ndhuy1127/ppg-ecg-blood-pressure/data/README.md

# Dữ liệu

Repository không lưu dữ liệu ECG/PPG thật. Dữ liệu raw, interim và processed
phải nằm ngoài Git, trong vùng lưu trữ đã được nhóm phê duyệt.

Tên bản ghi nghiên cứu phải liên kết qua **subject_id**, **session_id** và
**event_id**, không chứa thông tin định danh. Chỉ mẫu nhỏ đã ẩn danh được phép
đặt trong **sample/**. Xem [chính sách dữ liệu](../docs/DATA_POLICY.md).
