ndhuy1127/ppg-ecg-blood-pressure/reports/weekly/week_05/README.md

# Báo cáo tiến độ Tuần 5

> **Giai đoạn:** Tuần 5 / 28 tuần (2026-10-20 → 2026-10-24; các cập nhật tới
> 2026-10-28 ở cuối mục 3)
>
> **Thành viên:** Linh, Trương Đức Anh, Nguyễn Đức Huy

## 1. Tóm tắt công việc của tuần (mục tiêu)

Theo [kế hoạch Tuần 5](../../../docs/plans/WEEK_05.md), tuần này khắc phục G1 và
kéo các việc nằm trên đường găng của giai đoạn thu dữ liệu lên trước:

1. Đóng phần mềm G1: chạy B0/B3 trên raw PulseDB, đánh giá bằng bootstrap theo người.
2. Gỡ nút thắt phần cứng: danh sách mua module V1-module, pin map chuẩn, ERC/DRC,
   firmware khung.
3. Logger phía máy tính và mô phỏng packet đủ trường (kéo từ Tuần 8).
4. Hồ sơ đạo đức (kéo từ Tuần 6); phân bổ tay/điện cực và nghiệm pháp tạo ΔBP
   (kéo từ Tuần 10).
5. Phương pháp mốc R/foot thứ hai, định nghĩa PAT hợp lệ, so với đánh dấu tay.
6. Phác thảo ba kịch bản bài báo P A/P B/P C.

Không đo trên người trong tuần này.

## 2. Thành viên phụ trách và phân công công việc

| Thành viên | Công việc Tuần 5 |
| --- | --- |
| Linh | Logger packet V0.1 phía máy tính (decoder, kiểm tra, ghi raw, replay); mô phỏng `synthetic-packet-v3`; chuẩn bị chạy B0/B3 trên raw và phương án chọn pool PulseDB |
| Đức Anh | Danh sách mua module V1-module |
| Phần cứng và firmware | Firmware khung; pin map chuẩn theo KiCad; phân bổ điện cực; chốt các điểm mở của packet schema và review logger theo spec; trình tự bring-up; sơ đồ khối V1 |
| Huy | Trạng thái G1; hồ sơ đạo đức; protocol v0.2 (phân bổ tay, nghiệm pháp, tiêu chí pilot); mốc R/foot thứ hai, PAT hợp lệ, công cụ so với đánh dấu tay; kịch bản bài báo |

## 3. Tóm tắt công việc đã hoàn thành của từng người

### Linh

- **Codec packet V0.1** (`packet_wire.py`): CRC-16/CCITT-FALSE, đóng gói,
  `StreamDecoder` dò `SYNC` theo luồng; CRC sai hoặc header vô lý thì bỏ 1 byte và
  dò tiếp, không nhảy theo độ dài khai báo.
- **Kiểm tra packet** (`packet_receiver.py`) theo từng phiên/kênh: mất, trùng, xung
  đột, đảo thứ tự; mở rộng `SEQ`/`FIRST_SAMPLE_INDEX` qua 2³²; index liên tục đối
  chiếu `STATUS`; `T_ANCHOR_US` kiểm hai chiều với dung sai tốc độ ±3%; đổi
  `SESSION_ID` là phiên mới; `chain_id` tăng khi neo lại hoặc đổi Fs.
- **Logger** (`packet_logger.py`): `record` ghi raw bằng exclusive-create, ghi `t_rx`
  ra file riêng, decode trực tiếp rồi decode lại từ raw trên đĩa; ghi
  `session_manifest.json` sau cùng kèm hash; `replay --expect` so hash với manifest.
- **Mô phỏng `synthetic-packet-v3`**: luồng byte đúng schema (SYNC, VERSION,
  CHANNEL_ID, SESSION_ID, SEQ, FIRST_SAMPLE_INDEX, T_ANCHOR_US, FS_NOMINAL_MHZ,
  SAMPLE_COUNT ≤ 32, STATUS, DATA int32, CRC16), 13 case lỗi, packet sự kiện `0xC1`;
  v2 giữ nguyên.
- Bảng đối chiếu schema (mục 14.1) trong Packet Schema V0.1.
- Soạn hai phương án chọn pool PulseDB và các bước chạy B0/B3 khi có file raw.

### Đức Anh

- Lập danh sách mua V1-module: ESP32-S3-DevKitC-1 N16R8, MAX30001, BMI270, điện cực
  3M Red Dot 2228, điện cực khô BIOPAC, FSR 402, kèm phương án thay thế và link.

### Huy

- **Trạng thái G1** có ngày và bằng chứng (mục 5.1).
- **Hồ sơ đạo đức v0.1** (5 file): phiếu thông tin, phiếu đồng thuận, tiêu chuẩn
  chọn/loại L1–L10 và phiếu sàng lọc, an toàn buổi đo và quy tắc dừng, kế hoạch
  quản lý và giả danh hóa dữ liệu. Sửa mâu thuẫn trong khung v0.1 (nối USB với
  laptop chạy pin, không có đường nối người tham gia với điện lưới).
- **Protocol v0.2:** phân bổ tay phương án A; kiểm tra xung đột K1–K6;
  nghiệm pháp M0–M4 kèm nguồn; tiêu chí biên độ ΔBP pilot P1–P4; xác nhận module PPG
  MAX30101 (SparkFun SEN-16474).
- **Mốc thứ hai:** R bằng `derivative_energy`; foot bằng `d2_max` và `valley_min`,
  nội suy parabol dưới một mẫu có kiểm chiều cong; chọn qua `SignalConfig`, output
  mặc định `features-sqi-v1` không đổi.
- **PAT hợp lệ** (`pat_validity.py`): ghép R–foot trong khoảng R–R rồi gắn nhãn;
  giới hạn 80–400 ms, outlier MAD k = 3, sàn 10 ms, tối thiểu 3 cặp; không dùng BP;
  nhịp không hợp lệ được gắn nhãn, không xóa.
- **So với đánh dấu tay** (`fiducial_agreement.py`, `week05_fiducials.py`): các lệnh
  synth/export/plot/annotate/detect/compare, ghép một–một tối ưu, mọi lệnh ghi
  provenance, `compare` chỉ chạy với đúng config của `detect`, chặn split test, không
  tự sinh nhãn tay; mẫu CSV đánh dấu tay.
- **Kịch bản bài báo P A/P B/P C**: điều kiện kích hoạt, thông điệp chính, RQ trả lời
  được, bảng/hình chính.

### Phần cứng và firmware

- **Danh sách mua dạng Markdown** thay file Excel: đợt 1 gồm MAX30001 (breakout
  ProtoCentral), MAX30101 (SparkFun SEN-16474), BMI270 (SparkFun SEN-22397),
  ESP32-S3 DevKitC, điện cực 3M 2228; đợt 2 là linh kiện hàn cùng PCB V1; mục kiểm
  tra khi nhận hàng. Bỏ FSR 402 (V1 không dùng FSR), điện cực khô BIOPAC để đợt sau.
- **KiCad V1-module:** bỏ FSR, dùng box header có khóa ở bo cổ tay, thêm R9–R11 và C9.
- **Pin map chuẩn:** bảng A.7 trong `custom_board_proposal.md` lấy từ KiCad V1-module
  và thay các bảng chân cũ; A.6 ghi trạng thái từng mục.
- **Phân bổ điện cực:** 3 điện cực, LA cổ tay trái và RA cổ tay phải (mặt lòng), RL
  cẳng tay trái; LA → ECGP, RA → ECGN, RL → VCM qua R3; tắt lead bias nội. Cập nhật
  protocol v0.2 mục 5.2 và hồ sơ đạo đức theo cách đặt này.
- **Firmware khung** (ESP32-S3, PlatformIO + ESP-IDF 5.5.3): gửi packet V0.1 qua USB
  Serial/JTAG từ nguồn AFE giả; `SEQ` gán lúc gửi; hàng đợi MCU đầy thì packet bị bỏ
  trước khi có `SEQ` và packet kế của kênh bật bit 1 của `STATUS` (bit 1 chuyển tiếp
  nếu firmware gửi chính packet đó thất bại; từ 2026-10-23 chuyển cả bit 0); packet sự kiện `0xC1` từ nút t0; tự kiểm
  known-answer khi khởi động. Chưa có driver AFE thật, chưa chạy trên bo.
- **Test tương thích firmware–logger:** known-answer 50 byte trong header C khớp
  codec Python; encoder C biên dịch trên máy tính cho cùng byte với codec Python
  trên packet ngẫu nhiên (`test_firmware_c_encoder.py`, cần trình biên dịch C);
  luồng dựng theo quy ước firmware trong 10 phút đi qua `analyze_stream` của logger
  với đúng số lỗi chờ đợi. Các test này không chạy code ISR/task của firmware.
- **Chốt packet schema V0.1** (2026-10-23): giữ `VERSION = 0x01` và tên
  `FS_NOMINAL_MHZ`; định nghĩa lại mốc SAMP/INT2B của MAX30001 (cạnh xung đánh dấu
  lúc mẫu vào FIFO, không phải lúc lấy mẫu analog; ghi chú ADI cho MAX30003 đo trễ
  20,839 ms khi bỏ DLPF hoặc 32,558 ms khi DLPF 40 Hz ở 512 sps, chưa kiểm trên
  MAX30001); trả lời D1–D10 và xác nhận R1–R6 trong review logger.
- **Trình tự bring-up V1-module** thay file Word: kiểm khi nhận hàng, DevKitC đứng
  riêng, PCB trần, sửa module, hàn lắp, MAX30001, bo cổ tay, đo 10 phút.
- **Sơ đồ khối V1** (SVG) thay `Hardware_Diagram.png`.

### Cập nhật ngày 2026-10-24

**Dữ liệu và phần mềm**

- **Chốt pool PulseDB:** `VitalDB_Train_Subset.mat`, lấy mẫu con 400 người chỉ theo
  trường `Subject` (seed 20261024), để chia train/val/test;
  `VitalDB_CalFree_Test_Subset.mat` làm tập kiểm tra ngoài; không dùng CalBased Test
  (cùng người với Train) và hai subset AAMI (test của AAMI Cal đã bị chấm trong
  notebook Tuần 3–4). Pin `h5py==3.16.0` để đọc từng phần file `.mat` v7.3; reader
  đọc từng phần chưa viết, B0/B3 chưa chạy trên raw.
- **Quy tắc QC nhãn**, khóa trước khi đọc nhãn: chỉ loại dòng DBP ≥ SBP, ở mọi split,
  tại bước mô hình (config mới `b3-pipeline-v1`, mới có kế hoạch; `b3-pipeline-v0`
  giữ hành vi cũ).
- `features-sqi-v2` ghi `None` kèm lý do khi chưa ghép được PAT; split v2 từ chối khi
  ECG/PPG trùng giữa các split hoặc sai thứ tự kênh; bootstrap theo người gắn
  `few_subjects` khi dưới 10 người (vẫn tính CI) và API mặc định chỉ chấm val; CI cho
  hiệu ghép cặp và cho B3 − B0 trong runner.
- `motion-sqi-v0`: cờ cử động mạnh từ IMU ở cổ tay đeo PPG (định nghĩa chốt, ngưỡng
  0,15 g / 20 °/s chưa khóa; protocol v0.2).
- Gỡ hai CSV nhãn/MAE test của pool AAMI Cal khỏi Git (lấy lại được từ lịch sử Git).

**Phần cứng**

- Bỏ bản V0 nối dây, đi thẳng PCB V1-module; MCU chốt ESP32-S3-DevKitC-1-N8R8 chính
  hãng; bỏ các dòng mua chỉ dùng cho bản nối dây.
- Lấy mẫu chốt: ECG 512 sps (`EFIT = 15`, đọc FIFO tới EOF); PPG MAX30101 ba khe
  (xanh, đỏ, IR) 200 sps mỗi khe, `SMP_AVE = 1`, đọc khi FIFO có 8 mẫu và đọc hết;
  giữ VLED 5,1 V (đo ở bring-up). Độ rộng xung LED (411 hay 215 µs) còn mở.
- KiCad V1-draft4: thứ tự chân cáp mới có GND xen giữa các đường tín hiệu, header J3
  cho xung kích thích (GPIO6), bỏ TP7–TP10, không thêm điện trở kéo I²C, giữ C2/C3 ở
  bo cổ tay. ERC/DRC chỉ còn cảnh báo thư viện như trước khi sửa. Đặt gia công PCB
  ngay sau ERC/DRC.
- Bật xung `SAMP` của MAX30001 luôn và dùng làm mốc thời gian ECG (mục 5.8).

**Packet, logger và firmware**

- **Packet Schema V0.2** (`VERSION = 0x02`): IMU BMI270 sáu trục `0xA1`–`0xA6` ở
  100 Hz, phần tồn đọng (bit 7), FIFO đầy rồi neo lại (bit 5), packet thông tin thiết
  bị `0xD1`, mốc `SAMP` cho ECG (bit 8).
- **Logger** đọc V0.1 và V0.2, ghi được thẳng từ cổng serial (`--port`, pyserial 3.5),
  kiểm mốc ECG theo nguồn mốc (mục 5.8), ghi manifest theo từng phiên khi một raw có
  nhiều lần khởi động lại.
- **Firmware khung gửi V0.2:** packet `0xD1` mỗi 10 s; IMU giả có chia phần tồn đọng
  và neo lại sau FIFO đầy; mốc `SAMP` với xung giả; PPG đọc khi FIFO có 8 mẫu. MCPWM
  capture thật đã viết nhưng tắt và chưa chạy trên chip. Ngoài bản thường có ba bản
  build cố ý tạo lỗi để kiểm khi có bo: dừng đọc IMU, lỗi xung `SAMP`, đọc PPG trễ.
  Vẫn chưa có driver AFE thật và chưa chạy trên bo. (Cập nhật 2026-10-25: driver
  MAX30001, MAX30101, BMI270 và kênh nhiệt độ `0xB1` đã viết, test trên máy tính,
  chưa chạy trên chip; xem mục 7.)

### Cập nhật ngày 2026-10-25

**PulseDB và baseline G1**

- **Tải PulseDB** (Kaggle version 4, cập nhật 2022-12-08) bằng Kaggle API: Train,
  CalFree Test, AAMI Test, `LICENSE.txt`, lưu ngoài Git. Kích thước và SHA-256 ở
  [provenance](../../../docs/pulsedb_provenance.md) mục 4. CalFree chưa được dùng.
- **Reader `h5py` đọc từng phần** (`software/pulsedb/h5_reader.py`): đọc ô `Subject`
  riêng, rồi chỉ các dòng cần, từng khối tối đa 4.096 dòng, nên pool 14 GB không
  phải nằm trọn trong RAM. Máy làm việc chỉ còn khoảng 2,5 GB RAM trống. So với
  reader `mat73` trên AAMI Test (666 dòng): 0 sai khác ở cả 11 trường.
- **Split Train 400 người** (`subject_subsample` của builder): pool 465.480 dòng,
  1.293 người, mọi ID đúng dạng `p######_1`; 400 người × 360 đoạn; 320/40/40 người.
  Chạy hai lần cho cùng hash inventory/manifest; thứ tự kênh đạt; không có ECG/PPG
  trùng giữa các split.
- **`b3-pipeline-v1`**: loại dòng DBP ≥ SBP ở train/val (thực tế 0 dòng); trọng số
  train 1/n_s theo người, chuẩn về trung bình 1; v0 giữ nguyên và từ chối split có
  lấy mẫu con. Kết quả trên val ở mục 6.4: **B3 chưa tốt hơn B0**.
- **Phát hiện:** ECG/PPG của PulseDB Subset đã được chuẩn hóa min-max về [0, 1] theo
  từng đoạn, nên mất biên độ. Đặc trưng thống kê đơn giản của B3 vì thế gần như
  không mang thông tin.
- Review hai vòng; các điểm đã sửa: đọc nhãn chỉ của dòng được chọn, lời văn
  về nhãn test, script xuất Tuần 5 dùng reader mới, test bắt được lỗi trọng số và
  lỗi đọc sai dòng, file luôn được đóng.

**Chuẩn bị B4: đánh dấu tay mốc R/foot trên PulseDB**

- **Kế hoạch và ngưỡng chấp nhận chốt trước khi đánh dấu** (Huy;
  [tài liệu mốc](../../../docs/protocol/week05_fiducials_pat_validity.md)
  mục 9; config `fiducials-week05-v2`):
  - chỉ train: 40 người × 2 đoạn, chia sẵn 20 người để chọn phương pháp và 20 người
    để xác nhận một lần; người val không dùng để chọn mốc;
  - foot là điểm cực tiểu ngay trước sườn lên;
  - dung sai R ±24 ms, foot ±48 ms;
  - R: độ nhạy/PPV ≥ 99%, |bias| ≤ 4, MAE ≤ 8, SD ≤ 8 ms; foot: ≥ 98%, |bias| ≤ 8,
    MAE ≤ 16, SD ≤ 16 ms;
  - đánh dấu lặp lại 16 đoạn sau ít nhất 2 ngày.

  Lệnh `gate` mới chỉ kết luận `B4_ALLOWED` khi đạt cả ba điều kiện: chọn được
  phương pháp, xác nhận được phương pháp đó, và độ lặp lại đạt.
- **Đã xuất 80 đoạn** (`main/`) và 16 đoạn lặp lại (`repeat/`), chạy sẵn cả năm
  detector và in hình mù (mục 6.5). Bước đánh dấu tay chưa làm.
- **Cấu hình bộ lọc của PulseDB** (Supplementary Material): ECG Butterworth
  [0,5; 40] Hz, PPG Chebyshev-II [0,5; 8] Hz, chuẩn hóa [0, 1] theo từng đoạn. Vẫn
  chưa biết lọc zero-phase hay causal.
- **Phát hiện: PPG trễ so với ECG.** Khoảng R → foot kế tiếp có trung vị 572 ms,
  trong khi PAT ngón tay lúc nghỉ chỉ khoảng 180–260 ms. Một preprint dẫn lại rằng
  ECG–PPG trong VitalDB lệch khoảng 350 ms (nguồn thứ cấp). Vì vậy PAT PulseDB chỉ
  dùng được như đặc trưng tương đối, và giới hạn 80–400 ms phải xem lại trước khi
  làm B4 ([provenance](../../../docs/pulsedb_provenance.md) mục 6).

### Cập nhật ngày 2026-10-26 → 2026-10-28

**Phần mềm (commit `3111a9e`, 2026-10-26)**

- **B2** (nhân khẩu học cộng HR từ đỉnh R của ECG): định nghĩa, code và test
  SYNTHETIC; chạy theo hai bảng định trước `full` và `hr_available`
  ([định nghĩa B2](../../../docs/protocol/b2_pulsedb_definition.md)). **Chưa chạy trên
  PulseDB:** định nghĩa chưa duyệt, runner từ chối khi config còn ở trạng thái
  `PENDING_APPROVAL_NOT_RUN`.

**Firmware và logger (2026-10-25 → 2026-10-26)**

- **Lệnh PC → thiết bị** (`ping`, `set-ppg-led`) qua `device_command.py` trong lúc
  `record --commands`; packet cấu hình AFE `0xD2` và xác nhận lệnh `0xD3` (Packet
  Schema V0.2 mục 12–13); logger nâng lên `packet-logger-v2`.
- **Sự kiện mã 3:** xung kích thích ở GPIO6 (header J3) cho phép đo đồng bộ 10 phút
  ([kế hoạch đo](../../../hardware/test_reports/sync_10min_test_plan.md)).
- Các phần trên test trên máy tính, chưa chạy trên chip.
- **Ước lượng dòng** có nguồn datasheet
  ([power_budget_v1.md](../../../configs/hardware/power_budget_v1.md)): khoảng 61 mA điển
  hình, kịch bản xấu khoảng 112 mA trung bình và 206 mA trong xung LED; chưa đo.

**Phần cứng (2026-10-27 → 2026-10-28)**

- **MCU đổi sang bo Waveshare ESP32-S3-DEV-KIT-N8R8-M** (module ESP32-S3-WROOM-1-N8R8,
  một cổng USB-C qua hub CH334 và CH343, chân giống DevKitC-1); **đã đặt 2026-10-27**.
- **KiCad V1-draft5:**
  - viền U1 theo bo Waveshare (63,30 × 25,40 mm);
  - breakout MAX30001 dời 0,5 mm sang trái;
  - 3V3 hình sao, nhánh ECG từ U1.1 và nhánh cáp từ U1.2;
  - silkscreen `CHIP SIDE OUT` cho BMI270 ở mặt dưới bo cổ tay.

  ERC 0 lỗi. DRC 0 lỗi, 0 chỗ chưa nối, khớp schematic.
- **Đối chiếu toàn bộ 30 footprint** (2026-10-27):
  - 26 footprint chuẩn giống thư viện KiCad 10;
  - 4 footprint module khớp file Eagle của ProtoCentral và SparkFun và bản vẽ Waveshare, sai số 0 mm;
  - BMI270 ở mặt dưới đúng cho cách lắp mặt chip quay ra ngoài.

  Rà soát độc lập: không có lỗi phải sửa PCB.
- **Gerber và file khoan V1-draft5** xuất ngày 2026-10-27, không lưu trong repo.
  - Đã kiểm: mọi lỗ khoan khớp pad/via; lỗ mạ có đồng hai lớp; pad có lỗ mở mask.
  - Đặt ở CXT thành hai thiết kế riêng, 5 tấm mỗi mạch.
- **Lưu ý lắp ráp** ghi vào [bring-up](../../../hardware/test_reports/v1_bringup_procedure.md)
  và [danh sách mua](../../../hardware/bom/purchase_list_v1_module.md):
  - box header 90° của bo cổ tay phải có khe khóa ở vách xa mặt PCB;
  - hàn header breakout ECG từ mặt dưới;
  - cực LED D1;
  - vít, đai ốc và spacer nylon M2;
  - đo thông mạch xuyên cả hệ trước khi cấp nguồn (bring-up mục 8.1).
- So sánh hai phương án điện cực ECG chuyển từ PDF sang Markdown.

## 4. Danh mục sản phẩm đầu ra và đường dẫn

| STT | Sản phẩm | Người làm | Đường dẫn |
| --- | --- | --- | --- |
| 1 | Codec packet V0.1 | Linh | [packet_wire.py](../../../software/data_io/packet_wire.py) |
| 2 | Kiểm tra packet, metadata phiên | Linh | [packet_receiver.py](../../../software/data_io/packet_receiver.py) |
| 3 | Logger | Linh | [packet_logger.py](../../../scripts/packet_logger.py), [packet_logger.json](../../../configs/hardware/packet_logger.json) |
| 4 | Mô phỏng v3 | Linh | [packet_simulation_v3.py](../../../software/data_io/packet_simulation_v3.py), [packet_simulation_v3.json](../../../configs/hardware/packet_simulation_v3.json), [simulate_packets.py](../../../scripts/simulate_packets.py) |
| 5 | Test logger và đáp án | Linh | [test_packet_logger.py](../../../tests/test_packet_logger.py), [packet_v3_expected.json](../../../tests/fixtures/packet_v3_expected.json) |
| 6 | Hướng dẫn logger và mô phỏng | Linh | [packet_logger.md](../../../docs/protocol/packet_logger.md), [packet_simulation.md](../../../docs/protocol/packet_simulation.md) |
| 7 | Bảng đối chiếu schema (mục 14.1) | Linh | [Packet_Schema_V0.1.md](../../../configs/hardware/Packet_Schema_V0.1.md) |
| 8 | Danh sách mua (Excel) | Đức Anh | [Danh sách mua.xlsx](https://github.com/ndhuy1127/ppg-ecg-blood-pressure/blob/225832dce33c08f1d6c2468dc3b2bf1ac0afe6e1/hardware/bom/Danh%20s%C3%A1ch%20mua.xlsx) (nhánh `dev/ducanh`, commit `225832d`); bản hiện hành ở dòng 19 |
| 9 | Hồ sơ đạo đức v0.1 | Huy | [docs/ethics/](../../../docs/ethics/README.md) |
| 10 | Protocol v0.2 | Huy | [protocol_outline_v0.2.md](../../../docs/protocol/protocol_outline_v0.2.md) |
| 11 | Mốc ứng viên, `detect` | Huy | [fiducials.py](../../../software/signal_processing/fiducials.py) |
| 12 | PAT hợp lệ | Huy | [pat_validity.py](../../../software/signal_processing/pat_validity.py) |
| 13 | So với đánh dấu tay | Huy | [fiducial_agreement.py](../../../software/evaluation/fiducial_agreement.py), [week05_fiducials.py](../../../scripts/week05_fiducials.py), [mẫu CSV](../../../docs/protocol/templates/manual_fiducials_template.csv) |
| 14 | Config Tuần 5 | Huy | [week05_huy.json](../../../configs/data/week05_huy.json) |
| 15 | Tài liệu phương pháp | Huy | [week05_fiducials_pat_validity.md](../../../docs/protocol/week05_fiducials_pat_validity.md) |
| 16 | Test mốc Tuần 5 | Huy | [test_week05_fiducials.py](../../../tests/test_week05_fiducials.py) |
| 17 | Kết quả SYNTHETIC | Huy | [synthetic_fiducials/](synthetic_fiducials/agreement_synthetic.json) (thêm biến thể [refractory_040/](synthetic_fiducials/refractory_040/agreement_synthetic.json)) |
| 18 | Kịch bản bài báo | Huy | [paper_scenarios_v0.1.md](../../../docs/paper_scenarios_v0.1.md) |
| 19 | Danh sách mua V1-module | Phần cứng | [purchase_list_v1_module.md](../../../hardware/bom/purchase_list_v1_module.md) |
| 20 | KiCad V1-module (bo đế, bo cổ tay) | Phần cứng | [hardware/kicad/v1_module/](../../../hardware/kicad/v1_module/) |
| 21 | Pin map chuẩn A.7, trạng thái A.6 | Phần cứng | [custom_board_proposal.md](../../../configs/hardware/custom_board_proposal.md) |
| 22 | Phân bổ điện cực | Phần cứng | [protocol_outline_v0.2.md](../../../docs/protocol/protocol_outline_v0.2.md) mục 5.2 |
| 23 | Firmware khung V1-module | Firmware | [firmware/](../../../firmware/README.md) |
| 24 | Test firmware–logger | Firmware | [test_firmware_packet_kat.py](../../../tests/test_firmware_packet_kat.py), [test_firmware_c_encoder.py](../../../tests/test_firmware_c_encoder.py), [test_firmware_stream_compat.py](../../../tests/test_firmware_stream_compat.py) |
| 25 | Chốt packet schema V0.1, review logger | Firmware | [Packet_Schema_V0.1.md](../../../configs/hardware/Packet_Schema_V0.1.md) mục 2, 5, 6, 9, [packet_logger.md](../../../docs/protocol/packet_logger.md) |
| 26 | Trình tự bring-up V1-module | Phần cứng | [v1_bringup_procedure.md](../../../hardware/test_reports/v1_bringup_procedure.md) |
| 27 | Sơ đồ khối V1 | Phần cứng | [hardware_diagram_v1.svg](../../../configs/hardware/hardware_diagram_v1.svg) |
| 28 | Quyết định pool PulseDB, quy tắc QC nhãn (2026-10-24) | Huy | [pulsedb_provenance.md](../../../docs/pulsedb_provenance.md), [run_b3_pulsedb.md](../../../docs/protocol/run_b3_pulsedb.md) |
| 29 | `motion-sqi-v0` | Huy | [motion_sqi.py](../../../software/feature_extraction/motion_sqi.py), [protocol v0.2](../../../docs/protocol/protocol_outline_v0.2.md) mục 7.3 |
| 30 | Packet Schema V0.2 | Phần cứng và firmware | [Packet_Schema_V0.2.md](../../../configs/hardware/Packet_Schema_V0.2.md) |
| 31 | Logger và mô phỏng V0.2 | Huy | [packet_receiver.py](../../../software/data_io/packet_receiver.py), [packet_simulation_v3_v02.json](../../../configs/hardware/packet_simulation_v3_v02.json), [test_packet_v02.py](../../../tests/test_packet_v02.py) |
| 32 | Firmware V0.2 (encoder, `0xD1`, IMU giả, `SAMP`, PPG) | Firmware | [firmware/](../../../firmware/README.md) |
| 33 | Test firmware V0.2 | Firmware | [test_firmware_imu_plan.py](../../../tests/test_firmware_imu_plan.py), [test_firmware_samp_map.py](../../../tests/test_firmware_samp_map.py), [test_firmware_c_encoder.py](../../../tests/test_firmware_c_encoder.py) |
| 34 | KiCad V1-draft4 | Phần cứng | [hardware/kicad/v1_module/](../../../hardware/kicad/v1_module/), [custom_board_proposal.md](../../../configs/hardware/custom_board_proposal.md) A.2, A.3, A.7 |
| 35 | Reader `h5py` và split Train 400 người (2026-10-25) | Huy | [h5_reader.py](../../../software/pulsedb/h5_reader.py), [run_pulsedb_split.md](../../../docs/protocol/run_pulsedb_split.md), [pulsedb_train400_split.json](../../../configs/data/pulsedb_train400_split.json) |
| 36 | `b3-pipeline-v1` và kết quả B0/B3 trên val (2026-10-25) | Huy | [run_b3_pulsedb.md](../../../docs/protocol/run_b3_pulsedb.md), [b3_pulsedb_v1.json](../../../configs/models/b3_pulsedb_v1.json), [pulsedb_b3_v1/](pulsedb_b3_v1/README.md) |
| 37 | Kế hoạch đánh dấu tay, ngưỡng chấp nhận, lệnh `repeat`/`gate`, `annotate --resume` (2026-10-25) | Huy | [week05_fiducials_pat_validity.md](../../../docs/protocol/week05_fiducials_pat_validity.md) mục 9, [fiducial_gate.py](../../../software/evaluation/fiducial_gate.py), [week05_huy.json](../../../configs/data/week05_huy.json) |
| 38 | B2: định nghĩa, code, test SYNTHETIC; chưa chạy (2026-10-26) | Huy | [b2_pulsedb_definition.md](../../../docs/protocol/b2_pulsedb_definition.md), [b2_pulsedb_v0.json](../../../configs/models/b2_pulsedb_v0.json), [features_b2.py](../../../software/pulsedb/features_b2.py), [pipeline_b2.py](../../../software/pulsedb/pipeline_b2.py), [run_b2_pulsedb.py](../../../scripts/run_b2_pulsedb.py), [test_b2_pipeline.py](../../../tests/test_b2_pipeline.py) |
| 39 | Lệnh PC → thiết bị, packet `0xD2`/`0xD3`, `packet-logger-v2` | Phần cứng và firmware | [device_command.py](../../../scripts/device_command.py), [command_desk.py](../../../software/data_io/command_desk.py), [command_wire.py](../../../software/data_io/command_wire.py), [Packet_Schema_V0.2.md](../../../configs/hardware/Packet_Schema_V0.2.md) mục 12–13 |
| 40 | Sự kiện mã 3 và kế hoạch đo đồng bộ 10 phút | Firmware | [stim_plan.c](../../../firmware/app/stim_plan.c), [sync_10min_test_plan.md](../../../hardware/test_reports/sync_10min_test_plan.md) |
| 41 | Ước lượng dòng V1-module | Phần cứng | [power_budget_v1.md](../../../configs/hardware/power_budget_v1.md) |
| 42 | KiCad V1-draft5 và đối chiếu footprint với file CAD và bản vẽ của nhà sản xuất (2026-10-27) | Phần cứng | [hardware/kicad/v1_module/](../../../hardware/kicad/v1_module/), [custom_board_proposal.md](../../../configs/hardware/custom_board_proposal.md) A.2, A.3 |
| 43 | Danh sách mua và bring-up cập nhật theo bo Waveshare và lưu ý lắp ráp (2026-10-27) | Phần cứng | [purchase_list_v1_module.md](../../../hardware/bom/purchase_list_v1_module.md), [v1_bringup_procedure.md](../../../hardware/test_reports/v1_bringup_procedure.md) |
| 44 | So sánh hai phương án điện cực ECG (Markdown) | Phần cứng | [Hai_phuong_an_dien_cuc_ECG.md](../../../hardware/Hai_phuong_an_dien_cuc_ECG.md) |

## 5. Tóm tắt các nội dung chuyên môn chính

### 5.1. Trạng thái G1 (đánh giá ngày 2026-10-21, cập nhật 2026-10-28)

| Hạng mục | Trạng thái | Bằng chứng |
| --- | --- | --- |
| Pipeline tái lập (reader, inventory, provenance) | Có | `reader.py`, `split_manifest.py` (split v2), hash không phụ thuộc CRLF |
| Split theo người có test rò rỉ | Có | `pulsedb-split-v2`, `tests/test_split_manifest.py` |
| Baseline đầu tiên | Có (val) | B0/B3 `b3-pipeline-v1` trên PulseDB Train 400 người, val 40 người, CI bootstrap theo người (mục 6.4); B1 chưa chạy (không có chronology); test và CalFree chưa chấm |
| Đặc trưng/SQI/bootstrap | Có (SYNTHETIC) | `features-sqi-v1`, `subject_bootstrap.py`, mốc thứ hai Tuần 5 |
| PPG–ECG đồng bộ, báo cáo phần cứng v0 | Chưa đạt | Có KiCad V1-draft5 qua ERC/DRC, footprint đã đối chiếu với file CAD và bản vẽ của nhà sản xuất, pin map A.7, trình tự bring-up, kế hoạch đo 10 phút, firmware khung gửi Packet Schema V0.2 build được và logger đọc được. Bo Waveshare đã đặt, PCB đang đặt (2026-10-28); chưa có module trong tay, chưa chạy firmware trên bo, chưa có bản ghi trên phần cứng |
| Hồ sơ đạo đức | Bản nháp v0.1 | `docs/ethics/` |

G1 phần mềm đạt phần baseline trên val (2026-10-25); G1 phần cứng chưa đạt.

### 5.2. Logger và packet V0.1 (Linh)

- Packet little-endian dài 42 + 4N byte; CRC-16/CCITT-FALSE (known-answer
  `"123456789"` → `0x29B1`).
- Quy tắc logger R1–R5: `0xC1` bỏ kiểm index/timestamp nhưng vẫn kiểm `SEQ`/CRC; bit
  0/1/5 của `STATUS` giải thích nhảy index; kiểm `VERSION` trước CRC; `SAMPLE_COUNT = 0`
  là vô lý; dung sai timestamp 1 chu kỳ + 500 µs cộng dung sai tốc độ ±3%.
- Không nội suy, không ghép ECG–PPG theo index, không dịch kênh; offset giữa kênh
  không phải PAT.
- 13 case mô phỏng: `valid`, `missing`, `duplicate`, `reordered`, `timestamp`,
  `timestamp_first`, `offset`, `crc`, `byte_loss`, `index_jump`, `reanchor`,
  `version`, `session_restart`.

### 5.3. Phương án chọn pool PulseDB (Linh)

| | A (nối tiếp lịch sử) | B (pool lớn) |
| --- | --- | --- |
| Pool chia train/val/test | `VitalDB_AAMI_Cal_Subset.mat` (116 người) | `VitalDB_Train_Subset.mat` (1 293 người) |
| Không dùng vì trùng người | `VitalDB_AAMI_Test_Subset.mat` | `VitalDB_CalBased_Test_Subset.mat` |
| Held-out ngoài | `VitalDB_CalFree_Test_Subset.mat` (144 người) | `VitalDB_CalFree_Test_Subset.mat` |
| Số người theo split (seed 72) | 92/11/13 | — |

**Chốt 2026-10-24 (Huy): phương án B**, lấy mẫu con 400 người của Train (khoảng
320/40/40 người theo 0,8/0,1/0,1), CalFree Test làm tập kiểm tra ngoài. Lý do: test
của AAMI Cal đã bị chấm trong notebook Tuần 3–4, Train chưa bị chạm; 400 người vừa
RAM máy làm việc khi đọc từng phần ([pulsedb_provenance.md](../../../docs/pulsedb_provenance.md)).

### 5.4. Phân bổ tay và nghiệm pháp (Huy)

- **Phương án A:** PPG cổ tay trái, cuff bắp tay phải, ECG đạo trình I với điện cực
  dán Ag/AgCl ở mặt lòng hai cổ tay (LA trái, RA phải) và RL ở cẳng tay trái (cập
  nhật 2026-10-23, protocol v0.2 mục 5.2).
- Kiểm tra xung đột: K1 (cuff khác tay PPG) đạt; K2 (không làm chuyển động tay PPG)
  đạt trên giấy cho M0–M2; K3 loại nghiệm pháp bóp tay tĩnh vì đạo trình I có điện
  cực ở cả hai tay.
- **Nghiệm pháp:** M0 nghỉ; M1 thở chậm (giảm BP, Adler 2019); M2 tính nhẩm (tăng,
  Carroll 2012, Jern 1991); M3 ngâm chân nước lạnh (tăng SBP/DBP, Korhonen 2006,
  Velasco 1997); M4 đạp xe ngồi (tăng khi gắng sức, Stergiou 2023). 9/9 DOI đã đối
  chiếu metadata qua OpenAlex/Europe PMC.
- Tiêu chí biên độ ΔBP pilot P1–P4, ngưỡng 15 mmHg lấy từ kế hoạch 28 tuần.

### 5.5. Mốc thứ hai và PAT hợp lệ (Huy)

- `derivative_energy`: đạo hàm bình phương, trung bình trượt, dời về cực đại tín
  hiệu (không phải Pan–Tompkins).
- `d2_max`: cực đại đạo hàm bậc hai trước sườn lên; `valley_min`: cực tiểu trước
  peak. Nội suy parabol dưới một mẫu là tùy chọn, mặc định tắt từ 2026-10-25.
- PAT ngoài 80–400 ms vẫn được ghép rồi gắn nhãn `out_of_range`; `r_status` là
  `paired`/`no_foot`/`ambiguous`/`edge` (từ `pat-validity-v1`, 2026-10-23: R sát
  biên cửa sổ mà foot nằm ngoài khoảng PPG phát hiện được là `edge`, không tính là
  R không ghép, như `features-sqi-v1`).
- Dung sai so khớp với đánh dấu tay chốt trước khi đánh dấu: R 24 ms, foot 48 ms
  (2026-10-25; trước đó 50/100 ms), cùng các ngưỡng chấp nhận ở tài liệu mốc mục 9.

### 5.6. Kịch bản bài báo (Huy)

Ba kịch bản P A/P B/P C kích hoạt theo G4/R2/R3/R5 của kế hoạch 28 tuần; mỗi kịch
bản có thông điệp chính, RQ trả lời được, bảng/hình chính và phần bỏ.

### 5.7. Phần cứng và firmware

- Pin map A.7: ECG SPI GPIO7/15/16/17, INTB GPIO21, INT2B GPIO47; PPG I²C GPIO8/9,
  INT GPIO18; BMI270 SPI GPIO10–13, INT1 GPIO14; nút t0 GPIO4; LED GPIO5. GPIO47 chạy
  3,3 V trên module WROOM-1 N8R8/N16R8 (chip R16V chạy 1,8 V); kiểm ký hiệu module
  và eFuse VDD_SPI trước khi dùng (bring-up mục 1, 2).
- Packet đi qua cổng USB Serial/JTAG gốc của ESP32-S3; log chữ đi riêng qua UART0
  để không lẫn vào luồng byte của logger.
- Mốc SAMP/INT2B của MAX30001 là lúc mẫu vào FIFO, không phải lúc lấy mẫu analog;
  phân tích offline trừ độ trễ hiệu dụng `L_us` đo ở phép đo đồng bộ 10 phút trên PCB V1, không dùng thẳng bảng
  datasheet (Packet Schema mục 5.2, 5.3). Từ 2026-10-24 `SAMP` bật luôn và làm mốc
  ECG (mục 5.8).
- Firmware chỉ phát dữ liệu giả, nên mọi kết quả hiện có chỉ kiểm đường packet
  MCU → USB → logger, không nói gì về chất lượng tín hiệu ECG/PPG.

### 5.8. Packet Schema V0.2 và mốc `SAMP` (2026-10-24)

- **Bit 8 (chỉ ECG):** `T_ANCHOR_US` là thời điểm cạnh `SAMP` của mẫu cuối packet,
  chốt bằng MCPWM capture; bit 8 = 0 là mốc đọc FIFO như V0.1. Firmware chỉ bật bit 8
  khi mọi cạnh từ mẫu cuối packet trước tới mẫu cuối packet này đều có, cách nhau
  1 953,125 µs ± 22 µs (tạm), và cạnh cuối tới trong hai chu kỳ sau lúc đọc FIFO. Lỗi
  thì dùng mốc đọc FIFO, sau 1 s khởi động lại ánh xạ (tối đa 1 lần mỗi 10 s; chỉ số
  mẫu về 0, bit 5).
- **Logger** kiểm hai nguồn mốc riêng, không bao giờ so chéo (chúng lệch nhau một
  khoảng chưa biết): mốc `SAMP` dung sai 200 µs, tốc độ ECG ±1 000 ppm (giá trị tạm,
  chỉnh sau bring-up), để lệch một mẫu (1,953 ms) bị bắt. Phép kiểm qua từ 398 mẫu
  (khoảng 0,78 s) không còn phân biệt được lệch một mẫu nên được báo
  `anchor_check_weak`. Lệch cố định một mẫu ngay từ đầu phiên logger không bắt được;
  chỉ phép đo kích thích 10 phút bắt được.
- **Độ trễ:** `L_ECG,SAMP` (từ lúc lấy mẫu analog tới cạnh `SAMP`) khác `L_ECG` của
  mốc đọc FIFO; metadata ghi riêng, PAT trừ đúng độ trễ của nguồn mốc.
- **PPG** vẫn dùng mốc đọc FIFO ở 200 sps, nên sai số thời gian phía PPG vẫn là phần
  đóng góp chính vào sai số PAT.

## 6. Kết quả kiểm tra kỹ thuật

### 6.1. Kiểm tra toàn repo

Chạy từ Git root bằng `.venv` (Python 3.13.12):

| Lệnh | Kết quả |
| --- | --- |
| `python -m pytest -q -p no:cacheprovider` (phần Huy, 2026-10-22) | **379 passed** (gồm 50 test Tuần 5 của Huy) |
| `python -B -m pytest -q -p no:cacheprovider` (phần Linh, 2026-10-22) | **416 passed** (gồm test `test_packet_logger.py`; test v2 không đổi) |
| `python -m pytest -q -p no:cacheprovider` (toàn repo, 2026-10-23) | **471 passed** (gồm test known-answer và tương thích firmware–logger) |
| `pio run -d firmware` (2026-10-23) | Build đạt, RAM 4,5 %, flash 19,8 % của phân vùng 1 MB; chưa nạp lên bo |
| `python -m pytest -q -p no:cacheprovider` (toàn repo, Python 3.11 có trình biên dịch C, 2026-10-25) | **666 passed** (gồm test C của encoder, `imu_plan`, `samp_map`); `.venv` Python 3.13 không có trình biên dịch C: 622 passed, 44 skipped |
| `python -m pytest -q -p no:cacheprovider` (toàn repo, môi trường pin Python 3.11.7 không có trình biên dịch C, 2026-10-25 sau PulseDB v1) | **680 passed, 44 skipped** (44 test C cần trình biên dịch) |
| `pio run -d firmware -j 1`, bốn env (2026-10-24) | Build đạt, không cảnh báo; RAM 4,9 %, flash 20,4–20,5 %; build song song có lúc GCC lỗi nội bộ do thiếu RAM trống, build tuần tự thì qua |
| CI trên PR #25 (2026-10-24, commit `ede2629`) | Đạt (ruff và pytest, Python 3.11) |
| `python -m ruff check .` | Đạt |
| `python -m ruff check --select E501` trên file `.py` mới | Đạt (≤ 88 ký tự) |
| `python -m pip check` | Đạt |
| `git diff --check` | Đạt |
| `python scripts/check_environment.py` | Exit 1 do lệch pin đã biết (Python 3.13.12 so với `<3.12`, numpy/pandas/scipy khác pin) |

Mutation test: logger của Linh bắt 33/33 mutant; test mốc Tuần 5 của Huy bắt 33/33
mutant nhắm vào các phần đã sửa.

### 6.2. Logger trên 13 case SYNTHETIC (Linh)

Mỗi case: `simulate_packets.py` chạy hai lần cho cùng SHA-256 `stream.bin`;
`packet_logger.py record` cho `raw.bin` trùng hash; `replay --expect` exit 0.

| Tiêu chí | Kết quả |
| --- | --- |
| Gói hợp lệ | `valid`: 26/26 packet, 0 lỗi |
| Mất / trùng / đảo thứ tự | `missing_packets` 1 / `duplicate` 1 / `out_of_order` 1 |
| Timestamp bất thường | `timestamp_anomaly` 1, chỉ packet sai bị cách ly (kể cả anchor sai ở packet đầu) |
| Lệch kênh | `channel_offset` 1: +19 862,875 µs so với 20 000 µs chèn vào, trong giới hạn jitter |
| CRC sai, mất byte | `crc_mismatch` 1 + `skipped_bytes` 1 + `missing_packets` 1; bắt lại `SYNC` ở packet kế |
| Index nhảy, version lạ, đổi phiên | `sample_gap_status` 1, `sample_index_reanchored` 1, `unsupported_version` 1, `session_change` 1 |
| Không ghi đè raw | Test `FileExistsError`; manifest có SHA-256 raw và mọi output |
| Replay offline | 13/13 case khớp hash |

### 6.3. Mốc R/foot trên SYNTHETIC (Huy)

**Bản v1 (2026-10-25)**, sau bốn quyết định về mốc (tách refractory PPG 0,35 s, ngưỡng
năng lượng theo phân vị, không nội suy foot, đỉnh T giả lập theo nhịp tim; tài liệu
phương pháp mục 8): 6 bản ghi `SYN_*` (thêm bản ghi biên T ở R + 0,25 s),
[agreement_synthetic.json](synthetic_fiducials_v1/agreement_synthetic.json).

| Phương pháp | Kết quả v1 |
| --- | --- |
| R `derivative_energy` | 64/64 TP, 7 FP (đều ở bản ghi nhiễu) |
| R `prominence` (refractory 0,25 s) | 64/64 TP, 44 FP (bắt đỉnh T ở mọi bản ghi HR 60) |
| Foot `tangent` | 63/63; lệch +27,4 ms (do hình dạng xung) |
| Foot `d2_max` | 59/63, MAE 13,0 ms |
| Foot `valley_min` | 57/63, MAE 2,7 ms (bản ghi sạch lệch 0 chỉ vì onset rơi đúng lưới mẫu) |

**Bản v0 (2026-10-21/22, lịch sử)**, 5 bản ghi `SYN_*`, đáp án do mã sinh
([agreement_synthetic.json](synthetic_fiducials/agreement_synthetic.json)):

| Phương pháp | Kết quả |
| --- | --- |
| R `derivative_energy` (refractory 0,25 s) | 55/55 TP, 2 FP |
| R `prominence` (refractory 0,25 s) | 55/55 TP, 29 FP (bắt sóng T) |
| R ở refractory 0,4 s | `prominence` 0 FP, `derivative_energy` 1 FP |
| Foot `tangent` | 54/54; lệch +27,2 ms ở bản ghi sạch (giải tích 27,25 ms), +18,8 ms ở HR 143, +47,4 ms ở bản ghi nhiễu |
| Foot `d2_max` | 50/54 |
| Foot `valley_min` | 48/54, hỏng chủ yếu ở bản ghi nhiễu |

Sóng T SYNTHETIC đặt đúng R + 0,25 s, trùng biên refractory, nên bảng này chỉ kiểm
chứng code, không xếp hạng phương pháp. Output mặc định `features-sqi-v1` giống
từng byte với bảng fixture Tuần 4 và giống HEAD trên 240 cửa sổ × 2 config.

### 6.4. B0/B3 trên PulseDB Train 400 người, val (2026-10-25)

`b3-pipeline-v1`, đặc trưng `pulsedb-simple-stats-v0`, siêu tham số chưa tuning; val
40 người, 14.400 đoạn; MAE/bias trung bình đều theo người, CI 95% bootstrap theo
người (2.000 lượt, seed 20261013). Chi tiết và hash:
[pulsedb_b3_v1/](pulsedb_b3_v1/README.md).

| Model | Target | MAE [CI 95%] (mmHg) | Bias [CI 95%] (mmHg) |
| --- | --- | --- | --- |
| B0 | SBP | 15,11 [13,47; 16,88] | 4,30 [0,79; 7,67] |
| B0 | DBP | 10,40 [9,12; 11,80] | 2,12 [−0,92; 5,14] |
| B3 | SBP | 14,58 [12,89; 16,49] | 3,96 [0,33; 7,52] |
| B3 | DBP | 10,12 [8,94; 11,44] | 1,44 [−1,56; 4,33] |

B3 − B0 (ghép cặp): SBP −0,52 [−1,35; 0,58], DBP −0,28 [−0,86; 0,36] mmHg; cả hai
khoảng chứa 0. ECG/PPG đã chuẩn hóa [0, 1] theo đoạn, nên B3 chỉ còn `mean`, `std`,
`rms` để dùng. Đây là nhãn ABP công khai, không phải cuff hay thiết bị; test của
split và CalFree chưa chấm.

### 6.5. Bộ đoạn PulseDB để đánh dấu tay (2026-10-25)

Xuất bằng `week05_fiducials.py export` với config `fiducials-week05-v2` từ split
Train 400 người (raw SHA-256 `20f19685…d002`), môi trường pin Python 3.11.7. Thư mục
`data/processed/pulsedb_w5_review_v1/` nằm ngoài Git.

| Mục | Kết quả |
| --- | --- |
| `main/` | 80 đoạn, 40 người, mỗi người 2 đoạn, chỉ train; 20 + 20 người |
| `repeat/` | 16 đoạn, 8 mỗi nhóm, mỗi người 1 đoạn, đều có trong `main/` |
| Detector trên `main/` | Không kênh nào bị loại. Số mốc: R `prominence` 1.572, `derivative_energy` 1.005; foot `valley_min` 955, `tangent` 966, `d2_max` 968 |
| R → foot kế tiếp (`derivative_energy`, `valley_min`, chưa thẩm định) | Trung vị theo đoạn 572 ms (p10 374, p90 632); 86% số đoạn trên 400 ms |

Số R của `prominence` nhiều hơn khoảng 56% so với `derivative_energy`. Điều này hợp
với việc nó bắt cả sóng T ở refractory 0,25 s, nhưng chỉ đánh dấu tay mới cho biết
bên nào đúng. Chưa có kết quả chấm ngưỡng nào: bảng sẽ có sau khi Huy đánh dấu.

## 7. Mốc đóng Tuần 5 và việc chuyển sang Tuần 6

Đánh giá ngày 2026-10-25 theo mục "Mốc đóng tuần" của
[kế hoạch Tuần 5](../../../docs/plans/WEEK_05.md), cập nhật trạng thái ngày 2026-10-28.

| Mốc đóng tuần | Trạng thái | Người xử lý | Chuyển sang |
| --- | --- | --- | --- |
| Bảng B0/B3 trên raw có CI | Đạt trên val (mục 6.4). Test của split và CalFree chưa chấm; chỉ chấm khi model đã khóa | Huy | — |
| Module đã đặt mua | **Đạt một phần** (2026-10-28): bo Waveshare ESP32-S3-DEV-KIT-N8R8-M đã đặt 2026-10-27; MAX30001, MAX30101, BMI270 và điện cực chưa đặt ([danh sách mua](../../../hardware/bom/purchase_list_v1_module.md)) | Huy | Tuần 6 |
| A.6 đóng, một pin map chuẩn | Đạt: pin map A.7, KiCad V1-draft5 qua ERC/DRC, footprint đối chiếu với file CAD và bản vẽ của nhà sản xuất (2026-10-27). Độ rộng xung LED (411 hay 215 µs) chờ số đo bring-up | Phần cứng và firmware | Độ rộng xung: khi bring-up |
| Đặt gia công PCB V1 | **Đang đặt** (2026-10-28): Gerber V1-draft5 đã xuất và kiểm; đặt ở CXT thành hai thiết kế riêng, 5 tấm mỗi mạch; chưa có ngày giao | Huy | Tuần 6 |
| Firmware khung gửi packet tới logger | Đạt một phần: firmware V0.2 build được, logger đọc đúng luồng dựng theo quy ước firmware (mục 6.1, 6.2); thêm lệnh PC → thiết bị và sự kiện mã 3 (2026-10-26). Chưa chạy trên bo thật | Phần cứng và firmware, Linh | Khi nhận bo Waveshare |
| Hồ sơ đạo đức sẵn sàng nộp | Chưa: bản nháp v0.1 đủ năm file, còn các ô `[...]` chưa điền | Huy | Tuần 6 |
| Sơ đồ phân bổ tay được xác nhận | Đạt (2026-10-23, protocol v0.2 mục 5.2) | — | — |
| Bảng sai số mốc so với đánh dấu tay | Chưa: kế hoạch, ngưỡng và bộ 80 đoạn đã sẵn (mục 6.5); chưa đánh dấu tay | Huy | Tuần 6 (lần 1); lần 2 sau ít nhất 2 ngày |

**G1:** phần mềm đạt (baseline trên val, pipeline và split có kiểm rò rỉ); phần cứng
chưa đạt (mới đặt bo Waveshare và đang đặt PCB, chưa có bản ghi ECG–PPG đồng bộ). Đường
găng vẫn là phần cứng, nên Tuần 6 ưu tiên đặt nốt module và nhận PCB, trước mọi việc
phần mềm.

**Câu hỏi cho thầy (mang theo đầu Tuần 6):**

1. Hội đồng đạo đức nào xét, mất bao lâu; đo thử trên thành viên nhóm (G2) có cần
   phê duyệt không.
2. Có mượn được máy cuff đã kiểm định hoặc thiết bị đo huyết áp liên tục không;
   loại cuff dùng làm tham chiếu.
3. Nghiệm pháp M0–M4 có được chấp nhận không; chân ngâm nước lạnh ở M3.
4. Các ô `[...]` trong hồ sơ đạo đức (dùng lại dữ liệu cho nghiên cứu sau, chia sẻ
   dữ liệu).

**Việc phải chờ phần cứng:** chạy driver MAX30001, MAX30101 và BMI270 trên chip (đã
viết 2026-10-25 trước khi có chip, mỗi chip có bản build riêng `ecg_real`, `ppg_real`,
`imu_real`; [firmware/README.md](../../../firmware/README.md)); bring-up
theo [trình tự V1-module](../../../hardware/test_reports/v1_bringup_procedure.md); đo
đồng bộ 10 phút; chốt độ rộng xung LED; chọn cách đo dòng rò. Bo Waveshare đã đặt,
PCB đang đặt, các module còn lại chưa đặt; chưa có ngày giao nên chưa xếp được tuần cho
các việc này.

**B4 (PAT trên PulseDB):** chỉ làm khi lệnh `gate` cho `B4_ALLOWED`. Trước khi làm
còn phải quyết cách ghép R–foot và giới hạn PAT cho PulseDB, vì PPG có vẻ trễ
khoảng 300 ms so với ECG (mục "Cập nhật ngày 2026-10-25").
