ndhuy1127/ppg-ecg-blood-pressure/configs/hardware/Packet_Schema_V0.2.md

# Packet Schema V0.2 – thêm IMU và packet thông tin thiết bị

> **Duyệt 2026-10-24. Đã triển khai bước 1 (codec, receiver, logger, simulator; mục 9),
> kể cả sửa đổi cùng ngày về mốc `SAMP` cho ECG và bit 8 (mục 7). Firmware: xong bước
> 2a (encoder V0.2, `0xD1`, chuyển bit 5), 2b (IMU giả, chia phần, neo lại), 2c
> (ánh xạ `SAMP`, bit 8, với xung từ nguồn ECG giả; MCPWM capture thật chỉ mới build)
> và 2d (PPG đọc theo `PPG_RDY` và con trỏ FIFO, đọc hết FIFO); bước 3 (record/replay
> nhiều lần khởi động) có test. Còn bước 4, cần bo. Chưa kiểm chứng trên thiết bị.
> Sửa đổi 2026-10-25: kênh nhiệt độ `0xB1` (mục 11), đã triển khai ở codec,
> receiver, simulator và firmware (nguồn giả và driver MAX30101 chưa chạy trên chip).
> Sửa đổi 2026-10-25: packet cấu hình AFE `0xD2` (mục 12), lệnh từ PC và xác nhận
> `0xD3` (mục 13), đã triển khai ở codec, receiver, logger và firmware (chưa chạy trên
> chip).
> Sửa đổi 2026-10-29 (mục 13): lệnh `MARK_EVENT` cho sự kiện mã 2 và 4; trần mã LED
> `0x7F` cho cả nghiên cứu, PC cũng chặn; PC chờ `SET_PPG_LED` 2,5 s và ghi `late_ack`.
> Đã triển khai ở codec, receiver, logger, `device_command.py` và firmware (chưa chạy
> trên chip). Mục 10: quy ước offset giữa các khe PPG.**
> V0.2 là bản sửa đổi của [V0.1](Packet_Schema_V0.1.md): mọi mục của V0.1 giữ
> nguyên, trừ các thay đổi dưới đây. V0.1 vẫn là bản khóa cho dữ liệu đã ghi và
> cho firmware chưa nâng cấp.
>
> Quyết định của Huy ngày 2026-10-24: `VERSION = 0x02` cho phiên mới; thêm gia tốc
> **và** con quay của BMI270; gửi hết phần FIFO tồn đọng (bit 7); thêm packet thông
> tin thiết bị để buổi đo trên người chỉ cần một cáp USB. Thiết kế chi tiết đã qua
> hai vòng phản biện (thiết kế IMU, rồi spec đầy đủ).
>
> Datasheet BMI270: BST-BMI270-DS000 (Bosch Sensortec). Các chi tiết thanh ghi và
> thứ tự frame FIFO ghi "theo datasheet §…" phải được đối chiếu lại khi viết
> driver thật; chưa kiểm trên chip.

## 1. Version và tương thích

- Layout byte (V0.1 mục 6) **không đổi**: header 40 byte, `DATA` int32[N],
  CRC-16/CCITT-FALSE, N = 1…32.
- Firmware theo V0.2 gửi `VERSION = 0x02` trên **mọi** packet, kể cả ECG/PPG/sự
  kiện. Firmware V0.1 tiếp tục gửi `0x01`.
- Logger hỗ trợ cả hai (`wire_versions` = `[1, 2]`). Bảng mã kênh và bit `STATUS`
  hợp lệ **theo version của từng packet**:

  | VERSION | Mã kênh hợp lệ | Bit `STATUS` dự trữ (phải là 0) |
  | --- | --- | --- |
  | `0x01` | `0xE1`, `0xF1`–`0xF4`, `0xC1` | 7–15 |
  | `0x02` | như V0.1, thêm `0xA1`–`0xA6` (IMU), `0xD1` (thông tin thiết bị), `0xB1` (nhiệt độ, mục 11), `0xD2` (cấu hình AFE, mục 12), `0xD3` (xác nhận lệnh, mục 13) | 9–15 (bit 8: mốc `SAMP` của ECG, mục 7) |

- Bảng mã kênh được kiểm ở **decoder, sau CRC**: mã không có trong bảng của
  version đó thì bỏ cả packet và báo `unknown_channel` (như V0.1).
- Packet V0.1 có bit 7 bật: báo `status_reserved_bits`, giữ packet, **vẫn kiểm
  anchor**; không hiểu là phần tồn đọng.
- Một `SESSION_ID` không được trộn hai version. Nếu có: báo
  `version_mixed_in_session`, giữ mọi packet, và kiểm riêng theo
  (phiên, version, kênh), để cùng `SEQ` ở hai version không bị coi là bản trùng
  xung đột và không nối timing qua hai quy ước.

## 2. Mã kênh IMU

| `CHANNEL_ID` | Kênh | Đơn vị `DATA` |
| --- | --- | --- |
| `0xA1` / `0xA2` / `0xA3` | Gia tốc X / Y / Z | LSB có dấu, ±4 g |
| `0xA4` / `0xA5` / `0xA6` | Con quay X / Y / Z | LSB có dấu, ±500 °/s |

- Trục là **trục cảm biến** BMI270. Raw giữ nguyên trục cảm biến; phân tích dùng
  khung cổ tay qua ma trận cảm biến → cổ tay ghi trong metadata (mục 8), xác nhận
  dấu và trục bằng trọng lực khi thử trên bàn với PCB V1, không người
  (`hardware/test_reports/v1_bringup_procedure.md` mục 8 bước 5). Không tự suy dấu
  từ việc module gắn ở mặt dưới bo.
- `DATA[i]` = giá trị int16 của thanh ghi FIFO, mở rộng dấu thành int32. Receiver
  kiểm −32 768 ≤ `DATA[i]` ≤ 32 767 cho `0xA1`–`0xA6` (ECG/PPG giữ dải không dấu
  của V0.1). Không dùng −32 768 làm giá trị đánh dấu thiếu mẫu: đó là mẫu hợp lệ.
- Đổi đơn vị (danh định): gia tốc g = raw × 4 / 32 768; con quay °/s = raw × 500 /
  32 768.

## 3. Cấu hình và cách đọc BMI270

**Cấu hình V1 (chốt 2026-10-24):** gia tốc và con quay cùng ODR **100 Hz**, gia tốc
±4 g, con quay ±500 °/s, lọc chế độ thường (`acc_bwp`/`gyr_bwp` normal, chế độ hiệu
năng), FIFO lấy dữ liệu **đã lọc**, không giảm mẫu, FIFO không header, bật gia
tốc và con quay, `fifo_stop_on_full = 1`, ngưỡng watermark 10 frame. Một frame có
12 byte (con quay rồi gia tốc, theo datasheet §4.7), nên watermark = 120 byte.
Driver phải ánh xạ đúng thứ tự frame sang `0xA1`–`0xA6`. File cấu hình microcode
nạp lúc khởi động và giá trị từng thanh ghi ghi vào metadata (mục 8).

**Giá trị thanh ghi (chốt 2026-10-25, driver `firmware/drivers/bmi270.c`, datasheet
rev 1.6):** `ACC_CONF` 0xA8, `ACC_RANGE` 0x01, `GYR_CONF` 0xE8 (`gyr_filter_perf` và
`gyr_noise_perf` đều ở chế độ hiệu năng), `GYR_RANGE` 0x02, `FIFO_DOWNS` 0x88,
`FIFO_WTM` 0x0078, `FIFO_CONFIG_0` 0x01 (`fifo_time_en` = 0: không frame sensortime),
`FIFO_CONFIG_1` 0xC0, `INT1_IO_CTRL` 0x0A (push-pull, mức cao), `INT_LATCH` 0x00 (INT1
theo điều kiện watermark), `INT_MAP_DATA` 0x02, `PWR_CONF` 0x02 (advanced power save
tắt), `PWR_CTRL` 0x06 (không bật cảm biến nhiệt của BMI270). Microcode: mảng
`bmi270_config_file` của Bosch BMI270_SensorAPI v2.86.1 (commit `41129fc`, BSD-3-Clause,
SHA-256 `2d75e68e…78db`), chép nguyên vào repo. Driver kiểm sức khỏe chip mỗi 1 s
(`EVENT.por_detected`, `ERR_REG.fatal_err`, `INTERNAL_STATUS`, đọc lại cấu hình); sai
thì khởi động lại và lần đọc sau neo lại với bit 3 và 5 (bước 3). Sau một lượt đọc
frame lỗi, driver xóa FIFO (`CMD` 0xB0) trước khi đọc tiếp, giữ bit 0 nếu FIFO đầy:
frame còn lại từ trước khoảng mất không được nằm chung lượt với frame sau nó, vì
neo lại theo thời gian chỉ sửa được khoảng trống giữa hai lượt.

**Mỗi lần đọc** (sau ngắt watermark trên INT1):

1. Đọc `FIFO_LENGTH`, ghi `esp_timer` ngay lúc đó: đây là `T_ANCHOR_US` = A.
2. Tính M = số frame trọn vẹn trong độ dài đã chốt; đọc **đúng 12·M byte**. Frame đến
   sau lúc chốt nằm lại cho lần đọc sau; không đọc tới khi FIFO rỗng.
3. Đọc lỗi hoặc thiếu byte: bỏ lần đọc này, bật bit 3 trên packet kế của mỗi kênh IMU
   và neo lại chỉ số như mục 5.
4. Anchor A chỉ đại diện cho **frame mới nhất** của lần đọc, và chỉ khi FIFO chưa đầy
   (mục 5). Bit 4 bật cho tới khi đo được độ trễ hiệu dụng `L` (riêng gia tốc và con
   quay).

## 4. Phần tồn đọng (M > 32) và bit 7

Một packet chứa tối đa 32 mẫu, còn FIFO BMI270 (2 KB) chứa được khoảng 170 frame.
Khi M > 32, chia lần đọc thành các phần liên tiếp, mỗi phần tối đa 32 frame:

- Mỗi phần cho 6 packet (một packet mỗi trục), tổng 6 × ⌈M/32⌉ packet. Sáu trục dùng
  chung chỉ số mẫu; `SEQ` và bit chuyển tiếp vẫn riêng từng kênh.
- Phần bắt đầu tại frame s (s = 0, 32, 64, …): `FIRST_SAMPLE_INDEX` = chỉ số của frame
  đầu lần đọc + s, nên chỉ số liên tục giữa các phần.
- `T_ANCHOR_US` = A trên **mọi** phần.
- `T_FIRST_US` của phần bắt đầu tại s = A − round_half_up((M − 1 − s) · T), với T =
  10⁹ / `FS_NOMINAL_MHZ` µs.
- **Bit 7 (mới ở V0.2): "phần tồn đọng, anchor thuộc phần mới nhất của cùng lần
  đọc".** Mọi phần trừ phần chứa frame mới nhất bật bit 7. Bit 7 không bao giờ được
  chuyển sang packet khác.

Logger xử lý packet bit 7 như packet bit 0 của V0.1: **giữ mẫu**, kiểm chỉ số như
thường, nhưng anchor không được kiểm và không bao giờ làm mốc. Quy tắc này áp cho
**cả hai chiều** kiểm anchor, cho việc chọn mốc và cho mốc tính offset kênh (chỉ
SYNTHETIC). Bit 7 không tạo khoảng mất và không cắt chuỗi. Nếu phần mới nhất bị
mất, các phần trước **không** được thay nó làm mốc. Chuỗi không còn anchor tin cậy
nào thì ghi timing là chưa xác định.

## 5. FIFO đầy, mất mẫu không biết số lượng, bit 5

**Phát hiện đầy:** FIFO được coi là đầy khi độ dài đã chốt không còn chỗ cho thêm
một frame (độ dài + 12 byte > dung lượng hữu dụng của cấu hình). Driver BMI270
(2026-10-25) dùng ngưỡng bảo thủ hơn: còn dưới 21 byte trống (độ dài + 21 > 2 048),
vì khi dừng lúc đầy chip có thể bỏ frame mới nhất khi chỗ trống nhỏ hơn frame lớn
nhất (datasheet mục 4.7.2), mà frame lớn nhất mọi chế độ là 21 byte. Không dùng riêng
`FIFO_LENGTH == dung lượng` (chip có thể bỏ frame khi chỗ trống nhỏ hơn một frame),
và không dùng ngắt FIFO-full làm bằng chứng mất mẫu (ngắt này báo sớm).

**Khi đầy:**

- Dữ liệu còn trong FIFO vẫn hợp lệ (`stop_on_full`), khoảng mất nằm **sau** frame
  mới nhất, số mẫu mất không biết. Bật **bit 0** trên mọi packet của lần đọc này
  (cờ bảo thủ: đầy chưa chứng minh chắc chắn đã mất). Anchor của chúng không được
  kiểm (quy tắc bit 0 của V0.1).
- Lần đọc kế tiếp **neo lại chỉ số** và bật **bit 5** trên phần đầu tiên của
  **mỗi** trục:

  ```text
  q          = round_half_up((A_next − A_ref) / T)
  FIRST_next = max(last_prev + 1, I_ref + q − (M_next − 1))
  ```

  (I_ref, A_ref) là chỉ số mẫu cuối và anchor của lần đọc **tin cậy** gần nhất
  (không đầy, không lỗi), **không** phải lần đọc vừa đầy; `last_prev` là chỉ số mẫu
  cuối đã gửi; T là chu kỳ danh định. Tính bằng số nguyên có dấu 64 bit rồi mới lấy
  modulo 2³². Không có mốc tin cậy, A_next − A_ref ≤ 0, hoặc đầy liên tiếp: dùng
  `FIRST_next = last_prev + 1` và vẫn bật bit 5; số mẫu mất là không biết.

**Bit 5 ở V0.2:** chỉ nằm ở packet **đầu tiên sau** khoảng mất (packet đã neo lại),
không bao giờ ở packet trước. Firmware chuyển bit 0, 1 và 5 của packet bị bỏ ở hàng
đợi hoặc gửi thất bại (driver USB không nhận) sang packet gửi được kế tiếp của kênh.
Packet đã vào bộ đệm driver rồi mới mất thì firmware không biết, nên không chuyển.

Receiver với packet V0.2:

- Xử lý bit 5 của **chính packet đó** trước mọi kiểm chồng lấn hay liên tục: packet
  bit 5 luôn bắt đầu chuỗi mới, **kể cả khi chỉ số tình cờ liên tục**; khoảng trống
  ghi `lost_samples = null`.
- Bit 5 của packet trước không giải thích bước nhảy ở packet sau.
- Nhiều lần neo lại bị gộp do mất packet thì chỉ thấy một ranh giới; số lần neo lại
  không đếm được.

Packet V0.1 giữ nguyên quy tắc R2/R6 (bit ở trước hoặc sau chỗ nhảy; chỉ cắt chuỗi
khi chỉ số nhảy).

## 6. Packet thông tin thiết bị `0xD1`

Mục đích: định danh firmware (ELF SHA-256, phiên bản) nằm **trong** luồng raw, nên
khi đo trên người chỉ nối cổng USB native.

| Trường | Giá trị |
| --- | --- |
| `CHANNEL_ID` | `0xD1` |
| `SEQ` | Đếm riêng cho `0xD1`, từ 0 mỗi phiên |
| `FIRST_SAMPLE_INDEX` | Số thứ tự packet thông tin trong phiên (0, 1, …) |
| `T_ANCHOR_US` = `T_FIRST_US` | `esp_timer` lúc task tạo packet (chỉ tham khảo) |
| `FS_NOMINAL_MHZ` | 0 |
| `SAMPLE_COUNT` | 25 (packet 142 byte) |
| `STATUS` | 0; cho phép bit 1 (hàng đợi MCU bỏ một packet thông tin) |

| `DATA` | Nội dung |
| --- | --- |
| `[0]` | Phiên bản layout của payload = 1 |
| `[1]` … `[8]` | ELF SHA-256 (32 byte). Word k = byte 4k … 4k+3 của hash ghép theo thứ tự big-endian, lưu đúng mẫu bit trong int32 (word ≥ 2³¹ thành số âm); receiver lấy `word & 0xFFFFFFFF` |
| `[9]` … `[16]` | Chuỗi phiên bản ứng dụng (`esp_app_desc_t.version`), 32 byte ASCII, kết thúc và đệm bằng NUL, 4 byte mỗi word ghép big-endian |
| `[17]` … `[24]` | Chuỗi phiên bản ESP-IDF (`esp_app_desc_t.idf_ver`), cùng cách đóng gói |

"Big-endian" ở đây chỉ là cách ghép 4 byte thành một word; byte trên dây vẫn
little-endian như V0.1 mục 6. `SESSION_ID` đã có trong header, không lặp trong
payload.

**Nhịp gửi:** một lần ngay sau khi driver USB khởi động, sau đó mỗi 10 s, nên logger
bắt đầu giữa phiên vẫn nhận được trong vòng 10 s.

**Logger:**

- Kiểm `SAMPLE_COUNT = 25`, `DATA[0] = 1`, `FS_NOMINAL_MHZ = 0`,
  `T_FIRST_US = T_ANCHOR_US`, chuỗi đúng ASCII và đúng quy tắc NUL. Sai thì báo
  `device_info_invalid`; packet sai không được tính là "đã có thông tin thiết bị".
- Ghi vào phiên: `device_info` (ELF SHA-256 dạng hex, phiên bản ứng dụng, phiên bản
  ESP-IDF, số packet hợp lệ).
- Báo `device_info_changed` khi nội dung định danh (hash và hai chuỗi) khác nhau
  trong cùng phiên; so nội dung, không so `SEQ`, số thứ tự hay timestamp.
- Báo `device_info_missing` khi một phiên V0.2 có `source_type = DEVICE` mà không
  có packet `0xD1` hợp lệ nào. Kiểm này độc lập với metadata.
- Báo `firmware_metadata_mismatch` khi `firmware_version` trong metadata khác null
  và khác phiên bản ứng dụng. `firmware_version` trong metadata chỉ chứa phiên bản
  ứng dụng, không ghép thêm hash.
- Kiểm số thứ tự so với `SEQ` như packet sự kiện (R1). Không kiểm anchor, không đưa
  vào `samples.csv`, không thuộc kiểm `channel_missing`.

## 7. Mốc xung `SAMP` cho ECG, bit 8 (sửa đổi 2026-10-24)

Quyết định của Huy ngày 2026-10-24: bật xung `SAMP` của MAX30001 **luôn** và dùng làm
mốc thời gian ECG; chốt thời điểm cạnh bằng MCPWM capture của ESP32-S3; sửa V0.2 (chưa
có firmware V0.2 chạy, chưa có dữ liệu V0.2) thay vì nâng version; không thêm kênh
ghi mọi cạnh xung. PPG đọc theo mục 7.6. Thiết kế đã qua một vòng phản biện;
mọi chi tiết thanh ghi phải đối chiếu lại datasheet MAX30001 khi viết driver và kiểm
trên chip thật ở bring-up.

### 7.1. Cấu hình MAX30001 và chốt cạnh

- `EN_INT2` chỉ đưa `SAMP` ra INT2B; `SAMP_IT = 00` (một xung mỗi mẫu, 512 Hz);
  `CLR_SAMP = 1` (xung tự xóa sau khoảng 1/4 chu kỳ mẫu, cỡ 488 µs ở 512 sps).
  INT2B ra CMOS (`INTB_TYPE = 01` ở `EN_INT2`), qua TXB0108 tới GPIO47; tắt điện trở
  kéo của MCU trên GPIO47. Cực tính, độ rộng và rung của xung đo trước và sau
  TXB0108 ở bring-up.
- ESP32-S3 dùng **MCPWM capture**: cạnh của GPIO47 (cực tính theo số đo) chốt giá trị
  bộ đếm capture **riêng** của MCPWM bằng phần cứng (không phải `esp_timer`), không
  phụ thuộc độ trễ ngắt. Bật `CONFIG_MCPWM_ISR_CACHE_SAFE`; hàm callback cùng mọi mã
  và dữ liệu nó dùng nằm ở bộ nhớ trong (IRAM/DRAM), không chỉ riêng hàm callback.
  Callback chỉ đọc giá trị đã chốt, gán số thứ tự xung `e` và ghi vào bộ đệm vòng, mỗi
  mục có đánh dấu thế hệ để đọc nhất quán.
- Quy đổi bộ đếm capture sang `esp_timer` (µs): định kỳ đọc cặp hai đồng hồ theo kiểu
  kẹp (đọc `esp_timer`, chốt bộ đếm capture, đọc lại `esp_timer`; chỉ nhận cặp có hai
  lần đọc `esp_timer` cách nhau dưới 2 µs), xử lý tràn bộ đếm. Sai số quy đổi phải
  nằm trong ngân sách (mục tiêu dưới 5 µs) và ghi vào metadata; không đổi clock (tiết
  kiệm năng lượng) trong phiên.
  **Mô hình quy đổi (sửa 2026-10-24 khi viết `firmware/drivers/samp_capture.c`,
  chưa chạy trên chip; trước đó ghi "nội suy tuyến tính giữa các cặp"):** bộ đếm
  capture (APB 80 MHz) và `esp_timer` cùng lấy từ một thạch anh, nên tỉ lệ giữa hai
  đồng hồ là danh định và cố định. Giá trị capture được quy đổi theo tỉ lệ đó từ cặp
  kẹp gần nhất; cặp chỉ dùng để neo độ lệch. Không ước lượng độ dốc từ hai cặp: mốc
  cần ngay lúc gửi packet nên luôn là ngoại suy, và độ dốc ước lượng từ hai cặp cách
  100 ms với sai số đọc cỡ 1 µs chỉ thêm sai số. Cặp đọc kẹp bằng kênh capture thứ
  hai không nối GPIO, chốt bằng phần mềm, mỗi 100 ms; cặp cũ hơn 1 s thì không quy
  đổi (cạnh coi như thiếu, ánh xạ sang `LỖI`), xa trong giới hạn ±26,8 s của hiệu tick
  có dấu. Độ lệch giữa dự đoán theo cặp cũ và cặp mới được in ra UART0 làm sai số quy
  đổi; nếu ở bring-up sai số này vượt ngân sách (hai đồng hồ không cùng tỉ lệ như giả
  định) thì phải đổi sang mô hình có độ dốc.
- Giá trị chốt vẫn có thể bị ghi đè nếu hàm ngắt trễ hơn một chu kỳ xung (1,953 ms):
  phát hiện qua khoảng cách giữa hai giá trị chốt liên tiếp (gần 1 chu kỳ hay gần
  bội số).
- Bộ đệm vòng 64 mục (125 ms), dài hơn khoảng trống còn lại của FIFO ECG sau ngưỡng
  `EFIT` (16 mẫu, khoảng 31 ms).

### 7.2. Ánh xạ xung ↔ mẫu

- Mẫu ECG có chỉ số `k` (cùng gốc với `FIRST_SAMPLE_INDEX`, tính từ mỗi lần khởi động
  thu); xung có số `e`. Ánh xạ là `e = k + c`, hằng `c` xác định lúc khởi động thu.
- Trạng thái: `CHƯA_KHỚP` → `ĐÃ_KHỚP` → `LỖI` → khởi động lại ánh xạ. Khởi động
  ánh xạ: dừng thu, xóa ngắt đang chờ, bật capture, rồi khởi động chuyển đổi bằng
  lệnh `SYNCH` (`FIFO_RST` không thay được, vì nó không khởi động lại mạch chuyển
  đổi). Xung đầu tiên sau đó ứng với mẫu đầu tiên của FIFO; quan hệ này **phải được
  kiểm trên MAX30001 thật** ở bring-up trước khi tin bit 8: lệch cố định một mẫu
  (1,953 ms) không phép kiểm số lượng nào phát hiện được.
- Đếm mẫu theo word FIFO: ETAG `000` (hợp lệ), `010` (hợp lệ, EOF), `001` và `011`
  (fast recovery; `011` là EOF) đều là một bước thời gian; điện áp của `001`/`011`
  không dùng cho phát hiện mốc. Dừng đọc sau word `010` hoặc `011`. `110` (rỗng) và
  `111` (tràn) không phải mẫu.
- FIFO tràn (`111`), ECG khởi động lại, phát hiện xung mất, thừa hoặc giá trị chốt
  bị ghi đè: chuyển `LỖI`. Từ đó mọi packet dùng mốc đọc FIFO cho tới khi khởi động
  lại ánh xạ; packet sạch đầu tiên sau khi neo lại mang bit 5 như quy tắc hiện hành.
- **Khi nào khởi động lại ánh xạ (chốt 2026-10-24):** sau 1 s ở `LỖI` (khoảng 32
  packet dùng mốc đọc FIFO), và tối đa một lần mỗi 10 s (lần khởi động lúc bật máy
  không tính), để đường xung lỗi liên tục không gây khởi động lại liên tục. Mỗi lần
  khởi động lại mất một đoạn ECG (thời gian dừng, `SYNCH` và độ trễ bộ lọc số của
  MAX30001, đo ở bring-up) và chỉ số mẫu bắt đầu lại từ 0 (bit 5, chuỗi mới).

### 7.3. Gán mốc cho từng packet ECG

1. Khi `EINT` báo, đọc burst tới word EOF và **ghi ngay** thời điểm nhận xong EOF
   (mốc đọc FIFO, V0.1 mục 5.2). Giới hạn sai số của mốc này chỉ đúng khi đọc thật
   tới EOF, không đúng với burst cố định 16 word khi FIFO còn tồn.
2. Ở `ĐÃ_KHỚP`: mẫu cuối của packet là `k_last = FIRST_SAMPLE_INDEX + N − 1`. Chờ có
   giới hạn (tối đa 2 chu kỳ mẫu) đúng xung `e = k_last + c`, vì dữ liệu FIFO có thể
   đọc được trước khi xung của chính mẫu đó tới; **không** thay bằng xung mới nhất.
3. Có đúng xung đó, thế hệ hợp lệ, và kiểm danh tính đạt: `T_ANCHOR_US` = thời điểm
   xung, bật bit 8. Ngược lại: `T_ANCHOR_US` = mốc đọc FIFO, không bật bit 8, chuyển
   `LỖI`.
4. Kiểm danh tính, làm **trước** khi bật bit 8:
   - Khởi động ánh xạ (mỗi lần `SYNCH`): mở một kỷ nguyên ánh xạ mới, xóa bộ đệm vòng,
     đặt `e = 0` cho xung đầu tiên sau `SYNCH` và `c = 0`, tức xung `e` ứng với mẫu
     `k = e` của lần thu này (chỉ số bắt đầu từ 0).
   - Mọi khoảng cách giữa hai cạnh liên tiếp đã chốt, từ xung của mẫu cuối packet
     trước (hoặc từ xung 0 với packet đầu tiên của kỷ nguyên) tới xung `e = k_last`,
     phải nằm trong `1 953,125 µs` cộng trừ dung sai (tạm ±20 µs cộng sai số tốc độ
     ECG). Khoảng quá ngắn (xung giả) hoặc gần bội số (xung mất, giá trị bị ghi đè)
     đều chuyển `LỖI`.
   - Số cạnh trong đoạn đó phải đúng bằng `N`. Một xung mất cộng một xung thừa vẫn giữ
     đúng số lượng nhưng tạo hai khoảng bất thường, nên bị bắt ở bước trên.
   - Packet đầu tiên của kỷ nguyên chỉ được bật bit 8 khi các xung `0 … N − 1` đều có
     và qua kiểm khoảng cách.
5. `T_FIRST_US` giữ định nghĩa V0.1 (`T_ANCHOR_US − (N − 1) · 10⁶ / fs`).

### 7.4. Bit 8 của `STATUS`

- Bit 8 = 1: `T_ANCHOR_US` là thời điểm cạnh `SAMP` của **mẫu cuối của chính packet
  này**, chốt bằng MCPWM capture. Bit 8 = 0: mốc đọc FIFO như V0.1.
- Chỉ dùng cho kênh ECG `0xE1` của `VERSION = 0x02`; bit 8 trên kênh khác báo
  `status_reserved_bits`.
- Không chuyển tiếp bit 8 từ packet bị mất (khác bit 0/1). Đổi nguồn mốc giữa hai
  packet không phải neo lại và **không** bật bit 5.
- Bit dự trữ của `VERSION = 0x02`: 9–15 (mask `0xFE00`).
- Codec, logger, firmware, simulator và fixture V0.2 phải cập nhật cùng một đợt;
  logger cũ chỉ báo `status_reserved_bits` cho bit 8 và vẫn giữ packet, nên sẽ hiểu
  sai mốc nếu dùng với dữ liệu mới.

### 7.5. Logger và phân tích

- Kiểm anchor ECG **theo nguồn mốc**: packet bit 8 dùng dung sai riêng, nhỏ hơn hẳn
  một chu kỳ ECG (tạm 200 µs; chỉnh sau bring-up), để lệch một mẫu (1,953 ms) bị bắt.
  Dung sai tốc độ của ECG đặt riêng (dao động 32,768 kHz; tạm ±1 000 ppm), không dùng
  chung ±3 % tạm của PPG. Hai giá trị tạm ghi `NOT_HARDWARE_VALIDATED` trong config.
- Mọi kiểm tra và hồi quy ECG chia theo phiên, chuỗi liên tục (ranh giới bit 5) **và**
  nguồn mốc; loại anchor của packet bit 0/bit 7 như cũ. Không so trực tiếp mốc
  `SAMP` với mốc đọc FIFO qua chỗ đổi nguồn: hai nguồn lệch nhau một khoảng (thời
  gian mẫu nằm trong FIFO cộng độ trễ đọc) phải ước lượng riêng trước khi so.
- Dung sai tốc độ nhân theo độ dài khoảng trống giữa hai packet: với ±1 000 ppm và
  200 µs, tính cả sai số anchor tới 200 µs, phép kiểm qua từ 398 mẫu trở lên (khoảng
  0,78 s) không còn phân biệt được lệch một mẫu ECG; logger báo riêng các phép kiểm
  như vậy (`anchor_check_weak`) thay vì coi là đã kiểm.
- Báo số packet bit 8, số packet dùng mốc đọc FIFO và vị trí đổi nguồn.
- Quy ước: `t′` là thời điểm mẫu **chưa trừ độ trễ** (V0.1 mục 5.3 với `δ = d_pipe = 0`);
  chỉ trừ độ trễ đúng một lần, theo nguồn mốc của packet chứa mẫu đó. Nếu thời điểm
  đã được trừ độ trễ ở bước trước thì tính PAT trực tiếp, không trừ lần nữa.
- Với packet bit 8: `t_last = T_ANCHOR_US − L_ECG,SAMP`. `L_ECG,SAMP` là độ trễ từ lúc
  lấy mẫu analog tới cạnh đã chốt (bộ lọc số và ADC, TXB0108, độ lệch chốt); **không**
  gồm thời gian mẫu nằm trong FIFO. Không trừ đồng thời `L` của mốc đọc FIFO. Giá trị
  ADI đo trên MAX30003 (512 sps: 20,839 / 32,558 ms) chỉ để đối chiếu.
- Đo `L_ECG,SAMP` bằng kích thích chung trong phép đo đồng bộ 10 phút, quét pha kích
  thích qua một chu kỳ mẫu. Phép đo này cũng là kiểm tra độc lập cho lệch pha cố
  định của ánh xạ (mục 7.2).
- `PAT = (t′_foot − L_PPG) − (t′_R − L_ECG,nguồn)`. PPG vẫn dùng mốc đọc FIFO (mục 7.6)
  và lấy mẫu 200 sps (5 ms), nên sai số phía PPG vẫn là phần đóng góp chính.

### 7.6. Đọc FIFO PPG (sửa cách làm của quyết định 2026-10-24)

- `PPG_RDY` giữ chân INT ở mức thấp tới khi đọc `Interrupt Status 1` (0x00) hoặc
  `FIFO_DATA`; mẫu mới đến khi cờ chưa xóa thì không tạo cạnh mới. Firmware đọc 0x00
  sau **mỗi** ngắt để xóa cờ, rồi đọc con trỏ FIFO để biết số mẫu đang chờ; khi có 8
  mẫu thì chốt con trỏ và đọc **hết** số mẫu có trong FIFO lúc chốt (thường 8; nhiều
  hơn nếu xử lý trễ), không cố định 8: đọc 8 khi FIFO có 9 làm mốc lệch khoảng 5 ms.
  `N` của packet PPG là số mẫu đọc được (tối đa 32). Ngắt chỉ để đánh thức, không
  đếm ngắt để quyết định lúc đọc (sửa 2026-10-24 khi review bước 2d): ngắt bị nuốt,
  hoặc ngắt của mẫu đến trong lúc đọc trễ còn tồn lại, sẽ làm số đếm lệch mãi so với
  FIFO (ví dụ sau một lần trễ 12 ms, mọi packet sau chỉ còn 6 mẫu).
- Datasheet chỉ mô tả `PPG_RDY` cho chế độ SpO2 và HR. Ở chế độ ba khe phải kiểm khi
  bring-up; không chạy thì đọc theo timer định kỳ (ví dụ 40 ms), vẫn đọc hết FIFO, và
  mốc có thể lệch tới một chu kỳ PPG (5 ms), dựa vào hồi quy offline.
- **FIFO MAX30101 đầy (sửa quy tắc V0.1 mục 9, 2026-10-25):** driver thật không dùng
  `OVF_COUNTER` để nhảy chỉ số. Lần đọc đầy bật bit 0; lần đọc kế tiếp neo lại theo
  thời gian và bật bit 5 như IMU (mục 5). Lý do: `OVF_COUNTER` chỉ đếm mẫu mất tới lúc
  chốt con trỏ; mẫu mất giữa lúc chốt và lúc lấy mẫu đầu tiên ra (lúc đó bộ đếm bị
  xóa) không được đếm, nên nhảy "chính xác" có thể lệch một mẫu mà không ai biết.
  Nguồn PPG giả vẫn nhảy chỉ số đúng số mẫu mất với bit 0 (nó biết đáp án); receiver
  chấp nhận cả hai cách.

### 7.7. Theo dõi và thử

- Firmware in ra UART0 (log chữ, không vào packet) các bộ đếm: xung mất, xung thừa,
  giá trị chốt bị ghi đè, số lần chuyển `LỖI`, số packet có và không có bit 8. Không
  thêm kênh ghi mọi cạnh xung (quyết định 2026-10-24); chỉ thêm nếu khi thử PCB các
  bộ đếm hoặc logger báo bất thường.
- Simulator và test: SAMP hợp lệ, mất xung, thừa xung, ghi đè, chuyển về mốc đọc FIFO,
  khởi động lại ánh xạ, và lệch một mẫu phát sinh giữa phiên (logger phải bắt bằng
  dung sai mới). Lệch cố định một mẫu ngay từ đầu phiên thì logger không thể bắt
  (mục 7.2); chỉ phép đo kích thích (mục 7.5) bắt được.

## 8. Metadata phiên và manifest

- Metadata phiên (`packet-session-metadata-v0`) nhận thêm khóa kênh `0xA1`–`0xA6` và
  `0xD1`. Khai báo đủ sáu trục IMU để `channel_missing` có tác dụng.
- Kênh IMU: `sensor` `"BMI270"`, `fs_nominal_mhz` 100 000, `latency_l_us` và
  `latency_source` null kèm lý do, `unit_conversion` theo mục 2. `afe_config` ghi:
  ODR, dải, bộ lọc và chế độ hiệu năng của gia tốc và con quay; nguồn dữ liệu FIFO
  (đã lọc), giảm mẫu, header, `stop_on_full`, watermark; chế độ nguồn; bù offset;
  hash và phiên bản microcode; vị trí lắp và ma trận cảm biến → cổ tay (hoặc null
  kèm lý do).
- Kênh ECG `0xE1` (mục 7): `afe_config` ghi thêm `EN_INT2`, `SAMP_IT`, `CLR_SAMP`,
  cách chốt cạnh (MCPWM capture) và chân; độ trễ hiệu dụng ghi **theo nguồn mốc**:
  `latency_l_us` cho mốc đọc FIFO và một khóa mới cho mốc `SAMP` (ví dụ
  `latency_samp_l_us`, kèm nguồn), nên validator metadata phải cập nhật cùng đợt.
- Manifest và `decode.json` ghi version schema **theo từng phiên** (`packet-v0.1`
  hoặc `packet-v0.2`), không ghi cứng `packet-v0.1`, và chép `device_info` theo từng
  `SESSION_ID` khi một raw có nhiều lần khởi động lại. Bản sao metadata đầu vào giữ
  nguyên, không ghi đè.
- Phần đọc V0.2 được thêm vào `packet-logger-v1` ngày 2026-10-24, không nâng version
  (chưa phát hành bản nào khác); từ 2026-10-25 logger là `packet-logger-v2`, từ
  2026-10-29 là `packet-logger-v3` với metadata phiên `packet-session-metadata-v1`
  (thêm `subject_id`, `session_id`, `ppg_led_lock`, `cuff_log`; các khóa kênh giữ như
  v0) (`docs/protocol/packet_logger.md`).
- Kênh nhiệt độ `0xB1` (mục 11.2): khóa metadata `0xB1`, `latency_l_us` và
  `latency_source` null kèm lý do.

## 9. Kế hoạch triển khai và test

Mỗi bước là một commit riêng, có test, và qua review diff trước khi sang bước
sau.

1. **Codec, receiver, simulator:**
   - bảng mã kênh và bit dự trữ theo version; dữ liệu IMU có dấu;
   - bit 5 và bit 7 của V0.2; thông tin thiết bị; version theo phiên; trộn version.
   - Simulator v3 sinh V0.2 khi config có `wire_version: 2`; config mặc định vẫn là
     V0.1, nên fixture hiện tại không đổi. Trong config V0.1, ca `version` đổi
     `unsupported_version` từ 2 sang 3 (2 giờ hợp lệ).
   - Thêm config và fixture V0.2 với các ca: IMU hợp lệ, tồn đọng 32/33/64/65 frame,
     mất phần cuối, FIFO đầy rồi neo lại, mất packet bit 5, trộn version, thông tin
     thiết bị thiếu, sai hoặc đổi.
   - **Sửa đổi mục 7 (làm 2026-10-24):** mask dự trữ V0.2 `0xFE00` và tên bit 8
     (`anchor_samp`); bit 8 chỉ hợp lệ trên `0xE1`; kiểm anchor ECG riêng theo nguồn
     mốc trong mỗi chuỗi (`samp_anchor_tolerance_us` 200, tốc độ ECG
     `ecg_anchor_rate_tolerance_ppm` 1 000), báo `anchor_check_weak`, đếm packet và
     chỗ đổi nguồn (`anchor_sources`), báo `samp_resumed_without_reanchor` khi mốc
     `SAMP` trở lại mà không neo lại; metadata `latency_samp_l_us` và
     `latency_samp_source` cho `0xE1` (thiếu khi luồng có bit 8:
     `samp_latency_metadata_missing`). Simulator: ECG V0.2 mặc định mang bit 8 (config
     `samp`), ca `samp_remap` (mất ánh xạ rồi khởi động lại) và `samp_shift` (lệch
     một mẫu giữa phiên). Mất xung, thừa xung, ghi đè được firmware phát hiện nên
     với logger giống `samp_remap`; phần phát hiện trong firmware thử ở bước 2.
     Logger không hồi quy tốc độ; hồi quy offline tách theo nguồn theo mục 7.5.
2. **Firmware** (chia thành 2a–2d, mỗi phần một commit):
   - **2a (làm 2026-10-24):** `PKT_VERSION = 0x02` (encoder đổi tên thành
     `packet_wire.c`); known-answer V0.2 mới cho tự kiểm lúc khởi động (packet ECG có
     bit 8 và packet `0xD1`; known-answer V0.1 giữ trong fixture làm bản cũ); task
     thông tin thiết bị; chuyển bit 5; test C trên máy tính cho VERSION 2, cực trị
     IMU và word hash có bit 31.
   - **2b (làm 2026-10-24):** nguồn IMU giả 6 khe có dấu, có chế độ cố ý dừng đọc để
     tạo tồn đọng và FIFO đầy (env `esp32s3_devkitc_imu_stall`; thuật toán mục 5 chạy
     thật trong `imu_plan.c`, số mất thật chỉ in UART0 làm đáp án); chia phần trước
     khi ghi `p.data[]` (không nâng `PKT_MAX_SAMPLES` quá 32).
   - **2c (làm 2026-10-24, mục 7):** trạng thái ánh xạ và kiểm danh tính trong
     `samp_map.c` (C thuần, test trên máy tính), bộ đệm vòng 64 cạnh có đánh dấu số
     cạnh, chờ đúng xung của mẫu cuối, bit 8, khởi động lại theo chính sách mục 7.2,
     bộ đếm in UART0; nguồn ECG giả phát xung (env `esp32s3_devkitc_samp_faults` cố ý
     bỏ và thêm xung). MCPWM capture thật và cặp đọc kẹp viết sẵn trong
     `samp_capture.c` (bật bằng `BOARD_SAMP_CAPTURE=1`), mới build, chưa chạy.
   - **2d (làm 2026-10-24, mục 7.6):** PPG xóa ngắt mỗi mẫu và đọc hết FIFO (nguồn
     giả báo ngắt mỗi mẫu; env `esp32s3_devkitc_ppg_delay` trễ 12 ms mỗi 10 s để `N`
     lớn hơn 8); lúc đọc do số mẫu trong FIFO quyết định, ngắt chỉ để đánh thức; chế
     độ đọc theo timer `BOARD_PPG_READ_PERIOD_MS` dành cho trường hợp `PPG_RDY` không
     chạy. Việc đọc 0x00 để nhả chân INT do driver MAX30101 thật làm
     (`max30101_latch`, 2026-10-25, chưa chạy trên chip).
3. **Tích hợp record/replay (làm 2026-10-24):** manifest theo phiên và `device_info`,
   nhiều lần khởi động lại, hash output xác định. Code đã có từ bước 1; bước này thêm
   test: một raw ba lần khởi động (chữ ROM giữa các phiên, packet cuối bị reset cắt,
   firmware nạp lại ở lần thứ ba) qua record và replay, manifest đúng `device_info`
   từng phiên; và output `decode.json`, `packets.csv`, `samples.csv` giống từng byte
   khi đọc nguồn theo khối 1 byte, khối lẫn lộn hay 4 096 byte.
4. **Sau khi có bo** (driver MAX30001, MAX30101 và BMI270 đã viết 2026-10-25, chưa
   chạy trên chip): chạy driver BMI270 (nạp microcode, cấu hình mục 3), đo `L` (chưa
   có bước đo, mục 10) và kiểm dấu trục (bring-up mục 8 bước 5). Driver
   MAX30001/MAX30101: kiểm xung `SAMP` đầu tiên ứng với mẫu đầu tiên của FIFO, cực
   tính và độ rộng xung, `PPG_RDY` ở chế độ ba khe; đo `L_ECG,SAMP` với kích thích
   quét pha (mục 7.5).

## 10. Việc còn mở

- `L` của gia tốc và con quay (đo khi thử trên bàn với PCB V1, không người; bring-up
  và kế hoạch đo 10 phút chưa có bước đo này); có cần sensortime để ánh xạ clock
  BMI270 hay không (chưa bắt buộc ở V1 nếu đo được ngân sách sai số timing).
- Ma trận cảm biến → cổ tay và quy ước khung cổ tay (đề xuất: +X hướng ngón tay, +Z
  ra mặt lưng bàn tay, +Y theo quy tắc tay phải); dấu trục kiểm bằng trọng lực ở
  `hardware/test_reports/v1_bringup_procedure.md` mục 8 bước 5.
- Mục 7: dung sai anchor `SAMP` (tạm 200 µs) và dung sai tốc độ ECG (tạm ±1 000 ppm)
  chỉnh theo số đo; chi tiết thanh ghi `EN_INT2`/`CLR_SAMP` đối chiếu datasheet
  MAX30001; nếu `PPG_RDY` không chạy ở chế độ ba khe thì chuyển sang đọc theo timer.
  Phía firmware: dung sai một khoảng cạnh tạm 22 µs (20 µs cộng 1 000 ppm của một chu
  kỳ); MCPWM capture thật (`samp_capture.c`) chưa chạy trên chip: kiểm cực tính,
  độ rộng xung (bring-up mục 7 bước 4), thử nối vòng GPIO trên bo Waveshare đứng
  riêng (bring-up mục 2 chưa có bước này), đo sai số quy đổi và tỉ lệ cặp kẹp bị loại
  (đọc `esp_timer` hai lần cách nhau 2 µs trở lên).
- Kiểm tải: PPG đọc khi có 8 mẫu, N = 8 (chốt 2026-10-24, mục 7.6; firmware
  `PPG_BATCH`). Với ECG 512 sps (N = 16), PPG ba khe 200 sps (N = 8) và IMU sáu trục
  100 Hz (N = 10): khoảng 167 packet/s, 13,9 kB/s; hàng đợi MCU 64 packet chịu khoảng
  0,38 s khi USB không nhận. Còn phải thử tải: burst, host ngừng đọc và timeout 20 ms.
- **Offset thời gian giữa ba khe PPG: quy ước đã chốt 2026-10-29**
  ([V0.1](Packet_Schema_V0.1.md) mục 7), không còn mở:
  - raw giữ nguyên, ba khe chung `FIRST_SAMPLE_INDEX` và `T_ANCHOR_US`;
  - phân tích offline cộng (j − 1) · Δ(PW) vào mốc thời gian của khe j, gốc là khe 1;
  - Δ suy từ độ rộng xung trong `SPO2_CONFIG` của packet `0xD2` (MAX30101) của phiên;
  - quy ước gắn với version của feature hay config dùng nó.

  Chỉ còn mở giá trị Δ: nó phụ thuộc độ rộng xung, mà độ rộng xung chờ bring-up mục 8.
  Danh định 1 107 µs (411 µs) và 720 µs (215 µs), theo
  [custom_board_proposal.md](custom_board_proposal.md) A.6 mục 3.

## 11. Kênh nhiệt độ `0xB1` (sửa đổi 2026-10-25)

Quyết định của Huy ngày 2026-10-25: đọc nhiệt độ trong chip MAX30101 mỗi 1 s, gửi qua
một kênh mới của V0.2, **mỗi packet một giá trị**. `VERSION` vẫn là `0x02`; dữ liệu
V0.2 đã ghi không có `0xB1` vẫn hợp lệ. Đây là nhiệt độ của chip, không phải nhiệt độ
da: chỉ dùng làm xu hướng (độ chính xác ±1 °C ở 25 °C, phân giải 0,0625 °C, thời gian
chuyển đổi 29 ms; MAX30101 tr. 4, 23). Chi tiết dưới đây đã qua hai vòng phản biện
cùng ngày (thiết kế, rồi code).

| Trường | Giá trị |
| --- | --- |
| `CHANNEL_ID` | `0xB1`, chỉ hợp lệ khi `VERSION = 0x02` |
| `SEQ` | Đếm riêng cho `0xB1`, từ 0 mỗi phiên |
| `FIRST_SAMPLE_INDEX` | Số thứ tự k của nhịp 1 s mà lần đo thuộc về (mục 11.1) |
| `T_ANCHOR_US` = `T_FIRST_US` | `esp_timer` ngay sau khi đọc xong (mục 11.1): thời điểm đọc ra, trễ hơn nhịp k một khoảng gồm trễ bắt đầu, 29 ms chuyển đổi và trễ hỏi lại, luôn trong [nhịp k, nhịp k + 100 ms] (không phải độ trễ 0) |
| `FS_NOMINAL_MHZ` | 1 000 (1 Hz) |
| `SAMPLE_COUNT` | 1 (packet 46 byte) |
| `STATUS` | Chỉ được dùng bit 1 (như mọi kênh) và bit 3 (mục 11.1); bit 4 **không** bật (độ trễ AFE không áp dụng); các bit khác là dự trữ với `0xB1` |
| `DATA[0]` | `TINT × 16 + TFRAC`, int32 có dấu, đơn vị 1/16 °C. `TINT` bù hai, `TFRAC` 0–15 luôn cộng dương (tr. 23). Receiver nhận −2 048 ≤ `DATA[0]` ≤ 2 047 |

Đổi đơn vị: °C = `DATA[0]` / 16.

### 11.1. Firmware

- Đo trong task đọc PPG (cùng bus I²C, không tranh bus với lần đọc FIFO), bằng một
  máy trạng thái C thuần (`die_temp.c`, test trên máy tính). Nhịp k ở thời điểm
  t₀ + k · 1 s theo `esp_timer` (không cộng dồn trễ); t₀ là lúc chip PPG bắt đầu đo
  lần đầu trong phiên và **giữ nguyên** qua các lần reset chip.
- Vòng lặp đầu tiên tại hay sau nhịp k ghi `TEMP_EN`, nhưng chỉ khi chưa quá
  **50 ms** sau nhịp; muộn hơn thì nhịp đó không có giá trị (không bật bit lỗi) và
  chờ nhịp sau. Các vòng sau đọc `TEMP_CONFIG`; khi `TEMP_EN` tự xóa thì đọc `TINT`
  và `TFRAC` (đọc `TFRAC` xóa `DIE_TEMP_RDY`; ngắt này không bật nên không ảnh hưởng
  chân INT), rồi đọc `MODE_CONFIG`, lấy anchor, gửi packet chỉ số k. Kết quả phải
  **đọc xong** trước nhịp k + **100 ms** (so bằng thời điểm sau lần đọc, không phải
  lúc bắt đầu đọc), nên anchor luôn nằm trong [nhịp k, nhịp k + 100 ms]. Phần nhiệt
  độ chạy ở **mọi** vòng lặp, kể cả vòng không gửi PPG (ít nhất mỗi 10 ms khi dùng
  ngắt; khi đọc theo timer thì mỗi chu kỳ, và firmware từ chối build nếu
  `BOARD_PPG_READ_PERIOD_MS` > 40).
- Không bao giờ có hai lần đo chồng nhau.
- Lần đo bị bỏ (nhịp đó không có giá trị) khi: lỗi I²C; quá hạn 100 ms (kể cả kết
  quả đọc xong sau hạn); chip phải cấu hình lại (sụt nguồn, đọc lỗi). Lần đo đang
  chạy được **hủy trước** mọi lần reset hay cấu hình lại: sau `RESET`, `TEMP_EN = 0`
  và các thanh ghi nhiệt độ về 0, nên đọc tiếp sẽ ra 0 °C trông như thành công. Sụt
  nguồn xảy ra **sau** lần đọc `Status 1` của vòng lặp thì chỉ vòng sau mới thấy
  `PWR_RDY`; vì vậy `MODE_CONFIG` được đọc **sau** `TINT`/`TFRAC`: nếu không còn là
  chế độ multi-LED thì chip đã bị reset và lần đo bị bỏ.
- Chỉ số là số thứ tự nhịp, nên mọi khoảng trống đều **biết chính xác độ dài**:
  không dùng bit 5 (không có lần neo lại nào) và cũng không dùng bit 0. Packet kế
  tiếp sau một lần bỏ vì lỗi AFE hay I²C (kể cả cấu hình lại chip) bật **bit 3** để
  ghi nguyên nhân. Bit 3 chỉ nằm trên packet đưa vào hàng đợi; nếu packet đó bị bỏ ở
  hàng đợi hay mất trên USB thì nguyên nhân mất theo (bit 3 không nằm trong các bit
  được chuyển sang packet sau), nhưng khoảng trống chỉ số vẫn còn và bit 1 vẫn báo
  việc bỏ ở hàng đợi.
- Nguồn gốc dữ liệu: env có chip thật (`BOARD_PPG_REAL=1`) chỉ gửi nhiệt độ đọc từ
  chip, **không bao giờ** thay bằng giá trị giả khi chip lỗi. Env toàn nguồn giả gửi
  `0xB1` với giá trị giả theo công thức trong code, qua cùng máy trạng thái, để
  logger thử đường đi của kênh trước khi có bo; phiên đó có `source_type` là
  `SYNTHETIC`. Env trộn nguồn thật và giả ghi nguồn của từng kênh trong `afe_config`.
- Tải thêm 1 packet/s, 46 B/s (mục 10: 13,9 kB/s với PPG N = 8).

### 11.2. Logger, metadata, simulator

- Codec: `0xB1` tên `DIE_TEMP`, thêm vào bảng mã kênh của `VERSION 0x02`. Logger cũ
  (trước sửa đổi này) bỏ `0xB1` với `unknown_channel`, và metadata có khóa `0xB1`
  không qua được validator cũ: nâng logger và firmware cùng lúc.
- Receiver, trước khi kiểm chỉ số và timing: packet `0xB1` phải có `SAMPLE_COUNT = 1`,
  `FS_NOMINAL_MHZ = 1 000` và `T_FIRST_US = T_ANCHOR_US`; sai thì báo
  `temp_header_invalid` và cách ly. Bit dự trữ (ngoài bit 1 và 3) báo
  `status_reserved_bits` như mọi kênh, và packet cũng bị cách ly (`temp_header_invalid`).
- Chỉ số: bước nhảy tới trước của `0xB1` lớn hơn số packet vắng là **khoảng trống đã
  đếm** (báo `sample_gap_counted` với `lost_samples` = độ nhảy, `absent_packets` =
  số packet vắng), không cắt chuỗi. Nếu độ nhảy đúng bằng số packet vắng (chỉ mất
  trên USB) thì chỉ có `missing_packets`, như các kênh khác. Chỉ số lùi hay nhảy ít
  hơn số packet vắng vẫn báo như các kênh khác.
- Timing: thay cho phép so từng cặp của các kênh khác (ở 1 Hz, dung sai 1 chu kỳ +
  500 µs nhận cả hai anchor cách nhau 1 ms), `0xB1` kiểm **pha** của cả chuỗi:
  `T_ANCHOR_US` − k · 1 s của mọi packet phải nằm trong một cửa sổ rộng
  `temp_anchor_tolerance_us` = 150 000 (150 ms; firmware giữ pha trong 100 ms, cộng
  dư; dưới 1 s). Nhịp và anchor cùng là `esp_timer` nên pha không được trôi; so
  từng cặp thì pha trôi dần 100 ms mỗi packet vẫn lọt. Cửa sổ giữ nhiều packet nhất
  được chọn (sớm nhất nếu bằng nhau); packet ngoài cửa sổ báo `timestamp_anomaly`
  (`kind` = `phase`) và bị cách ly. `0xB1` không tham gia `channel_offset` (anchor
  là thời điểm đọc ra, không phải thời điểm mẫu).
- Dải `DATA` như bảng trên; ngoài dải thì `data_out_of_range`. Không kiểm tính hợp lý
  của nhiệt độ. `channel_missing` chỉ bắt kênh mất hoàn toàn: chỉ khai báo `0xB1`
  trong metadata khi firmware đó có gửi.
- Metadata (`packet-session-metadata-v0`) nhận khóa `0xB1`: `sensor` `"MAX30101"`,
  `fs_nominal_mhz` 1 000, `latency_l_us` và `latency_source` null kèm lý do (không áp
  dụng: anchor là thời điểm đọc ra), `unit_conversion` "°C = DATA / 16", `afe_config`
  ghi chu kỳ 1 s, chuyển đổi 29 ms, hạn 100 ms, cách hỏi lại, ý nghĩa của anchor và
  nguồn (chip hay giả).
- Simulator v3: cho phép `0xB1` khi `wire_version: 2` (bắt buộc 1 000 mHz, N = 1,
  không là `fault_channel`); payload có dấu trong dải trên; bit 4 không bật trên
  `0xB1`. Config V0.2 mặc định **không** đổi (thêm kênh 1 Hz sẽ kéo dài dòng thời
  gian từ khoảng 1,8 s lên 8 s và đổi fixture); có config riêng
  `packet_simulation_v3_v02_temp.json`. Ca lỗi của `0xB1` thử bằng packet dựng tay.
- Không đổi `packet-logger-v1` lúc đó (cùng ngày lên `packet-logger-v2` với mục 12–13
  và `channel_holes`, xem `docs/protocol/packet_logger.md`; thêm khóa bắt buộc
  `temp_anchor_tolerance_us` vào
  config, như `samp_anchor_tolerance_us` ngày 2026-10-24; config cũ thiếu khóa này
  không còn hợp lệ, chấp nhận vì logger v1 chưa phát hành và chưa có bản ghi thiết
  bị) và `synthetic-packet-v3`.

## 12. Packet cấu hình AFE `0xD2` (sửa đổi 2026-10-25)

Quyết định ngày 2026-10-25 (thiết kế đã qua phản biện): cấu
hình thật của từng AFE đi **trong** luồng raw, như thông tin thiết bị `0xD1`, để biết
chip đã chạy với thanh ghi nào và nguồn của từng kênh (chip thật hay nguồn giả) khi một
bản build trộn hai loại. Metadata mục 8 do người vận hành viết vẫn giữ nguyên; logger
báo cấu hình quan sát được riêng, không ghi đè metadata.

| Trường | Giá trị |
| --- | --- |
| `CHANNEL_ID` | `0xD2`, chỉ hợp lệ khi `VERSION = 0x02` |
| `SEQ` | Đếm riêng cho `0xD2`, từ 0 mỗi phiên |
| `FIRST_SAMPLE_INDEX` | Số thứ tự packet `0xD2` firmware đã tạo trong phiên (mọi AFE, kể cả packet bị bỏ) |
| `T_ANCHOR_US` = `T_FIRST_US` | `esp_timer` lúc trạng thái đó bắt đầu có hiệu lực (cấu hình xong, hay chip bị bỏ) |
| `FS_NOMINAL_MHZ` | 0 |
| `SAMPLE_COUNT` | 5 + R |
| `STATUS` | 0; cho phép bit 1: một packet `0xD2` trước đó của **chính AFE này** bị bỏ trước khi có `SEQ` (hàng đợi MCU đầy), hay một bước chuyển của nó không vào được hàng đợi trạng thái, nên có thể đã mất một bước chuyển (sửa 2026-10-25: bit 1 không còn chuyển theo kênh, vì ba AFE dùng chung `0xD2`; packet mất sau khi có `SEQ` thì logger thấy qua khoảng trống `SEQ`) |

| `DATA` | Nội dung |
| --- | --- |
| `[0]` | Phiên bản layout = 1 |
| `[1]` | AFE: 1 = MAX30001 (kênh `0xE1`), 2 = MAX30101 (`0xF1`–`0xF3`, `0xB1`), 3 = BMI270 (`0xA1`–`0xA6`) |
| `[2]` | Nguồn: 0 = nguồn giả của firmware (dữ liệu SYNTHETIC), 1 = chip |
| `[3]` | Trạng thái: 1 = đang chạy với cấu hình dưới đây; 0 = không chạy (chip khởi động lỗi và đã bỏ, hay đang chờ cấu hình lại) |
| `[4]` | Thế hệ: số lần cấu hình thành công của AFE đó từ lúc MCU khởi động, tăng đơn điệu, không đặt lại khi chip lỗi; 0 = chưa lần nào. Nguồn giả luôn 0 |
| `[5]` … | R word thanh ghi, chỉ khi nguồn chip và trạng thái 1 (R = 0 khi khác): uint32 `(địa chỉ << 24) | giá trị`, chở bằng đúng mẫu bit trong int32 |

Layout 1 có **đúng** các thanh ghi sau, theo thứ tự (giá trị 24 bit với MAX30001; 8 bit,
bit 8–23 bằng 0, với MAX30101 và BMI270):

- MAX30001 (R = 8): `CNFG_GEN` 0x10, `CNFG_CAL` 0x12, `CNFG_EMUX` 0x14, `CNFG_ECG` 0x15,
  `MNGR_INT` 0x04, `MNGR_DYN` 0x05, `EN_INT` 0x02, `EN_INT2` 0x03.
- MAX30101 (R = 11): `FIFO_CONFIG` 0x08, `SPO2_CONFIG` 0x0A, `LED1_PA`–`LED4_PA`
  0x0C–0x0F, `MULTI_LED_CTRL1`–`2` 0x11–0x12, `INT_ENABLE1`–`2` 0x02–0x03,
  `MODE_CONFIG` 0x09.
- BMI270 (R = 14): 0x40, 0x41, 0x42, 0x43, 0x45, 0x46, 0x47, 0x48, 0x49, 0x53, 0x55,
  0x58, 0x7C, 0x7D (mục 3).

Giá trị là cấu hình cuối đã ghi **và** đọc lại khớp trên các bit có định nghĩa (mặt nạ
của driver); không gửi giá trị đọc lại thô vì các bit không định nghĩa trong đó không có
nghĩa. Không gồm các lần ghi tạm khi reset hay khi tắt. Microcode BMI270 xác định qua
ELF SHA-256 của `0xD1` cùng mã nguồn ở commit firmware (SHA-256 của mảng có trong
`firmware/drivers/bmi270_config.c`).

**Nhịp gửi:** một packet cho một AFE ngay khi trạng thái của nó đổi (nguồn giả lúc khởi
động; chip: mỗi lần cấu hình xong, lúc bắt đầu chờ cấu hình lại, lúc bị bỏ), và nhắc lại
trạng thái hiện tại của mọi AFE đã biết mỗi 10 s (để logger bắt đầu giữa phiên vẫn nhận
được, không phải bảo đảm tới nơi). Một task điều khiển duy nhất tạo `0xD2` và `0xD3`;
task đọc của từng chip chỉ công bố từng bước chuyển qua một hàng đợi (8 phần tử), nên
hai bước chuyển liền nhau không ghi đè nhau, và luôn ghi trạng thái mới nhất vào một bảng
riêng; hàng đợi đầy thì task điều khiển gửi trạng thái mới nhất của AFE đó kèm bit 1,
và lần nhắc lại 10 s luôn lấy từ bảng trạng thái mới nhất (sửa 2026-10-25: bản trước có
thể nhắc lại trạng thái cũ). Quy tắc theo từng AFE (`firmware/app/afe_order.c`, sửa
2026-10-25 theo review): không bao giờ gửi trạng thái cũ hơn trạng thái mới nhất đã gửi;
gửi lại đúng trạng thái đó chỉ khi nhắc lại 10 s hoặc để mang bit 1; lần nhắc lại chờ
khi trạng thái mới nhất còn trong hàng đợi; một bước chuyển bị mất được giữ lại tới khi
một `0xD2` của AFE đó mang bit 1, kể cả khi trạng thái mới hơn đã đi trước (khi đó trạng
thái ấy được gửi lại kèm bit 1). Số thứ tự trạng thái là 64 bit, không quay vòng.

**Logger:**

- Kiểm `FS_NOMINAL_MHZ = 0`, `T_FIRST_US = T_ANCHOR_US`, bit `STATUS` ngoài bit 1,
  layout 1, AFE 1–3, nguồn 0–1, trạng thái 0–1, nguồn giả thì trạng thái 0 hoặc 1 nhưng
  thế hệ 0 và R = 0, chip trạng thái 1 thì thế hệ ≥ 1 và đúng bộ thanh ghi của AFE (địa
  chỉ, thứ tự, độ rộng giá trị), còn lại R = 0. Sai thì `afe_config_invalid` kèm
  `problem`; packet sai không được tính.
- Số thứ tự so với `SEQ` như `0xD1` (`afe_config_lost_before_send`,
  `afe_config_ordinal_inconsistent`), nhưng chỉ bằng số thứ tự: bit 1 thuộc riêng AFE của
  packet và được báo `afe_config_transition_lost` kèm tên AFE (sửa 2026-10-25). Không
  kiểm anchor, không vào `samples.csv`, không thuộc `channel_missing`, không cần khóa
  metadata.
- Mỗi phiên có `afe_config`: theo từng AFE, các trạng thái khác nhau theo thứ tự `SEQ`
  (`first_seq`, `t_anchor_us`, nguồn, trạng thái, thế hệ, thanh ghi dạng hex, số
  packet). Thế hệ lùi trong một phiên báo `afe_config_generation_backwards`; cùng thế hệ
  mà thanh ghi khác báo `afe_config_changed_in_generation`.
- Theo từng AFE mà metadata có khai báo kênh của nó (phiên V0.2 nguồn `DEVICE`): không
  có packet hợp lệ nào báo `afe_config_missing`; trạng thái 0 báo `afe_not_configured`
  (kèm `seq`); nguồn giả báo `afe_fake_source` (kênh đó là dữ liệu SYNTHETIC trong một
  phiên `DEVICE`).

## 13. Lệnh từ PC và packet xác nhận `0xD3` (sửa đổi 2026-10-25)

Quyết định ngày 2026-10-25 (thiết kế đã qua phản biện): PC gửi
lệnh xuống qua chính cổng USB Serial/JTAG của luồng packet. Mục đích trước hết là hiệu
chuẩn dòng LED PPG theo người (protocol v0.2 mục 6.1): buổi đầu chỉnh rồi khóa, các
buổi sau PC gửi lại đúng các mã đã khóa ngay đầu phiên. Firmware không lưu dòng LED qua
lần khởi động (không ghi NVM).

**Khung lệnh PC → thiết bị** (little-endian, không đổi layout packet thiết bị → PC):

| Byte | Trường | Giá trị |
| --- | --- | --- |
| 0–1 | `SYNC` | `0xA5 0x5B` (khác `0xA5 0x5A` của packet) |
| 2 | `CMD_VERSION` | `0x01` |
| 3 | `CMD_ID` | Mã lệnh (bảng dưới) |
| 4–5 | `CMD_SEQ` | uint16 do PC chọn; PC không dùng lại trong một phiên thiết bị |
| 6 | `LEN` | Số byte tham số, 0 … 16 |
| 7 … | Tham số | `LEN` byte |
| cuối | CRC | CRC-16/CCITT-FALSE (như packet) trên byte 2 … hết tham số, uint16 |

| `CMD_ID` | Lệnh | Tham số | Tác dụng |
| --- | --- | --- | --- |
| `0x01` | `PING` | không | Chỉ xác nhận; kiểm đường lệnh |
| `0x02` | `SET_PPG_LED` | 7 byte: `SESSION_ID` đích (uint32), mã xanh **mỗi nhánh** (LED3 và LED4), mã đỏ, mã IR; bước 0,2 mA | Cấu hình lại MAX30101 với các dòng mới (mục dưới), tăng thế hệ, gửi `0xD2` |
| `0x03` | `MARK_EVENT` (sửa đổi 2026-10-29) | 1 byte: mã sự kiện, chỉ nhận 2 (`CUFF_END`) hay 4 (`OPERATOR_MARK`) | Gửi packet sự kiện `0xC1` mang mã đó, mốc là lúc thiết bị nhận lệnh (mục dưới) |

- Thiết bị bỏ qua (không xác nhận) khung có CRC sai, `CMD_VERSION` khác 1 hay
  `LEN` > 16, và tìm `SYNC` lại từ byte sau byte `SYNC` đầu của khung đó; một khung dở
  không có thêm byte nào trong 100 ms thì bị bỏ. Khung đúng CRC với `CMD_ID` không biết
  được nhận trọn (không tìm lệnh bên trong) và xác nhận "không biết". Task điều khiển đọc
  cổng liên tục (bộ đệm RX 1 024 byte).
- **Ranh giới cấu hình:** `SET_PPG_LED` không ghi đè dòng LED lúc chip đang lấy mẫu mà
  đi qua đường cấu hình lại có sẵn: `RESET`, cấu hình đầy đủ với dòng mới, đọc lại
  (`max30101_start`). FIFO bị xóa, nên packet PPG kế tiếp neo lại (bit 5; không bật bit 3
  vì đây không phải lỗi) và bắt đầu chuỗi mới trong logger: mẫu trước và sau lệnh không
  nằm chung chuỗi. Lần cấu hình lỗi thì packet sau có bit 3 và 5 như mọi lỗi AFE. `T_ANCHOR_US` của
  `0xD2` mới là lúc cấu hình xong. Lỗi thì cấu hình lại bằng dòng cũ đã chấp nhận (thử lại
  mỗi 100 ms như sau sụt nguồn), kết quả 5. Mẫu lúc hiệu chuẩn và mẫu với dòng mặc định
  sau khởi động không thuộc cửa sổ đo (protocol v0.2 mục 6.1).
- **Lặp lại an toàn:** thiết bị nhớ yêu cầu gần nhất đã xong (`CMD_ID`, `CMD_SEQ`, tham
  số, kết quả, thế hệ). Khung giống hệt nó được xác nhận lại với kết quả cũ, không chạm
  phần cứng; cùng `CMD_SEQ` mà `CMD_ID` hay tham số khác bị từ chối (kết quả 6) và yêu
  cầu đã nhớ vẫn giữ nguyên. "Gần nhất" tính theo thứ tự **nhận** (sửa 2026-10-29): một
  `SET_PPG_LED` xong sau một yêu cầu nhận sau nó (PC đã ghi nó "không biết" rồi gửi
  lệnh khác) không thay yêu cầu đó trong bộ nhớ, nên lần gửi lại của yêu cầu sau (ví dụ
  một `MARK_EVENT` bị mất xác nhận) vẫn nhận kết quả cũ, không chạy lần hai. Kết quả 4 (bận) nghĩa là **chưa làm** và không được nhớ:
  lần thử sau dùng `CMD_SEQ` mới.
- **Yêu cầu đang làm:** task điều khiển giao `SET_PPG_LED` cho task PPG kèm một token và
  không đứng chờ (vẫn đọc cổng và gửi `0xD2`); xác nhận chỉ gửi khi có trả lời mang đúng
  token đó. Trong lúc đó, khung giống hệt bị bỏ qua (xác nhận sẽ tới khi xong), khung
  cùng `CMD_SEQ` mà byte khác nhận kết quả 6 (thêm 2026-10-29), yêu cầu LED khác nhận
  kết quả 4. Task PPG chưa nhận yêu cầu sau 2 s thì yêu cầu được rút lại
  (kết quả 4, chưa làm); đã nhận thì chờ tới khi có trả lời, không bao giờ tự đặt ra kết
  quả khi quá hạn.
- **Gắn với phiên:** `SET_PPG_LED` có `SESSION_ID` khác phiên hiện tại bị từ chối (kết
  quả 7), nên lệnh gửi lại sau khi MCU khởi động lại không chạy nhầm.
- **Trần dòng LED (chốt 2026-10-29):** mỗi mã ≤ `0x7F` (25,4 mA mỗi nhánh; xanh tổng
  50,8 mA); vượt thì kết quả 8, không làm gì.
  - `0x7F` là trần trên cho cả nghiên cứu, ghi trong hồ sơ đạo đức.
  - Sau bring-up mục 8 (trên bàn, không người), hạ trần xuống mức cần thiết cộng phần
    dư. Con số chờ số đo: dòng và nguồn ở mã cao
    (`hardware/test_reports/v1_bringup_procedure.md` mục 8 bước 2, 3, 9); mức ADC ở cổ
    tay chỉ đo được trên người, sau phê duyệt đạo đức, ở pilot (mức 30–70 % thang đo
    thường cần dưới trần).
  - Chỉ được nâng trần bằng một sửa đổi có ngày của spec này. Đổi trần thì đổi cùng
    lúc `CMD_LED_CODE_MAX` (firmware) và `LED_CODE_MAX`
    (`software/data_io/command_wire.py`).
  - Trần là lớp chặn, không phải bằng chứng an toàn. PC là lớp chặn thứ hai: dòng hộp
    thư có mã > `0x7F` bị từ chối trước khi gửi, trừ khi dòng ghi
    `"allow_over_firmware_limit": true` (`device_command.py set-ppg-led
    --allow-over-firmware-limit`). Cờ này chỉ dùng ở bring-up, không người, để kiểm
    firmware tự từ chối (kết quả 8).
  - Độ rộng xung và tốc độ do bản build quyết định, không đổi được bằng lệnh.
- **`MARK_EVENT` (sửa đổi 2026-10-29):** người vận hành đánh dấu một sự kiện từ PC,
  ví dụ lúc cuff xả xong (`CUFF_END`, mã 2) hay một ghi chú (`OPERATOR_MARK`, mã 4).
  - `LEN` khác 1: kết quả 2. Mã khác 2 và 4: kết quả 8, không phát sự kiện. Lệnh
    không phát được mã 1 (`t0` vẫn là nút SW1) hay mã 3 (xung kích thích do MCU tự
    phát). Lệnh không gắn với phiên và không phụ thuộc chip PPG.
  - Task điều khiển lấy `esp_timer` ngay sau lần đọc cổng trả về các byte của khung:
    đó là **lúc thiết bị nhận lệnh**. Nó đưa sự kiện vào hàng đợi sự kiện của nút SW1,
    nên task sự kiện phát packet `0xC1` như với mã 1: cùng số thứ tự sự kiện trong
    phiên, cùng quy tắc bit 1 (V0.1 mục 10), `T_ANCHOR_US` = `T_FIRST_US` = lúc nhận.
    Rồi nó gửi `0xD3` (kết quả 0, `DATA[4]` = 0).
  - Hàng đợi sự kiện đầy: kết quả 4 (chưa làm, không có sự kiện); PC gửi lại bằng
    `CMD_SEQ` mới nếu cần.
  - Gửi lại cùng byte (cùng `CMD_SEQ`) được xác nhận lại với kết quả cũ, **không** phát
    sự kiện thứ hai. Nếu khung đầu không tới mà lần gửi lại tới, mốc là lúc lần gửi lại
    tới thiết bị.
  - Mốc là lúc thiết bị nhận lệnh, không phải lúc người vận hành gõ lệnh. Độ trễ
    PC → thiết bị (đọc hộp thư tối đa mỗi 0,1 s, USB, bộ đệm RX, task điều khiển)
    **chưa đo**: không dùng mốc này cho việc cần chính xác tới ms. `t0` vẫn là SW1.
  - Kết quả 0 nghĩa là sự kiện đã vào hàng đợi sự kiện, không bảo đảm packet `0xC1`
    tới PC: bỏ ở hàng đợi MCU thì packet sự kiện sau có bit 1 và số thứ tự nhảy
    (`events_lost_before_send`), mất trên USB thì thiếu `SEQ`. `0xC1` và `0xD3` có thể
    tới PC theo thứ tự bất kỳ.
  - Xác nhận không mang số thứ tự sự kiện. Khi phân tích, ghép một xác nhận kết quả 0
    (mã đã gửi lấy từ nhật ký lệnh theo `CMD_SEQ`) với sự kiện mang mã đó có
    `T_ANCHOR_US` không sau `T_ANCHOR_US` của xác nhận này và sau `T_ANCHOR_US` của xác
    nhận `MARK_EVENT` kết quả 0 trước đó trong phiên (với `CMD_SEQ` khác). PC gửi một
    lệnh mỗi lần, cách nhau ít nhất 0,5 s, nên mỗi khoảng chỉ có sự kiện của lệnh đó.
    Không có đúng một sự kiện như vậy, hay logger báo mất sự kiện hay thiếu `SEQ` của
    `0xC1` trong khoảng đó, thì ghi là không ghép được; không đoán.
- PC (logger) gửi một lệnh mỗi lần, chờ xác nhận 500 ms, thử tối đa 3 lần cùng
  `CMD_SEQ` (cùng byte), không quá 2 lần gửi mỗi giây; hết lượt thì kết quả là **không
  biết**, không phải lỗi hay thành công. `SESSION_ID` đổi giữa chừng thì lệnh đang chờ
  bị hủy.
  - **`SET_PPG_LED` (chốt 2026-10-29):** firmware có thể mất tới 2 s mới trả lời (yêu
    cầu task PPG chưa nhận sau 2 s thì bị rút lại với kết quả 4). Vì vậy PC chỉ ghi
    "không biết" khi đã qua **2,5 s** kể từ lần gửi đầu; ba lần gửi vẫn cách nhau
    500 ms, và lần gửi lại trong lúc firmware đang làm bị bỏ qua (mục "Yêu cầu đang
    làm"). Firmware không đổi.
  - `0xD3` tới sau khi PC đã ghi "không biết" vẫn được khớp theo `CMD_SEQ` (cùng phiên,
    cùng `CMD_ID`) và ghi sự kiện `late_ack` vào nhật ký lệnh, một lần mỗi lệnh. Dòng
    "không biết" giữ nguyên: nó nói đúng điều PC biết lúc ghi.

| Kết quả | Ý nghĩa |
| --- | --- |
| 0 | Xong |
| 1 | `CMD_ID` không biết |
| 2 | `LEN` sai cho lệnh đó |
| 3 | Không có chip (bản build dùng PPG giả, hay chip đã bị bỏ) |
| 4 | Bận: chip đang chờ cấu hình lại, đang làm lệnh khác, hay hàng đợi sự kiện đầy (`MARK_EVENT`); chưa làm |
| 5 | Cấu hình với dòng mới không xong; chip đang được cấu hình lại bằng dòng cũ đã chấp nhận (thử mỗi 100 ms), `0xD2` cho biết lúc xong |
| 6 | `CMD_SEQ` đã dùng cho yêu cầu khác |
| 7 | `SESSION_ID` không phải phiên hiện tại |
| 8 | Tham số ngoài miền: mã dòng LED vượt trần (`SET_PPG_LED`), mã sự kiện không phải 2 hay 4 (`MARK_EVENT`, sửa đổi 2026-10-29); `CMD_ID` của xác nhận cho biết là trường hợp nào |

**Packet xác nhận `0xD3`** (thiết bị → PC):

| Trường | Giá trị |
| --- | --- |
| `CHANNEL_ID` | `0xD3`, chỉ hợp lệ khi `VERSION = 0x02` |
| `SEQ` | Đếm riêng cho `0xD3` |
| `FIRST_SAMPLE_INDEX` | Số thứ tự xác nhận firmware đã tạo trong phiên (mỗi xác nhận một lần, kể cả xác nhận lặp lại) |
| `T_ANCHOR_US` = `T_FIRST_US` | `esp_timer` lúc lệnh xong |
| `FS_NOMINAL_MHZ` | 0 |
| `SAMPLE_COUNT` | 5 |
| `STATUS` | 0; cho phép bit 1 |
| `DATA` | `[0]` layout = 1; `[1]` `CMD_ID` (0 … 255); `[2]` `CMD_SEQ` (0 … 65 535); `[3]` kết quả (0 … 8); `[4]` thế hệ MAX30101 sau lệnh với `SET_PPG_LED` xong (≥ 1), 0 với mọi trường hợp khác (kể cả `MARK_EVENT`) |

**Logger:**

- `record` tạo một file hộp thư **mới** trong thư mục output (`command_inbox.jsonl`) lúc
  bắt đầu. `scripts/device_command.py` ghi thêm một dòng JSON mỗi lệnh (`{"cmd":
  "ping"}`, `{"cmd": "set_ppg_led", "green": 18, "red": 36, "ir": 36}`, `{"cmd":
  "mark_event", "event": "cuff_end"}` hay `"operator"`) bằng một lần ghi rồi flush.
  `set_ppg_led` có mã > `0x7F` bị từ chối ở cả `device_command.py` và vòng ghi, trừ khi
  dòng có `"allow_over_firmware_limit": true` (chỉ cho bring-up, xem "Trần dòng LED").
  Vòng ghi xem hộp thư sau mỗi lần đọc cổng, kể cả khi cổng không có byte nào
  (timeout 0,1 s); giữ phần dòng chưa có ký tự xuống dòng; dòng dài quá 1 024 byte hay
  sai kiểu bị ghi là bị từ chối; file bị cắt ngắn thì ngừng đọc hộp thư và ghi lại.
  `SESSION_ID` đích lấy từ packet gần nhất; chưa có packet nào thì lệnh chờ.
- Mọi bước ghi vào `commands_sent.jsonl` (thời điểm PC, dòng hộp thư, `CMD_SEQ`, phiên
  đích, lần thử, byte gửi, ghi xong hay không, kết quả khớp được, "không biết" hay
  `late_ack`). Thời điểm PC (`pc_monotonic_s`) chỉ để tham khảo, không bao giờ là mốc
  sự kiện: mốc của `MARK_EVENT` là `T_ANCHOR_US` của packet `0xC1`. File này và
  `command_inbox.jsonl` có hash trong manifest. `CMD_SEQ` bắt đầu từ một giá trị ngẫu
  nhiên mỗi lần ghi.
- `0xD3`: kiểm `SAMPLE_COUNT = 5`, layout 1, `FS_NOMINAL_MHZ = 0`,
  `T_FIRST_US = T_ANCHOR_US`, bit `STATUS` ngoài bit 1, miền của từng trường, `PING` và
  `MARK_EVENT` xong thì thế hệ 0, `SET_PPG_LED` xong thì thế hệ ≥ 1 và có `0xD2` của
  MAX30101 cùng thế hệ trong phiên (sai: `command_ack_invalid` /
  `command_ack_without_config`); số thứ tự so với `SEQ` như `0xD1`; mỗi phiên có
  `commands` (các xác nhận hợp lệ theo `SEQ`); kết quả khác 0 báo `command_failed`
  (kèm tên kết quả).
- Sự kiện mã 2 và 4 của `MARK_EVENT` là packet `0xC1` thường (V0.1 mục 10), nằm trong
  `events` của phiên cùng mã 1 và 3. Logger không ghép xác nhận với sự kiện; ghép theo
  quy tắc ở mục `MARK_EVENT` trên khi phân tích.
- Raw chỉ có chiều thiết bị → PC. Kết quả giải mã (`decode.json`, `packets.csv`,
  `samples.csv`) chỉ phụ thuộc raw, nên replay không cần nhật ký lệnh; việc khớp lệnh
  với xác nhận nằm trong `commands_sent.jsonl`.
