ndhuy1127/ppg-ecg-blood-pressure/docs/literature/literature_update_2026-10-29.md

# Các bài gần nhất với RQ1 và mức độ mới của đề tài

> **Ngày lập:** 2026-10-29. **Cập nhật cùng ngày:** lần tra thứ hai, có hệ thống và có nhật ký, trên
> PubMed, Europe PMC và OpenAlex cho giai đoạn 2022–2026; đọc toàn văn N5, N7, N8, N16; thêm
> N18–N42; viết lại mục 4–6; ghi quyết định ngày 2026-10-29 về S4 và kết quả thử tải N6.
> **Cập nhật 2026-10-30:** Viết lại văn phong, sửa ghi chú của vài dòng trong bảng 3
> theo các góp ý phản biện, và ghi lại các việc ở mục 5.3 đã làm.
> **Cập nhật 2026-10-30, lần 2:** đọc toàn văn N6 từ bản PDF (CC BY) do nhóm tải bằng trình duyệt
> thường; sửa dòng N6 ở bảng 3 và các mục 2, 4, 5, 6 theo kết quả này.
> **Cập nhật 2026-10-30, lần 3:** đọc toàn văn S4 từ bản PDF miễn phí trên trang Microsoft Research;
> thêm mục 3.3 và sửa các mục 2, 3.1, 4, 5, 6 theo kết quả này.
>
> Tài liệu này bổ sung cho [ma trận Tuần 1](week_01_literature_matrix.md) và
> [tổng quan bổ sung 2026-10-14](literature_update_2026-10-14.md) (mã S1–S14). Việc tìm có nhật
> ký nhưng **không phải systematic review**: không đăng ký protocol, chỉ một bên sàng lọc, không có
> sơ đồ PRISMA.

## 1. Câu hỏi

Đã có nghiên cứu nào làm giống RQ1 chưa? Cụ thể: trên cùng một thiết bị, so sánh PPG-only với
PPG + PAT để dự đoán ΔSBP/ΔDBP ở **các phiên đo sau** khi đã hiệu chuẩn bằng cuff, có baseline
zero-change và đánh giá theo người. Nếu đã có, phần nào của đề tài vẫn còn mới?

## 2. Nhật ký tìm kiếm

### 2.1. Lần tra thứ nhất (2026-10-29, tra có mục tiêu)

| Công cụ | Truy vấn | Kết quả |
| --- | --- | --- |
| OpenAlex (tìm theo tiêu đề) | `features from the photoplethysmogram and the electrocardiogram for estimating changes in blood pressure`; `conventional pulse transit times as markers of blood pressure changes in humans`; `photoplethysmography fast upstroke time intervals cuff-less measurement of blood pressure changes in humans`; `wearable cuff-less blood pressure estimation at home via pulse transit time`; `pulse transit time based continuous cuffless blood pressure estimation new extension comprehensive evaluation`; `cuffless blood pressure calibration drift days pulse arrival time photoplethysmography wearable`; `pulse arrival time photoplethysmogram features comparison blood pressure tracking interventions wearable` | N1–N5, N9 và một số bài liên quan khác |
| OpenAlex (bài trích dẫn) | Các bài trích dẫn N1 và S3, lấy 25 bài được trích nhiều nhất ở mỗi bên | N6, N7, N8; bổ sung ngày 2026-10-29: N13, N15 |
| OpenAlex (bài trích dẫn, bổ sung 2026-10-29) | Các bài trích dẫn S4 (Aurora-BP), lấy 25 bài được trích nhiều nhất | N12, N14, N16, N17 |
| OpenAlex (tìm theo tiêu đề, bổ sung 2026-10-29) | `pre-ejection period stress dependent pulse wave velocity based applications` | N11 |
| Tìm kiếm web (chế độ mở rộng) | `wrist ECG PPG pulse arrival time cuffless blood pressure multiple days after calibration added value over PPG features`; `2024 2025 study pulse arrival time versus PPG morphology features blood pressure changes longitudinal repeated sessions healthy volunteers cold pressor mental arithmetic calibration baseline` | N10; không thấy bài nào so PPG-only với PPG + PAT qua nhiều phiên |
| Europe PMC (REST) | Tra PMC ID, abstract và toàn văn XML theo DOI | Mức đã đọc ghi ở bảng 3 |

Ghi chú của lần thứ nhất, giữ lại để truy vết: nature.com chuyển sang trang đăng nhập; hai trong
ba trang trên pmc.ncbi.nlm.nih.gov đòi CAPTCHA, nên đã đọc thay qua Europe PMC. Lần này **dừng
sớm** vì giới hạn thời gian và chưa tra có hệ thống. Mức đã đọc hiện tại của từng nguồn ghi ở
bảng 3, đã cập nhật sau lần thứ hai.

**Đính chính về truy cập.** Lần thứ nhất ghi cả S4 và N6 là "IEEE, toàn văn có phí". Thực tế:

- S4: bản trên IEEE có phí, nên ngày 2026-10-29 nhóm quyết định không lấy qua thư viện mà chỉ dùng
  abstract. Ngày 2026-10-30 trợ lý tìm được bản PDF miễn phí trên trang Microsoft Research và đã đọc
  toàn văn (mục 2.2 và 3.3).
- N6 là bài truy cập mở dạng hybrid: theo Crossref, bản đã xuất bản có giấy phép CC BY 4.0. Tải
  tự động bị chặn (mục 2.2); ngày 2026-10-30 nhóm tải bản PDF bằng trình duyệt thường và trợ lý đã
  đọc toàn văn từ bản này.

### 2.2. Lần tra thứ hai (2026-10-29, tra có hệ thống)

**Phạm vi.** Ngày 2026-10-29 đã chạy 32 truy vấn:

- 13 trên PubMed (E-utilities, trường `[tiab]`, lọc `2022:2026[dp]`);
- 7 trên Europe PMC (REST, trường `TITLE_ABS`, lọc `PUB_YEAR:[2022 TO 2026]`, nguồn MED/PMC/PPR;
  riêng E6 và E9 tìm cả trong toàn văn mở);
- 7 trên OpenAlex (lọc `title_and_abstract.search` và `publication_year:2022-2026`);
- 5 tập bài trích dẫn trên OpenAlex: mọi bài trích dẫn S4, S3, N1, N6, N8, không lọc năm.

Các truy vấn bám theo tám chủ đề được giao:

- T1: thiết bị cổ tay hoặc đồng hồ đo cả ECG lẫn PPG;
- T2: PAT so với đặc trưng PPG;
- T3: giá trị gia tăng sau khi hiệu chuẩn bằng cuff;
- T4: đánh giá qua nhiều ngày hoặc nhiều phiên;
- T5: baseline chỉ hiệu chuẩn hoặc zero-change;
- T6: các bài dùng dataset Aurora-BP;
- T7: PEP khi bị stress;
- T8: áp lực tiếp xúc ở PPG cổ tay.

Ngoài ra có hai truy vấn rộng để kiểm độ nhạy của cách tìm (P0/E0 và P10).

**Số bản ghi.** Tổng cộng 2.180 bản ghi: PubMed 784, Europe PMC 652, OpenAlex tìm kiếm 362,
OpenAlex trích dẫn 382. Sau khi loại trùng theo DOI, PMID và tiêu đề đã chuẩn hóa, còn **1.085
bản ghi**. Mọi bản ghi đều đã được tải về; không truy vấn nào bị cắt bớt trang kết quả.

**Sàng lọc.** đọc tiêu đề của cả 1.085 bản ghi và đọc abstract của 196 bản ghi. Số 196
này gồm các ứng viên còn lại sau bước lọc tiêu đề, cộng mọi bản ghi có tiêu đề liên quan tới BP
trong E6, O6, P6 và C1, để kiểm kê các bài dùng Aurora-BP. Kết quả: **giữ lại 80** bản ghi, trong
đó 25 bản ghi thành các dòng N18–N42, 34 bản ghi ghi ở mục 3.1–3.2, và 21 bản ghi là nguồn đã có
(S, N, #) hoặc bản preprint, abstract hội nghị của nguồn đã có; **loại 1.005** bản ghi. Không có
người thứ hai sàng lọc.

**Tiêu chí giữ lại:** nghiên cứu trên người (hoặc tổng quan, khuyến cáo mới) liên quan trực tiếp
tới một trong các chủ đề T1–T8, ở mức có thể làm thay đổi khoảng trống hoặc rủi ro của RQ1. **Mã
lý do loại** (dùng ở bảng dưới):

- **L1** chủ đề khác: HRV, rung nhĩ, ngừng tim, giấc ngủ, tâm thần, can thiệp lối sống, hoặc chỉ
  trùng chữ viết tắt hay tên dự án;
- **L2** dữ liệu ICU, phẫu thuật hoặc dataset công khai chỉ có một buổi (MIMIC, VitalDB, UCI,
  PulseDB), không có cấu trúc phiên;
- **L3** cảm biến hoặc vị trí đo khác (camera, radar, siêu âm, tonometry, áp điện, BCG, cân, điện
  thoại thông minh), không thuộc T7 hay T8;
- **L4** không hiệu chuẩn (ước lượng BP tuyệt đối) hoặc chỉ phân loại tăng huyết áp;
- **L5** chỉ một buổi, không so PPG với PAT, không có baseline chỉ hiệu chuẩn;
- **L6** tổng quan, bình luận hoặc khuyến cáo chung, không thêm thông tin cho khoảng trống;
- **L7** trùng nội dung (abstract hội nghị, preprint của bài đã đăng).

**Bảng 2.2a. Kết quả theo truy vấn.** Cột "Đã xem abstract" tính cả nguồn đã có. Với C1, C2, E6,
O6 và P6, con số lớn vì mọi bản ghi có tiêu đề liên quan tới BP đều được xem để kiểm kê Aurora-BP.

| ID | Nguồn | Chủ đề | Bản ghi | Đã xem abstract | Giữ lại | Dòng N mới | Lý do loại chính |
| --- | --- | --- | --- | --- | --- | --- | --- |
| P0 | PubMed | Rộng: BP + PPG + ECG/PAT/PTT | 250 | 45 | 20 | N18, N20, N26, N27, N35, N41, N42 | L2, L5, L1 |
| P1 | PubMed | T1 | 22 | 6 | 4 | N35, N42 | L1 (ngừng tim, rung nhĩ), L6 |
| P2 | PubMed | T2 | 19 | 9 | 4 | — | L5, L2, L3 |
| P3 | PubMed | T3 (ECG/PAT + PPG) | 28 | 17 | 11 | N18, N41 | L2, L4 |
| P3b | PubMed | T3 (mọi cảm biến) | 94 | 41 | 28 | N18, N22, N24, N28, N31, N33, N34, N39, N40 | L3, L4, L6 |
| P4 | PubMed | T4 | 46 | 25 | 17 | N18, N28, N31, N33, N34, N39, N40 | L3, L4 |
| P5 | PubMed | T5 | 65 | 27 | 17 | N18, N22, N23, N25, N26, N32, N34 | L1 (từ khóa "BP changes" quá rộng), L3 |
| P6 | PubMed | T6 | 10 | 8 | 7 | N20 | L1 (dự án khác cùng tên AURORA) |
| P7 | PubMed | T7 (PEP + stress) | 104 | 9 | 5 | N28, N29, N30 | L1 (PEP chỉ dùng như chỉ số tâm sinh lý) |
| P7b | PubMed | T7 (PEP + PAT/PTT/PWV/PPG) | 16 | 5 | 4 | N28, N29 | L1, L2 |
| P8 | PubMed | T8 | 20 | 8 | 7 | N35, N36, N38 | L1 (SpO2, HR), vị trí ngón tay |
| P9 | PubMed | Lõi RQ1 (giao T1–T4) | 10 | 7 | 3 | N18 | L3, L2 |
| P10 | PubMed | Rộng: mọi bài PAT | 100 | 28 | 13 | N18, N25, N26, N27, N28, N41 | L1 (giấc ngủ, tim mạch lâm sàng, trùng chữ viết tắt) |
| E0 | Europe PMC | Rộng (như P0) | 258 | 40 | 16 | N18, N20, N27, N35, N41, N42 | L2, L5, L7 |
| E4 | Europe PMC | T4 | 49 | 26 | 17 | N18, N21, N28, N31, N33, N39, N40 | L3, L4 |
| E5 | Europe PMC | T5 | 146 | 33 | 22 | N18, N21, N22, N23, N25, N26, N28, N29, N34 | L1, L3 |
| E6 | Europe PMC | T6 (cả toàn văn mở) | 98 | 31 | 19 | N20, N21, N22, N38, N39, N40 | L1 (AURORA là dự án khác), bài chỉ trích dẫn Aurora |
| E7 | Europe PMC | T7 | 73 | 6 | 4 | N28, N29 | L1 |
| E8 | Europe PMC | T8 | 19 | 8 | 7 | N35, N36, N38 | L1 |
| E9 | Europe PMC | Lõi RQ1, toàn văn mở | 9 | 5 | 2 | N40 | L6, L2 |
| O1 | OpenAlex | T1 | 62 | 9 | 3 | N35, N42 | L1, L7 |
| O2 | OpenAlex | T2 | 20 | 3 | 1 | — | L3, L2 |
| O4 | OpenAlex | T3/T4 | 69 | 27 | 15 | N21, N31, N33, N39, N40 | L7, L4, L3 |
| O5 | OpenAlex | T5 | 10 | 1 | 0 | — | L1 |
| O6 | OpenAlex | T6 | 23 | 21 | 17 | N20, N21 | L1 |
| O7 | OpenAlex | T7 | 113 | 8 | 4 | N28, N29 | L1 |
| O8 | OpenAlex | T8 | 65 | 16 | 9 | N35, N36, N37, N38 | L1 ("contact force" thuộc lĩnh vực kỹ thuật khác) |
| C1 | OpenAlex | Bài trích dẫn S4 | 95 | 87 | 22 | N19, N20, N21, N22, N39 | L2, L3, L6 |
| C2 | OpenAlex | Bài trích dẫn S3 | 82 | 42 | 12 | N19, N22, N27, N39 | L3, L6 |
| C3 | OpenAlex | Bài trích dẫn N1 | 78 | 12 | 7 | N36 | L2, L3 |
| C4 | OpenAlex | Bài trích dẫn N6 | 82 | 28 | 8 | N20, N21, N33, N39 | L2, L3, L6 |
| C5 | OpenAlex | Bài trích dẫn N8 | 45 | 14 | 3 | N34 | L6, L1 |

**Chuỗi truy vấn nguyên văn** (chạy ngày 2026-10-29):

```text
P0  "blood pressure"[tiab] AND (photoplethysmogra*[tiab] OR PPG[tiab]) AND (electrocardiogra*[tiab] OR ECG[tiab] OR "pulse arrival time"[tiab] OR "pulse transit time"[tiab]) AND 2022:2026[dp]
P1  "blood pressure"[tiab] AND (wrist*[tiab] OR watch[tiab] OR smartwatch*[tiab] OR "smart watch"[tiab] OR wristband*[tiab] OR bracelet*[tiab]) AND (electrocardiogra*[tiab] OR ECG[tiab] OR EKG[tiab]) AND (photoplethysmogra*[tiab] OR PPG[tiab]) AND 2022:2026[dp]
P2  ("pulse arrival time"[tiab] OR "pulse transit time"[tiab] OR PTT[tiab]) AND (photoplethysmogra*[tiab] OR PPG[tiab]) AND "blood pressure"[tiab] AND (morpholog*[tiab] OR waveform*[tiab] OR "pulse wave analysis"[tiab] OR "pulse contour"[tiab] OR "PPG features"[tiab] OR "PPG-only"[tiab] OR "PPG only"[tiab]) AND (compar*[tiab] OR "added value"[tiab] OR additional[tiab] OR combin*[tiab] OR fusion[tiab]) AND 2022:2026[dp]
P3  calibrat*[tiab] AND ("pulse arrival time"[tiab] OR "pulse transit time"[tiab] OR electrocardiogra*[tiab] OR ECG[tiab]) AND (photoplethysmogra*[tiab] OR PPG[tiab]) AND "blood pressure"[tiab] AND (cuffless[tiab] OR cuff-less[tiab] OR "cuff-free"[tiab] OR wearable*[tiab]) AND 2022:2026[dp]
P3b "blood pressure"[tiab] AND (cuffless[tiab] OR cuff-less[tiab]) AND calibrat*[tiab] AND 2022:2026[dp]
P4  ("pulse arrival time"[tiab] OR "pulse transit time"[tiab] OR cuffless[tiab] OR cuff-less[tiab]) AND "blood pressure"[tiab] AND calibrat*[tiab] AND (day[tiab] OR days[tiab] OR week*[tiab] OR month*[tiab] OR year*[tiab] OR longitudinal[tiab] OR "long-term"[tiab] OR multiday[tiab] OR "multi-day"[tiab] OR session*[tiab] OR recalibrat*[tiab] OR drift[tiab] OR aging[tiab]) AND 2022:2026[dp]
P5  "blood pressure"[tiab] AND (cuffless[tiab] OR cuff-less[tiab] OR wearable*[tiab] OR "pulse arrival time"[tiab] OR "pulse transit time"[tiab]) AND ("calibration-only"[tiab] OR "calibration only"[tiab] OR "zero-change"[tiab] OR "zero change"[tiab] OR "no-change"[tiab] OR "baseline device"[tiab] OR "calibration BP"[tiab] OR "calibration value*"[tiab] OR "naive model"[tiab] OR "null model"[tiab] OR "B-score"[tiab] OR "persistence model"[tiab] OR "dummy model"[tiab] OR "baseline model*"[tiab] OR "trivial"[tiab] OR "track changes"[tiab] OR "tracking changes"[tiab] OR "BP changes"[tiab] OR "blood pressure changes"[tiab]) AND 2022:2026[dp]
P6  ("Aurora-BP"[tiab] OR "AuroraBP"[tiab] OR (Aurora[tiab] AND "blood pressure"[tiab])) AND 2022:2026[dp]
P7  ("pre-ejection period"[tiab] OR "preejection period"[tiab]) AND (stress*[tiab] OR "mental arithmetic"[tiab] OR "cold pressor"[tiab] OR sympathetic[tiab] OR "pulse arrival time"[tiab] OR "pulse transit time"[tiab]) AND 2022:2026[dp]
P7b ("pre-ejection period"[tiab] OR "preejection period"[tiab]) AND ("pulse arrival time"[tiab] OR "pulse transit time"[tiab] OR "pulse wave velocity"[tiab] OR photoplethysmogra*[tiab] OR PPG[tiab] OR cuffless[tiab] OR cuff-less[tiab]) AND 2022:2026[dp]
P8  ("contact pressure"[tiab] OR "contact force"[tiab] OR "hold-down pressure"[tiab] OR "applied pressure"[tiab] OR "strap tension"[tiab] OR "strap tightness"[tiab] OR "sensor pressure"[tiab]) AND (photoplethysmogra*[tiab] OR PPG[tiab]) AND 2022:2026[dp]
P9  ("pulse arrival time"[tiab] OR "pulse transit time"[tiab] OR electrocardiogra*[tiab] OR ECG[tiab]) AND (photoplethysmogra*[tiab] OR PPG[tiab]) AND "blood pressure"[tiab] AND calibrat*[tiab] AND (day[tiab] OR days[tiab] OR week*[tiab] OR month*[tiab] OR session*[tiab] OR longitudinal[tiab] OR "long-term"[tiab]) AND 2022:2026[dp]
P10 "pulse arrival time"[tiab] AND 2022:2026[dp]

E0  TITLE_ABS:"blood pressure" AND (TITLE_ABS:photoplethysmogra* OR TITLE_ABS:PPG) AND (TITLE_ABS:electrocardiogra* OR TITLE_ABS:ECG OR TITLE_ABS:"pulse arrival time" OR TITLE_ABS:"pulse transit time") AND PUB_YEAR:[2022 TO 2026] AND (SRC:MED OR SRC:PMC OR SRC:PPR)
E4  (TITLE_ABS:"pulse arrival time" OR TITLE_ABS:"pulse transit time" OR TITLE_ABS:cuffless OR TITLE_ABS:"cuff-less") AND TITLE_ABS:"blood pressure" AND TITLE_ABS:calibrat* AND (TITLE_ABS:day OR TITLE_ABS:days OR TITLE_ABS:week* OR TITLE_ABS:month* OR TITLE_ABS:year* OR TITLE_ABS:longitudinal OR TITLE_ABS:"long-term" OR TITLE_ABS:session* OR TITLE_ABS:recalibrat* OR TITLE_ABS:drift OR TITLE_ABS:aging) AND PUB_YEAR:[2022 TO 2026] AND (SRC:MED OR SRC:PMC OR SRC:PPR)
E5  TITLE_ABS:"blood pressure" AND (TITLE_ABS:cuffless OR TITLE_ABS:"cuff-less" OR TITLE_ABS:wearable* OR TITLE_ABS:"pulse arrival time" OR TITLE_ABS:"pulse transit time") AND (TITLE_ABS:"calibration-only" OR TITLE_ABS:"calibration only" OR TITLE_ABS:"zero-change" OR TITLE_ABS:"zero change" OR TITLE_ABS:"no-change" OR TITLE_ABS:"baseline device" OR TITLE_ABS:"calibration BP" OR TITLE_ABS:"naive model" OR TITLE_ABS:"null model" OR TITLE_ABS:"B-score" OR TITLE_ABS:"persistence model" OR TITLE_ABS:"dummy model" OR TITLE_ABS:"track changes" OR TITLE_ABS:"tracking changes" OR TITLE_ABS:"BP changes" OR TITLE_ABS:"blood pressure changes") AND PUB_YEAR:[2022 TO 2026] AND (SRC:MED OR SRC:PMC OR SRC:PPR)
E6  ("Aurora-BP" OR "AuroraBP" OR "Aurora project" OR ("Aurora" AND "cuffless")) AND PUB_YEAR:[2022 TO 2026] AND (SRC:MED OR SRC:PMC OR SRC:PPR)
E7  (TITLE_ABS:"pre-ejection period" OR TITLE_ABS:"preejection period") AND (TITLE_ABS:"pulse arrival time" OR TITLE_ABS:"pulse transit time" OR TITLE_ABS:"pulse wave velocity" OR TITLE_ABS:photoplethysmogra* OR TITLE_ABS:PPG OR TITLE_ABS:cuffless OR TITLE_ABS:stress) AND PUB_YEAR:[2022 TO 2026] AND (SRC:MED OR SRC:PMC OR SRC:PPR)
E8  (TITLE_ABS:"contact pressure" OR TITLE_ABS:"contact force" OR TITLE_ABS:"hold-down pressure" OR TITLE_ABS:"applied pressure" OR TITLE_ABS:"strap tension" OR TITLE_ABS:"strap tightness" OR TITLE_ABS:"sensor pressure") AND (TITLE_ABS:photoplethysmogra* OR TITLE_ABS:PPG) AND PUB_YEAR:[2022 TO 2026] AND (SRC:MED OR SRC:PMC OR SRC:PPR)
E9  ("pulse arrival time" AND ("PPG only" OR "PPG-only" OR "photoplethysmogram only") AND "blood pressure" AND calibration AND (days OR sessions OR longitudinal)) AND PUB_YEAR:[2022 TO 2026] AND (SRC:MED OR SRC:PMC OR SRC:PPR)

OpenAlex: filter=title_and_abstract.search:<chuỗi>,publication_year:2022-2026
O1  "blood pressure" AND (wrist OR watch OR smartwatch OR wristband OR bracelet) AND (electrocardiogram OR electrocardiography OR ECG) AND (photoplethysmography OR photoplethysmogram OR PPG)
O2  ("pulse arrival time" OR "pulse transit time") AND (photoplethysmography OR photoplethysmogram OR PPG) AND "blood pressure" AND (morphology OR "waveform features" OR "pulse wave analysis" OR "PPG features" OR "PPG only") AND (comparison OR compared OR "added value" OR combined OR fusion)
O4  "blood pressure" AND ("pulse arrival time" OR "pulse transit time" OR cuffless OR "cuff-less") AND calibration AND (days OR weeks OR months OR longitudinal OR "long-term" OR sessions OR recalibration OR drift)
O5  "blood pressure" AND (cuffless OR "cuff-less" OR wearable OR "pulse arrival time" OR "pulse transit time") AND ("calibration-only" OR "calibration only" OR "zero-change" OR "zero change" OR "no-change" OR "baseline device" OR "naive model" OR "null model" OR "B-score" OR "persistence model" OR "dummy model")
O6  "Aurora-BP" OR (Aurora AND "blood pressure" AND (wearable OR cuffless OR "cuff-less" OR ambulatory))
O7  ("pre-ejection period" OR "preejection period") AND ("pulse arrival time" OR "pulse transit time" OR "pulse wave velocity" OR photoplethysmography OR cuffless OR stress)
O8  ("contact pressure" OR "contact force" OR "hold-down pressure" OR "applied pressure" OR "strap tension" OR "strap tightness") AND (photoplethysmography OR photoplethysmogram OR PPG)
C1  cites:W4213432829 (S4)   C2 cites:W4310598717 (S3)   C3 cites:W4317215138 (N1)
C4  cites:W4377142751 (N6)   C5 cites:W4409443090 (N8)
```

**Các bài đã mở toàn văn** (đọc ngày 2026-10-29, không tính hình và danh mục tài liệu tham khảo):

- Đọc hết phần thân bài: N5 (BioC, PMC8221527), N7 (Europe PMC XML, PMC11532190), N8 (trang
  PMC12331212), N16 (bản chấp nhận trên ETH Research Collection, văn bản trích tự động) và N18
  (BioC, PMC9154072).
- Đọc có chọn lọc: N22 (đoạn Methods mô tả thiết bị, PMC10906216); N39 (PMC13506816) và N40
  (PMC13669345), gồm abstract và các đoạn về phạm vi, hiệu chuẩn, baseline.
- Đã tải nhưng chưa đọc: N23 (PMC10158604).
- Đọc ngày 2026-10-30: N6, bản PDF đã xuất bản (12 trang, CC BY 4.0) do nhóm tải bằng trình duyệt
  thường; SHA-256 của tệp `35587d99612e4fc6129f54e46e38f6292c9a30bf9e59fc52bdb7e6c898d504ee`. Phần
  chữ được trích bằng `pdftotext`. Bảng trong tệp không trích được thành chữ, nên trợ lý xem dưới
  dạng ảnh dựng từ PDF: xem kỹ Bảng IV, A1, A2 và Hình 5, 6, 8; xem lướt Bảng II, III, V và Hình 7,
  A1; chưa xem Bảng I, VI, VII và Hình 1–4.
- Đọc ngày 2026-10-30: S4, bản PDF 12 trang (bản IEEE đã xuất bản) trên trang Microsoft Research
  (đường dẫn ở mục 3.3); SHA-256 của tệp
  `c96abd7fd662b76c54d2bee89b118ebf238951c387dc84b5164066ad1de3b8ba`. Phần chữ được trích bằng
  PyMuPDF. Bảng và hình không trích được thành chữ, nên trợ lý xem dưới dạng ảnh dựng từ PDF: xem
  kỹ Bảng I–VII và Hình 1, 3–7; chưa xem Hình 2 (ví dụ dạng sóng) và chưa đọc kỹ danh mục tài liệu
  tham khảo.
- Ngoài bài báo: bản ghi dataset Aurora-BP trên Zenodo (phần mô tả và danh sách tệp; chưa đọc tệp
  Data Use Agreement).

**Các nguồn bị chặn** (ghi rõ là bị chặn, không ghi là "không tìm thấy"):

- N6 là bài truy cập mở dạng hybrid. Crossref ghi giấy phép CC BY 4.0 cho bản đã xuất bản; Europe
  PMC có PMID 37204948 nhưng không có PMCID. Cả hai đường tải đều bị chặn:
  - ieeexplore.ieee.org trả HTTP 418 cho truy cập tự động, và trình duyệt trong app hai lần không
    mở được trang IEEE;
  - kho CityU Scholars có bản "Final Published version" (CC BY), nhưng tệp PDF nằm sau trang kiểm
    tra của Cloudflare: truy cập tự động bị trả 403, còn trình duyệt trong app hiện ô "Verify you
    are human". Trợ lý không vượt qua bước kiểm tra này.
  - Ngày 2026-10-30 nhóm tải thủ công bằng trình duyệt thường (xem danh sách bài đã mở ở trên).
- S4: bản trên IEEE có phí. Crossref chỉ có giấy phép IEEE; Europe PMC có PMID 35201992 nhưng
  không có PMCID; ngày 2026-10-29 trang publication của Microsoft Research trả HTTP 403, nên nhóm
  quyết định chỉ dùng abstract. Ngày 2026-10-30 trang này mở được và có bản PDF tải tự do; trợ lý
  đã đọc toàn văn (danh sách bài đã mở ở trên).
- Europe PMC `fullTextXML` trả HTTP 500 với PMC8221527, PMC12331212 và PMC9154072; các bài này
  được đọc thay qua BioC hoặc trang PMC. BioC không có N8 vì bài nằm ngoài tập truy cập mở.
- Trang item của ETH Research Collection trả HTTP 500; văn bản được lấy qua REST API của kho.
- Semantic Scholar API trả HTTP 429, nên không lấy được abstract của He 2022 và Li Y 2026 (mục
  6.1).
- Toàn văn đóng, không thử vượt: N19, N20, N28, N31, N37 và ba bài thiếu abstract ở mục 6.1.

**Có dừng sớm không:** phần tìm và sàng lọc tiêu đề không dừng sớm; mọi bản ghi của 32 truy vấn
đều đã được tải và đọc tiêu đề. Các bước sau thì có giới hạn: chỉ đọc abstract của 196 bản ghi,
đọc toàn văn 5 bài (thêm N6 ngày 2026-10-30) và một phần của 3 bài. Bản ghi bị loại ở bước tiêu đề thì không được đọc
abstract.

**Chưa tra:** IEEE Xplore, Scopus, Web of Science, Embase, Google Scholar và CNKI; các bài ngoài
giai đoạn 2022–2026 (trừ tập bài trích dẫn); tài liệu không viết bằng tiếng Anh (vài bản ghi tiếng
Bồ Đào Nha, Nga, Đức trong OpenAlex chỉ được sàng lọc qua tiêu đề). OpenAlex không có abstract
của một số nhà xuất bản, nên cách tìm theo `title_and_abstract` có thể bỏ sót bài. Không tìm thấy
một bài không có nghĩa là bài đó không tồn tại.

## 3. Bảng nguồn

**Bảng 3. Các nguồn N1–N42.**

| Mã | Trích dẫn | DOI | Thiết kế (theo nguồn) | Liên quan tới RQ1 | Mức đã đọc |
| --- | --- | --- | --- | --- | --- |
| **N1** | Finnegan E, Davidson SM, Harford M, Watkinson P, Tarassenko L, Villarroel M. Features from the photoplethysmogram and the electrocardiogram for estimating changes in blood pressure. *Sci Rep* 2023 | [10.1038/s41598-022-27170-2](https://doi.org/10.1038/s41598-022-27170-2) | 30 người khỏe, tuổi 28,0 (9,0), phân tích 26 người. Truyền phenylephrine tĩnh mạch; PPG ở ngón tay, ECG ở ngực; đo cuff mỗi phút; **một buổi** khoảng 28 phút. Có baseline zero-change và LOSO lồng. So bốn bộ đặc trưng: PPG, ECG, PPG + ECG và PAT. MAE của ΔSBP (median qua các fold): zero-change 7,40; RF với PPG 4,75; LASSO + OLS với PAT 4,91 mmHg | **Gần nhất về cách đánh giá.** Khác nhóm ở chỗ: chỉ một buổi, dùng thuốc thay vì nghiệm pháp, PPG ở ngón tay, và không có mô hình PPG + PAT. Tác giả nêu hướng tiếp theo là thu dữ liệu dọc theo thời gian ở từng người | Toàn văn (Europe PMC), đọc 200.000/272.331 ký tự; chưa đọc kết quả ΔDBP ở phụ lục |
| **N2** | Natarajan K et al. (8 tác giả). Photoplethysmography fast upstroke time intervals can be useful features for cuff-less measurement of blood pressure changes in humans. *IEEE Trans Biomed Eng* (online 2021) | [10.1109/tbme.2021.3087105](https://doi.org/10.1109/tbme.2021.3087105) | 32 người (25% tăng huyết áp, tuổi 52). Nghiệm pháp: thở chậm, tính nhẩm, ngâm lạnh, nitroglycerin. Đo PPG ở ngón tay, ngón chân, tai cùng ECG; cuff thủ công; một quy trình trong phòng thí nghiệm. Baseline "không đổi" có RMSE 10,9/6,5 mmHg; đặc trưng sườn lên của PPG cộng với PAT làm RMSE của SBP giảm 6–7% (9,5 mmHg) | Gần nhóm về nghiệm pháp và về việc so PPG với PAT. Khác: chỉ một buổi, không đo ở cổ tay (tác giả ghi tín hiệu cổ tay ít hữu ích). Bài ghi nhận dạng sóng PPG chịu ảnh hưởng của áp lực tiếp xúc nhiều hơn PAT. Cùng cohort với N3 và N18 | Toàn văn (PMC), đọc một lượt |
| **N3** | Block RC et al. (13 tác giả). Conventional pulse transit times as markers of blood pressure changes in humans. *Sci Rep* 2020 | [10.1038/s41598-020-73143-8](https://doi.org/10.1038/s41598-020-73143-8) | Cùng cohort với N2 (32/44 người). So sáu khoảng PAT/PTT: PAT ngón chân tương quan với SBP tốt nhất (r −0,63 ± 0,05), PAT ngón tay tương quan kém | Cơ sở cho nhận định PAT phụ thuộc vị trí đo và PEP; chỉ một buổi | Toàn văn (Europe PMC), đọc một lượt |
| **N4** | Ding X, Yan BP, Zhang YT, Liu J, Zhao N, Tsang HK. Pulse transit time based continuous cuffless blood pressure estimation: a new extension and a comprehensive evaluation. *Sci Rep* 2017 | [10.1038/s41598-017-11507-3](https://doi.org/10.1038/s41598-017-11507-3) | 33 người (14 tăng huyết áp); dùng PTT và PIR, tham chiếu Finapres; nghiệm pháp đứng dậy, thở sâu, Valsalva, bóp tay; theo dõi 24 giờ ở một nhóm nhỏ. Sang ngày thứ 2, sai số tăng ở mọi phương pháp | Bằng chứng cho thấy sai số tăng khi đánh giá vào ngày hôm sau; phần đã đọc không có baseline chỉ hiệu chuẩn | Toàn văn (Europe PMC), đọc 100.000/137.802 ký tự |
| **N5** | Ganti VG et al. (6 tác giả). Wearable cuff-less blood pressure estimation at home via pulse transit time. *IEEE J Biomed Health Inform* (online 2020) | [10.1109/jbhi.2020.3021532](https://doi.org/10.1109/jbhi.2020.3021532) | Đồng hồ SeismoWatch 2.0 gồm: ECG một đạo trình (ngón tay bàn tay kia chạm điện cực trên dây đeo), SCG ba trục (áp đồng hồ lên giữa xương ức) và PPG cổ tay nhiều bước sóng. PTT tính từ lúc van động mạch chủ mở (trên SCG) tới chân sóng PPG cổ tay (hồng ngoại); ECG chỉ dùng để tách nhịp. 21 người khỏe (25,9 ± 3,4 tuổi) đo tại nhà mỗi giờ trong 24 giờ, cuff Omron BP785N; dùng 216/245 lần đo. Hồi quy tuyến tính theo từng người trên dữ liệu 24 giờ: RMSE DBP/MAP/SBP 2,72/2,99/4,75 mmHg, r 0,69/0,61/0,33. Hiệu chuẩn một điểm (giữ nguyên một giá trị DBP) cho RMSE 6,05 ± 1,75 mmHg; 4 điểm 4,73 ± 2,41; 6 điểm 3,83 ± 1,40 mmHg | Chỉ trong cùng một ngày (24 giờ), không có phiên khác ngày. Không so PPG-only với PAT, vì bài đo PTT thật chứ không dùng PAT. Phải áp đồng hồ lên ngực nên không thuần cổ tay. Tác giả ghi rằng cần đánh giá đường hiệu chuẩn qua nhiều ngày. Phép hiệu chuẩn một điểm của bài tương tự baseline zero-change, nhưng các mô hình PTT được ước lượng trên chính dữ liệu cùng ngày | Toàn văn (BioC, PMC8221527), 2026-10-29 |
| **N6** | Liu ZD, Li Y, Zhang YT, Zeng J, Chen ZX, Cui ZW, Liu JK, Miao F. Cuffless blood pressure measurement using smartwatches: a large-scale validation study. *IEEE J Biomed Health Inform* 2023;27(9):4216–4227 | [10.1109/jbhi.2023.3278168](https://doi.org/10.1109/jbhi.2023.3278168) | 3.077 người (18–75 tuổi, 65,16% nữ, 35,91% tăng huyết áp); **không có nghiệm pháp** tạo ΔBP. Mỗi người đo 4 ngày D, D+7, D+14, D+21, mỗi ngày 3 lần ghi 2 phút cách nhau 5 phút (dùng 29.568/30.294 lần ghi). Đồng hồ nguyên mẫu của Huawei: ECG (hai điện cực mặt sau đồng hồ ở cổ tay trái, điện cực thứ ba do ngón cái tay phải chạm), PPG bốn bước sóng do **ngón trỏ tay phải** ấn lên cảm biến, sóng áp lực mạch (PPW, áp điện) ở động mạch quay. Tham chiếu: hai người đo nghe tim, mù nhau, lấy trung bình trước và sau mỗi lần ghi. Mô hình: ba công thức "PTT" theo cách gọi của bài: (1) và (2) dùng PTT_RM1 = từ đỉnh R tới điểm dốc nhất của PPG, tức PAT theo quy ước dự án, nhưng ở (2) DBP tính từ PIR; (3) dùng "arteriolar PTT", độ trễ giữa đỉnh hai sóng PPG, không có ECG (mục II.D, Hình 3(b); sửa 2026-11-07); ridge, SVM, AdaBoost, RF với đặc trưng PAT, hình thái PPG/PPW và nhân khẩu học (tuổi, giới, BMI, tiền sử tăng huyết áp); bốn mạng học sâu. Không hiệu chuẩn: 5-fold CV, chia ngẫu nhiên **theo người**. Có hiệu chuẩn: f_cal = (1 − α)·f_uncal + α·BP nền, BP nền là trung bình BP ngày D, α = 0,6 là giá trị cho sai số nhỏ nhất của chính các mô hình được báo cáo (Hình A1); mô hình PTT hiệu chuẩn theo từng người bằng dữ liệu ngày D rồi dự đoán các ngày sau. Baseline có hiệu chuẩn: AdaBoost với BP ban đầu + nhân khẩu học; baseline không hiệu chuẩn: AdaBoost chỉ với nhân khẩu học. Bảng IV, MAE SBP/DBP (mmHg): baseline có hiệu chuẩn 8,46/5,78; ba mô hình PTT 9,20–9,26/6,59–6,78; tốt nhất 7,38 (AdaBoost)/5,13 (SVM). Không hiệu chuẩn: baseline 12,19/8,04; tốt nhất 9,67/6,80. Hình 6 (chỉ SBP): MAE thấp hơn baseline ở mọi nhóm con, ví dụ tăng huyết áp độ 1 là 8,10 so với 9,64; không có CI hay kiểm định. Bảng A2 (chỉ AdaBoost không hiệu chuẩn, chỉ SBP, trung bình ± SD sai số tuyệt đối): PPG hồng ngoại 9,99 ± 8,85; ECG + PPG hồng ngoại 9,90 ± 8,78; ECG + PPG + PPW 9,67 ± 8,58. Hình 8 chỉ kiểm định các cặp với ECG + PPG + PPW (p < 0,05 so với PPG hồng ngoại, PPG bốn bước sóng, PPW, ECG + PPW); cặp PPG với ECG + PPG không được kiểm định. Mục IV.C: sai số tăng từ D+7 sang D+14 rồi ổn định tới D+21; \|ΔBP\| so với ngày D theo cùng xu hướng (Hình 5) | **Không có phép so sánh ghép cặp PPG-only với PPG + PAT sau hiệu chuẩn (chờ thầy xem).** So tổ hợp tín hiệu chỉ có ở mô hình không hiệu chuẩn, chỉ SBP, gộp mọi lần đo; bài không nói các tổ hợp có kèm nhân khẩu học không. Baseline có hiệu chuẩn là mô hình học từ BP ban đầu + nhân khẩu học, không phải zero-change, và hiệu chuẩn khác mô hình (trộn cố định theo α), nên chênh lệch với baseline không chỉ do tín hiệu (suy luận của trợ lý). Mô hình PTT (PAT) có hiệu chuẩn kém hơn baseline ở cả SBP và DBP. \|ΔBP\| so với BP nền ngày D ở Hình 5(c)(d) chính là sai số của dự đoán zero-change (suy luận của trợ lý), nhưng bài không so nó với sai số mô hình. **Lời văn lệch với hình:** các số ở mục IV.C (SBP 7,41 ± 6,43; 9,07 ± 7,24; 9,31 ± 7,31 mmHg ở D+7, D+14, D+21), được gọi là sai số ước lượng, khớp với cột \|ΔSBP\| ở Hình 5(c); cột sai số ở Hình 5(a) thấp hơn, khoảng 7,0; 7,6; 7,7 mmHg (trợ lý đo chiều cao cột trên ảnh, sai khoảng ±0,1 mmHg). DBP cũng vậy: Hình 5(b) khoảng 4,9; 5,6; 5,5, còn Hình 5(d) và lời văn khoảng 5,0; 6,3; 6,2. Trung bình các cột ở Hình 5(a) gần MAE 7,38 của mô hình tốt nhất ở Bảng IV, còn trung bình ở Hình 5(c) gần MAE 8,46 của baseline, nên nhiều khả năng lời văn ghi nhầm số của \|ΔBP\| (suy luận của trợ lý, chưa hỏi tác giả). Bài không ghi mô hình nào được vẽ ở Hình 5. Khác RQ1: PPG ở ngón tay và ECG cần ngón cái tay kia, nên thiết bị không thuần cổ tay; không có nghiệm pháp; không có CI theo người. α được chọn theo sai số của chính các mô hình được báo cáo, khớp với lo ngại rò rỉ của N8. Dataset CAS-BP: phần 1 (1.272 người) cấp theo yêu cầu gửi tác giả liên hệ, kèm Data Use Agreement có điều khoản không ghép với nguồn dữ liệu khác; phần 2 (1.805 người) không công khai (README của kho GitHub zdzdliu/CAS-BP, đọc 2026-10-30) | Toàn văn (PDF bản đã xuất bản, CC BY 4.0, do nhóm tải thủ công), đọc ngày 2026-10-30; mức xem từng bảng và hình ghi ở mục 2.2 |
| **N7** | Hove C et al. (10 tác giả). A prototype photoplethysmography-based cuffless device shows promising results in tracking changes in blood pressure. *Front Med Technol* 2024 | [10.3389/fmedt.2024.1464473](https://doi.org/10.3389/fmedt.2024.1464473) | Nguyên mẫu chỉ có PPG (Aidee Health), đặt ở **cánh tay trên** bên trái. Tuyển 67 người, phân tích 38 (29 người bị loại do nhiễu tín hiệu tham chiếu), tuổi trung vị 33. Nghiệm pháp: bóp tay tĩnh ở 30% MVC, tính nhẩm trừ 13 trong 5 phút, ngâm tay vào nước đá 2 phút. Tham chiếu là thiết bị kẹp ngón tay (Nexfin hoặc Human NIBP), hiệu chuẩn lại trước mỗi hoạt động; thiết bị nghiên cứu hiệu chuẩn offset một lần lúc nghỉ đầu buổi. Mô hình được xây trên chính cohort bằng 3-fold CV, rồi lấy trung bình ba mô hình. Theo ISO 81060-3: Accuracy 0,3 (8,7)/0,04 (6,6) mmHg (SBP/DBP); Stability (11 người đo lại bóp tay vào ngày hôm sau) 1,9 (9,2)/2,9 (8,1); Change ở bách phân vị 50/85: 39/56% (SBP), 32/48% (DBP) | Nghiệm pháp gần với protocol của nhóm. Có đo lại vào ngày hôm sau ở 11 người, nhưng chỉ có PPG, không có baseline chỉ hiệu chuẩn và không đo ở cổ tay. Phần đã đọc không nói rõ dự đoán cho mỗi người có dùng mô hình không được học từ chính người đó hay không | Toàn văn (Europe PMC XML, PMC11532190), 2026-10-29 |
| **N8** | Mukkamala R, Shroff SG, Kyriakoulis KG, Avolio AP, Stergiou GS. Cuffless blood pressure measurement: where do we actually stand? *Hypertension* 2025 | [10.1161/hypertensionaha.125.24822](https://doi.org/10.1161/hypertensionaha.125.24822) | Tổng quan. Các ý chính của tác giả: dữ liệu Aurora cho thấy phân tích bằng học máy sóng tonometry, PPG cổ tay và ECG không thêm giá trị so với baseline dựa trên BP hiệu chuẩn và thời điểm trong ngày; các nghiên cứu lớn gần đây (gồm N6, N20) có so với baseline nhưng có nguy cơ rò rỉ dữ liệu; thiết bị Aktiia và Samsung cho giá trị gần BP hiệu chuẩn (N23, N24); kiểm tra ngay sau hiệu chuẩn không cho thông tin gì; áp lực tiếp xúc làm đổi biên độ và hình dạng PPG. Kết luận của bài: chưa có bằng chứng thuyết phục rằng phân tích dạng sóng và PAT thêm được giá trị đáng kể ngoài cuff hiệu chuẩn hoặc thông tin nhân khẩu học; nên giữ thái độ hoài nghi, trừ khi có thử nghiệm độc lập, tiến cứu, so sánh chặt với baseline model hoặc thử nghiệm ngẫu nhiên | Khung định vị chính cho RQ1. Ba điều kiện "đáng xem xét" mà tác giả nêu là những tiêu chí người phản biện có thể đặt ra. Tác giả khai có tài trợ của NIH và thỏa thuận nghiên cứu với Apple | Toàn văn (trang PMC12331212), trừ phụ lục và hình, 2026-10-29 |
| **N9** | Finnegan E et al. (8 tác giả). Pulse arrival time as a surrogate of blood pressure. *Sci Rep* 2021 | [10.1038/s41598-021-01358-4](https://doi.org/10.1038/s41598-021-01358-4) | 30 người khỏe, mỗi buổi khoảng 28 phút, truyền phenylephrine. PEP tăng 5,5 ± 4,5 ms so với nền, trong khi PTT thay đổi nhiều hơn (−16,8 ± 7,5 ms theo abstract); so các mô hình dựa trên PAT và trên PTT | Cơ sở về PAT cho N1. PEP ít đổi khi dùng phenylephrine, khác với khi làm nghiệm pháp gây stress (N11) | Abstract (Europe PMC) |
| **N10** | Kaetheeswaran J, Ma B, Abedi A, Khan SS, Lankarany M. Calibration-free cuffless blood pressure estimation using multimodal ECG-PPG fusion on a Google Pixel Watch. arXiv:2608.26325, 2026 | [arXiv:2608.26325](https://arxiv.org/abs/2608.26325) | 40 người, đồng hồ thương mại; kết hợp ECG, PPG và nhân khẩu học, không hiệu chuẩn | Đi theo hướng không hiệu chuẩn, khác RQ1; preprint chưa qua phản biện. Dữ liệu có thể là N42 | Abstract |
| **N11** | Pilz N, Patzak A, Bothe TL. The pre-ejection period is a highly stress dependent parameter of paramount importance for pulse-wave-velocity based applications. *Front Cardiovasc Med* 2023 | [10.3389/fcvm.2023.1138356](https://doi.org/10.3389/fcvm.2023.1138356) | 71 người trẻ; PEP đo bằng impedance cardiography lúc nghỉ, khi stress tinh thần (TSST) và khi gắng sức (ergometer). PEP lúc nghỉ trung bình 104,5 ms, khác nhau nhiều giữa người nhưng ít thay đổi trong cùng một người. Stress tinh thần làm PEP giảm 16% (còn 90,0 ms); gắng sức làm PEP giảm một nửa (còn 53,9 ms) | Bằng chứng trực tiếp cho rủi ro PEP ở M2 (tính nhẩm) của RQ1, và ở M4 (đạp xe) trước khi M4 bị bỏ ngày 2026-10-29: PAT có thể ngắn lại vì PEP giảm | Abstract (PubMed) |
| **N12** | Charlton PH, Marozas V, Mejía-Mejía E, Kyriacou PA, Mant J. Determinants of photoplethysmography signal quality at the wrist. *PLOS Digit Health* 2025 | [10.1371/journal.pdig.0000585](https://doi.org/10.1371/journal.pdig.0000585) | PPG cổ tay của 1.142 người trong Aurora-BP, đánh giá bằng SNR, perfusion index và TMCC. Chất lượng cao nhất khi nằm ngửa. Khi ngồi: tay buông dọc thân 10,5 dB, tay đặt trên đùi 13,7 dB, cảm biến ngang tim 15,5 dB. SNR và TMCC tăng theo tuổi | Tư thế tay và độ cao của cảm biến làm đổi chất lượng PPG cổ tay, nên cần cố định tư thế tay giữa các phiên; liên quan tới SQI (RQ3) | Abstract |
| **N13** | Sirkiä JP, Panula T, Kaisti M. Investigating the impact of contact pressure on photoplethysmograms. *Biomed Eng Adv* 2024 | [10.1016/j.bea.2024.100123](https://doi.org/10.1016/j.bea.2024.100123) | Thiết bị dạng cuff ở ngón tay đo PPG đa phổ ở nhiều mức áp lực tiếp xúc. SpO2, PAT và các đặc trưng PPG đều đổi theo áp lực; PAT tính từ chân sóng của kênh đỏ và hồng ngoại ổn định nhất; áp lực từ khoảng 20–30 mmHg tới mức DBP cho đặc trưng tốt nhất | Liên quan rủi ro áp lực tiếp xúc của RQ1 (RQ mục 4.F): ở ngón tay, đặc trưng PPG nhạy với áp lực hơn PAT tính từ chân sóng | Abstract (OpenAlex) |
| **N14** | Cheung MY, Sabharwal A, Coté GL, Veeraraghavan A. Wearable blood pressure monitoring devices: understanding heterogeneity in design and evaluation. *IEEE Trans Biomed Eng* 2024 | [10.1109/tbme.2024.3434344](https://doi.org/10.1109/tbme.2024.3434344) | Chưa đọc | Theo tiêu đề: cách thiết kế và báo cáo đánh giá thiết bị đo BP đeo được | Chỉ metadata |
| **N15** | Elgendi M et al. (7 tác giả). Recommendations for evaluating photoplethysmography-based algorithms for blood pressure assessment. *Commun Med* 2024 | [10.1038/s43856-024-00555-2](https://doi.org/10.1038/s43856-024-00555-2) | Chưa đọc | Theo tiêu đề: có thể dùng làm danh mục kiểm khi viết phần đánh giá | Chỉ metadata |
| **N16** | Cisnal A, Li Y, Fuchs B, Ejtehadi M, Riener R, Paez-Granados D. Robust feature selection for BP estimation in multiple populations: towards cuffless ambulatory BP monitoring. *IEEE J Biomed Health Inform* 2024 | [10.1109/jbhi.2024.3411693](https://doi.org/10.1109/jbhi.2024.3411693) | Nhánh oscillometric của Aurora-BP (khám tại phòng và 24 giờ lưu động): từ 548 còn 523 người, trung bình 23,9 lần đo mỗi người sau xử lý. PPG cổ tay (cảm biến dựa trên MAX30101, đeo ở tay đối diện với cuff), đoạn 30 s, 500 Hz. Đầu vào chỉ gồm PPG và nhân khẩu học, trong đó SBP/DBP lúc nghỉ cũng là đặc trưng. Chọn đặc trưng bằng Markov blanket trên toàn bộ dữ liệu; mô hình Gradient Boosting; CV lồng (vòng ngoài bỏ một người, vòng trong 10-fold). MAE 10,29/6,74 mmHg (SBP/DBP); tại phòng khám 8,49/5,03, lưu động 11,35/7,85 | Không có ECG hay PAT, và trong phần đã đọc không so với baseline chỉ dùng BP lúc nghỉ, nên không thu hẹp khoảng trống của RQ1. Việc chọn đặc trưng trên toàn bộ dữ liệu trước khi CV (tác giả thừa nhận có thể gây thiên lệch) là cách làm cần tránh. Aurora dùng cảm biến dựa trên MAX30101, giống thiết bị của nhóm; ETH dùng dữ liệu theo thỏa thuận chuyển giao với Microsoft | Toàn văn bản chấp nhận (ETH Research Collection, hdl 20.500.11850/677790), văn bản trích tự động, không xem hình, 2026-10-29 |
| **N17** | Min S et al. (12 tác giả). Wearable blood pressure sensors for cardiovascular monitoring and machine learning algorithms for blood pressure estimation. *Nat Rev Cardiol* 2025 | [10.1038/s41569-025-01127-0](https://doi.org/10.1038/s41569-025-01127-0) | Tổng quan, chưa đọc | Theo tiêu đề: bối cảnh cho phần Introduction | Chỉ metadata |
| **N18** | Yavarimanesh M, Block RC, Natarajan K, … Mukkamala R (7 tác giả). Assessment of calibration models for cuff-less blood pressure measurement after one year of aging. *IEEE Trans Biomed Eng* 2022;69(6):2087–2093 (online 2021) | [10.1109/tbme.2021.3136492](https://doi.org/10.1109/tbme.2021.3136492) | Cùng cohort với N2/N3: thu lại dữ liệu ở 13/32 người, ba phiên cách nhau khoảng 1 năm (10–14 tháng); phân tích 10 người (6 nam, 57 ± 18 tuổi, 3 người tăng huyết áp). Phiên đầu chỉ để làm quen; mô hình lập ở phiên 2 và đánh giá ở phiên 3. Mỗi phiên ghi ECG, PPG ở tai, ngón tay, ngón chân và cuff nghe tim thủ công, trước và sau các nghiệm pháp thở chậm, tính nhẩm, ngâm lạnh (chân phải), thường có thêm nitroglycerin. Có bốn mô hình tuyến tính, hệ số riêng cho từng người, lập từ mọi nghiệm pháp của một phiên: PAT ngón chân → SBP; PAT ngón tay + b-time → SBP; PAT tai + STT → SBP; STT + PW ở tai (chỉ PPG) → DBP. Baseline "naïve" là trung bình các lần cuff ban đầu của người đó. Sau 1 năm, khi đã bỏ giá trị ngoại lai, RMSE của PAT ngón chân là 9,6 ± 0,8 so với 12,7 ± 1,0 mmHg của naïve (p < 0,05); PAT ngón tay + b-time 10,3 ± 1,2 (p = 0,12); PAT tai + STT 11,9 ± 1,2; mô hình chỉ PPG cho DBP 7,3 ± 0,7 so với naïve 4,8 ± 0,3, tức kém hơn naïve. Lập mô hình từ 1–3 nghiệm pháp cho RMSE 18,1–48,1 mmHg (chưa bỏ ngoại lai) | **Làm thay đổi khoảng trống (mục 5).** Đã có đánh giá qua nhiều phiên (cách nhau 1 năm) cho mô hình có PAT và mô hình chỉ dùng đặc trưng PPG, so với baseline chỉ dùng cuff hiệu chuẩn, với các nghiệm pháp gần M1, M2 (và M3 trước khi bị bỏ ngày 2026-10-29). Khác RQ1 ở chỗ: không đo ở cổ tay; hiệu chuẩn nhiều điểm cho từng người bằng cả bộ nghiệm pháp, không chỉ là offset từ M0; các phiên cách nhau 1 năm chứ không phải vài ngày đến 4 tuần; không có phép so sánh ghép cặp (ablation) PPG-only với PPG + PAT trên cùng một đầu ra; chỉ 10 người. Tác giả ước tính cần 31 người để mô hình ngón tay vượt naïve có ý nghĩa (α 0,05, power 0,8). Tác giả cho rằng PAT ở tai và ngón tay cho kết quả kém chủ yếu do co cơ trơn thành mạch, còn PEP chỉ là yếu tố phụ | Toàn văn (BioC, PMC9154072), 2026-10-29 |
| **N19** | Cisnal A, Paez-Granados D, Pérez Turiel J, Fraile JC. Are PAT-based models suitable for continuous blood pressure monitoring in ambulatory settings? *Proc IEEE CBMS* 2025:1–6 | [10.1109/cbms65348.2025.00046](https://doi.org/10.1109/cbms65348.2025.00046) | Dữ liệu Aurora-BP, 307 người, điều kiện lưu động; mô hình dựa trên PAT tính từ ECG và PPG của thiết bị mang theo. MAE tốt nhất 14,23 (SBP) và 9,67 mmHg (DBP). "Baseline models" tốt hơn mô hình PAT tốt nhất ở SBP (MAE 13,04 mmHg) và tương đương ở DBP | Bằng chứng gần nhất về PAT so với baseline trên dữ liệu cổ tay lưu động. Abstract không nói baseline gồm những gì, không nhắc tới mô hình PPG-only hay PPG + PAT, cũng không nhắc tới đánh giá ở phiên khác ngày; chưa thể xác nhận các điểm này khi chưa có toàn văn | Abstract (Semantic Scholar); toàn văn đóng |
| **N20** | Liu ZD, Li Y, Zhang YT, … Miao F (7 tác giả). HGCTNet: handcrafted feature-guided CNN and transformer network for wearable cuffless blood pressure measurement. *IEEE J Biomed Health Inform* 2024;28(7):3882–3894 | [10.1109/jbhi.2024.3395445](https://doi.org/10.1109/jbhi.2024.3395445) | Mô hình học sâu kết hợp đặc trưng thủ công từ sinh hiệu do thiết bị đeo đo và thông tin nhân khẩu học; dùng hai bộ dữ liệu CAS-BP và Aurora-BP. Sai số SBP/DBP: CAS-BP 0,7 ± 8,3/0,9 ± 6,5 mmHg; Aurora-BP −0,4 ± 8,6/−0,4 ± 7,0 mmHg. Theo N8, bài phân tích một tập con dữ liệu của N6 cùng dữ liệu Aurora, có so với baseline model (Bảng IV) và so nhiều phương pháp trên dữ liệu test | Cùng nhóm tác giả với N6; là một trong các bài "tốt hơn baseline 0–3 mmHg" mà N8 cho là có nguy cơ rò rỉ dữ liệu. Abstract không cho biết bài có tách PPG-only với PPG + PAT hay có đánh giá ở phiên khác ngày không | Abstract; nội dung về baseline lấy từ N8; toàn văn đóng |
| **N21** | Huang H et al. (9 tác giả). RAGCBPNet: an efficient feature fusion framework for wearable cuffless blood pressure monitoring and long-term validation in real-world settings. *medRxiv* 2025 (preprint) | [10.1101/2025.10.30.25339198](https://doi.org/10.1101/2025.10.30.25339198) | Kết hợp đặc trưng PPG thủ công và học sâu với thông tin nhân khẩu học; dùng Aurora-BP (MAE 7,08/4,90 mmHg) và một bộ dữ liệu đồng hồ đo từ 30 ngày trở lên trong sinh hoạt tự do. Theo abstract: một lần hiệu chuẩn ban đầu đủ để đạt chuẩn AAMI cho SBP tới 14 ngày và cho DBP trong suốt thời gian theo dõi; dự đoán biến thiên ít hơn rõ rệt so với BP tham chiếu | Theo dõi nhiều tuần sau hiệu chuẩn nhưng chỉ có PPG. Dự đoán biến thiên ít hơn tham chiếu là dấu hiệu đầu ra bám gần mốc hiệu chuẩn, đúng vấn đề N8 nêu. Abstract không nhắc ECG, PAT hay baseline chỉ hiệu chuẩn. Abstract ghi tên mô hình là "RACGBPNet", khác với tiêu đề | Abstract; preprint chưa phản biện |
| **N22** | Derendinger FC et al. (7 tác giả). Ability of a 24-h ambulatory cuffless blood pressure monitoring device to track blood pressure changes in clinical practice. *J Hypertens* 2024;42(4):662–671 | [10.1097/hjh.0000000000003667](https://doi.org/10.1097/hjh.0000000000003667) | 166 người đo đồng thời trong 24 giờ bằng Somnotouch-NIBP (ECG + PPG ngón tay; bài gọi là PTT, theo quy ước của dự án là PAT) và máy cuff lưu động; BP hiệu chuẩn là lần đo cuff đầu tiên. Chênh lệch trung bình (SD) giữa BP hiệu chuẩn và BP trung bình 24 giờ: với SBP, theo cuff là 7,4 (13,2), theo thiết bị không cuff là 1,8 (8,3) mmHg; với DBP là 6,6 (6,8) so với 1,6 (5,8). Mức BP thay đổi so với lúc hiệu chuẩn và sai số của thiết bị có quan hệ gần tuyến tính | Thiết bị dựa trên PAT cho đầu ra bám gần BP hiệu chuẩn, tức là hoạt động gần giống zero-change. Điều này củng cố yêu cầu báo SD của ΔBP tham chiếu và so với zero-change (RQ mục 4.D) | Abstract; đoạn Methods mô tả thiết bị (toàn văn PMC10906216, chưa đọc hết) |
| **N23** | Tan I et al. (8 tác giả). Evaluation of the ability of a commercially available cuffless wearable device to track blood pressure changes. *J Hypertens* 2023;41(6):1003–1010 | [10.1097/hjh.0000000000003428](https://doi.org/10.1097/hjh.0000000000003428) | Aktiia (PPG cổ tay); 41 người (80% tăng huyết áp) đeo 6–12 ngày, đo ABPM ở đầu và cuối đợt. Ở 3 người được tăng liều thuốc, mức giảm BP sau 2 tuần theo Aktiia là −1,0/−0,8 mmHg, trong khi đo tại nhà là −19,7/−11,5 mmHg. Thiết bị không theo được mức giảm BP về đêm | Theo dõi nhiều ngày nhưng chỉ có PPG, không có PAT. Là ví dụ về thiết bị không theo được thay đổi BP lớn sau khi hiệu chuẩn | Abstract (toàn văn PMC10158604 đã tải, chưa đọc) |
| **N24** | Falter M et al. (11 tác giả). Smartwatch-based blood pressure measurement demonstrates insufficient accuracy. *Front Cardiovasc Med* 2022;9:958212 | [10.3389/fcvm.2022.958212](https://doi.org/10.3389/fcvm.2022.958212) | 40 bệnh nhân đang đo ABPM 24 giờ đeo thêm Samsung Galaxy Watch Active 2 (PPG) đã hiệu chuẩn. Có sai lệch tỷ lệ: BP thấp bị ước lượng cao, BP cao bị ước lượng thấp. Tác giả kết luận đồng hồ lệch có hệ thống về phía điểm hiệu chuẩn; BP do đồng hồ đo biến thiên ít hơn ABPM | Đầu ra của thiết bị co về mốc hiệu chuẩn (24 giờ, chỉ PPG), nên baseline zero-change là đối chứng bắt buộc | Abstract |
| **N25** | Hametner B et al. (12 tác giả). Non-invasive pulse arrival time as a surrogate for oscillometric systolic blood pressure changes during non-pharmacological intervention. *Physiol Meas* 2024;45(5):055015 | [10.1088/1361-6579/ad45ab](https://doi.org/10.1088/1361-6579/ad45ab) | 51 người (31 nữ). Nhóm can thiệp làm nhiệm vụ thể lực và nhiệm vụ tinh thần (thứ tự đối trọng), có nhóm chứng. PAT đo bằng thiết bị cầm tay; BP đo oscillometric lúc nền và sau mỗi nhiệm vụ. Sau nhiệm vụ thể lực, HR và SBP tăng, PAT giảm. Với nhiệm vụ tinh thần, SBP giảm trong khi HR ổn định, còn PAT tăng. Tương quan giữa thay đổi SBP và PAT: từ nền sang thể lực −0,33; từ thể lực sang tinh thần −0,51; từ nền sang tinh thần −0,12 (không có ý nghĩa thống kê) | Gần với M2 của RQ1: từ nền sang nhiệm vụ tinh thần, tương quan giữa thay đổi PAT và thay đổi SBP không có ý nghĩa thống kê (r = −0,12); chỉ một buổi | Abstract |
| **N26** | Heimark S et al. (11 tác giả). Blood pressure altering method affects correlation with pulse arrival time. *Blood Press Monit* 2022;27(2):139–146 (online 2021) | [10.1097/mbp.0000000000000577](https://doi.org/10.1097/mbp.0000000000000577) | 75 người (43,7% tăng huyết áp); đai ngực nguyên mẫu có ECG một kênh và cảm biến PPG; BP đo bằng nghe tim; bài tập tĩnh và động. Tương quan PAT–SBP trong từng người: −0,82 ± 0,14 (toàn protocol), −0,79 ± 0,27 (bài tập tĩnh), −0,77 ± 0,19 (bài tập động). Tương quan PAT–DBP lần lượt là 0,25 ± 0,35, −0,74 ± 0,23 và 0,39 ± 0,41, tức đổi dấu theo loại bài tập | Quan hệ PAT–DBP phụ thuộc loại nghiệm pháp, nên ủng hộ việc phân tầng theo nghiệm pháp (RQ mục 4.B, 4.D); chỉ một buổi, không đo ở cổ tay | Abstract |
| **N27** | Heimark S et al. (12 tác giả). Accuracy and user acceptability of 24-hour ambulatory blood pressure monitoring by a prototype cuffless multi-sensor device compared to a conventional oscillometric device. *Blood Press* 2023;32(1):2274595 | [10.1080/08037051.2023.2274595](https://doi.org/10.1080/08037051.2023.2274595) | 95 người; thiết bị đa cảm biến đeo ở ngực (Aidee Health) tính PAT từ ECG và PPG; mô hình BP chung cho mọi người, dựa trên PAT; đối chiếu với ABPM 24 giờ. SBP ban ngày: tham chiếu 129,7 (13,8) so với PAT 133,6 (20,9) mmHg, LoA [−26,7; 34,6]; ban đêm 113,1 (16,5) so với 131,9 (23,4), LoA [−20,9; 58,4] | Mô hình PAT chung cho kết quả đồng thuận kém trong 24 giờ, nhất là ban đêm; abstract không nhắc PPG-only hay baseline chỉ hiệu chuẩn | Abstract |
| **N28** | Xie C et al. (6 tác giả). Effects of pulse transit time and pulse arrival time on cuff-less blood pressure estimation: a comparison study with multiple experimental interventions. *Proc IEEE EMBC* 2023:1–4 | [10.1109/embc40787.2023.10340548](https://doi.org/10.1109/embc40787.2023.10340548) | 55 người, nhiều can thiệp làm đổi BP và PEP. Bài so tương quan của BP với PTT và với PAT, và so năm mô hình ước lượng. PEP đổi nhanh khi có stress thể lực. PTT tương quan tuyến tính tốt hơn, nhưng phần lớn mô hình dựa trên PAT chính xác hơn mô hình dựa trên PTT ở mọi can thiệp, nhất là khi có hiệu chuẩn | PEP vừa gây nhiễu, vừa có thể mang thông tin có ích cho mô hình PAT; chỉ một buổi; abstract không nêu vị trí đo PPG | Abstract; toàn văn đóng |
| **N29** | Djupedal H et al. (5 tác giả). Effects of experimental hypovolemia and pain on pre-ejection period and pulse transit time in healthy volunteers. *Physiol Rep* 2022;10(12):e15355 | [10.14814/phy2.15355](https://doi.org/10.14814/phy2.15355) | 14 người khỏe; LBNP 60 mmHg và cold pressor (gây đau) theo thiết kế 2 × 2; PEP và PTT tính từ ECG, Doppler động mạch chủ lên và sóng áp lực đo bằng kẹp ngón tay. PEP tăng khi giảm thể tích tuần hoàn, không đổi khi đau; PTT giảm khi đau, tăng khi giảm thể tích tuần hoàn | Gần với M3 (ngâm lạnh, đã bỏ ngày 2026-10-29): trong nghiên cứu này, kích thích lạnh không làm đổi PEP mà làm đổi PTT; cỡ mẫu nhỏ, PTT không đo bằng PPG | Abstract |
| **N30** | Brinkmann K et al. (4 tác giả). A well-powered test of task difficulty effects on cardiovascular indicators of mental effort. *Int J Psychophysiol* 2026;225:113382 | [10.1016/j.ijpsycho.2026.113382](https://doi.org/10.1016/j.ijpsycho.2026.113382) | 114 người trẻ làm nhiệm vụ nhớ dãy số ở mức dễ và khó. Phản ứng của PEP, cung lượng tim, SBP, DBP và HR mạnh hơn ở nhiệm vụ khó; sức cản ngoại vi và HRV không khác nhau | Nhiệm vụ nhận thức làm PEP đổi theo độ khó, nên PAT ở M2 có thể đổi một phần do PEP; bài không đo PAT | Abstract |
| **N31** | Han M et al. (13 tác giả). Feasibility and measurement stability of smartwatch-based cuffless blood pressure monitoring: a real-world prospective observational study. *Hypertens Res* 2023;46(4):922–931 | [10.1038/s41440-023-01215-z](https://doi.org/10.1038/s41440-023-01215-z) | 760 người dùng Samsung Galaxy Watch (PPG) gửi dữ liệu trong 4 tuần sau hiệu chuẩn: 35.797 lần đo, trung bình 22 ± 4 ngày. Sai số trước–sau hiệu chuẩn của SBP (chênh lệch trung bình của 7 ngày trước và sau hiệu chuẩn) là 6,8 ± 5,6 mmHg, tăng khi SBP cao | Đánh giá ngoài đời thực trong nhiều tuần với thiết bị chỉ có PPG; không có tham chiếu ghép cặp, không có PAT | Abstract; toàn văn đóng |
| **N32** | van Vliet M et al. (12 tác giả). Assessment of photoplethysmography-based blood pressure determinations during long-term and short-term remote cardiac monitoring: the RECAMO study. *Eur Heart J Digit Health* 2025;6(4):763–771 | [10.1093/ehjdh/ztaf027](https://doi.org/10.1093/ehjdh/ztaf027) | Thiết bị PPG cổ tay hiệu chuẩn bằng cuff, dùng cho 150 bệnh nhân trong 28 ngày, so với ba lần đo tham chiếu tự động mỗi ngày. Đánh giá theo khuyến cáo ESH: nhu cầu hiệu chuẩn lại, thức–ngủ (ở 40 người có ABPM) và áp suất thủy tĩnh. Sai số trung bình trong 28 ngày là 3,84 (SD 4,46)/4,08 (3,97) mmHg; ngay trước lần hiệu chuẩn lại vào ngày 28 là 2,49 (3,10)/2,98 (3,48) | Đánh giá 4 tuần theo ESH với thiết bị chỉ có PPG; không có PAT, abstract không nhắc baseline chỉ hiệu chuẩn | Abstract (toàn văn PMC12282382 chưa đọc) |
| **N33** | Walzel S et al. (5 tác giả). Long-term accuracy and stability of blood pressure measurements from a smartwatch: prospective validation study. *Digit Health* 2026;12:20552076261415923 | [10.1177/20552076261415923](https://doi.org/10.1177/20552076261415923) | 37 người trong 28 ngày: hiệu chuẩn ở ngày 0, rồi đo ghép cặp Galaxy Watch 5 với Omron M4 trong 27 ngày liên tiếp; đánh giá theo tiêu chí ISO/IEEE và phép thử hiệu chuẩn lại của ESH. MD của SBP/DBP là −0,34/0,62 mmHg; độ trôi trong một chu kỳ hiệu chuẩn −0,19/1,02 mmHg; khi BP tham chiếu cách điểm hiệu chuẩn 10 mmHg, MD là 3,4 (SBP) và 5,1 mmHg (DBP) | Sai số tăng khi BP rời xa điểm hiệu chuẩn, cùng kiểu "bám mốc" như N22, N24; chỉ có PPG | Abstract |
| **N34** | Proença M et al. (7 tác giả). Long-term stability and blood pressure change tracking with a cuffless wearable device in hypertensive patients. *Blood Press* 2026;35(1):2707794 | [10.1080/08037051.2026.2707794](https://doi.org/10.1080/08037051.2026.2707794) | 30 bệnh nhân tăng huyết áp, 4 lần khám trong 6 tuần; thiết bị PPG đeo được (CSEM) so với Microlife WatchBP Home A. Chênh lệch ΔSBP 0,2 ± 12,8 và ΔDBP −0,1 ± 7,4 mmHg; không thấy trôi theo thời gian; với các thay đổi lớn, thiết bị cùng chiều với tham chiếu ở 83% (SBP) và 86% (DBP) trường hợp | Theo dõi ΔBP qua nhiều tuần (gần với endpoint của RQ1) nhưng chỉ có PPG; SD của chênh lệch ΔSBP lớn; abstract không nhắc baseline zero-change | Abstract |
| **N35** | Ho MY et al. (4 tác giả). WF-PPG: a wrist-finger dual-channel dataset for studying the impact of contact pressure on PPG morphology. *Sci Data* 2025;12:200 | [10.1038/s41597-025-04453-7](https://doi.org/10.1038/s41597-025-04453-7) | Dataset PPG cổ tay ghi ở nhiều mức áp lực tiếp xúc được chỉnh chính xác, kèm PPG ngón tay ghi đồng thời làm tham chiếu chất lượng, cùng áp lực tiếp xúc, ECG, BP và SpO2 | Có thể dùng để kiểm mức nhạy của đặc trưng PPG-only với áp lực tiếp xúc trước khi có dữ liệu người (RQ mục 4.F) | Abstract |
| **N36** | Pham HM et al. (6 tác giả). Reliable wrist PPG monitoring by mitigating poor skin sensor contact. *Sci Rep* 2025;15:45046 | [10.1038/s41598-025-31883-5](https://doi.org/10.1038/s41598-025-31883-5) | Tác giả cho rằng tiếp xúc da–cảm biến kém, ngay cả khi ngồi yên, làm méo hình thái PPG cổ tay (mất hoặc dịch các đặc trưng sóng). Bài đề xuất một mô hình sinh để đưa sóng méo về hình thái lý tưởng, và báo cải thiện ở các tác vụ HR, HRV, nhịp thở, BP | Xác nhận rủi ro: ngay trong điều kiện ngồi yên như protocol của nhóm, áp lực tiếp xúc vẫn làm đổi hình thái PPG cổ tay | Abstract |
| **N37** | McMurray JP et al. (6 tác giả). Multiwavelength photoplethysmography signal analysis as a function of varied wrist contact pressure. *Optical Diagnostics and Sensing: Toward Point-of-Care Diagnostics* (SPIE) 2023 | [10.1117/12.2649531](https://doi.org/10.1117/12.2649531) | Thay đổi áp lực tiếp xúc ở mặt lòng cổ tay, dọc động mạch quay, với ba bước sóng xanh lá, đỏ, hồng ngoại. Biên độ AC, DC, perfusion index và hình thái sóng khác biệt có ý nghĩa theo áp lực, và khác nhau giữa các bước sóng | Bằng chứng ở cổ tay cho rủi ro áp lực tiếp xúc (RQ mục 4.F) | Abstract (hội nghị); toàn văn đóng |
| **N38** | Yang C et al. (5 tác giả). Mechanical contact conditions in wearable reflectance photoplethysmography: scoping review. *JMIR Mhealth Uhealth* 2026;14:e99333 | [10.2196/99333](https://doi.org/10.2196/99333) | Scoping review (PubMed, IEEE Xplore, Scopus, Web of Science, tới 2026-06-01), gồm 21 nghiên cứu. Lực hoặc áp lực tiếp xúc đi kèm thay đổi của thành phần AC/DC, đặc trưng biên độ và hình thái; cách đo và báo cáo áp lực giữa các nghiên cứu rất khác nhau | Nguồn tổng hợp cho rủi ro áp lực tiếp xúc; gợi ý nên ghi lại điều kiện tiếp xúc ở mỗi phiên | Abstract |
| **N39** | Bustamante-Rodríguez JC et al. (4 tác giả). Wearable, cuffless, and portable devices for blood pressure monitoring (2015–2025): a scoping review of technologies, calibration, clinical validation, and regulatory frameworks. *Front Digit Health* 2026;8:1870156 | [10.3389/fdgth.2026.1870156](https://doi.org/10.3389/fdgth.2026.1870156) | Scoping review theo PRISMA-ScR, tìm trên PubMed/MEDLINE, Scopus, Web of Science, Embase; 63 nguồn (49 nghiên cứu gốc trên người, 33 về thiết bị không cuff). Theo tác giả, các khoảng trống còn lại là: độ ổn định sau hiệu chuẩn, điều kiện vận động, khi ngủ, khi đang điều trị, loạn nhịp và các nhóm đặc biệt | Tổng quan gần nhất xác nhận độ ổn định sau hiệu chuẩn vẫn là khoảng trống; cần xem bảng trích xuất của bài để tìm nghiên cứu ECG + PPG nhiều phiên | Abstract và các đoạn về phạm vi, số nguồn (PMC13506816) |
| **N40** | Cisnal A, Podder I, Grossmann L, … (7 tác giả). Towards trustworthy AI-driven cuffless blood pressure monitoring. *NPJ Digit Med* 2026;9 | [10.1038/s41746-026-02898-7](https://doi.org/10.1038/s41746-026-02898-7) | Systematic review; phân loại theo tín hiệu thay thế, kiểu mô hình và chiến lược hiệu chuẩn; đề xuất mẫu báo cáo kiểu "model card" (BP-Card). Theo tác giả, các rào cản là: protocol chưa sát thực tế, trôi hiệu chuẩn, quần thể chưa đa dạng. Bài khuyến nghị luôn báo baseline model (với cách có hiệu chuẩn thì là BP hiệu chuẩn của từng người), có dẫn các phân tích Aurora | Khung báo cáo có thể dùng cho bài của nhóm; cùng nhóm tác giả với N16, N19 | Abstract và các đoạn về baseline (PMC13669345) |
| **N41** | Torad MA et al. (6 tác giả). ESP32-S3-based multimodal wearable for remote vital-sign acquisition with ECG-to-PPG pulse-arrival-time tracking and functional cloud triage: an engineering proof of concept. *Sensors* 2026;26(19):6047 | [10.3390/s26196047](https://doi.org/10.3390/s26196047) | ESP32-S3 với AD8232 (ECG), MAX30102 (PPG/SpO2), MAX30205 (nhiệt độ); chạy FreeRTOS, ECG và PPG danh định 100 Hz. Khoảng từ sóng R tới chân sóng PPG được gọi đúng là PAT. Mới chỉ thử trên bàn và với kịch bản tổng hợp, chưa có dữ liệu người | Củng cố mục 5: lắp ESP32-S3 với module ECG + PPG để đo PAT không phải là điểm mới. Bài lấy mẫu 100 Hz, thấp hơn thiết kế của nhóm (ECG 512 sps, PPG 200 sps) | Abstract |
| **N42** | Kaetheeswaran J et al. (5 tác giả). HEART-Watch: a multimodal physiological dataset from a Google Pixel Watch across different physical states. *PLOS Digit Health* 2026;5(8):e0001647 | [10.1371/journal.pdig.0001647](https://doi.org/10.1371/journal.pdig.0001647) | ECG, PPG và gia tốc từ Pixel Watch ở 40 người khỏe khi ngồi, đứng và đi; ECG ngực làm tham chiếu; BP ở cánh tay đo ngắt quãng | Dataset công khai từ đồng hồ có ECG + PPG, cùng nhóm tác giả với N10; chỉ một buổi, không có cấu trúc nhiều phiên | Abstract |

S3 (bài tổng kết của Aurora) và S4 (Mieloszyk 2022, dataset Aurora-BP: 1.125 người, đồng hồ
PPG + ECG, tonometry, 24 giờ) trong [tổng quan 2026-10-14](literature_update_2026-10-14.md) vẫn là
nguồn lớn nhất về ECG + PPG cổ tay qua nhiều thời điểm. S4 được đọc toàn văn ngày 2026-10-30; kết
quả ở mục 3.3.

### 3.1. Các bài dùng dataset Aurora-BP (chủ đề T6)

Theo abstract (riêng N16 theo toàn văn), các bài 2022–2026 dưới đây dùng dữ liệu Aurora-BP:

- **So PAT hoặc các đặc trưng với baseline, hoặc đánh giá qua nhiều ngày:** N19 (mô hình PAT không
  vượt baseline ở SBP); N20 (có bảng so với baseline, theo N8); N21 (Aurora cộng dữ liệu đồng hồ
  từ 30 ngày trở lên); S7 (khoảng dự đoán conformal, 483 người).
- **Chỉ dùng PPG cổ tay:** N16 (chọn đặc trưng, PPG + nhân khẩu học); N12 (chất lượng PPG cổ tay);
  Dendorfer A, Charlton PH 2025, ECSA ([10.3390/ecsa-12-26556](https://doi.org/10.3390/ecsa-12-26556):
  năm lớp hình thái sóng PPG cổ tay ở 686 người); Liu D et al. 2026, bioRxiv
  ([10.64898/2026.08.19.745616](https://doi.org/10.64898/2026.08.19.745616): so PPG ở thái dương với
  PPG cổ tay theo tuổi).
- **Phân loại, sàng lọc hoặc mục đích khác:** Gon GK et al. 2024, JMIR Cardio
  ([10.2196/60238](https://doi.org/10.2196/60238): dự đoán tăng huyết áp bằng suy luận nhân quả,
  ECG + PPG); Huang ZX et al. 2025, JBHI ([10.1109/jbhi.2025.3640660](https://doi.org/10.1109/jbhi.2025.3640660):
  BpBLS, CAS-BP và Aurora-BP); Hong J et al. 2026, Eur Heart J Digit Health
  ([10.1093/ehjdh/ztag131](https://doi.org/10.1093/ehjdh/ztag131): sàng lọc tăng huyết áp dựa trên
  khác biệt thức–ngủ, 180 người); van den Brink WJ et al. 2026 (abstract hội nghị,
  [10.1093/ehjdh/ztaf143.155](https://doi.org/10.1093/ehjdh/ztaf143.155): biến thiên BP và hội chứng
  chuyển hóa); Msokar S et al. 2026, Preprints.org
  ([10.20944/preprints202610.1859.v1](https://doi.org/10.20944/preprints202610.1859.v1): phân loại
  nhóm BP trên nhiều dataset); Podder I et al. 2025, TechRxiv
  ([10.36227/techrxiv.175296041.12589238/v1](https://doi.org/10.36227/techrxiv.175296041.12589238/v1):
  tiền huấn luyện trên Aurora để ước lượng ΔSBP ở người tổn thương tủy sống); Aston PJ 2024, CinC
  ([10.22489/cinc.2024.038](https://doi.org/10.22489/cinc.2024.038): màu da và độ chính xác phân
  loại).

**Kết luận cho T6** (trong phạm vi các abstract đã đọc, cộng toàn văn S4): trong các bài ở trên,
chỉ N19 so mô hình dựa trên PAT với baseline. S4 (mục 3.3) có so nhóm đặc trưng chỉ PPG với nhóm
thêm rPAT và đặc trưng ECG ở buổi quay lại, đối chiếu với baseline zero và static, nhưng hai nhóm
khác nhau ở nhiều đặc trưng ECG chứ không riêng PAT, và không so ghép cặp theo người. Chưa thấy bài
nào trên Aurora-BP so ghép cặp PPG-only với PPG + PAT, đối chiếu với baseline chỉ hiệu chuẩn, ở ngày
hôm sau. Chưa loại trừ được N19 và N20 (chưa đọc toàn văn).

**Truy cập dữ liệu:** Aurora-BP có bản ghi mở trên Zenodo
([10.5281/zenodo.19099165](https://doi.org/10.5281/zenodo.19099165), tạo ngày 2026-03-18), kèm tệp
Data Use Agreement. Tổng dung lượng khoảng 6,7 GB: nhánh oscillometric 5,0 GB, nhánh nghe tim
1,6 GB, `features.tsv` 30 MB. Theo mô tả trên Zenodo, các điểm chính của Data Use Agreement là:
không phân phối lại; **không ghép với nguồn dữ liệu khác**; không định danh hay liên hệ người
tham gia; lưu trữ có kiểm soát truy cập; được công bố kết quả nếu không chứa thông tin mật của
Microsoft hay thông tin cá nhân; phải trích dẫn Aurora-BP Study. N16 dùng dữ liệu theo một thỏa
thuận chuyển giao riêng giữa Microsoft và ETH. Chưa đọc toàn văn tệp Data Use Agreement.

### 3.2. Bài giữ lại sau sàng lọc nhưng không thành dòng riêng

Các bài dưới đây đã được đọc abstract. Chúng liên quan tới đề tài nhưng không làm thay đổi khoảng
trống thêm so với các dòng N ở trên. DOI đã được kiểm qua OpenAlex ngày 2026-10-29.

- **T4/T5, thiết bị chỉ có PPG, theo dõi nhiều ngày:** Mekonnen BK et al. 2024, *Sci Rep*
  ([10.1038/s41598-024-75583-y](https://doi.org/10.1038/s41598-024-75583-y): PPG cá nhân hóa,
  theo dõi tới 30 ngày trở lên ở 15 người); Wang CF et al. 2023, *Biosensors*
  ([10.3390/bios13030321](https://doi.org/10.3390/bios13030321): PPG cánh tay trên, hiệu chuẩn một
  lần, 4 tuần); Lee Y et al. 2025, *Clin Hypertens*
  ([10.5646/ch.2025.31.e21](https://doi.org/10.5646/ch.2025.31.e21): Galaxy Watch 6, 896 người,
  chênh lệch trước–sau hiệu chuẩn 4,64 ± 4,73 mmHg ở SBP); Lee Y et al. 2023, EMBC
  ([10.1109/embc40787.2023.10340129](https://doi.org/10.1109/embc40787.2023.10340129)); Lee J et
  al. 2026, preprint JMIR ([10.2196/preprints.106980](https://doi.org/10.2196/preprints.106980):
  1.714 người dùng Galaxy Watch, 2021–2023); Wu W et al. 2025, BIBM
  ([10.1109/bibm66473.2025.11356894](https://doi.org/10.1109/bibm66473.2025.11356894): PPG 24 giờ,
  243 người, vẫn có trôi hiệu chuẩn); Hussein R et al. 2025, EMBC
  ([10.1109/embc58623.2025.11254768](https://doi.org/10.1109/embc58623.2025.11254768): tần suất hiệu
  chuẩn PPG); López-Jiménez FA et al. 2025, *J Cardiovasc Transl Res*
  ([10.1007/s12265-024-10589-5](https://doi.org/10.1007/s12265-024-10589-5): thiết bị đa thông số
  đeo ở ngực, kiểm giá trị tham chiếu trong 4 tuần).
- **T3, mô hình hiệu chuẩn:** Barvík D et al. 2022, *IEEE Rev Biomed Eng*
  ([10.1109/rbme.2021.3109643](https://doi.org/10.1109/rbme.2021.3109643): tổng quan các mô hình
  hiệu chuẩn PTT); Mousavi AS et al. 2024, *IEEE TBME*
  ([10.1109/tbme.2023.3307658](https://doi.org/10.1109/tbme.2023.3307658): hiệu chuẩn một điểm dựa
  trên mô hình vật lý, 22 người); Seo Y et al. 2023, *Biomed Eng Lett*
  ([10.1007/s13534-023-00271-1](https://doi.org/10.1007/s13534-023-00271-1): hiệu chuẩn lại bằng
  cuff cổ tay); Tamura T et al. 2023, *Health Technol*
  ([10.1007/s12553-023-00726-6](https://doi.org/10.1007/s12553-023-00726-6): đề xuất tiêu chí ổn
  định dài hạn); He S, Bolić M 2024, *Sci Rep*
  ([10.1038/s41598-024-77171-6](https://doi.org/10.1038/s41598-024-77171-6): chỉ số đo khả năng bám
  theo xu hướng).
- **T2:** Park S et al. 2023, *Biomed Eng Lett*
  ([10.1007/s13534-023-00284-w](https://doi.org/10.1007/s13534-023-00284-w): dữ liệu VitalDB, so bộ
  đặc trưng PAT với bộ đặc trưng hình thái PPG ở người có và không có đái tháo đường); Yang Y et al.
  2026, *Physiol Meas* ([10.1088/1361-6579/aeab62](https://doi.org/10.1088/1361-6579/aeab62): 28
  phiên ở 9 người, PTT/PIR theo cách gọi của bài và tonometry ở thái dương khi bóp tay); Yi MK et
  al. 2026, *Physiol Meas* ([10.1088/1361-6579/aeb063](https://doi.org/10.1088/1361-6579/aeb063):
  khung đánh giá đặc trưng PPG có tính tới điều kiện đo).
- **T7:** Nawar A et al. 2024, EMBC
  ([10.1109/embc53108.2024.10781523](https://doi.org/10.1109/embc53108.2024.10781523): stress khi
  nói trước đám đông; thay đổi PAT tương quan với ΔMAP, r = −0,58; 35 người, phần lớn sau nhồi máu
  cơ tim); Rojano-Hernández E et al. 2025, EMBC
  ([10.1109/embc58623.2025.11251854](https://doi.org/10.1109/embc58623.2025.11251854): ước lượng PEP
  bằng impedance plethysmography từ tay sang tay).
- **T8:** Lambert Cause J et al. 2024, *Sensors*
  ([10.3390/s24092692](https://doi.org/10.3390/s24092692): lực tiếp xúc và PPG năm bước sóng, 11
  người); Pilt K, Reiu A 2024, *Med Biol Eng Comput*
  ([10.1007/s11517-023-02992-y](https://doi.org/10.1007/s11517-023-02992-y): áp suất xuyên thành và
  chỉ số độ cứng từ PPG ngón tay); Scardulla F et al. 2025, *Sensors*
  ([10.3390/s25144477](https://doi.org/10.3390/s25144477): áp lực tiếp xúc 20/60/75 mmHg và độ chính
  xác HR).
- **Định vị:** Stergiou GS et al. 2022, *J Hypertens*
  ([10.1097/hjh.0000000000003224](https://doi.org/10.1097/hjh.0000000000003224): tuyên bố của ESH năm
  2022); Mukkamala R et al. 2022, *Annu Rev Biomed Eng*
  ([10.1146/annurev-bioeng-110220-014644](https://doi.org/10.1146/annurev-bioeng-110220-014644));
  Parati G et al. 2026, *Eur J Prev Cardiol*
  ([10.1093/eurjpc/zwag058](https://doi.org/10.1093/eurjpc/zwag058): tuyên bố khoa học năm 2026).

### 3.3. S4: kết quả đọc toàn văn (2026-10-30)

Mieloszyk R et al. *IEEE J Biomed Health Inform* 2022;26(7):2864–2875,
[10.1109/jbhi.2022.3153259](https://doi.org/10.1109/jbhi.2022.3153259). Bản đã đọc là bản IEEE đã
xuất bản, đăng tự do trên trang Microsoft Research
([PDF](https://www.microsoft.com/en-us/research/wp-content/uploads/2022/07/A_Comparison_of_Wearable_Tonometry_Photoplethysmography_and_Electrocardiography_for_Cuffless_Meas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)).
Số ghi "khoảng" do trợ lý đọc ước lượng từ hình, không phải số in trong bài; các số còn lại chép từ
bảng. Chờ thầy xem.

**Thiết kế**

- 1.125 người được phân tích: 642 ở nhánh nghe tim, 483 ở nhánh dao động kế; tuổi trung bình 45,1,
  34,3% có tiền sử tăng huyết áp (Bảng II). Mỗi người làm hai buổi trong phòng thí nghiệm cách
  nhau ít nhất 24 giờ; nhánh dao động kế đo thêm lưu động giữa hai buổi (Bảng I).
- Thiết bị (mục II.A, Hình 1): PPG cổ tay dùng MAX30101, cùng chip PPG với V1 của nhóm. ECG qua
  ADS1292, điện cực âm ở ngực, điện cực dương ở cẳng tay đeo thiết bị; cuff ở tay đối diện. ECG không
  đo giữa hai cổ tay.
- Mô hình (mục II.E): dự đoán thay đổi BP so với giá trị hiệu chuẩn ở buổi đầu (tư thế nằm), cho BP
  lúc nghỉ ở buổi quay lại. Bài chỉ báo ridge, vì GAM, cây tăng cường và các mô hình khác không tốt
  hơn (Bảng VI). Hai baseline: "zero" giữ nguyên BP hiệu chuẩn; "static" là ridge chỉ trên BP hiệu
  chuẩn và giờ trong ngày, không dùng tín hiệu.
- Thống kê: kiểm định chéo giữ nguyên người; 100 lần bootstrap, mỗi lần lấy 90% số người; các nhóm
  được so bằng Welch t-test trên các giá trị bootstrap. Bài báo bias và SD, không báo MAE, không có
  hiệu ghép cặp theo người và không có δ. Cửa sổ có điểm chất lượng dưới ngưỡng bị loại (mục II.C).

**Nhóm đặc trưng (Bảng IV)**

| Nhóm | Đặc trưng |
| --- | --- |
| "Smart watch" | dP/dt từ PPG; HR và HRV từ PPG; chất lượng PPG; góc tay; giờ trong ngày. Không có ECG |
| "Optical" | dP/dt từ PPG; HR từ PPG và từ ECG; HRV từ ECG; rPAT và 1/rPAT quang; độ dài nhịp; chất lượng PPG; góc tay; giờ trong ngày |
| "ECG" | Độ dài nhịp; HR và HRV từ ECG; giờ trong ngày |

"Optical" khác "smart watch" ở rPAT, 1/rPAT, độ dài nhịp và HR, HRV tính từ ECG, nên phép so hai
nhóm này không phải phép bỏ riêng PAT. Đặc trưng hình dạng PPG của cả hai nhóm chỉ có dP/dt.

**Kết quả ở buổi quay lại (Bảng V)**, SD sai số SBP / DBP (mmHg), tham chiếu nghe tim:

| Nhóm người | Optical | Smart watch | Static | Zero |
| --- | --- | --- | --- | --- |
| Tất cả | 10,0 / 7,60 | 10,1 / 7,66 | 10,2 / 7,87 | 10,3 / 8,12 |
| ≤ 35 tuổi | 7,95 / 7,86 | 8,02 / 8,03 | 8,18 / 8,07 | 8,20 / 8,50 |

- Ở mọi ô của Bảng V (cả hai loại tham chiếu, ba nhóm người), SD của nhóm optical chênh với nhóm
  smart watch không quá 0,25 mmHg, và có ô nhóm optical còn cao hơn 0,1 mmHg. Tác giả viết nhóm
  optical chỉ có lợi "marginal" so với baseline static và zero (mục III.C.5).
- Với tham chiếu dao động kế, SD SBP cao hơn tham chiếu nghe tim 0,8–4,0 mmHg tùy nhóm đặc trưng và
  nhóm người, kể cả zero (tính từ Bảng V). Lời văn mục III.C.2 viết "ít nhất 1 mmHg", không khớp vài
  ô của nhóm "Tất cả" (0,8–0,9 mmHg). Ở nhánh này, zero có bias SBP −5,79 và DBP −7,96 mmHg (nhóm "Tất cả"), còn
  static chỉ −0,69 và −0,18 mmHg: static gỡ được độ lệch hệ thống mà zero mắc phải.
- Ở tư thế nằm, trùng tư thế hiệu chuẩn, SD SBP của nhóm ≤ 35 tuổi là 7,00–7,30 mmHg với mọi nhóm
  đặc trưng và cả hai baseline (Bảng VII). Tác giả lưu ý người trẻ và người bình áp ở tư thế nằm đạt
  tiêu chí I của ANSI/AAMI với mọi nhóm, kể cả baseline, và cảnh báo rằng đánh giá trên người trẻ,
  khỏe cho kết quả quá lạc quan (mục III.C.1).

**Biến thiên BP và tỷ lệ dữ liệu**

- |ΔSBP| (nghe tim) giữa hai buổi tăng theo tuổi và theo SBP lúc nghỉ (Hình 3). Trung vị khoảng
  3 mmHg ở 21–30 tuổi, khoảng 5 mmHg ở 31–50 tuổi, khoảng 8,5 mmHg ở 51–70 tuổi và khoảng 14 mmHg ở
  71–80 tuổi.
- SD của ΔSBP ở nhóm dưới 36 tuổi, trong phòng thí nghiệm, khoảng 8,6 mmHg với tham chiếu nghe tim
  và khoảng 11 mmHg với dao động kế (Hình 4).
- Lưu ý khi dùng hai số trên (thêm 2026-11-07): nếu ΔSBP gần chuẩn quanh 0 thì SD 8,6 mmHg ứng với
  trung vị |ΔSBP| khoảng 5,8 mmHg, cao hơn số khoảng 3 mmHg đọc ở Hình 3. Hai số thuộc hai nhóm tuổi
  khác nhau (21–30 và < 36) và đều đọc ước lượng từ hình, nên chưa kết luận được là mâu thuẫn. Phải
  đọc lại cả hai hình trước khi dùng làm dải ΔBP cho mô phỏng độ nhạy (RQ mục 4.E); không dùng riêng
  số 3 mmHg.
- Trong phòng thí nghiệm, tỷ lệ phép đo dùng được khoảng 0,99 với ECG, 0,74 với PPG và 0,65 với
  tonometry (Hình 5). Theo giờ trong ngày, tỷ lệ trích được đặc trưng quang khoảng 0,83–0,94 với
  rPAT, 0,56–0,71 với sườn lên tâm thu và 0,29–0,43 với dicrotic notch (Hình 6).

**Hạn chế do tác giả nêu (mục IV):** thiết bị quang không phải PPG hiện đại nhất; protocol không
được thiết kế theo chuẩn của FDA cho thiết bị cuffless; chỉ dùng mô hình diễn giải được.

**Lưu ý khi trích:** mục I của S4 viết PTT bằng tổng của rPAT và PEP. Quan hệ đúng, theo quy ước của
dự án, là PAT = PEP + PTT, nên không trích câu này.

## 4. So sánh với thiết kế của nhóm

| Đặc điểm của RQ1 | Đã có trong các nguồn đã đọc |
| --- | --- |
| Baseline zero-change hoặc chỉ hiệu chuẩn, đánh giá theo người | N1 (zero-change, LOSO lồng); N2 (baseline không đổi); N18 (baseline naïve, tức trung bình các lần cuff ban đầu, sau 1 năm); N19 (baseline models, theo abstract); N6 (baseline AdaBoost học từ BP ban đầu + nhân khẩu học; \|ΔBP\| so với ngày D có ở Hình 5 nhưng không được so với mô hình); S3; S4 (baseline zero và static, mục 3.3) |
| So PPG với PAT trên cùng người | N1 (từng bộ đặc trưng riêng); N2 (PPG + PAT); N18 (mô hình PAT, PAT + đặc trưng PPG và chỉ PPG, mỗi mô hình một đầu ra khác nhau); N25, N26 (PAT theo từng nghiệm pháp); N6 (chỉ ở mô hình không hiệu chuẩn, chỉ SBP: PPG hồng ngoại so với ECG + PPG hồng ngoại, không kiểm định); S4 (nhóm chỉ PPG so với nhóm thêm rPAT và HR, HRV từ ECG; không tách riêng PAT, không ghép cặp theo người) |
| Nghiệm pháp tạo ΔBP không dùng thuốc | N2, N3, N4, N7, N18 (thở chậm, tính nhẩm, ngâm lạnh, có thêm nitroglycerin), N25, N26, N28 |
| PPG và ECG cùng ở cổ tay | N5 (ECG giữa cổ tay và ngón tay bàn tay kia, SCG ở ngực); N6 (ECG giữa cổ tay trái và ngón cái tay phải, PPG ở ngón trỏ tay phải ấn lên đồng hồ, PPW ở động mạch quay); S4/N19/N20 (Aurora; ở S4 điện cực ECG âm đặt ở ngực); N10; N42 (dataset); N41 (mới thử trên bàn) |
| Đánh giá ở phiên khác ngày sau hiệu chuẩn | N4 (ngày hôm sau, nhóm nhỏ); N6 (D+7, D+14, D+21 sau hiệu chuẩn ở ngày D); N7 (11 người, ngày hôm sau, chỉ PPG); N18 (1 năm); N21 (từ 30 ngày trở lên, chỉ PPG); N23, N31–N34 (1–6 tuần, chỉ PPG); S3/S4 (buổi quay lại sau ít nhất 24 giờ) |
| Đầu ra thiết bị bám gần mốc hiệu chuẩn | N22 (PAT, 24 giờ); N23, N24, N33 (PPG); N8 có tổng hợp |
| **Tất cả cùng lúc: thiết bị chỉ ở cổ tay; PPG-only so với PPG + PAT, ghép cặp theo người, cùng thuật toán; các phiên cách vài ngày đến 4 tuần; so với zero-change; có nghiệm pháp** | **Không thấy** trong các nguồn đã mở. Gần nhất là N18: nhiều phiên và có baseline naïve, nhưng không đo ở cổ tay, hiệu chuẩn nhiều điểm cho từng người, các phiên cách nhau 1 năm, và không so ghép cặp trên cùng một đầu ra. N6 (đọc toàn văn ngày 2026-10-30, chờ thầy xem) có nhiều phiên trong 1 tháng và baseline học từ BP ban đầu, nhưng chỉ so tổ hợp tín hiệu ở mô hình không hiệu chuẩn, PPG đo ở ngón tay và không có nghiệm pháp. S4 (đọc toàn văn ngày 2026-10-30, mục 3.3) gần nhất về thiết kế: cổ tay, buổi quay lại sau ít nhất 24 giờ, ridge, baseline zero và static, kiểm định chéo theo người; nhưng nhóm chỉ PPG và nhóm có rPAT khác nhau ở nhiều đặc trưng ECG, ECG có điện cực ở ngực, kết quả báo bằng bias/SD với Welch t-test trên bootstrap, không có hiệu ghép cặp theo người hay δ, và không có nghiệm pháp. Chưa loại trừ được: N19 và N20, vì chưa đọc toàn văn |

## 5. Đánh giá mức độ mới

### 5.1. Khoảng trống của RQ1 sau lần tra thứ hai

**Phải sửa nhận định của lần thứ nhất.** Lần thứ nhất viết rằng các nghiên cứu so PPG với PAT có
baseline chỉ đo trong một buổi. N18 cho thấy điều này không còn đúng: Yavarimanesh et al. (2022)
đã đánh giá mô hình có PAT và mô hình chỉ dùng đặc trưng PPG ở hai phiên cách nhau 1 năm, so với
baseline chỉ dùng cuff hiệu chuẩn, với các nghiệm pháp thở chậm, tính nhẩm và ngâm lạnh. Mỗi mô
hình được so riêng với baseline và có đầu ra khác nhau, nên đây không phải so sánh ghép cặp. Trên
dữ liệu cổ tay, N19 (abstract) báo mô hình dựa trên PAT không vượt baseline ở SBP khi theo dõi lưu
động. Vì vậy, các thành phần sau, **kể cả khi gộp một phần**, đều không phải điểm mới: nhiều
phiên; baseline chỉ hiệu chuẩn; nghiệm pháp; đánh giá mô hình PAT và mô hình đặc trưng PPG so với
baseline.

**Phần có thể còn là đóng góp** (chỉ trong phạm vi các nguồn đã mở, mục 2.2): một phép so sánh
ghép cặp, đăng ký trước, giữa PPG-only và PPG + PAT, thỏa cùng lúc các điều kiện sau:

1. Thiết bị chỉ đặt ở cổ tay: PPG ở cổ tay và ECG đạo trình I giữa hai cổ tay.
2. Các phiên cách nhau vài ngày đến 4 tuần.
3. Hiệu chuẩn chỉ bằng offset từ M0 của phiên 1, hệ số chung cho mọi người học bằng LOSO lồng. N18
   thì khác: mỗi người có hệ số riêng, lập từ cả bộ nghiệm pháp.
4. Hai mô hình dùng cùng thuật toán, cùng tập lần đo và cùng đầu ra, và chỉ khác nhau ở PAT (ý cuối
   thêm ngày 2026-10-30 sau khi đọc S4, chờ thầy xem).
5. Luôn so với zero-change, có CI bootstrap theo người và mức δ khóa trước.

**Đối chiếu N6 với năm điều kiện** (đọc toàn văn ngày 2026-10-30, chờ thầy xem): N6 thỏa một phần
điều kiện 2 (đo ở D+7, D+14, D+21 sau hiệu chuẩn ở ngày D). N6 không thỏa điều kiện 1 (PPG ở ngón
tay ấn lên đồng hồ, ECG cần ngón cái tay kia), điều kiện 3 (hiệu chuẩn bằng cách trộn dự đoán với BP
nền ngày D theo α = 0,6, chọn theo sai số của chính các mô hình được báo cáo), điều kiện 4 (so tổ hợp
tín hiệu chỉ ở mô hình không hiệu chuẩn, chỉ SBP) và điều kiện 5 (baseline là mô hình học từ BP ban
đầu + nhân khẩu học; không có CI theo người).

**Đối chiếu S4 với năm điều kiện** (đọc toàn văn ngày 2026-10-30, chờ thầy xem; chi tiết ở mục
3.3). S4 thỏa một phần điều kiện 2 (một buổi quay lại sau ít nhất 24 giờ) và gần thỏa điều kiện 3
(dự đoán thay đổi so với BP hiệu chuẩn bằng hệ số chung học trên những người khác, kiểm định chéo giữ
nguyên người; bài không mô tả LOSO lồng). S4 không thỏa điều kiện 1 (điện cực ECG âm ở ngực), điều
kiện 4 (cùng thuật toán ridge và cùng đầu ra, nhưng nhóm chỉ PPG và nhóm có rPAT khác nhau ở nhiều
đặc trưng ECG) và điều kiện 5 (có baseline zero và bootstrap theo người, nhưng các nhóm được so bằng
Welch t-test trên các giá trị bootstrap, không có hiệu ghép cặp theo người và không có δ). S4 cũng
không có nghiệm pháp. Điểm phân biệt rõ nhất với S4 là ý "chỉ khác nhau ở PAT" của điều kiện 4. Điều
kiện 2 chỉ khác S4 nếu SAP khóa khoảng cách tối thiểu giữa phiên 1 và phiên 2, vì protocol hiện cho
phép phiên 2 cách phiên 1 một ngày.

**Không được viết** "đầu tiên" hay "chưa có nghiên cứu nào". Nên viết như sau: "Trong các nguồn
đã tra (PubMed, Europe PMC, OpenAlex, giai đoạn 2022–2026, tra ngày 2026-10-29; chưa tra IEEE
Xplore, Scopus, Web of Science; S4 và N6 đọc toàn văn ngày 2026-10-30), chưa thấy nghiên cứu so
sánh ghép cặp theo người giữa PPG-only và PPG + PAT, hai mô hình chỉ khác nhau ở PAT, trên cùng một
thiết bị cổ tay, ở các phiên khác ngày, đối chiếu với zero-change. Yavarimanesh et al. (2022) đã đánh giá mô hình có PAT và mô hình đặc
trưng PPG qua hai phiên cách nhau một năm, so với baseline chỉ dùng cuff hiệu chuẩn, nhưng PPG đo
ở tai, ngón tay, ngón chân, mỗi người được hiệu chuẩn nhiều điểm, và mỗi mô hình có đầu ra riêng."
Câu về N6 nên thêm vào đoạn trên (đề xuất ngày 2026-10-30, chờ thầy xem): "Liu et al. (2023) đánh
giá 3.077 người ở các ngày D+7 đến D+21 sau hiệu chuẩn và so với baseline, nhưng chỉ so các tổ hợp
tín hiệu ở mô hình không hiệu chuẩn, và PPG được đo ở ngón tay ấn lên đồng hồ."
Câu về S4 nên thêm vào đoạn trên (đề xuất ngày 2026-10-30, chờ thầy xem): "Mieloszyk et al. (2022)
so nhóm đặc trưng chỉ từ PPG với nhóm thêm rPAT và nhịp tim, HRV từ ECG trên cùng thiết bị cổ tay ở
buổi quay lại sau ít nhất 24 giờ (1.125 người), và thấy nhóm có rPAT chỉ hơn các baseline dựa trên BP
hiệu chuẩn một chút; tuy vậy hai nhóm khác nhau ở nhiều đặc trưng ECG chứ không riêng PAT, ECG dùng
điện cực ở ngực, và các nhóm được so qua bias và SD chứ không theo hiệu ghép cặp từng người."
Ngày 2026-10-29 nhóm quyết định bỏ qua toàn văn S4 vì tưởng S4 chỉ có bản trả phí. Từ ngày
2026-10-30 khoảng trống đã được kiểm với toàn văn S4, nên bài báo không cần nêu giới hạn này nữa.

**Kết quả âm tính vẫn là đóng góp** theo khung của N8, và sau lần tra thứ hai, khả năng ra kết quả
âm tính cao hơn:

- ở N18, mô hình chỉ PPG cho DBP kém hơn naïve sau 1 năm, còn mô hình PAT ngón tay chưa vượt naïve
  có ý nghĩa;
- ở N19, mô hình PAT trên dữ liệu cổ tay không vượt baseline;
- ở N6, ba mô hình "PTT" (hai mô hình dùng PAT, trong đó một mô hình tính DBP từ PIR; mô hình thứ
  ba dùng độ trễ giữa hai sóng PPG, không có ECG; sửa 2026-11-07) hiệu chuẩn theo từng người có MAE cao hơn
  baseline học từ BP ban đầu + nhân khẩu học (SBP 9,20–9,26 so với 8,46; DBP 6,59–6,78 so với
  5,78 mmHg); mô hình học máy nhiều tín hiệu thấp hơn baseline khoảng 1,1 mmHg (SBP) và 0,65 mmHg
  (DBP), không có CI;
- N22–N24 và N33 cho thấy đầu ra của bốn thiết bị thương mại được đánh giá đều bám gần mốc hiệu
  chuẩn.

Suy luận của trợ lý, không nguồn nào nói trực tiếp: N18 cho rằng PAT ở tai và ngón tay cho kết quả
kém là do co cơ trơn thành mạch; đường mạch tới cổ tay cũng đi qua động mạch cơ, nên PAT cổ tay có
thể gặp cùng vấn đề.

**Điểm yếu so với các bài gần nhất:**

- cỡ mẫu nhỏ hơn nhiều so với N6 (3.077 người) và S4 (1.125 người);
- N18 ước tính cần 31 người cho một so sánh tương tự (mô hình ngón tay so với naïve sau 1 năm),
  nhiều hơn mục tiêu ≥ 15 người của RQ1;
- tham chiếu là cuff đo ngắt quãng, trong khi N7 và N4 dùng tham chiếu liên tục; S4 cho thấy với
  cuff dao động kế, SD sai số SBP cao hơn tham chiếu nghe tim 0,8–4,0 mmHg tùy nhóm (mục 3.3);
- người tham gia trẻ và khỏe, nên dải ΔBP hẹp. Ở S4, trung vị |ΔSBP| giữa hai buổi chỉ khoảng 3 mmHg
  ở người 21–30 tuổi, và ở nhóm ≤ 35 tuổi mọi nhóm đặc trưng lẫn baseline có SD sai số sát nhau; tác
  giả cảnh báo đánh giá trên người trẻ, khỏe cho kết quả quá lạc quan (mục 3.3).

Người phản biện sẽ hỏi vì sao nhóm không dùng Aurora-BP, vì dataset này nay đã có bản mở trên
Zenodo kèm Data Use Agreement (mục 3.1).

### 5.2. Ảnh hưởng tới rủi ro của RQ1 (để nhóm cân nhắc)

Ghi chú ngày 2026-10-30: protocol đã bỏ M3 (ngâm chân nước lạnh) và M4 (đạp xe) từ ngày
2026-10-29, nên các ý về M3, M4 dưới đây chỉ còn để tham khảo, phòng khi sau này xin sửa đổi để
thêm nghiệm pháp. Các ý về PEP, áp lực tiếp xúc và cỡ mẫu đã được đưa vào RQ mục 4.F–4.G ngày
2026-10-30.

- **PEP ở M2 (và ở M4 trước khi bỏ):** N11 (stress tinh thần làm PEP giảm 16%, gắng sức làm PEP
  giảm một nửa), N30 (PEP đổi theo độ khó của nhiệm vụ) và N25 (từ nền sang nhiệm vụ tinh thần,
  tương quan giữa thay đổi PAT và thay đổi SBP không có ý nghĩa thống kê) cùng ủng hộ rủi ro đã ghi
  ở RQ mục 4.F, và ủng hộ việc báo kết quả theo từng nghiệm pháp.
- **Ngâm lạnh (M3, đã bỏ):** N29 (khi đau do lạnh, PEP không đổi còn PTT giảm) và N18 (co cơ trơn
  thành mạch) gợi ý rằng khi ngâm lạnh, thay đổi PAT chủ yếu đến từ phần mạch máu chứ không từ
  PEP; cỡ mẫu của các nghiên cứu này nhỏ.
- **Áp lực tiếp xúc:** N8, N13, N35–N38 và N18 (khuyến nghị giữ nguyên vị trí đặt cảm biến) củng
  cố rủi ro đã ghi ở RQ mục 4.F. N6 cũng cho rằng vị trí và lực tiếp xúc của cảm biến PPG thay đổi
  qua các ngày làm "PTT tiểu động mạch" (tính từ PPG nhiều bước sóng) kém ổn định; đây là giải thích
  của tác giả, bài không kiểm riêng. Dataset WF-PPG (N35) có thể dùng để kiểm mức nhạy của đặc trưng
  PPG trước khi thu dữ liệu người.
- **Tư thế tay:** N12 cho thấy độ cao của cảm biến so với tim làm đổi chất lượng PPG cổ tay, nên cần
  cố định tư thế tay ở mọi phiên.
- **Cỡ mẫu:** con số 31 người của N18 nên được đưa vào mô phỏng độ nhạy ở RQ mục 4.E.
- **Baseline "static" (S4, bổ sung 2026-10-30):** ở S4, baseline chỉ dùng BP hiệu chuẩn và giờ trong
  ngày gỡ được độ lệch hệ thống mà zero-change mắc phải, và các nhóm đặc trưng chỉ hơn nó rất ít (mục
  3.3). Gợi ý của trợ lý, chưa được nhóm hay thầy quyết định: cân nhắc thêm một baseline kiểu static
  vào SAP (chỉ BP hiệu chuẩn và hệ số chặn học bằng LOSO lồng, không dùng tín hiệu), để tách phần
  "vượt zero-change" nhờ tín hiệu khỏi phần nhờ học độ lệch trung bình giữa các phiên. Cần xem xét kỹ
  trước khi ghi vào SAP.
- **Dải ΔBP ở người trẻ (S4, Hình 3):** trung vị |ΔSBP| giữa hai buổi khoảng 3 mmHg ở 21–30 tuổi và
  chỉ tăng rõ từ khoảng 51 tuổi. Có thể dùng các số này làm khoảng cho mô phỏng độ nhạy (RQ mục 4.E)
  và khi đặt lại ngưỡng R3/P2. Suy luận của trợ lý: nới tuổi tuyển trong phạm vi dưới 50 tuổi khó làm
  rộng dải ΔBP.
- **Tỷ lệ dữ liệu PPG cổ tay (S4, Hình 5, 6):** trong phòng thí nghiệm, khoảng 1/4 số phép đo PPG
  không dùng được; đặc trưng dựa trên dicrotic notch chỉ trích được ở khoảng 30–40% số phép đo. Bộ
  đặc trưng `features-sqi` của nhóm không dùng dicrotic notch, nhưng nên tính tỷ lệ mất PPG khi dự trù
  số lần cuff cần thu.

### 5.3. Đoạn cần sửa trong ma trận và RQ

Lần tra không tự sửa ma trận và RQ, mà chỉ ghi lại danh sách dưới đây để nhóm sửa. Ngày
2026-10-30 đã sửa theo danh sách này ở:

- ma trận: phần đầu, mục 2.1, khoảng trống 1–2, đóng góp 1;
- RQ: mục 1, 4.F và 4.G.

Danh sách được giữ lại làm nhật ký. Khoảng trống 4 (RQ3) không đổi.

- **Ma trận, phần đầu** (dòng "Nguồn bổ sung … (N1–N17)"): đổi thành N1–N42.
- **Ma trận mục 2.1:**
  - Thêm N18, N19 (và N22–N24 cho baseline chỉ hiệu chuẩn) vào "Bằng chứng chính" của RQ1.
  - Sửa hàng "Mới tìm, chưa đọc": N5, N7, N8, N16 đã đọc toàn văn; N9, N11–N13 đã đọc abstract.
  - Sửa câu "Chưa có tìm kiếm có hệ thống trên PubMed/IEEE Xplore…" thành: đã tra PubMed, Europe PMC,
    OpenAlex ngày 2026-10-29; IEEE Xplore, Scopus chưa tra.
- **Ma trận mục 4, khoảng trống 1:**
  - Sau câu "Cả hai nghiên cứu đó chỉ đánh giá **trong một buổi** …", thêm N18 (nhiều phiên, có
    baseline naïve, không đo ở cổ tay).
  - Câu "Các nghiên cứu nhiều ngày trên thiết bị cổ tay có quy mô lớn … chưa cho thấy phép so sánh
    ghép cặp …" cần thêm N19 (PAT không vượt baseline trên Aurora) và việc N6 có so với baseline
    (theo N8).
  - Đoạn "**Khoảng trống, ở phạm vi hẹp:** …" thu hẹp theo năm điều kiện ở mục 5.1.
  - Câu "phải kiểm lại sau khi đọc toàn văn S4 và N6" đã đổi thành "… toàn văn N6", kèm ghi chú S4
    chỉ dùng abstract (sửa ngày 2026-10-29 theo quyết định bỏ qua S4). Cân nhắc thêm N19, N20.
- **Ma trận mục 4, khoảng trống 2:**
  - Câu "Đa số nghiên cứu gần nhất (N1, N2, N7) chỉ đánh giá trong một buổi" chưa chính xác với N7
    (11 người đo lại ngày hôm sau).
  - Thêm N18 (1 năm), N21, N31–N34 (nhiều tuần, chỉ PPG) và N22–N24, N33 (đầu ra bám mốc hiệu chuẩn).
- **Ma trận mục 4, khoảng trống 4 (RQ3):** lần tra thứ hai không tra chủ đề SQI và độ bất định, nên
  câu "chưa tìm kiếm cho giai đoạn 2022–2026" vẫn đúng.
- **RQ mục 1, đoạn "Các nghiên cứu gần nhất (v0.4)":**
  - Câu "So sánh trực tiếp PPG với PAT có baseline zero-change … chỉ ở **một buổi đo**" không còn đúng
    sau N18.
  - Thêm N18, N19. Câu về S4 và N6 trong đoạn này đã theo quyết định ngày 2026-10-29 (S4 chỉ dùng
    abstract, kiểm lại sau khi đọc toàn văn N6).
- **RQ mục 4.F và 4.G:** cân nhắc thêm N11, N25, N29, N30 (PEP), N35–N38 (áp lực tiếp xúc) và con số
  31 người của N18 (mục 5.2).
- **Sau khi đọc toàn văn N6 (2026-10-30):**
  - Ma trận mục 4, khoảng trống 1 và 2: đã sửa ghi chú về N6 cùng ngày, chờ thầy xem.
  - RQ mục 1 (lần đọc này không sửa RQ): ý "Nghiên cứu nhiều ngày, quy mô lớn, trên thiết bị cổ
    tay … N6 … Phần nhóm đã đọc (abstract)" cần đổi theo toàn văn: thiết bị của N6 đo PPG ở ngón
    tay và ECG qua ngón cái; N6 chỉ so tổ hợp tín hiệu ở mô hình không hiệu chuẩn. Ý "Phải kiểm lại
    sau khi đọc toàn văn N6" cần đổi thành đã đối chiếu, dẫn tới mục 5.1.
- **Sau khi đọc toàn văn S4 (2026-10-30):** cùng ngày đã sửa ma trận (khoảng trống 1), RQ mục 1, 4.F
  và 8, README của thư mục tài liệu, và ghi mức đã đọc vào dòng S4 của
  [tổng quan 2026-10-14](literature_update_2026-10-14.md). Các chỗ sửa chờ thầy xem.

## 6. Việc cần làm

### 6.1. Cần lấy toàn văn

Các bài dưới đây có toàn văn đóng hoặc bị chặn khi tra ngày 2026-10-29, xếp theo mức ảnh hưởng
tới khoảng trống của RQ1.

**S4 (xong ngày 2026-10-30):** ngày 2026-10-29 nhóm quyết định bỏ qua S4 (Mieloszyk 2022,
[10.1109/jbhi.2022.3153259](https://doi.org/10.1109/jbhi.2022.3153259)) vì tưởng S4 chỉ có bản trả
phí. Ngày 2026-10-30 trợ lý tìm được bản PDF miễn phí trên trang Microsoft Research và đã đọc toàn
văn; kết quả ở mục 3.3 và 5.1.

1. **N6** – Liu ZD et al. *IEEE J Biomed Health Inform* 2023;27(9):4216–4227,
   [10.1109/jbhi.2023.3278168](https://doi.org/10.1109/jbhi.2023.3278168). **Xong ngày
   2026-10-30:** nhóm tải bản PDF (CC BY) bằng trình duyệt thường, đã đọc toàn văn. Trả lời
   các câu hỏi đã đặt ra (chi tiết ở dòng N6, bảng 3):
   - So PPG-only với PPG + PAT trên cùng người: chỉ ở mô hình AdaBoost không hiệu chuẩn, chỉ SBP
     (Bảng A2: 9,99 so với 9,90 mmHg, không kiểm định); không có ở mô hình có hiệu chuẩn.
   - Baseline (Bảng IV): có hiệu chuẩn là AdaBoost học từ BP ban đầu + nhân khẩu học, không phải
     zero-change; không hiệu chuẩn là AdaBoost chỉ với nhân khẩu học.
   - Hiệu chuẩn ở ngày D (trung bình 3 lần đo), đánh giá ở D+7, D+14, D+21.
   - Chia theo người (5-fold CV); mô hình PTT hiệu chuẩn bằng ngày D rồi dự đoán các ngày sau. Bài
     không nói Bảng IV có tính cả ngày D cho mô hình học máy không.
   - α = 0,6 chọn theo sai số nhỏ nhất của chính các mô hình được báo cáo (Hình A1), không có tập
     riêng để chọn; khớp với nghi vấn của N8.
2. **N19** – Cisnal A et al. *Proc IEEE CBMS* 2025,
   [10.1109/cbms65348.2025.00046](https://doi.org/10.1109/cbms65348.2025.00046): cần biết định nghĩa
   baseline models, có mô hình PPG-only không, và cách chia dữ liệu.
3. **N20** – Liu ZD et al. *IEEE JBHI* 2024,
   [10.1109/jbhi.2024.3395445](https://doi.org/10.1109/jbhi.2024.3395445): cần xem Bảng IV, V
   (baseline và so nhiều phương pháp).
4. **N28** – Xie C et al. EMBC 2023,
   [10.1109/embc40787.2023.10340548](https://doi.org/10.1109/embc40787.2023.10340548): cần biết vị
   trí đo PPG, các can thiệp và cách hiệu chuẩn.
5. **N31** – Han M et al. *Hypertens Res* 2023
   ([10.1038/s41440-023-01215-z](https://doi.org/10.1038/s41440-023-01215-z)) và **N37** – McMurray JP
   et al. SPIE 2023 ([10.1117/12.2649531](https://doi.org/10.1117/12.2649531)).
6. **Các bài chưa sàng lọc được vì không lấy được abstract** (OpenAlex và Europe PMC không có
   abstract; Semantic Scholar trả 429):
   - He J et al. 2022. A new approach for daily life blood-pressure estimation using smart watch.
     *Biomed Signal Process Control* 75:103616,
     [10.1016/j.bspc.2022.103616](https://doi.org/10.1016/j.bspc.2022.103616). Tiêu đề gợi ý bài dùng
     đồng hồ đo hằng ngày, có thể liên quan tới T1/T4.
   - Liu J et al. 2024. *Appl Soft Comput* 167:112390,
     [10.1016/j.asoc.2024.112390](https://doi.org/10.1016/j.asoc.2024.112390) (bài trích dẫn N1, N6,
     S4).
   - Cao X et al. 2026. *Sens Actuators A Phys* 412:118546,
     [10.1016/j.sna.2026.118546](https://doi.org/10.1016/j.sna.2026.118546) (tiếp xúc da–cảm biến ở
     cổ tay, T8).
   - Li Y et al. 2026, SSRN preprint,
     [10.2139/ssrn.7436498](https://doi.org/10.2139/ssrn.7436498) (ước lượng xu hướng BP).

### 6.2. Việc khác

1. **N6 (đã đọc toàn văn ngày 2026-10-30):** điều kiện "N6 đã so ghép cặp PPG-only với PPG + PAT
   qua nhiều ngày, có baseline chỉ hiệu chuẩn" không xảy ra; phần đối chiếu ở mục 5.1 chờ thầy xem.
   Còn mở: số trong lời văn mục IV.C của N6 lệch với Hình 5 (dòng N6), nên nếu trích sai số theo
   ngày của N6 thì phải ghi rõ lấy từ hình hay từ lời văn, hoặc hỏi tác giả. S4 đã được đọc toàn
   văn ngày 2026-10-30 (mục 3.3, 5.1).
2. Đã sửa ma trận (mục 2.1, 4) và RQ (mục 1, 4.F, 4.G) theo mục 5.3 ngày 2026-10-30; các chỗ sửa ở
   RQ vẫn cần được duyệt.
3. **Aurora-BP:** đọc toàn văn tệp Data Use Agreement trên Zenodo trước khi tải dữ liệu. Phải hiểu
   đúng điều khoản "không ghép với nguồn dữ liệu khác" trước khi dùng Aurora làm bộ dữ liệu thứ hai.
   Cần quyết định việc này trước khi chọn tạp chí ở Tuần 8. N6 có dataset CAS-BP với 4 ngày đo sau
   hiệu chuẩn: phần 1 (1.272 người) cấp theo yêu cầu gửi tác giả liên hệ, Data Use Agreement cũng có
   điều khoản không ghép với nguồn dữ liệu khác; PPG đo ở ngón tay (README kho GitHub
   zdzdliu/CAS-BP, đọc 2026-10-30). Nên cân nhắc cùng lúc với Aurora-BP.
4. Đọc toàn văn trước khi trích số liệu: N23 (đã tải), N32 (PMC12282382), N22 (phần còn lại), N39
   (bảng trích xuất), N11, N12, N13, N29 (truy cập mở).
5. Tra thêm IEEE Xplore và Scopus cho các chủ đề T1–T8: nên chạy cùng chuỗi truy vấn và ghi số bản
   ghi như ở mục 2.2.
6. Đối chiếu với nguyên văn mọi con số trong bảng 3 và mục 3.3 trước khi trích vào bản thảo; các số
   ghi "khoảng" ở mục 3.3 được đọc ước lượng từ hình của S4.
