ndhuy1127/ppg-ecg-blood-pressure/docs/plans/WEEK_04.md

# Kế hoạch Tuần 4 — baseline đầu tiên và hoàn thiện thiết kế mạch

## Mục tiêu và ranh giới

- Linh kế thừa reader, validator và split theo người Tuần 2–3; đóng gói pipeline đọc dữ liệu → tiền xử lý → trích đặc trưng → huấn luyện → đánh giá bằng config, triển khai B3 XGBoost dự đoán SBP/DBP và so sánh với B0 trên cùng split.
- Đức Anh tập trung hoàn thiện schematic và PCB ; bàn giao bộ thiết kế mạch v1 để review trước khi đặt sản xuất.
- Huy kế thừa B0/B1 và metrics Tuần 3; bàn giao đặc trưng/SQI v0, kiểm tra mốc ECG–PPG và bổ sung thống kê có xét cấu trúc đo lặp theo người.
- Linh và Huy tiếp tục trên dữ liệu công khai được phép dùng và dữ liệu mô phỏng. B3 là tên baseline XGBoost trong kế hoạch này; không thay danh sách đối chứng của RQ v0.1. B0/B3 trên PulseDB đánh giá BP tuyệt đối, chưa trả lời câu hỏi `ΔSBP/ΔDBP` cross-session sau hiệu chuẩn cuff.
- **Chưa có bằng chứng kiểm chứng thiết bị thật.** Các phép đo chất lượng tín hiệu, đồng bộ, mất gói và tiêu thụ điện chuyển sang khi có phần cứng, hoàn tất bring-up và đáp ứng điều kiện an toàn/phê duyệt cần thiết. Bộ thiết kế, mô phỏng hoặc baseline công khai đạt không chứng minh toàn bộ G1 đã đạt; không tuyên bố thay thế cuff hoặc đạt chuẩn y tế.

**Đầu vào kế thừa đã đối chiếu:** workspace `dev/huy@0d195aa`, ngày 2026-10-11, có reader PulseDB, split `pulsedb-split-v2` với inventory, generator/replay `synthetic-packet-v2`, B0/B1 và MAE/bias/SD. [Báo cáo Tuần 3](../../reports/weekly/week_03/README.md) ghi B0 đã chạy sơ bộ trên CSV train/val ngày 2026-10-08 và 199 test đạt cục bộ ngày 2026-10-10 trên Python 3.13.12. Đây là bằng chứng lịch sử, chưa thay review chéo, CI Python 3.11 hoặc nghiệm thu raw/pool/split. Ref cục bộ `origin/dev/ducanh@40ede49` có BOM V1 và `hardware/schematics/V1.SchDoc`; chưa xác nhận chất lượng thiết kế, PCB hoặc ERC/DRC. Các mô tả Tuần 1 trong README/AGENTS là mốc cũ; kế hoạch này dùng đầu ra và giới hạn trong báo cáo Tuần 2–3, không nâng trạng thái hoàn thành.

## Phân công và tiêu chí kiểm tra

<table width="100%" style="display: table; width: 100%; table-layout: fixed;">
  <colgroup>
    <col width="10%" style="width: 10%;">
    <col width="30%" style="width: 30%;">
    <col width="30%" style="width: 30%;">
    <col width="30%" style="width: 30%;">
  </colgroup>
  <thead>
    <tr>
      <th scope="col" width="10%" valign="top" style="vertical-align: top; text-align: left; overflow-wrap: anywhere; padding: 10px;">Phụ trách</th>
      <th scope="col" width="30%" valign="top" style="vertical-align: top; text-align: left; overflow-wrap: anywhere; padding: 10px;">Nhiệm vụ Tuần 4</th>
      <th scope="col" width="30%" valign="top" style="vertical-align: top; text-align: left; overflow-wrap: anywhere; padding: 10px;">Đầu ra và nghiệm thu</th>
      <th scope="col" width="30%" valign="top" style="vertical-align: top; text-align: left; overflow-wrap: anywhere; padding: 10px;">Đầu vào và phụ thuộc</th>
    </tr>
  </thead>
  <tbody>
    <tr>
      <td width="10%" valign="top" style="vertical-align: top; text-align: left; overflow-wrap: anywhere; padding: 10px;">Linh</td>
      <td width="30%" valign="top" style="vertical-align: top; text-align: left; overflow-wrap: anywhere; padding: 10px;"><p style="margin: 0 0 8px;">Kế thừa reader và validator; đối chiếu raw → reader → inventory → manifest v2, xác nhận nguồn/quyền dùng/checksum/pool và split theo người trước chạy công khai.</p><p style="margin: 0 0 8px;">Đóng gói pipeline bằng config; dựng trước với đặc trưng ECG/PPG đơn giản có định nghĩa rõ, tích hợp module đặc trưng/SQI của Huy khi bàn giao.</p><p style="margin: 0 0 8px;">Cài B3 XGBoost cho SBP và DBP; tích hợp B0 đã có, giữ cùng split và tập quan sát đủ điều kiện để so sánh. Chỉ chạy B1 công khai khi có chronology và calibration hợp lệ, ghi bị chặn nếu thiếu.</p><p style="margin: 0 0 8px;">Mọi tham số học từ dữ liệu, gồm imputation/chuẩn hóa/chọn đặc trưng, chỉ fit trên train; lựa chọn cấu hình bằng validation, không dùng test. Không dùng ABP, nhãn BP, ID người hoặc hash định danh làm đặc trưng dự đoán.</p><p style="margin: 0 0 8px;">Lưu seed, config, commit/trạng thái workspace, phiên bản môi trường, raw/manifest/split hash và log; sinh bảng baseline tự động. Thêm test chống leakage và test tích hợp pipeline.</p></td>
      <td width="30%" valign="top" style="vertical-align: top; text-align: left; overflow-wrap: anywhere; padding: 10px;"><p style="margin: 0 0 8px;">Pipeline, config, hướng dẫn với một lệnh thực tế chạy lại toàn bộ và sinh bảng baseline v0; lưu dự đoán/artifact chi tiết ngoài Git.</p><p style="margin: 0 0 8px;">Bảng B0/B3 ghi riêng SBP/DBP, split, số người/quan sát, đặc trưng, MAE/bias/SD và giới hạn. Chạy lại cùng input/config/seed/môi trường cho kết quả khớp theo tiêu chí tái lập đã ghi.</p><p style="margin: 0 0 8px;">Test từ chối giao người/hash/trùng/mất mẫu, chứng minh luồng fit chỉ dùng train và đầu vào đặc trưng không chứa ABP/nhãn. Log truy được kết quả về nguồn và code.</p><p style="margin: 0 0 8px;">Linh bàn giao pipeline/config/bảng/log cho Huy review thống kê và Đức Anh review giao diện dữ liệu; thiếu raw hợp lệ chỉ nghiệm thu phần chạy giả lập, chưa ghi đạt baseline công khai.</p></td>
      <td width="30%" valign="top" style="vertical-align: top; text-align: left; overflow-wrap: anywhere; padding: 10px;"><p style="margin: 0 0 8px;">Reader/split v2/B0/metrics đã có code; raw/config/pool và chạy lại manifest hai lần còn chờ Linh bàn giao. CSV B0 lịch sử không tự thay manifest v2 đã xác minh.</p><p style="margin: 0 0 8px;">Huy bàn giao định nghĩa đặc trưng, module/SQI, test và ví dụ đầu vào–đầu ra. Đức Anh bàn giao pin map/clock/schema để đối chiếu giao diện tương lai.</p><p style="margin: 0 0 8px;">Khi chưa có module Huy, Linh làm khung pipeline và test với đặc trưng đơn giản/fixture giả lập; PAT để ngoài bộ đầu vào cho đến khi kiểm chứng. Không phụ thuộc thiết bị thật.</p><p style="margin: 0 0 8px;">XGBoost chưa có trong dependency repo; Linh bổ sung phiên bản/cấu hình môi trường và kiểm tra Python 3.11 khi triển khai, không coi là pipeline đã có.</p></td>
    </tr>
    <tr>
      <td width="10%" valign="top" style="vertical-align: top; text-align: left; overflow-wrap: anywhere; padding: 10px;">Đức Anh</td>
      <td width="30%" valign="top" style="vertical-align: top; text-align: left; overflow-wrap: anywhere; padding: 10px;"><p style="margin: 0 0 8px;">Kế thừa BOM/schematic đang có; chốt ordering code, package, footprint, nguồn/mức logic, khả năng mua và gia công/lắp ráp cho cấu hình được nhóm thống nhất.</p><p style="margin: 0 0 8px;">Hoàn thiện schematic ECG, PPG, MCU, nguồn, pin/sạc, giao tiếp, connector, debug và test point. Đối chiếu pin map/interrupt/đường đồng bộ với quy ước timestamp/packet Tuần 3; làm rõ clock và lấy mẫu/FIFO.</p><p style="margin: 0 0 8px;">Chạy ERC, xử lý lỗi và giải thích cảnh báo còn lại; lấy review schematic trước khi hoàn tất PCB.</p><p style="margin: 0 0 8px;">Hoàn thiện placement/routing; kiểm tra vị trí điện cực, LED/photodiode, đường ECG nhạy nhiễu, đường cấp dòng LED, nguồn và đường hồi dòng. Chạy DRC, đối chiếu schematic–PCB, footprint, cực tính, connector và khả năng lắp ráp.</p><p style="margin: 0 0 8px;">Xuất file thiết kế gốc, schematic PDF, ảnh PCB/3D, BOM, Gerber, drill và CPL nếu cần; cập nhật pin map và trình tự bring-up/kiểm tra từng khối khi nhận mạch.</p></td>
      <td width="30%" valign="top" style="vertical-align: top; text-align: left; overflow-wrap: anywhere; padding: 10px;"><p style="margin: 0 0 8px;">Bộ thiết kế mạch v1 đủ để review trước đặt sản xuất; BOM–schematic–PCB khớp version và linh kiện. Có log ERC/DRC, không còn lỗi/cảnh báo chưa xử lý hoặc chưa giải thích và được reviewer chấp thuận.</p><p style="margin: 0 0 8px;">Có test point/debug cho các khối, pin map và trình tự kiểm tra nguồn → giao tiếp → từng cảm biến → timestamp/packet; ghi thông số thiết kế dự kiến riêng với số đo thực tế.</p><p style="margin: 0 0 8px;">Đức Anh bàn giao nguồn thiết kế và bản xuất cho Linh review pin/giao diện, Huy review đồng bộ/tín hiệu; ghi reviewer, version/commit và góp ý đã xử lý. Các export sản xuất lưu nơi được phép ngoài Git theo chính sách repo.</p><p style="margin: 0 0 8px;">Review thiết kế không đồng nghĩa đã đặt sản xuất, bring-up đạt hoặc có bản ghi ECG–PPG thật.</p></td>
      <td width="30%" valign="top" style="vertical-align: top; text-align: left; overflow-wrap: anywhere; padding: 10px;"><p style="margin: 0 0 8px;">Ref cục bộ của Đức Anh có BOM V1/schematic V1, chưa được thẩm định trong lần lập kế hoạch. Cần chốt PPG AFE/fs, package/footprint và ràng buộc cơ khí trước khi khóa các phần liên quan.</p><p style="margin: 0 0 8px;">Linh/Huy cung cấp yêu cầu kênh, metadata, timestamp và góp ý replay. Công cụ mô phỏng v2 đã có nhưng không phải decoder firmware; version V0.1 trong Markdown và V1 trong Word còn chờ Đức Anh thống nhất.</p><p style="margin: 0 0 8px;">Trong lúc chờ cấu hình PPG, Đức Anh rà các khối đã thống nhất, nguồn/debug/test point và chuẩn bị bring-up; ghi phần bị chặn, không chọn linh kiện/fs cuối cùng thay nhóm. Công việc thiết kế độc lập với kết quả B3.</p></td>
    </tr>
    <tr>
      <td width="10%" valign="top" style="vertical-align: top; text-align: left; overflow-wrap: anywhere; padding: 10px;">Huy</td>
      <td width="30%" valign="top" style="vertical-align: top; text-align: left; overflow-wrap: anywhere; padding: 10px;"><p style="margin: 0 0 8px;">Kế thừa B0/B1 và MAE/bias/SD đã có; tập trung review/tích hợp, không giao lại nguyên việc cài baseline Tuần 3.</p><p style="margin: 0 0 8px;">Chốt bộ đặc trưng v0: tên, công thức, đơn vị, kênh đầu vào, cửa sổ/tổng hợp và xử lý giá trị thiếu. Kiểm tra R-peak ECG, PPG foot và ghép nhịp trên tập nhỏ train/validation công khai; sinh hình mốc trên waveform bằng mã.</p><p style="margin: 0 0 8px;">Chỉ bàn giao PAT khi kênh/fs/căn chỉnh, mốc và ý nghĩa thời gian được kiểm tra. PAT là R-peak → PPG foot, PAT = PEP + PTT; không gọi PAT là PTT hoặc ép dịch hai đỉnh trùng nhau.</p><p style="margin: 0 0 8px;">Xây SQI v0 từ dữ liệu hiện có; không giả định IMU, thông tin ADC hoặc tín hiệu prototype. Bàn giao module đặc trưng/SQI, test, version và ví dụ đầu vào–đầu ra cho Linh.</p><p style="margin: 0 0 8px;">Bổ sung bootstrap theo người và CI 95% khi đủ điều kiện; review MAE/bias/SD riêng SBP/DBP. Chỉ tính ΔBP/các chỉ số biến thiên khi metadata thời gian/phiên và mốc hiệu chuẩn hợp lệ. Tổng hợp báo cáo Tuần 4 với bằng chứng và phụ thuộc còn mở.</p></td>
      <td width="30%" valign="top" style="vertical-align: top; text-align: left; overflow-wrap: anywhere; padding: 10px;"><p style="margin: 0 0 8px;">Định nghĩa đặc trưng, SQI v0, module thống kê, test và hình kiểm tra mốc ECG–PPG tái tạo được; ghi rõ dữ liệu công khai/mô phỏng, nguồn/config và kết quả chạy.</p><p style="margin: 0 0 8px;">Linh gọi được giao diện bàn giao, nhận đúng số dòng/thứ tự/đơn vị và cờ chất lượng/giá trị thiếu; test xử lý đầu vào lỗi. PAT chưa đủ căn cứ được đánh dấu chưa bàn giao, không làm chặn bộ đặc trưng cơ bản.</p><p style="margin: 0 0 8px;">Bootstrap lấy lại cụm người và giữ toàn bộ quan sát lặp; B0/B3 dùng cùng lượt lấy mẫu để so sánh. Ghi seed, số lượt, phương pháp CI, số người và lý do chưa tính nếu dữ liệu không đủ điều kiện; không bootstrap cửa sổ độc lập.</p><p style="margin: 0 0 8px;">Huy bàn giao module/định nghĩa cho Linh, nhận dự đoán/log để review thống kê và bàn giao yêu cầu kiểm chứng đồng bộ cho Đức Anh. Báo cáo gắn từng trạng thái với output, kiểm tra và reviewer.</p></td>
      <td width="30%" valign="top" style="vertical-align: top; text-align: left; overflow-wrap: anywhere; padding: 10px;"><p style="margin: 0 0 8px;">Linh cung cấp waveform được phép dùng, mapping mẫu/người, kênh/fs/đơn vị/căn chỉnh đã xác minh, inventory/manifest/hash và dự đoán B0/B3. Đức Anh cung cấp pin map/clock/schema để Huy review yêu cầu thiết bị tương lai.</p><p style="margin: 0 0 8px;">Thiếu waveform hoặc thông tin thời gian, Huy làm định nghĩa/API, test giả lập và module thống kê trước; hình công khai/PAT và CI dữ liệu thật vẫn ghi bị chặn. Packet giả lập có payload ngẫu nhiên không dùng kiểm tra hình thái/PAT/BP.</p><p style="margin: 0 0 8px;">Quy tắc missing/SQI, trọng số, SD và CI phải được review trước phân tích; ngưỡng chỉ khóa trên pilot/validation. Linh review module/test, Đức Anh review ý nghĩa thời gian; không chờ số đo thiết bị để hoàn thiện phần độc lập.</p></td>
    </tr>
  </tbody>
</table>

**Vị trí đầu ra dự kiến:**

- **Linh:** Kế thừa `software/pulsedb/`, `software/data_io/split_manifest.py`, `software/models/constant_baselines.py` và `scripts/run_b0_pulsedb_csv.py`; pipeline ở các module chức năng trong `software/`, runner ở `scripts/`, config tại `configs/data/` và `configs/models/`, test tại `tests/`. Manifest/dữ liệu dẫn xuất có version tại `data/processed/`, log/dự đoán/model/bảng chạy tại `runs/` ngoài Git; bảng/hình tổng hợp được phép chia sẻ tại `reports/` phải sinh bằng mã, không chứa ID người.
- **Đức Anh:** Kế thừa BOM/schematic của nhánh Đức Anh, nguồn tại `hardware/bom/`, `hardware/schematics/`, `hardware/pcb/`; pin map/packet tại `configs/hardware/`, kế hoạch bring-up/đo thật tại `hardware/test_reports/`. Ghi nơi bàn giao bản xuất review/sản xuất được phép; Gerber/output bị ignore không tự xuất hiện trong PR.
- **Huy:** Đặc trưng/SQI tại `software/signal_processing/` và `software/feature_extraction/`, bootstrap tại `software/evaluation/`, test tại `tests/`; định nghĩa/giao diện trong `docs/protocol/`, hình tái tạo tại `reports/figures/`, tổng hợp tại `reports/weekly/week_04/README.md` (dự kiến).

Đây là vị trí **dự kiến cho công việc Tuần 4**, chưa phải sản phẩm đã tạo. Kế thừa file cùng chức năng; báo cáo ghi đường dẫn thực và lệnh đã chạy. Tác vụ lập kế hoạch này chỉ tạo file kế hoạch, không triển khai pipeline, thiết kế hoặc tạo tài liệu phụ.

## Việc chung và mốc đóng tuần

1. **Đầu tuần:** Linh–Huy thống nhất giao diện đặc trưng/SQI, thứ tự mẫu/cột, missing, đơn vị quan sát, pool/split/hash và quy tắc so sánh B0/B3. Linh bàn giao nguồn/checksum/config và kế hoạch chạy raw hai lần; Huy bàn giao B0/B1/metrics hiện có để Linh tích hợp. Đức Anh chốt BOM/package/footprint/pin map và các điểm cần xác nhận PPG/clock/schema; lấy góp ý Linh–Huy. Ghi quyết định, người góp ý, version/commit và blocker trong báo cáo hoặc PR hiện có.
2. **Giữa tuần:** Linh chạy thử pipeline với đặc trưng đơn giản, bàn giao log/bảng validation cho Huy; Huy bàn giao module/ví dụ, review hình R-peak/foot và SQI cùng Linh. Đức Anh bàn giao schematic/BOM/ERC cho Linh–Huy review giao diện, đường tín hiệu và test point trước khi hoàn tất routing PCB. Việc chưa nhận đầu vào tiếp tục theo phần độc lập trong bảng, không dùng giả lập để đánh dấu phần công khai/thiết bị hoàn thành.
3. **Quy tắc đánh giá:** B0 và B3 fit train, so sánh trên cùng validation trong giai đoạn phát triển; giữ cùng tập đủ điều kiện/weighting, ghi số mẫu bị gắn cờ hoặc loại theo quy tắc đã review. SQI không được lọc khác nhau để tạo so sánh sai lệch. Chỉ đánh giá test sau khi khóa model, đặc trưng, cửa sổ, ngưỡng và hyperparameter; không quay lại tuning bằng test. Sai số là `prediction - reference` (mmHg), MAE/bias chính trung bình đều theo người; SD ghi rõ `ddof=1`, phạm vi và trường hợp không xác định. CI giữ cụm người, không thay SD bằng CI hoặc trung bình SD từng người thành SD chung.
4. **Giới hạn nhãn và thời gian:** ABP PulseDB chỉ dùng làm tham chiếu/nhãn, không làm đặc trưng hoặc tín hiệu dẫn đường cho trích đặc trưng/SQI. ABP không phải cuff; một cuff event chỉ có một cặp nhãn độc lập. B1 thuộc kịch bản có hiệu chuẩn riêng trước evaluation, không trùng mẫu/record/event và không báo cáo như người mới chưa hiệu chuẩn. Không tạo chronology từ thứ tự dòng/file; thiếu metadata thì B1 công khai và ΔBP giữ trạng thái chưa đủ điều kiện.
5. **Cuối tuần:** Linh chạy lại pipeline/config và bảng baseline; Huy đối chiếu metrics/CI/hình với nguồn, nhận log từ Linh và tổng hợp báo cáo; Đức Anh bàn giao BOM–schematic–PCB/bản xuất/ERC/DRC/pin map/bring-up để review chéo. Mỗi người cung cấp input/version/hash, seed, commit, môi trường, lệnh/log, reviewer và góp ý đã xử lý. Giữ raw bất biến; truy được mọi dữ liệu dẫn xuất, bảng và hình về raw/script/config/split/seed/commit.
6. **Mốc đóng tuần dự kiến:** Có pipeline và bảng B0/B3 tái lập; bộ schematic/PCB đã review; module đặc trưng/SQI và đánh giá thống kê sơ bộ chạy được, CI chỉ khi đủ điều kiện. Chạy kiểm tra phù hợp `ruff check .`, `pytest -q`, `python scripts/check_environment.py`, `python -m pip check`, cùng CI Python 3.11/review theo repo. Lệnh pipeline do Linh bàn giao sau triển khai, chưa có lệnh train/evaluate chính thức tại lần lập kế hoạch. Chỉ ghi đạt phần có output, log/test và review; phần thiếu đầu vào ghi người xử lý và việc chuyển tiếp. Mọi phép đo thiết bị thật vẫn **chờ kiểm chứng**, không đóng toàn bộ G1.

## Blocker và việc chuyển tiếp

- **Raw/pool/split chưa nghiệm thu:** Linh bổ sung quyền dùng, đúng file/checksum, mapping người và quan hệ với holdout gốc; chạy hai lần đối chiếu raw–reader–inventory–manifest/hash, Huy review. Split v2 giữ mọi dòng reader của một file, không tự tái tạo pool 1.000 đoạn cũ; hash waveform chỉ bắt trùng chính xác, chưa chứng minh hết overlap. Thiếu đầu vào thì triển khai/test pipeline giả lập trước, giữ bảng baseline công khai ở trạng thái chờ.
- **B1 công khai còn thiếu chronology/calibration:** Linh–Huy xin metadata và khóa quy tắc hiệu chuẩn/tổng hợp trước evaluation. Kế thừa module/test B1 Tuần 3; không dựng metadata thay thế hoặc dùng nhãn đánh giá để lấp phần thiếu. ΔBP và chỉ số biến thiên chỉ chuyển sang chạy khi có căn cứ.
- **Đặc trưng/PAT/SQI chưa được bàn giao và khóa:** Huy kiểm chứng kênh/fs/căn chỉnh/mốc trên train/validation; Linh dùng đặc trưng cơ bản trước. Không giả định thông tin ADC/IMU, không dùng payload packet ngẫu nhiên như waveform sinh lý; giữ cờ chất lượng/missing và ghi ảnh hưởng nếu đổi quy tắc loại.
- **Thiết kế còn phụ thuộc cấu hình và review:** Đức Anh giải quyết PPG AFE/fs, BOM/package/footprint, ràng buộc cơ khí và version packet/clock/FIFO với nhóm. File schematic có trong ref chưa chứng minh ERC/DRC đạt hoặc đủ để sản xuất. Khi chưa chốt đầu vào, giữ phần liên quan ở trạng thái chờ, hoàn thiện các khối độc lập.
- **Chưa có phần cứng/bản ghi thật:** Đức Anh chuyển đo chất lượng, offset/jitter/drift, mất gói và điện năng sang sau khi có mạch/bring-up; kế thừa kế hoạch bản ghi 10 phút Tuần 3 và chốt phương pháp với Linh/Huy. Phải có raw/config/checksum/log và mốc tham chiếu đồng bộ được kiểm chứng; không lấy PAT làm clock offset. Mọi đo người cần điều kiện an toàn/phê duyệt theo repo.
- **CI/review và G1 còn mở:** Kết quả test cục bộ Python 3.13.12 trong báo cáo chưa thay CI Python 3.11/review chéo. Nhóm xác nhận định nghĩa, tiêu chí và lịch G1; đầu ra phần mềm/thiết kế đã review chỉ là nghiệm thu phần tương ứng. Việc còn thiếu chuyển tiếp cùng người phụ trách và bằng chứng cần bổ sung, không tự dựng G1–G6 hoặc đánh dấu toàn bộ cổng đạt.

## Vấn đề cần nhóm quyết định

- **Linh–Huy/nhóm:** Pool/split chính thức, quyền sử dụng/raw checksum, ID/alias/record gốc, trọng số train B0 và đơn vị quan sát; xác nhận ảnh hưởng khi dùng split v2 thay pool CSV lịch sử. Không tái gộp holdout có sẵn hoặc chọn seed/split bằng test.
- **Linh–Huy:** Bộ đặc trưng đầu tiên, giao diện/SQI/missing, mốc foot/ghép nhịp, căn cứ bàn giao PAT và điều kiện đánh giá B1; cửa sổ/ngưỡng chỉ khóa trên pilot/validation. Ghi các lựa chọn này là đề xuất trước thí nghiệm, không coi kế hoạch là phương pháp đã khóa.
- **Huy–Linh/nhóm:** SD báo cáo, phương pháp/số lượt bootstrap/CI 95%, số người đủ điều kiện, weighting và cùng tập so sánh; beta, Bland–Altman đo lặp và risk–coverage còn cần định nghĩa riêng nếu triển khai. Không tự xuất chỉ số thiếu metadata hoặc căn cứ.
- **Đức Anh/nhóm:** Cấu hình linh kiện/PPG/fs/package/footprint, pin map/clock/interrupt, version packet chính thức và ràng buộc lắp ráp; thống nhất khác biệt V0.1/V1. Thông số mô phỏng không trở thành thông số phần cứng cuối cùng. Bộ file thiết kế cần reviewer chấp thuận trước quyết định đặt sản xuất/mua linh kiện.
- **Nhóm/giảng viên:** Phạm vi/lịch G1 và bằng chứng thiết bị còn thiếu; protocol/ethics, an toàn và điều kiện trước thu dữ liệu người. Điều chỉnh Tuần 4 ưu tiên schematic/PCB đã được trưởng nhóm quyết định theo yêu cầu; tiêu chí G1 vẫn chưa được khóa trong repo.
