ndhuy1127/ppg-ecg-blood-pressure/scripts/README.md

# Scripts

Các script hỗ trợ chạy thử và kiểm tra môi trường. Các lệnh bên dưới dùng thư
mục gốc repository; demo còn hỗ trợ chạy trực tiếp từ thư mục làm việc khác.

## Mỗi file làm gì và dùng dữ liệu nào

| File | Mục đích | Đầu vào / dữ liệu trong code | Đầu ra |
| --- | --- | --- | --- |
| [demo_week_03_baselines.py](demo_week_03_baselines.py) | Chạy thử B0/B1 và metrics cùng nhau | Tự sinh train, calibration, evaluation; các mảng BP `(3, 2)`, ID và thời điểm giả lập; seed `20261003` | JSON `SYNTHETIC` in ra Terminal |
| [check_environment.py](check_environment.py) | Kiểm tra import thư viện, phép tính NumPy, Python đúng `requires-python` và mọi pin trong `requirements.txt` | Mảng tự tạo `[1.0, 2.0, 3.0]`; `pyproject.toml`, `requirements.txt`; không nhận dataset | Phiên bản Python/thư viện; liệt kê từng chỗ lệch; exit 0 chỉ khi khớp hết, exit 1 nếu lệch |
| [run_b0_pulsedb_csv.py](run_b0_pulsedb_csv.py) | Fit B0 trên train, đánh giá val từ manifest CSV | Các cột trong bảng bàn giao của Linh; kiểm tra metadata mọi split, dùng nhãn train/val | Metrics tổng hợp và JSON truy vết trong `runs/`; không dùng nhãn test hoặc chạy B1 |
| [build_pulsedb_split.py](build_pulsedb_split.py) | Tạo split có inventory đối chiếu từ reader repo | Một file raw và config/checksum/pool đã chốt; giữ mọi dòng reader, hoặc mọi dòng của N người khi config có `subject_subsample` (đọc từng phần bằng `h5py`) | Inventory, manifest, config và report trong thư mục mới; không ghi đè bàn giao cũ |
| [compare_pulsedb_readers.py](compare_pulsedb_readers.py) | Kiểm reader `h5py` trả đúng các dòng như reader `mat73` | Một file `.mat` PulseDB vừa RAM (cả hai reader đọc trọn file) | JSON in ra Terminal: số dòng, số sai khác theo trường, `pass`; không in ID, nhãn hay tín hiệu; exit 1 nếu có sai khác |
| [run_b3_pulsedb.py](run_b3_pulsedb.py) | Fit B0/B3 XGBoost trên train, đánh giá val | Raw `.mat`, thư mục split v2 và config `configs/models/b3_pulsedb_v0.json` hoặc `_v1.json` (QC nhãn, trọng số theo người, đọc `h5py` từng phần); không chấm test | Report, bảng baseline, dự đoán val và model trong thư mục mới của `runs/` |
| [run_b3_multiseed.py](run_b3_multiseed.py) | Chạy B3 với ≥ 3 seed XGBoost trên cùng split, config chỉ khác `b3.seed`; kiểm tính tất định ([hướng dẫn](../docs/protocol/experiment_tracking.md)) | Raw `.mat`, thư mục split v2, config B3 (mặc định `_v1.json`), `--seeds` | `runs/b3_multiseed/<thời điểm>/`: một lần chạy B3 cho mỗi seed, `seed_spread.csv`, `multiseed_table.md`, `report.json` (`DETERMINISTIC`/`DIFFERS`); không ghi đè |
| [collect_runs.py](collect_runs.py) | Gom mọi `report.json` của runner trong `runs/` thành một bảng sinh tự động; liệt kê lần chạy bị bỏ qua và lý do | `runs/<experiment>/` (mặc định `b3_pulsedb`, `b2_pulsedb`, `b3_multiseed`) | `runs/registry/<thời điểm>/`: `runs.csv`, `runs.md`, `report.json`; không ghi đè |
| [run_b2_pulsedb.py](run_b2_pulsedb.py) | B2 (nhân khẩu học + HR) cùng B0/B3 trên val, hai bảng định trước ([định nghĩa](../docs/protocol/b2_pulsedb_definition.md)); chỉ chạy khi config ở `APPROVED_NOT_TEST_EVALUATED`, config, định nghĩa và mã đã commit nguyên trạng, split đúng hash ghim (split B3 v1) | Raw `.mat`, thư mục split v2, `configs/models/b2_pulsedb_v1.json` (v0 giữ làm lịch sử) | `runs/b2_pulsedb/<thời điểm>/`: bảng, `hr_mask.csv`, dự đoán (có ID, ngoài Git), `report.json`; không ghi đè |
| [demo_week04_huy.py](demo_week04_huy.py) | Kiểm tra mốc R/foot, PAT, đặc trưng/SQI `features-sqi-v1` và bootstrap trên fixture giải tích | Config `configs/data/week04_huy.json`; fixture SYNTHETIC tự tạo | JSON, CSV fixture và SVG, mặc định trong `runs/demo_week04_huy/`; từ chối ghi đè (từ 2026-10-25) |
| [week05_fiducials.py](week05_fiducials.py) | Tuần 5: bản ghi SYNTHETIC có đáp án, xuất bộ đoạn train PulseDB theo `review_plan`, hình và công cụ đánh dấu tay (có `--resume`), chạy mọi phương pháp mốc, so với đánh dấu tay, độ lặp lại và ngưỡng chấp nhận | Config `configs/data/week05_huy.json`; SYNTHETIC tự tạo hoặc raw + split v2 (chỉ train; không bao giờ test) | Lệnh `synth`/`export`/`plot`/`annotate`/`detect`/`compare`/`repeat`/`gate`; mỗi lệnh ghi provenance và từ chối ghi đè |
| [simulate_packets.py](simulate_packets.py) | Sinh/replay packet giả lập và kiểm tra lỗi | Config/seed SYNTHETIC: v2 (6 case hoặc JSON giả lập) hoặc v3: `configs/hardware/packet_simulation_v3.json` (V0.1, 13 case) hoặc `packet_simulation_v3_v02.json` (V0.2, thêm 6 case IMU, version, thông tin thiết bị, mốc `SAMP`) | v2: packet, timeline/gap và report; v3: `stream.bin` theo layout V0.1 hoặc V0.2, metadata phiên và report. Output mới; không phải đồng bộ phần cứng |
| [device_command.py](device_command.py) | Xếp một lệnh cho thiết bị khi `packet_logger.py record --commands` đang chạy (Packet Schema V0.2 mục 13): `ping`, `set-ppg-led`, `mark --event cuff_end\|operator` (`MARK_EVENT`, packet sự kiện `0xC1` mã 2/4, mốc là lúc thiết bị nhận lệnh) | Thư mục bản ghi (`--recording`), mã LED 0 … 127 (`0x7F`, trần của nghiên cứu; mã lớn hơn bị từ chối, trừ cờ `--allow-over-firmware-limit`, chỉ cho bring-up không người để kiểm firmware tự từ chối) | Một dòng JSON thêm vào `command_inbox.jsonl`; vòng `record` gửi, gửi lại và ghi xác nhận `0xD3` vào `commands_sent.jsonl` |
| [packet_logger.py](packet_logger.py) | Logger phía máy tính (`packet-logger-v3`): `record` một nguồn byte, `replay` một raw; kiểm mã LED đã khóa (`ppg_led_lock`) so với `0xD2` | File byte (`--source-file`), cổng serial (`--port`, `--duration-s`, `--baud`; pyserial 3.5) hoặc `raw.bin`, metadata phiên (`packet-session-metadata-v1`; v0 vẫn đọc được, trừ `record` của `DEVICE`), `configs/hardware/packet_logger.json`; dữ liệu người cần `--subject-id SUB###` và `--session-id S###` bằng metadata | Raw bất biến, `t_rx` riêng, decode/issue/gap, session manifest có hash. Dữ liệu người chỉ ở `data/raw/<subject_id>/<session_id>/<recording>/` (từ chối `runs/`); bring-up và SYNTHETIC ở `runs/packet_logger/`; output `replay` không bao giờ vào `data/raw/` |

Hướng dẫn logger: [decoder, kiểm tra mục 12, đầu ra và câu hỏi mở](../docs/protocol/packet_logger.md).
Hướng dẫn runner CSV: [chạy B0 trên PulseDB](../docs/protocol/run_b0_pulsedb_csv.md).
Hướng dẫn split mới: [inventory, config, hash và giới hạn](../docs/protocol/run_pulsedb_split.md).
Hướng dẫn B0/B3: [đặc trưng, model, đầu ra và giới hạn](../docs/protocol/run_b3_pulsedb.md).
Hướng dẫn mô phỏng: [schema riêng, expected results và giới hạn](../docs/protocol/packet_simulation.md).
Hướng dẫn demo Tuần 4: [đặc trưng, SQI và bootstrap](../docs/protocol/week04_features_sqi_bootstrap.md).
Hướng dẫn Tuần 5: [mốc thứ hai, PAT hợp lệ, so với đánh dấu tay](../docs/protocol/week05_fiducials_pat_validity.md).
Runner CSV có đầu vào riêng; các mô tả dữ liệu tự tạo bên dưới chỉ áp dụng demo.
Có thể mở `run_b0_pulsedb_csv.py` và bấm **Run Python File in Terminal**:
không truyền đối số thì script dùng `configs/data/b0_pulsedb_validation.json`
với CSV cục bộ đã bàn giao và kiểm tra hash trước khi chạy. CSV khác cần truyền
đường dẫn và đơn vị rõ ràng; xem hướng dẫn runner ở trên.

Demo không cần file dữ liệu đầu vào hoặc đối số CLI. Nó không đọc PulseDB,
không chứa nhãn/người tham gia thật và không ghi kết quả ra file. Các ID
`SYN_*` và thời điểm là số do code tạo, không thay metadata dự án. B0 dùng
train riêng; B1 dùng calibration của người đánh giá trước evaluation trong
ví dụ. Các hằng số và mảng chỉ tồn tại trong bộ nhớ của lần chạy.

## Chạy demo bằng nút VSCode

1. Mở `scripts/demo_week_03_baselines.py`.
2. Chọn interpreter `.venv` của repo nếu chưa chọn môi trường có dependency.
3. Bấm **Run Python File in Terminal** ở góc phải editor.
4. Xem JSON ở Terminal phía dưới. Không cần chạy các module lần lượt hoặc mở
   `launch.json`.

Demo tự thêm đường dẫn repo khi chạy trực tiếp để import package `software`.
Trong Windows, interpreter đã dùng là `.venv\Scripts\python.exe`; workspace
cũng đã kiểm tra chạy được demo với `.venv\bin\python.exe`.

Nếu dùng terminal từ Git root:

```powershell
.\.venv\Scripts\python.exe scripts/demo_week_03_baselines.py
# Cách chạy theo module cũng được hỗ trợ:
.\.venv\Scripts\python.exe -m scripts.demo_week_03_baselines
.\.venv\Scripts\python.exe scripts/check_environment.py
```

## Đọc kết quả demo

JSON có `source_type`, `purpose`, `seed`, `python`, `numpy`, `columns`, `unit`,
`error`, `sd_ddof`, `sd_if_n_lt_2` và hai mục `B0`, `B1`. Mỗi mục baseline có:

| Trường | Nội dung |
| --- | --- |
| `sample_weighted` | MAE/bias/SD riêng SBP/DBP tính từ tất cả mẫu, kèm `n` |
| `by_subject` | Các metrics riêng từng người; SD là `null` khi người chỉ có một mẫu |
| `subject_balanced` | MAE/bias trung bình đều theo người, kèm `n_subjects` |

Script hiện in metrics, không in các mảng train/calibration/evaluation hoặc
từng dự đoán. Xem [README models](../software/models/README.md) và
[README evaluation](../software/evaluation/README.md) để gọi API lấy những
kết quả đó. Seed giúp tái lập trong cùng môi trường; các số giả lập chỉ kiểm
chứng code/công thức, không chứng minh hiệu năng dự đoán BP trên dữ liệu thật.

Chi tiết phương pháp và giới hạn:
[quy ước Tuần 3](../docs/protocol/week_03_baselines_metrics.md).
