ndhuy1127/ppg-ecg-blood-pressure/software/README.md

# Phần mềm

Các module được tách theo trách nhiệm:

- **data_io/**: đọc, kiểm tra schema và ghi dữ liệu được phép.
- **preprocessing/**: làm sạch và chuẩn hóa tín hiệu.
- **signal_processing/**: xử lý ECG/PPG và đánh giá chất lượng tín hiệu.
- **feature_extraction/**: trích đặc trưng, gồm đặc trưng PAT theo định nghĩa.
- **models/**: huấn luyện và suy luận mô hình.
- **evaluation/**: chỉ số và quy trình đánh giá.
- **deployment/**: giao diện triển khai sau khi mô hình được thẩm định.

## Code đã có và nên đọc file nào

Đã có reader/validator PulseDB, split theo người có inventory, baseline B0/B1/B3,
mốc ECG/PPG và đặc trưng/SQI sơ bộ, bootstrap theo người, metrics BP, mô phỏng
packet và decoder/kiểm tra packet cho logger. Các phần này được kiểm thử bằng dữ liệu giả lập; sự tồn tại của code không
chứng minh dataset/split đã được nghiệm thu. `preprocessing/` và `deployment/` chỉ
chứa `__init__.py`.

| File / thư mục | Làm gì | Dữ liệu đi qua |
| --- | --- | --- |
| [_bp_validation.py](_bp_validation.py) | Kiểm tra shape, kiểu số, giá trị hữu hạn và mã người dùng chung | Mảng BP `(n, 2)` hoặc danh sách ID được caller cung cấp |
| [_provenance.py](_provenance.py) | SHA-256 của file text tracked (code, config JSON) sau khi đổi CRLF thành LF | Byte file → hash không phụ thuộc checkout Windows/Linux |
| [pulsedb/reader.py](pulsedb/reader.py), [pulsedb/validator.py](pulsedb/validator.py) | Đọc file Subset PulseDB `.mat`; gắn cờ NaN/Inf, nhãn bất thường, waveform trùng (không xóa dòng) | File `.mat` → `PulseSegment`; segment → bảng cờ |
| [data_io/split_manifest.py](data_io/split_manifest.py) | Inventory, split theo người `pulsedb-split-v2`, kiểm tra bảo toàn/leakage, CSV chuẩn | Segment → inventory → manifest train/val/test |
| [signal_processing/fiducials.py](signal_processing/fiducials.py) | Chuẩn bị kênh, R-peak, PPG foot tiếp tuyến, ghép PAT; phương pháp ứng viên Tuần 5 (`derivative_energy`, `d2_max`, `valley_min`) chọn qua `SignalConfig`, mặc định giữ v1 | Vector ECG/PPG + fs/clock/timestamp → mốc và PAT |
| [signal_processing/pat_validity.py](signal_processing/pat_validity.py) | PAT hợp lệ Tuần 5: ghép R–foot trong khoảng R–R, gắn nhãn `out_of_range`/`outlier` (MAD), không xóa nhịp | Thời điểm R và foot → trạng thái từng nhịp; không đọc BP |
| [evaluation/fiducial_agreement.py](evaluation/fiducial_agreement.py) | So mốc tự động với đánh dấu tay: ghép một–một tối ưu, TP/FP/FN, bias/MAE/SD; chỉ train/val; từ chối đáp án SYNTHETIC nếu không có cờ | Bảng đánh dấu tay + bảng detections → summary và per_record |
| [feature_extraction/week04.py](feature_extraction/week04.py) | Đặc trưng và cờ SQI theo cửa sổ `features-sqi-v1` | Cửa sổ ECG/PPG có metadata → đặc trưng, quality, flags |
| [feature_extraction/motion_sqi.py](feature_extraction/motion_sqi.py) | Cờ chuyển động mạnh từ IMU `motion-sqi-v0` (ngưỡng nháp, chưa khóa) | Gia tốc (g) và gyro (°/s) (n, 3), cửa sổ, bias gyro → `motion` / `no_motion_detected` / `not_evaluable` |
| [models/constant_baselines.py](models/constant_baselines.py) | Tính dự đoán hằng số B0/B1 | Nhãn train hoặc calibration → cặp dự đoán `[SBP, DBP]` |
| [models/xgboost_baseline.py](models/xgboost_baseline.py) | B3: XGBoost riêng SBP/DBP | Đặc trưng + nhãn train → model; đặc trưng val → `[SBP, DBP]` |
| [pulsedb/features.py](pulsedb/features.py), [pulsedb/pipeline.py](pulsedb/pipeline.py) | 12 đặc trưng ECG/PPG đơn giản; fit B0/B3 trên train, đánh giá val | Đoạn PulseDB + manifest/inventory split v2 → dự đoán và metrics |
| [evaluation/bp_metrics.py](evaluation/bp_metrics.py) | Tính MAE/bias/SD và tổng hợp theo người | Nhãn tham chiếu + dự đoán + ID người → kết quả đánh giá |
| [evaluation/run_registry.py](evaluation/run_registry.py) | Đọc `report.json` của runner B2/B3 thành dòng truy vết được (commit, hash config/raw/split, seed, metrics + CI); so độ lệch giữa các seed | `report.json` đã đọc thành dict → dòng bảng, `seed_spread` |
| [evaluation/subject_bootstrap.py](evaluation/subject_bootstrap.py) | CI bootstrap percentile lấy mẫu theo người; đánh giá bảng dự đoán theo manifest | Dự đoán + manifest/inventory → metrics và CI |
| [data_io/packet_simulation.py](data_io/packet_simulation.py) | Sinh/replay packet ECG/PPG SYNTHETIC `synthetic-packet-v2` với 6 case lỗi | Config/seed → packet → timeline, gap, offset |
| [data_io/packet_wire.py](data_io/packet_wire.py) | Codec byte Packet Schema V0.1: CRC-16/CCITT-FALSE, đóng gói, decoder dò `SYNC` theo luồng | Byte (từng đoạn bất kỳ) → packet đã kiểm CRC/header + log lỗi, byte bị bỏ |
| [data_io/packet_receiver.py](data_io/packet_receiver.py) | Kiểm tra mục 12 của schema V0.1/V0.2 theo từng phiên/kênh (`packet-logger-v3`), metadata phiên `packet-session-metadata-v1` | Packet theo thứ tự đến → issue, gap, bảng packet/mẫu có `chain_id` |
| [data_io/command_wire.py](data_io/command_wire.py), [data_io/command_desk.py](data_io/command_desk.py) | Khung lệnh PC → thiết bị (V0.2 mục 13) và hàng lệnh trong lúc `record`: một lệnh chờ một lúc, gửi lại cùng `CMD_SEQ`, ghi nhật ký | Dòng JSON trong `command_inbox.jsonl` → byte gửi cổng serial; packet `0xD3` → nhật ký |
| [pulsedb/features_b2.py](pulsedb/features_b2.py), [pulsedb/pipeline_b2.py](pulsedb/pipeline_b2.py) | B2: năm đặc trưng nhân khẩu học và HR ước lượng từ đỉnh ECG (chưa nghiệm thu); hai bảng `full` và `hr_available`, fit trên train, chỉ chấm val | Segment PulseDB (không đọc ABP, nhãn, ID) → đặc trưng; manifest + inventory → dự đoán và metrics |
| [pulsedb/h5_reader.py](pulsedb/h5_reader.py) | Đọc từng phần file Subset PulseDB (HDF5) bằng `h5py`: chỉ cột ID hay chỉ các dòng cần, theo khối; cùng giá trị như `reader.py` | File `.mat` v7.3 → `PulseSegment` của các dòng yêu cầu |
| [pulsedb/visualizer.py](pulsedb/visualizer.py) | Vẽ đoạn tín hiệu PulseDB để xem bằng mắt (notebook) | `PulseSegment` → hình matplotlib |
| [evaluation/fiducial_gate.py](evaluation/fiducial_gate.py) | Cổng nghiệm thu mốc R/foot đăng ký trước (Tuần 5): nhóm chọn, nhóm xác nhận chỉ chấm phương pháp thắng; độ lặp lại của người đánh dấu | Bảng so khớp mốc tự động/tay → pass/fail theo ngưỡng trong config |
| [data_io/packet_simulation_v3.py](data_io/packet_simulation_v3.py) | Sinh luồng byte SYNTHETIC `synthetic-packet-v3` đúng layout V0.1, 13 case lỗi | Config/seed → `stream.bin` + metadata phiên |

Chi tiết đầu vào/đầu ra nằm trong [README models](models/README.md) và
[README evaluation](evaluation/README.md).

## Cách chạy để xem kết quả

Mở [demo_week_03_baselines.py](../scripts/demo_week_03_baselines.py) trong
VSCode, chọn interpreter `.venv` của repo rồi bấm **Run Python File in
Terminal**. Demo tự gọi validation, B0/B1 và metrics; không cần chạy lần lượt
những file trong `software/`. Kết quả JSON hiện ở Terminal.

Các module `software/` chứa hàm/lớp được import và gọi với dữ liệu. Chúng không
có chương trình tạo ví dụ hoặc in kết quả khi chạy riêng. Xem
[README scripts](../scripts/README.md) cho cách chạy và
[README tests](../tests/README.md) cho cách kiểm tra.

## Dữ liệu được chứa và lưu ở đâu

Code B0/B1/metrics không chứa dataset thật và không tự đọc hoặc ghi file dữ
liệu. Các mảng được truyền vào và xử lý trong bộ nhớ; B0/B1 lưu các hằng số đã
fit trong đối tượng Python. Demo/test tự tạo số và ID giả lập.

Quy ước chung: cột **[SBP, DBP]**, đơn vị **mmHg**, ID người là chuỗi giả danh.
Một dòng phải là đơn vị quan sát đã được thống nhất; nhiều cửa sổ cùng lần đo
cuff không tạo nhiều nhãn độc lập. `_bp_validation.py` kiểm tra tính hợp lệ
kỹ thuật, không xác minh nguồn nhãn, split, chronology hoặc ngưỡng BP sinh lý.
Nó trả mảng hợp lệ hoặc báo `ValueError`; không tự bỏ dòng hay điền dữ liệu
thiếu. Hàm `finite_result()` còn báo lỗi khi phép tính tạo giá trị không hữu hạn.

Định nghĩa khoa học, trường hợp lỗi và các quyết định còn mở được giữ
trong [quy ước B0/B1 và metrics](../docs/protocol/week_03_baselines_metrics.md).
Kết quả giả lập chỉ kiểm chứng code/công thức, chưa chứng minh hiệu năng dự án.
