ndhuy1127/ppg-ecg-blood-pressure/docs/ethics/README.md

# Hồ sơ đạo đức

Thư mục này lưu khung hồ sơ, các biểu mẫu trống và những tài liệu được phép quản lý bằng Git. Không commit hồ sơ có chữ ký, dữ liệu cá nhân hay thông tin của người tham gia.

**Trạng thái (cập nhật 2026-10-31):** bộ hồ sơ là bản nháp, **chưa nộp và chưa được phê duyệt**. Nhóm chưa tuyển người và chưa đo trên người, kể cả trên thành viên nhóm. Ngày 2026-10-31, nhóm rà soát lần cuối toàn bộ hồ sơ, đối chiếu với quy định hiện hành, mẫu của các hội đồng trong nước, CIOMS 2016 và ICH E6 4.8.10 (có phản biện độc lập), rồi viết lại năm file cũ theo dạng sẵn sàng nộp và thêm bốn file mới. Kết luận: hồ sơ đủ để thầy rà soát, nhưng **chưa nộp được** cho tới khi xong các mục ở phần "Còn thiếu trước khi nộp".

## Danh mục

Mỗi file có một ghi chú nội bộ ở đầu (các dòng trích dẫn `>`: lịch sử, quyết định, nguồn); phần dưới đường kẻ là đúng nội dung bản nộp. Ô `[...]` là chỗ còn trống, chờ thầy, đơn vị hoặc hội đồng. Bộ Word gửi thầy ngày 2026-10-31 (lưu ngoài repo) được dựng từ phần dưới đường kẻ của các file này: bỏ ghi chú nội bộ, tô vàng các ô `[...]`, chân trang ghi "Phiên bản 1.0 (dự thảo), ngày 31/10/2026". Sửa bản Word nào thì sửa cả file nguồn tương ứng ở đây.

| File Word | Tài liệu nguồn | Nội dung |
| --- | --- | --- |
| `01_Don_de_nghi_xet_duyet_dao_duc` | [Đơn đề nghị](application_letter_v0.1.md) | Thông tin chung, tóm tắt bằng ngôn ngữ phổ thông, hình thức xét, điểm đề nghị hội đồng cho ý kiến, danh mục hồ sơ, cam kết. Phải chuyển sang mẫu đơn của hội đồng được chọn |
| `02_De_cuong_nghien_cuu` | [Đề cương nộp hội đồng](committee_protocol_v0.1.md) | Bản tóm tắt cho hội đồng của [protocol v0.3](../protocol/protocol_outline_v0.2.md): mục tiêu, thiết kế, đối tượng, tuyển chọn và đồng thuận, thiết bị, quy trình, phân tích, đạo đức, kế hoạch, nhóm nghiên cứu, hạn chế |
| `03_PL1_Ban_thong_tin_nguoi_tham_gia` | [Phiếu thông tin](participant_information_sheet_v0.1.md) | Mục đích, ai được mời, các bước, thiết bị, rủi ro, lợi ích, phát hiện ngoài ý muốn, chi phí và tổn hại, dữ liệu, rút lui, liên hệ |
| `04_PL2_Phieu_dong_thuan` | [Phiếu đồng thuận](consent_form_v0.1.md) | Mục 1–7 bắt buộc, 8–10 tùy chọn; người làm chứng; phần nghiên cứu viên |
| `05_PL3_Tieu_chuan_va_phieu_sang_loc` | [Chọn/loại và phiếu sàng lọc](eligibility_screening_v0.1.md) | Tiêu chí chọn 1–4, loại L1–L9, hoãn buổi, đo hai tay, phiếu sàng lọc |
| `06_PL4_Phieu_ghi_buoi_do` | [Phiếu ghi buổi đo](session_record_form_v0.1.md) | Mẫu ghi số đo huyết áp, nghiệm pháp, mức LED, triệu chứng (mới 2026-10-31) |
| `07_PL5_Quy_trinh_an_toan_va_quy_tac_dung` | [An toàn và quy tắc dừng](session_safety_stopping_v0.1.md) | Người trực, bảng kiểm, dừng buổi, dừng nghiệm pháp, ngưỡng huyết áp, trước khi ra về, cấp cứu, đo dòng rò và thử nhiệt, nhật ký sự cố |
| `08_PL6_Ke_hoach_quan_ly_du_lieu` | [Quản lý dữ liệu](data_management_plan_v0.1.md) | Trách nhiệm và căn cứ pháp lý, dữ liệu thu, giả danh hóa, lưu trữ, người không tham gia, rút lui, thời hạn lưu, sự cố, chia sẻ |
| `09_PL7_Thong_bao_tuyen` | [Thông báo tuyển](recruitment_notice_v0.1.md) | Thông báo mời tham gia (mới 2026-10-31) |
| `00_Ghi_chu_ra_soat_gui_thay` | (chỉ có bản Word) | Kết luận rà soát, việc còn thiếu, các đề xuất cần thầy xác nhận, câu hỏi cho thầy |

[Khung Đạo đức Nghiên cứu v0.1](ethics_outline_v0.1.md) là tài liệu lịch sử (bản Tuần 1), không nộp; chỗ nào khác nhau thì theo các file trên.

## Căn cứ đã đối chiếu (tra cứu 2026-10-31)

- **Thông tư 43/2024/TT-BYT** (12/12/2024, hiệu lực 01/02/2025) quy định hội đồng đạo đức trong nghiên cứu y sinh học. Thông tư 45/2017/TT-BYT đã bị Thông tư 4/2020/TT-BYT thay, và Thông tư 4/2020 hết hiệu lực khi Thông tư 43/2024 có hiệu lực. Thông tư 43 không có danh mục hồ sơ chung: mỗi hội đồng tự ban hành danh mục, biểu mẫu, lệ phí và thời hạn (Điều 17). Điều 18 nêu các nội dung hội đồng thẩm định, trong đó có cách tuyển và quảng cáo tuyển, quy trình lấy chấp thuận, chi trả, bảo mật và xử trí biến cố. Thẩm định rút gọn chỉ dành cho nghiên cứu có nguy cơ tối thiểu (Điều 16.6, định nghĩa ở Điều 2.3); một số hội đồng đưa nghiên cứu có thiết bị y tế, thông tin định danh hoặc chi trả vào diện thẩm định đầy đủ, nên hồ sơ được chuẩn bị cho quy trình đầy đủ.
- **Luật Bảo vệ dữ liệu cá nhân số 91/2025/QH15** và **Nghị định 356/2025/NĐ-CP**, cùng hiệu lực 01/01/2026 (Nghị định 13/2023/NĐ-CP hết hiệu lực): thông tin sức khỏe và dữ liệu sinh trắc học là dữ liệu nhạy cảm; đồng ý phải rõ ràng, riêng cho từng mục đích, không cài sẵn, và phải báo đó là dữ liệu nhạy cảm; hồ sơ đánh giá tác động xử lý dữ liệu nộp trong 60 ngày kể từ khi bắt đầu xử lý (Nghị định 356, Điều 19); yêu cầu của chủ thể dữ liệu được xác nhận trong 02 ngày làm việc, việc xóa làm trong 20 ngày, 30 ngày khi có bên xử lý hay bên thứ ba (Điều 5); khi lộ dữ liệu vị trí hoặc sinh trắc học phải báo chủ thể dữ liệu trong 72 giờ, báo cơ quan chuyên trách theo Điều 28, và lưu hồ sơ vi phạm ít nhất 05 năm (Điều 29). Chưa thấy điều khoản miễn trừ cho nghiên cứu khoa học.
- **Mẫu của các hội đồng:** ĐH Y tế công cộng ([biểu mẫu](https://huph.edu.vn/sites/hddd/qui-trinh-bieu-mau)), BV Thống Nhất ([nộp hồ sơ](https://bvtn.edu.vn/hoi-dong-dao-duc-trong-nghien-cuu-y-sinh-hoc/nop-ho-so-y-duc/)), BV Da Liễu TP.HCM, ĐH Y Dược – ĐHQGHN ([trang hội đồng](https://ump.vnu.edu.vn/article-hoi-dong-dao-duc-trong-nghien-cuu-y-sinh-hoc-19209-3567.html)), ĐH Y-Dược Huế. Các mẫu là file tải về nên mới đối chiếu danh mục hồ sơ, chưa đối chiếu từng mục của mẫu phiếu.
- **Đại học Bách khoa Hà Nội** chưa thấy có hội đồng đạo đức trong nghiên cứu y sinh học; [danh sách hội đồng cấp cơ sở](https://asttmoh.vn/danh-sach-cac-co-so-cap-nhat-hoat-dong-hoi-dong-dao-duc-trong-nghien-cuu-y-sinh-hoc-cap-co-so/) (cập nhật 09/12/2025) không có trường kỹ thuật nào. Theo Thông tư 43, Điều 4.4, tổ chức không có hội đồng thì dùng hội đồng cấp cơ sở phù hợp lĩnh vực.
- **Thiết bị:** không tìm thấy nguồn nói thẳng về nguyên mẫu nghiên cứu dùng trên người khỏe mạnh, không dùng để chẩn đoán. Theo Luật Khám bệnh, chữa bệnh 15/2023/QH15 Điều 94, thử nghiệm lâm sàng thiết bị y tế áp dụng trước khi đăng ký lưu hành cho thiết bị loại C, D. Nghị định 98/2021/NĐ-CP (bản hợp nhất 05/VBHN-BYT) không áp dụng cho sản phẩm chỉ dùng cho nghiên cứu (RUO, Điều 1), còn Điều 24 miễn đăng ký lưu hành cho *thiết bị y tế* dùng cho nghiên cứu, nên Điều 24 không tự chứng minh thiết bị không phải thiết bị y tế. Vì vậy hồ sơ ghi thiết bị là "chưa được cấp phép như thiết bị y tế", và đơn đề nghị xin hội đồng xác định phạm vi pháp luật áp dụng và thủ tục cần làm, thay vì xin xác nhận một kết luận có sẵn.
- Chưa xác minh được số quyết định ban hành Hướng dẫn quốc gia về đạo đức trong nghiên cứu y sinh học (bản 2013), nên hồ sơ không dẫn văn bản này.

## Còn thiếu trước khi nộp

1. Thầy chọn hội đồng; lấy danh mục hồ sơ, mẫu đơn, bảng kiểm chọn quy trình, lệ phí và thời gian xét của hội đồng đó; chuyển đơn đề nghị sang mẫu của hội đồng.
2. Văn bản thông qua đề cương về mặt khoa học (một số hội đồng chỉ nhận hồ sơ khi đã có) và giấy giới thiệu của đơn vị nếu hội đồng ở ngoài trường.
3. Biên bản đo dòng rò và thử nhiệt trên bo V1 thật (an toàn mục 9); hỏi hội đồng có cần biên bản này trước khi nộp hay không. Hiện chưa có phần cứng.
4. Model máy đo huyết áp và dải cỡ vòng bít (tiêu chí ở đề cương 5.2).
5. Đầu mối y tế; người duyệt quy trình cấp cứu (an toàn mục 8); người có chứng nhận sơ cứu.
6. Chi trả khi có tổn hại, bảo hiểm, mức và thời điểm bồi dưỡng, nguồn kinh phí, tuyên bố xung đột lợi ích.
7. Thông tin hành chính: chủ nhiệm đề tài, giảng viên hướng dẫn, đơn vị, địa điểm, liên hệ, đầu mối của hội đồng; danh sách người trực và người lấy đồng thuận; lý lịch khoa học; chứng nhận đào tạo đạo đức nghiên cứu hoặc thực hành lâm sàng tốt.
8. Ngày khóa dữ liệu chính xác, ghi vào bản thông tin mục 9 và quản lý dữ liệu mục 6. Ngày này phụ thuộc việc có kéo dài đề tài hay không ([đề xuất Tuần 7](../meetings/week_07_de_xuat_sua_protocol_va_ho_so.md) mục 2.1).
9. Nơi lưu, công cụ mã hóa, bản sao lưu, người quản lý dữ liệu; quy định lưu trữ của trường.
10. Đơn vị chủ trì xác nhận việc lập hồ sơ đánh giá tác động xử lý dữ liệu cá nhân theo Nghị định 356/2025/NĐ-CP.
11. Đọc nguyên văn hướng dẫn ESH 2023 và ESC 2024 và ghi số trang cho hai ngưỡng huyết áp (an toàn mục 6).

## Đề xuất của nhóm, chờ thầy xác nhận

Các giá trị dưới đây được viết trong bản nộp như giá trị thật để bản nộp dễ đọc; thầy cần xác nhận từng mục trước khi nộp.

- Từ 2026-10-29: bộ nghiệm pháp thu gọn M0–M2 (bỏ M3 ngâm chân nước lạnh và M4 đạp xe) và hệ quả của nó (dải ΔBP hẹp hơn; ngưỡng 15 mmHg của P2/R3 phải đặt lại trước pilot bằng mô phỏng độ nhạy, protocol 6.4–6.5); chi tiết M1 (6 nhịp mỗi phút theo âm thanh, 15 phút) và M2 (trừ liên tiếp 13 từ số có bốn chữ số, khoảng 3 phút, đo cuff sau 90 s); thứ tự M0, M1, nghỉ ít nhất 5 phút, M2; endpoint RQ1; trần tuyển 35 người, mục tiêu ≥ 25 người đạt chuẩn và luật dừng tuyển (protocol 4.1); tiêu chí chọn/loại, độ tuổi 18–35, L7, L8; ngưỡng chênh hai tay 10 mmHg; ngưỡng huyết áp 180/110 và 140/90; hỏi lại triệu chứng sau 5 phút và trước khi ra về; 24 giờ cân nhắc; số lần bơm và thời lượng buổi; mốc khóa dữ liệu khi rút lui; thời hạn lưu 03 năm khi trường không có quy định; tiêu chí chọn máy cuff; phương pháp đo dòng rò. Nếu thầy chưa duyệt trục thời gian của M2 thì chỉ nộp M0 và M1 (protocol 6.4, mục "Dự phòng").
- Mới 2026-10-31: thu giới tính để mô tả mẫu; ký đồng thuận trước sàng lọc; nghỉ ít nhất 5 phút trước khi đo hai tay, tay phải trước, cách nhau ít nhất 2 phút; báo cho người tham gia khi SBP hai tay chênh ≥ 10 mmHg; ngưỡng dừng áp cho cả hai lần đo hai tay; L5 là lý do hoãn buổi; quy tắc khi tiêu chí loại mới xuất hiện ở buổi 2–3; hướng dẫn thở nhẹ nhàng, không nín thở; cách tuyển qua thông báo và giảng viên không tuyển sinh viên mình đang dạy hay đánh giá; ít nhất hai người trực, có người học sơ cứu; quy trình cấp cứu; thử nhiệt 120 phút ở trần LED; bồi dưỡng theo số buổi đã tham gia; mã hóa toàn ổ cho mọi thiết bị lưu dữ liệu; sau mốc khóa không dùng dữ liệu cho mục đích mới; thời hạn lưu tính từ công bố đầu tiên; quy tắc với người đăng ký nhưng không tham gia; điều kiện cho mục 10 của phiếu đồng thuận; đề nghị hội đồng xác định phạm vi pháp luật áp dụng cho thiết bị.
- Mới 2026-10-31, sau vòng phản biện thứ hai: người đo thử tham gia 2–3 buổi như người khác; tiêu chí kết luận RQ1 (vượt cả PPG-only lẫn zero-change) nêu trong đề cương; giữ liên lạc tối đa 30 ngày để hỏi thăm sau sự cố, với ô đồng ý riêng ở mục 9 của phiếu đồng thuận; nơi đăng tóm tắt kết quả chung; trần tiêu hủy 05 năm kể từ khi kết thúc đề tài; xóa trong 20 ngày và xác nhận yêu cầu trong 02 ngày làm việc (theo Nghị định 356/2025/NĐ-CP); báo người tham gia trong 72 giờ khi có sự cố dữ liệu sức khỏe hoặc sinh trắc học. Câu về yêu cầu xóa sau mốc khóa không còn nói "không thực hiện được": hồ sơ đề nghị giữ lại cho các phân tích đã định trước nếu đơn vị chủ trì xác nhận có căn cứ, nếu không thì xóa và chạy lại phân tích.
- Mục 10 của phiếu đồng thuận (dùng dữ liệu cho nghiên cứu sau của nhóm) và việc xin ý kiến hội đồng về thử kỹ thuật trên thành viên nhóm (đề cương 9.8) chờ thầy quyết định có giữ hay không.
- Các đề xuất ở [buổi gặp Tuần 7](../meetings/week_07_de_xuat_sua_protocol_va_ho_so.md) (kéo dài đề tài, lịch phiên, số lần cuff, chia sẻ dữ liệu, nghiệm pháp duỗi gối, pilot nội bộ, người trực) **chưa** được đưa vào bộ hồ sơ; thầy chọn phương án nào thì sửa protocol, đề cương nộp hội đồng và các phụ lục cùng lúc.

## Đã xong

- Phân bổ tay/điện cực (2026-10-23): ba điện cực, gồm LA ở cổ tay trái, RA ở cổ tay phải và RL ở cẳng tay trái (protocol mục 5.2).
- Ngày 2026-10-29: trên người chỉ dùng ba điện cực Ag/AgCl dán; tiêu chí chọn/loại chỉ còn một nguồn là phiếu sàng lọc; quy tắc sử dụng các lượt đo bị dừng (protocol mục 10); lời dặn kiêng 2 giờ, trần số lần bơm cuff và thời lượng buổi; cất riêng phiếu đồng thuận và phiếu sàng lọc; gán mã SUB ngẫu nhiên; cách tính thời hạn lưu khi trường không có quy định; bỏ M3 và M4 khỏi toàn bộ hồ sơ.
- Ngày 2026-10-31: rà soát cuối và viết lại hồ sơ như trên; kiểm 11 tài liệu tham khảo có DOI của đề cương qua OpenAlex; phản biện hai vòng (vòng 2 xác nhận đã sửa các điểm của vòng 1 về người tham gia là sinh viên, công bố thông tin, dừng tham gia, nghỉ trước khi đo hai tay, tiêu chí L1/L4, và không còn dẫn chiếu sai số mục). Các điểm của vòng 2 đã được kiểm trên file và trên văn bản Nghị định 356/2025/NĐ-CP trước khi sửa.

Thiết bị: module PPG là MAX30101 (nhóm chọn ngày 2026-10-22). Pin map chuẩn là KiCad V1-module (`configs/hardware/custom_board_proposal.md` A.7, chốt 2026-10-23). Pin map và BOM cũ trên nhánh `dev/ducanh` không còn được dùng.
