ndhuy1127/ppg-ecg-blood-pressure/docs/plans/README.md

# Kế hoạch

Thư mục này lưu kế hoạch theo tuần và theo mốc. Mỗi kế hoạch cần nêu người phụ
trách, đầu ra bắt buộc, tiêu chí hoàn thành và phụ thuộc.

- [Kế hoạch Tuần 1](WEEK_01.md)
- [Kế hoạch Tuần 2](WEEK_02.md)
- [Kế hoạch Tuần 3](WEEK_03.md)
- [Kế hoạch Tuần 4](WEEK_04.md)
- [Kế hoạch Tuần 5](WEEK_05.md)
- [Kế hoạch Tuần 6](WEEK_06.md)
- [Kế hoạch Tuần 7](WEEK_07.md)
