ndhuy1127/ppg-ecg-blood-pressure/docs/meetings/README.md

# Biên bản họp

Lưu trữ biên bản theo ngày với quyết định, người phụ trách, deadline và công việc tiếp theo. Không ghi thông tin định danh của người tham gia nghiên cứu.

## Danh mục tài liệu tuần 1
- [Biên bản / Chương trình Họp Khởi động Tuần 1](week_01_kickoff.md): Bản dự thảo chương trình họp khởi động, phân công vai trò, khóa quy trình Git, review chéo, bảo mật dữ liệu và danh sách câu hỏi tham vấn giảng viên.

## Tuần 7
- [Đề xuất sửa protocol và hồ sơ đạo đức trước khi nộp](week_07_de_xuat_sua_protocol_va_ho_so.md): năm đề xuất mang đi gặp thầy (mốc thời gian theo lịch kéo dài, lịch các phiên, số lần cuff mỗi buổi, chia sẻ dữ liệu có kiểm soát, duỗi gối tĩnh), mỗi mục có lý do, chi phí, chỗ phải sửa và câu hỏi cho thầy. Đề xuất ngày 2026-10-30, đã sửa theo phản biện cùng ngày, chờ thầy.
