ndhuy1127/ppg-ecg-blood-pressure/docs/literature/README.md

# Tổng quan tài liệu

Lưu ma trận tài liệu, chiến lược tìm kiếm, tiêu chí chọn lọc và ghi chú tổng hợp.
Mọi trích dẫn phải có nguồn và thông tin thư mục rõ ràng; mọi số liệu phải ghi
mức đã đọc (toàn văn hay abstract).

- [Ma trận tổng quan 12 bài (Tuần 1, v0.3 ngày 2026-10-29)](week_01_literature_matrix.md):
  PAT và PTT, hiệu chuẩn cá nhân, rò rỉ dữ liệu, SQI và từ chối dự đoán; phân tầng
  nguồn (nền tảng, bằng chứng chính, hạ xuống, chưa đọc); khoảng trống nghiên cứu viết
  lại theo các nghiên cứu gần nhất và đóng góp dự kiến. Tổng quan sơ bộ, chưa phải
  systematic review.
- [Tổng quan bổ sung 2015–2026](literature_update_2026-10-14.md): chiến lược
  tìm kiếm và 14 nguồn bổ sung (khuyến cáo ESH/AHA, dự án Aurora, benchmark,
  SQI, risk–coverage, dataset), cùng ảnh hưởng tới RQ1–RQ3.
- [Các bài gần nhất với RQ1 (2026-10-29)](literature_update_2026-10-29.md): nhật
  ký hai lần tra (lần 2 có hệ thống trên PubMed, Europe PMC, OpenAlex cho 2022–2026:
  32 truy vấn, 1.085 bản ghi sau loại trùng), 42 nguồn N1–N42 so với thiết kế RQ1, kiểm
  kê các bài dùng Aurora-BP, mức độ mới trong phạm vi đã tra, các đoạn của ma trận và RQ
  phải sửa theo lần tra (đã sửa ngày 2026-10-30), và danh sách bài cần lấy toàn văn (N6
  đã đọc toàn văn ngày 2026-10-30 từ bản PDF nhóm tải; S4 đọc toàn văn cùng ngày từ bản miễn phí
  trên trang Microsoft Research, kết quả ở mục 3.3).
