ndhuy1127/ppg-ecg-blood-pressure/data/sample/README.md

# Dữ liệu mẫu

Chỉ đặt ở đây dữ liệu nhỏ, đã ẩn danh, không thể truy ngược và đã được kiểm tra.
Mỗi mẫu cần mô tả nguồn, giấy phép hoặc quyền sử dụng, schema và mục đích kiểm
thử. Hiện chưa có dữ liệu mẫu.
