ndhuy1127/ppg-ecg-blood-pressure/docs/diagrams/README.md

# Sơ đồ

Lưu sơ đồ kiến trúc hệ thống, luồng dữ liệu và sơ đồ khối ở định dạng nguồn có
thể chỉnh sửa cùng bản xuất nhẹ khi cần.
