ndhuy1127/ppg-ecg-blood-pressure/docs/ethics/committee_protocol_v0.1.md

# Đề cương nghiên cứu nộp hội đồng đạo đức — bản nháp v0.1

> **Ghi chú nội bộ (không đưa vào bản nộp).** Bản tóm tắt cho hội đồng của
> [protocol v0.3](../protocol/protocol_outline_v0.2.md), viết ngày 2026-10-31 sau rà soát cuối hồ
> sơ. Hội đồng chỉ nhận bản này (kèm các phụ lục), không nhận protocol kỹ thuật, nên bản này phải
> tự đứng được và không dùng ký hiệu nội bộ (K1–K6, G2, G4, R3, mã packet). **Khi protocol v0.3 đổi
> thì phải sửa file này**; chỗ nào khác nhau thì protocol là nguồn, trừ tiêu chí chọn/loại (nguồn là
> [phiếu sàng lọc](eligibility_screening_v0.1.md)). Phần dưới đường kẻ là đúng nội dung bản nộp; bản
> Word được dựng từ file này. Ô `[...]` chờ thầy, đơn vị hoặc hội đồng.
>
> - Các mục là **đề xuất của nhóm, chờ thầy/hội đồng** giống protocol v0.3 (danh sách ở
>   [README](README.md)). Mục mới so với protocol, cũng là đề xuất: cách tuyển và lấy đồng thuận
>   (4.5–4.6), người trực (9.7), thử nhiệt (5.1), nghỉ 5 phút trước khi đo hai tay và thứ tự đo
>   (6.2), giới tính (mục 7), mô tả thiết kế là "thực nghiệm có nghiệm pháp sinh lý" thay vì
>   "quan sát".
> - Sửa cùng ngày sau vòng phản biện thứ hai: PAT được định nghĩa là khoảng từ đỉnh R tới
>   chân sóng PPG, không gọi là "thời gian truyền mạch"; thiết bị ghi là "chưa được cấp phép như thiết
>   bị y tế" và câu hỏi gửi hội đồng ở 9.8 hỏi phạm vi pháp luật áp dụng thay vì xin xác nhận một kết
>   luận có sẵn (Điều 24 của Nghị định 98/2021/NĐ-CP miễn đăng ký cho *thiết bị y tế* dùng cho nghiên
>   cứu, nên không tự chứng minh thiết bị không phải thiết bị y tế); thêm tiêu chí kết luận phải vượt
>   cả PPG-only lẫn zero-change (RQ v0.4 mục 4.E, đề xuất chờ thầy) và chi tiết RQ2b, RQ3; người đo
>   thử tham gia 2–3 buổi như người khác (đề xuất mới, protocol 6.5 chỉ định P2 trong một buổi chứ
>   không nói số buổi của pilot) và việc phải làm khi dải ΔBP ở pilot quá hẹp (protocol 6.4,
>   "Dự phòng").
> - Không đưa vào bản này các đề xuất Tuần 7 chưa được thầy chọn (kéo dài đề tài, lịch phiên
>   7–14 ngày, thêm lần cuff, chia sẻ dữ liệu, nghiệm pháp duỗi gối, pilot nội bộ):
>   [đề xuất Tuần 7](../meetings/week_07_de_xuat_sua_protocol_va_ho_so.md). Nếu thầy chọn phương án
>   nào thì sửa protocol, file này và các phụ lục cùng lúc.

---

- **Tên nghiên cứu:** Nguyên mẫu đeo cổ tay thu đồng thời tín hiệu quang học (PPG) và điện tim
  (ECG) để ước lượng thay đổi huyết áp sau hiệu chuẩn cá nhân.
- **Chủ nhiệm đề tài:** [họ tên, học hàm, học vị, đơn vị]
- **Giảng viên hướng dẫn:** [họ tên, học hàm, học vị, đơn vị]
- **Đơn vị chủ trì:** [tên trường, khoa/viện]
- **Địa điểm nghiên cứu:** [phòng thí nghiệm, địa chỉ]
- **Thời gian thực hiện:** [từ tháng/năm đến tháng/năm]; chỉ đo trên người sau khi có văn bản chấp
  thuận của hội đồng đạo đức.
- **Kinh phí:** [nguồn kinh phí]

## Tóm tắt nghiên cứu

<!-- cols: 24,76 -->
| Mục | Nội dung |
| --- | --- |
| Mục tiêu chính | Đánh giá xem thêm PAT (khoảng thời gian từ đỉnh R của điện tim đến chân sóng PPG ở cổ tay) vào mô hình chỉ dùng tín hiệu PPG cổ tay có làm giảm sai số ước lượng thay đổi huyết áp ở các buổi đo sau buổi hiệu chuẩn hay không |
| Thiết kế | Nghiên cứu thực nghiệm tiến cứu trên người tình nguyện khỏe mạnh, đo lặp lại 2–3 buổi; không dùng thuốc, không can thiệp điều trị, không lấy mẫu sinh học; có hai nghiệm pháp sinh lý (thở chậm, tính nhẩm) |
| Người tham gia | Người trưởng thành khỏe mạnh 18–35 tuổi; tối đa 35 người, kể cả 2–3 người đo thử |
| Thiết bị | Thiết bị nguyên mẫu chỉ dùng cho nghiên cứu, chưa được cấp phép như thiết bị y tế: bo cảm biến quang và chuyển động ở cổ tay trái, ba điện cực dán Ag/AgCl, cấp nguồn qua USB từ máy tính xách tay chạy pin; máy đo huyết áp bắp tay tự động làm đối chứng |
| Thời gian tham gia | 2–3 buổi trong 4 tuần, mỗi buổi tối đa 120 phút |
| Kết cục chính | Sai số tuyệt đối trung bình theo người khi ước lượng thay đổi huyết áp tâm thu và tâm trương ở các buổi sau buổi hiệu chuẩn, so giữa mô hình có PAT và mô hình chỉ dùng PPG |
| Rủi ro chính | Khó chịu do vòng bít, kích ứng da do điện cực, căng thẳng hoặc chóng mặt nhẹ khi làm nghiệm pháp, rủi ro về riêng tư; nhóm đánh giá ban đầu là rủi ro thấp, phân loại cuối cùng do hội đồng quyết định |

## 1. Đặt vấn đề

Thiết bị đeo đo huyết áp không dùng vòng bít thường ước lượng huyết áp từ dạng sóng quang thể tích
(PPG) và từ thời gian truyền mạch. Khi có thêm điện tim, có thể đo khoảng từ đỉnh R của điện tim tới
chân sóng PPG ở cổ tay, gọi là PAT (pulse arrival time). PAT gồm thời kỳ tiền tống máu (PEP) cộng
thời gian truyền mạch (PTT), nên không đồng nhất với PTT, và các quan hệ vật lý dành cho PTT không
được áp trực tiếp lên PAT (Mukkamala và cộng sự, 2015; Payne và cộng sự, 2006).

Các thiết bị này thường cần hiệu chuẩn bằng máy đo có vòng bít cho từng người. Mukkamala và cộng sự
(2021) chỉ ra rằng thiết bị có hiệu chuẩn có thể trông chính xác chỉ vì huyết áp ít thay đổi giữa
các lần đo, nên đề xuất đánh giá thiết bị bằng các can thiệp làm huyết áp thay đổi và luôn so với
cách dự đoán "không đổi so với lúc hiệu chuẩn". Tuyên bố khoa học của Hội Tim mạch Hoa Kỳ (Cohen và
cộng sự, 2025) cũng nhấn mạnh rằng độ chính xác của thiết bị không vòng bít phụ thuộc mạnh vào máy đo
dùng để hiệu chuẩn.

Câu hỏi của nghiên cứu này là: ở người trẻ khỏe mạnh, sau khi hiệu chuẩn bằng các lần đo lúc nghỉ ở
buổi đầu, việc thêm PAT vào mô hình dùng đặc trưng PPG cổ tay có làm giảm sai số ước lượng thay đổi
huyết áp ở các buổi đo vào những ngày sau hay không. Kết quả âm tính (không giảm, hoặc tương đương
trong một ngưỡng định trước) cũng được báo cáo đầy đủ.

## 2. Mục tiêu nghiên cứu

1. Xây dựng quy trình thu đồng thời tín hiệu PPG cổ tay và điện tim, đồng bộ thời gian, kèm số đo
   huyết áp đối chứng bằng máy đo bắp tay.
2. **Mục tiêu chính:** so sánh sai số ước lượng thay đổi huyết áp tâm thu và tâm trương ở các buổi
   sau buổi hiệu chuẩn giữa mô hình chỉ dùng PPG và mô hình PPG có thêm PAT, cùng thuật toán, trên
   cùng tập lần đo, và so với cách dự đoán "không đổi".
3. **Mục tiêu phụ:** so sánh sai số khi đánh giá trong cùng buổi (các lần đo nghiệm pháp ở buổi 1)
   với khi đánh giá ở các buổi sau, có chuẩn hóa theo nghiệm pháp, dùng chính các dự đoán của phân
   tích chính; và (thăm dò) dùng chỉ số chất lượng tín hiệu kết hợp độ bất định của mô hình để từ
   chối các lần ước lượng kém tin cậy, so với từ chối ngẫu nhiên ở cùng tỷ lệ giữ lại.

## 3. Thiết kế nghiên cứu

Nghiên cứu thực nghiệm tiến cứu trên người tình nguyện khỏe mạnh, đo lặp lại theo thời gian. Mỗi
người tham gia 3 buổi đo (tối thiểu 2), mỗi buổi vào một ngày khác nhau. Buổi 2 cách buổi 1 ít nhất
1 ngày, và mọi buổi nằm trong 4 tuần kể từ buổi 1. Không có hai buổi trong cùng một ngày; giờ bắt đầu
mỗi buổi được ghi lại, các buổi không bắt buộc cùng khung giờ.

- **Buổi 1 (hiệu chuẩn):** mốc hiệu chuẩn huyết áp BP₀ là trung bình các lần đo hợp lệ lúc
  nghỉ (M0) của buổi 1; PAT và đặc trưng nền lấy từ tín hiệu của chính các lần đo đó.
- **Buổi 2 trở đi (đánh giá):** dùng để đánh giá khả năng theo dõi thay đổi huyết áp.
- Buổi nào cũng theo cùng một trình tự: nghỉ ổn định, đo lúc nghỉ (M0), rồi thở chậm (M1) và tính
  nhẩm (M2) nếu người tham gia đồng ý với từng nghiệm pháp.

Ở người trẻ khỏe mạnh đo lúc nghỉ, thay đổi huyết áp giữa các buổi thường nhỏ. Vì vậy nghiên cứu dùng
hai nghiệm pháp để mở rộng dải thay đổi, và luôn báo cáo kèm sai số của cách dự đoán "không đổi" cùng
độ lệch chuẩn của thay đổi huyết áp đối chứng.

## 4. Đối tượng nghiên cứu

### 4.1. Quần thể và địa điểm

Người trưởng thành khỏe mạnh 18–35 tuổi, là sinh viên hoặc cán bộ của [tên trường], tự nguyện tham
gia. Mọi buổi đo diễn ra tại [phòng thí nghiệm, địa chỉ].

### 4.2. Tiêu chuẩn lựa chọn

1. Từ 18 đến 35 tuổi, đủ năng lực tự quyết định việc tham gia.
2. Tự nguyện ký phiếu đồng thuận sau khi đã nhận bản thông tin được ít nhất 24 giờ.
3. Tự khai không có bệnh tim mạch đã được chẩn đoán.
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
