ndhuy1127/ppg-ecg-blood-pressure/hardware/test_reports/v1_bringup_procedure.md

# Trình tự bring-up V1-module

> **Chưa thực hiện**: chưa có module và PCB. Áp dụng cho KiCad V1-module (bo đế
> V1-draft5, bo cổ tay V1-draft5, 2026-10-27), pin map chuẩn ở
> [custom_board_proposal.md](../../configs/hardware/custom_board_proposal.md) mục
> A.7 và [firmware khung](../../firmware/README.md).
>
> **An toàn:** bring-up chỉ dùng tín hiệu nhân tạo. **Không gắn điện cực lên
> người** cho tới khi có phê duyệt đạo đức và biên bản đo dòng rò
> ([hồ sơ đạo đức](../../docs/ethics/README.md)). Laptop chạy pin, rút sạc. Đeo vòng
> chống tĩnh điện hoặc chạm đất trước khi cầm module.

Đi lần lượt từng bước. Bước nào không đạt thì dừng, ghi lại và xử lý trước khi
sang bước sau. Giá trị đo ghi vào báo cáo theo mục 11.

## 0. Dụng cụ

- Đồng hồ vạn năng, oscilloscope ít nhất 2 kênh, thước kẹp, kính lúp.
- USB tester cắm giữa laptop và cáp USB-C của bo Waveshare để đọc điện áp và dòng.
- Máy hàn, thiếc, flux, bấc hút thiếc, nhíp, dao rọc giấy (cắt jumper).
- Laptop chạy pin, cài PlatformIO theo [firmware/README.md](../../firmware/README.md).
- Bản in PCB tỉ lệ 1:1 của hai bo (KiCad: Plot hoặc Print, tỉ lệ 1:1).

## 1. Kiểm khi nhận hàng (chưa hàn, chưa cấp nguồn)

| Module | Kiểm | Đạt khi |
| --- | --- | --- |
| Bo Waveshare | Đo khoảng cách tâm hai hàng chân bằng thước kẹp; đặt lên bản in 1:1 của bo đế | **22,86 mm**, khớp footprint U1 (bo Waveshare ESP32-S3-DEV-KIT-N8R8-M đã đặt 2026-10-27, chân giống DevKitC-1; danh sách mua dòng 6) |
| Bo Waveshare | Đọc ký hiệu trên vỏ module | ESP32-S3-WROOM-1-N8R8 (A.6 mục 4). Bản N16R16VA hoặc chip R16V thì dừng: GPIO47 chạy 1,8 V |
| Bo Waveshare | Đọc mã khắc trên LDO 3,3 V của bo (thêm 2026-10-29) | Ghi mã vào báo cáo và [power_budget_v1.md](../../configs/hardware/power_budget_v1.md); tìm datasheet trước bước 8.9 |
| Bo Waveshare | Đối chiếu nhãn từng chân với bảng A.7 (đủ kích thước chưa đủ: phải đúng vị trí) | Pad U1 1–2 là 3V3, 21 là 5V, 22–24 và 44 là GND; các GPIO ở đúng pad như A.7 |
| Breakout MAX30001 | So với `pc_max30001_brk_v1.0` | Có R3 (10 kΩ, cỡ 0805) nối sleeve của jack với VCM; R7, R8 (0 Ω, cỡ 0402); header SV1 10 chân (A.2) |
| Cáp ECG của kit | Đếm số dây; đo thông mạch từng đầu bấm với tip/ring/sleeve của giắc 3,5 mm | Ba dây: LA ↔ ring, RA ↔ tip, RL ↔ sleeve (protocol v0.2 mục 5.2). Khác thì dán nhãn lại theo kết quả đo, không theo màu nắp. Chỉ có hai dây hoặc không có dây nối sleeve: dừng cấu hình 3 điện cực cho tới khi có cáp 3 dây (danh sách mua mục 3) |
| SparkFun MAX30101 | Mã và vị trí jumper | SEN-16474; có JP1 (LED nguồn), hàng chân GND, 3.3V, SDA, SCL, INT, 1.8V |
| SparkFun BMI270 | Mã và kích thước | SEN-22397 (1" × 1"), không phải SEN-22398; có jumper `I2C` và `ADR` |
| Cả bốn module (bo Waveshare, breakout MAX30001, MAX30101, BMI270) | Trước khi hàn, đo từng module bằng thước kẹp: kích thước bo, bước chân header, vị trí lỗ bắt vít so với hàng chân; so với footprint KiCad (thêm 2026-10-29: footprint mới đối chiếu với file CAD và bản vẽ của nhà sản xuất, chưa với module thật) | Khớp footprint; ghi số đo vào báo cáo. Lệch thì dừng, không hàn (A.6 mục 2) |
| Cả bốn module | Đặt lên bản in 1:1 của hai bo | Lỗ bắt vít, hàng chân và lỗ spacer trùng footprint (A.6 mục 2) |

## 2. Bo Waveshare đứng riêng (chỉ cắm USB)

1. Cắm cáp USB-C của bo Waveshare vào laptop (đổi 2026-10-27: một cổng USB-C qua hub
   CH334, sau hub có cầu USB–UART CH343 cho UART0 và cổng USB native của ESP32-S3).
   Trong Device Manager ghi hai cổng COM: cổng USB native có VID:PID `303A:1001`
   (USB Serial/JTAG, gửi packet), cổng CH343 là log UART0. Đọc `bMaxPower` của hub
   CH334 và của `303A:1001` bằng USBView (Windows) hay `lsusb -v` và ghi vào báo cáo:
   laptop thấy hub, nên con số của hub là dòng cổng laptop cấp cho cả bo. Khi đo trên
   người cũng chỉ có cáp USB-C này, nên đó là cổng cấp nguồn mà
   [power_budget_v1.md](../../configs/hardware/power_budget_v1.md) mục 4 xét, và giới
   hạn dòng phụ thuộc `bMaxPower` của hub (thêm 2026-10-26; sửa 2026-10-29 theo bo
   Waveshare).
2. Đọc loại chip và eFuse, **chỉ đọc**. Không bao giờ chạy lệnh `burn_*` của
   espefuse: ghi eFuse không đảo ngược được.

   ```powershell
   $py = "$env:USERPROFILE\.platformio\penv\Scripts\python.exe"
   $tool = "$env:USERPROFILE\.platformio\packages\tool-esptoolpy"
   & $py "$tool\esptool.py" --chip esp32s3 --port COM5 chip_id
   & $py "$tool\espefuse.py" --chip esp32s3 --port COM5 summary
   ```

   Đạt khi chip là ESP32-S3, và `VDD_SPI_FORCE = 1`, `VDD_SPI_TIEH = 1` (VDD_SPI nối
   VDD3P3_RTC_IO, tức 3,3 V). Ghi nguyên văn kết quả vào báo cáo.
3. Nạp firmware khung (`pio run -d firmware -t upload --upload-port COMx`). Mở log
   UART0 (115 200 baud): thấy `packet self-test passed`, `SESSION_ID`, ELF SHA-256.
4. Đo chân 3V3–GND của bo Waveshare: khoảng 3,3 V. Ghi giá trị đo và dòng đọc trên USB
   tester khi firmware khung đang chạy (mốc so sánh cho mục 6–8).
5. Ghi luồng packet từ cổng USB native 10 phút không tải bằng logger
   (`python scripts/packet_logger.py record --port COMy --duration-s 600 --metadata
   ...`, [packet_logger.md](../../docs/protocol/packet_logger.md); cổng mở với
   DTR/RTS không kích hoạt, kiểm `SESSION_ID` trên UART0 không đổi khi mở cổng). Đạt
   khi: chỉ có `skipped_bytes` ở offset 0 (chữ ROM); `SEQ` và `T_ANCHOR_US` tăng đơn
   điệu; `DATA` khớp công thức trong firmware README; mọi packet là `VERSION = 2`;
   `device_info` có ELF SHA-256 trùng log UART0 và khoảng 60 packet hợp lệ; mọi
   packet ECG có bit 8 (mốc `SAMP` từ nguồn ECG giả); đủ sáu trục IMU.
6. Nạp lần lượt ba bản build tạo lỗi (`-e esp32s3_devkitc_imu_stall`,
   `esp32s3_devkitc_samp_faults`, `esp32s3_devkitc_ppg_delay`), ghi vài phút mỗi bản
   và so với kết quả chờ đợi ở mục "Kiểm tra khi có bo" của
   [firmware/README.md](../../firmware/README.md). Bước này chỉ kiểm firmware và
   logger với dữ liệu giả; MCPWM capture thật (`BOARD_SAMP_CAPTURE=1`) kiểm ở mục 7.
7. Lệnh từ PC (thêm 2026-10-29), bản build mặc định: ghi bằng `record --port COMy
   --duration-s 120 --commands --metadata ...`, trong lúc ghi gửi `ping`, `mark --event cuff_end`,
   `mark --event operator` và `set-ppg-led --green 18 --red 128 --ir 36
   --allow-over-firmware-limit` (`scripts/device_command.py`,
   [packet_logger.md](../../docs/protocol/packet_logger.md) mục "Lệnh xuống thiết
   bị"). Đạt khi: `commands_sent.jsonl` có `acked` cho cả bốn, không `unknown`;
   `decode.json` có `0xC1` mã 2 và mã 4, mỗi cái có `T_ANCHOR_US` không sau
   `T_ANCHOR_US` của `0xD3` tương ứng; `ping` và `mark` kết quả 0; mã 128 kết quả 8
   (`out_of_range`): firmware tự từ chối dù PC đã cho qua. Không có `--allow-...` thì
   `device_command.py` phải từ chối mã 128 và không ghi gì vào hộp thư. Ghi hiệu
   `T_ANCHOR_US` (`0xD3`) − `T_ANCHOR_US` (`0xC1`) và thời điểm PC trong nhật ký, chỉ để
   tham khảo: độ trễ PC → thiết bị vẫn chưa đo được bằng bước này.

## 3. PCB trần (chưa hàn)

1. Soi bằng kính lúp: không có cầu nối đồng, khe phay 3 × 22 mm ở bo cổ tay đúng
   kích thước.
2. Đo điện trở 3V3–GND trên cả hai bo: không chập.
3. Đo thông mạch theo bảng A.7: mỗi chân của J2 (bo đế) tới pad U1 tương ứng, mỗi
   chân của J1 (bo cổ tay) tới pad M1/M3 tương ứng; GND ở chân 2, 4, 6, 8, 10, 12, 14
   (thứ tự cáp V1-draft4). J3.1 (`STIM`) tới pad 6 của U1, J3.2 tới GND.

## 4. Sửa module (trước khi lắp)

| Module | Việc | Đạt khi |
| --- | --- | --- |
| Breakout MAX30001 | Thay R3 bằng 220 kΩ ±1 %, cỡ 0805 (datasheet yêu cầu ≥ 200 kΩ, A.2) | Đo R3 trước khi hàn lên bo: 220 kΩ ±1 % |
| Breakout MAX30001 | Gỡ R7, R8 (0 Ω, cỡ 0402): ngắt jack khỏi BIP/BIN của BioZ; đường ECG đi qua R4, R5 51 kΩ vẫn giữ nguyên | Pad R7, R8 hở mạch |
| Breakout MAX30001 | Hàn header SV1 10 chân (có trong kit) từ mặt dưới: thân nhựa header ở mặt dưới, chân dài chĩa xuống, mặt linh kiện và jack 3,5 mm quay lên (thêm 2026-10-27) | Chân thẳng, không cầu thiếc. Đặt breakout lên bản in 1:1 của bo đế: chân GND ở đầu hàng phía jack trùng J1.1, lỗ vít trùng lỗ NPTH (23,37; 2,97). Lỗ vít không trùng nghĩa là breakout đang bị lật; một trong hai cách lật làm đảo thứ tự chân (VCC rơi vào lỗ MOSI) |
| SparkFun MAX30101 | Cắt JP1 để tắt LED nguồn đỏ (LED cùng mặt với cảm biến, A.3) | Khi cấp nguồn, LED nguồn không sáng |
| SparkFun BMI270 | Cắt jumper `I2C` và `ADR` để chạy SPI (A.3) | Hai jumper hở mạch |

## 5. Hàn và lắp

**Bo đế:**

1. Hàn linh kiện dán trước: R2 10 kΩ, R3 1 kΩ, R8 100 kΩ, R9–R11 33 Ω (mặt dưới);
   C2, C4, C6, C8 100 nF; C9 100 nF (mặt dưới, sát J2.1/J2.2); C3, C5, C7 10 µF.
2. Hàn linh kiện chân cắm: SW1, D1 (chân dài, anode, vào pad tròn; chân ngắn và phía
   vát của vỏ, cathode, vào pad vuông nối GND), hai socket 1×22, socket 1×10, J2 (khe
   khóa theo silkscreen).
3. Dán 4 chân cao su ở mặt dưới: R9–R11 và C9 nằm ở mặt dưới, không được tì lên
   mặt bàn (A.2).
4. Đo lại 3V3–GND: không chập.

**Bo cổ tay** (theo A.3):

1. Kiểm J1 (box header cong) trước khi hàn: khe khóa ở vách xa mặt PCB (A.3). Cắm J1
   vào bo từ **mặt dưới** (chưa hàn), cắm một đầu cáp vào J1, đo thông mạch từ tiếp
   điểm chân 1 ở đầu cáp kia (sọc đỏ) tới chân J1 nằm trong lỗ J1.1 (pad vuông, có số
   `1` ở mặt trên): phải thông. Đạt thì hàn J1 ở **mặt dưới**. Hàn nhầm sang mặt trên
   làm chân 1 (3V3) của cáp rơi vào lỗ J1.15 (`BMI_MOSI`); J1 loại có khe ở vách sát
   PCB đảo cả cáp (chân n vào pad 17 − n). Sửa 2026-10-27: bản trước ghi chân 1 rơi vào
   lỗ GND, không còn đúng với thứ tự cáp V1-draft4.
2. Hàn header của M1 và M3, C2 10 µF, C3 100 nF. Cắt sát đuôi chân, dán kapton lên
   mối hàn ở mặt trên (mặt áp vào da).
3. Lắp M1 (MAX30101) ở mặt trên, cảm biến quay ra ngoài; M3 (BMI270) ở mặt dưới,
   **mặt chip quay ra ngoài** (silkscreen `CHIP SIDE OUT`; lắp chip quay vào bo thì sơ
   đồ chân bị gương, chân 3V3 của module rơi vào pad OCS); vít, đai ốc và spacer nylon
   M2 ở ba lỗ, mỗi lỗ hai spacer (tròn Ø ≤ 4,5 mm hoặc lục giác 4 mm giữa hai cạnh, M1
   và M3 mỗi bên một cái). Không dùng spacer lục giác cỡ M3: chạm thân nhựa header
   ([danh sách mua](../bom/purchase_list_v1_module.md) mục 2). Miếng đệm dán ở góc thứ
   tư.
4. Đo lại 3V3–GND: không chập.

## 6. Bo đế với bo Waveshare (chưa có breakout và bo cổ tay)

1. Kiểm hướng bo Waveshare theo silkscreen (đầu USB, đầu anten) **trước khi cắm**: cắm
   ngược 180° làm chập 3V3–GND (A.2).
2. Cấp nguồn qua USB tester đặt trên cáp USB-C duy nhất của bo Waveshare (dòng đo gồm
   cả hub CH334 và cầu CH343, chưa có trong
   [power_budget_v1.md](../../configs/hardware/power_budget_v1.md); sửa 2026-10-27). Ghi dòng lúc cắm
   (trước khi host cấu hình thiết bị) và dòng ổn định; so với dòng của bo Waveshare
   đứng riêng ở mục 2. Rút USB ngay nếu dòng cao bất thường, điện áp USB
   sụt, hoặc có linh kiện nóng. Mức tham chiếu: ước lượng cả hệ khoảng 61 mA điển hình
   ([power_budget_v1.md](../../configs/hardware/power_budget_v1.md)); ở bước này chưa có
   breakout và bo cổ tay nên phải thấp hơn. Đo TP1–TP2: khoảng 3,3 V.
3. LED D1 nháy theo nhịp 0,5 s của firmware khung.
4. TP6 ở mức cao khi nhả SW1, mức thấp khi nhấn. Mỗi lần nhấn SW1, log UART0 in
   `t0 event` và luồng packet có một packet `0xC1`.

## 7. MAX30001 trên bo đế

Bước 2–6 dùng driver MAX30001 (từ 2026-10-25, chưa chạy trên chip): build
`pio run -d firmware -e esp32s3_devkitc_ecg_real`; log UART0 in `INFO` và kết quả
khởi động ([firmware/README.md](../../firmware/README.md) mục "Driver MAX30001").

1. Rút cáp USB-C, cắm breakout vào socket SV1, bắt vít vào lỗ NPTH 3,2 mm (bộ
   nylon M2; đầu vít hay đai ốc ở mặt trên breakout nhỏ hơn Ø 5 mm vì tụ C1 của breakout
   cách tâm lỗ 2,52 mm).
   Cấp nguồn lại qua USB tester, theo dõi dòng như mục 6: 3V3 vẫn khoảng 3,3 V;
   đầu ra LDO 1,8 V của breakout (AP2112K-1.8) khoảng 1,8 V.
2. Đọc thanh ghi `INFO` (0x0F): nửa byte cao bằng `0x5`, như thư viện ProtoCentral
   dùng để nhận chip (`protocentral_max30001_arduino_library`, `src/protocentral_max30001.cpp`).
3. Cấu hình theo A.2: 512 sps, gain 20 V/V, `ECG_DLPF` 40,96 Hz, tắt `ECG_DHPF`,
   lead-off DC 10 nA ±400 mV (chốt 2026-10-25), `EN_BIOZ = 0`, **tắt lead
   bias nội** (cấu hình 3 điện cực, VCM qua R3), `INTB_TYPE = 01` (CMOS) ở `EN_INT`
   và `EN_INT2`, `EFIT = 15`, `SAMP_IT = 00` (xung `SAMP` mỗi mẫu), `CLR_SAMP = 1`,
   chỉ `SAMP` ra INT2B (chốt 2026-10-24, Packet Schema V0.2 mục 7). Đọc lại từng thanh ghi đã ghi.
4. Oscilloscope:
   - INTB (GPIO21): xung theo ngưỡng `EFIT = 15`, tức 32 Hz khi đọc 16 mẫu một lần;
   - INT2B (GPIO47): xung `SAMP` 512 Hz khi `SAMP_IT = 00`, biên độ khoảng 3,3 V
     phía MCU (A.6 mục 4). Cạnh xung ứng với lúc mẫu vào FIFO, không phải lúc lấy
     mẫu analog (schema mục 5.2). Đo cực tính, độ rộng (khoảng 488 µs với
     `CLR_SAMP = 1`) và rung trước/sau TXB0108; kiểm MCPWM capture chốt đúng cạnh
     (build với `BOARD_SAMP_CAPTURE=1` và `BOARD_SAMP_RISING_EDGE` theo cực tính đo
     được; UART0 in số cặp đọc kẹp nhận/bị loại và sai số quy đổi, ngân sách dưới
     5 µs, [firmware/README.md](../../firmware/README.md) mục "Mốc `SAMP`"); kiểm xung
     đầu tiên sau `SYNCH` ứng với mẫu đầu tiên của FIFO (Packet Schema V0.2 mục 7.2).
     Bản build `esp32s3_devkitc_ecg_real` tắt bit 8 cho tới bước này. Đọc dòng log
     "ECG FIFO read - SAMP edge of the last sample": khớp đúng thì khoảng này nằm
     trong 0 tới khoảng 2 ms; lệch một mẫu thì dịch 1,953 ms. Kiểm qua nhiều lần
     khởi động lại ánh xạ, rồi mới build với `-DBOARD_SAMP_VERIFIED=1`.
   - Cực tính đo được truyền lúc build, không sửa `platformio.ini` hay
     `board_v1_module.h`, ví dụ khi đo được cạnh lên:
     `$env:PLATFORMIO_BUILD_FLAGS = "-DBOARD_SAMP_RISING_EDGE=1"` rồi
     `pio run -d firmware -e esp32s3_devkitc_ecg_real` (cạnh xuống là mặc định, 0).
     Mọi bản build có capture về sau (`all_real`, `sync10`) dùng cùng giá trị này.
     Ghi nguyên văn biến môi trường vào báo cáo ([firmware/README.md](../../firmware/README.md)
     mục "Bản build").
5. Tín hiệu nhân tạo qua cáp ECG (mạch chia áp ở
   [sync_10min_test_plan.md](sync_10min_test_plan.md) mục 3), không gắn người. Bước
   này là mức bắt buộc tối thiểu trước khi thử trên người (chốt 2026-10-29). Nút
   tham chiếu của mạch chia áp là sleeve (RL → R3 → VCM), không phải GND (chốt
   2026-10-25; cách đấu và mức chờ đợi ở mục 3 của kế hoạch đó). Trước khi nối: vẽ
   sơ đồ đấu nối, đo mức vi sai và mức chung ở đầu vào bằng oscilloscope; mức chung
   phải nằm trong khoảng 0,29–1,39 V.
   - xung dương đưa vào LA (ring) so với RA (tip) cho mẫu ECG dương;
   - ETAG của mẫu hợp lệ;
   - bật phát hiện lead-off DC rồi tháo một đầu bấm: có cờ `DCLOFFINT`, packet
     mang `STATUS` bit 2.
6. Tùy chọn (chốt 2026-10-29): nếu lab có ECG/patient simulator có hình thái QRS, nối
   simulator vào cáp ECG thay mạch chia áp, không gắn người, ghi vài phút và kiểm phát
   hiện R-peak offline: số R-peak khớp nhịp đặt trên simulator. Mạch chia áp ở bước 5
   không kiểm được việc này. Không có simulator thì ghi "không làm" vào báo cáo; bước 5
   vẫn là mức bắt buộc.

## 8. Bo cổ tay qua cáp

1. Rút cáp USB-C. Đo thông mạch cáp 16 dây: chân n ↔ chân n; GND ở chân 2,
   4, 6, 8, 10, 12, 14; chân 1 (3V3) không chập GND. Cắm cáp vào J2 và J1 (đúng khe
   khóa), vẫn chưa cấp nguồn, đo xuyên cả hệ (thêm 2026-10-27, để bắt J1 hàn nhầm mặt
   hay sai loại khe khóa): TP1 (3V3) ↔ chân 3.3V của M1 và chân 3V3 của M3; TP2 (GND)
   ↔ chân GND của M1 và M3; pad 17 của U1 (GPIO11) ↔ chân SDA của M3 (qua R10 33 Ω);
   pad 19 của U1 (GPIO13) ↔ chân ADR của M3; 3V3 không chập GND. Sai một phép đo thì
   không cấp nguồn.
2. Cấp nguồn lại qua USB tester, theo dõi dòng như mục 6. Đo 3V3 tại chân C2 của bo cổ tay (bo cổ tay không có test point).
   Ghi dòng 5 V USB ổn định khi LED PPG ở mã mặc định và ở 0x7F, so với
   [power_budget_v1.md](../../configs/hardware/power_budget_v1.md) (khoảng 61 và 112 mA).
   Chụp dòng khởi động bằng oscilloscope qua điện trở shunt nối tiếp đường 5 V, vì USB
   tester không bắt được xung nạp trước khoảng 500 mA, 400 µs của boost PAM2401
   (thêm 2026-10-26).
3. Nguồn LED của MAX30101 (net 5V trên bo SparkFun), theo A.6 mục 3:
   - khi không tải: khoảng 5,1 V danh định;
   - lúc khởi động: quá áp, chụp bằng oscilloscope;
   - khi LED xanh chạy xung dòng cao nhất đã chọn: gợn, đo cùng lúc với 3V3 tại bo
     cổ tay;
   - so với dải 4,5–5,0 V dùng chung cho cả ba LED.
4. Bus I²C PPG (`I2C_NUM_0`; GPIO8 SDA, GPIO9 SCL, 400 kHz):
   - quét bus chỉ thấy địa chỉ 7 bit `0x57`;
   - đọc `PART_ID` (0xFF) = `0x15` (MAX30101 Rev 2, tr. 12);
   - chụp sườn lên của SCL tại TP4 (bo đế); quá chậm qua cáp thì lùi 100 kHz (A.2).
5. Bus SPI IMU (`SPI3_HOST`; GPIO10 CS, GPIO11 MOSI, GPIO12 SCK, GPIO13 MISO, bắt đầu 1 MHz):
   - BMI270 khởi động ở I²C; một lần đọc giả chuyển sang SPI; mỗi lần đọc SPI có
     một byte giả trước dữ liệu (BST-BMI270-DS000-08, tr. 17, 123, 125);
   - đọc `CHIP_ID` (0x00) = `0x24` (tr. 75);
   - khởi tạo theo tr. 18: `PWR_CONF` (0x7C) = 0x00, chờ ≥ 450 µs, `INIT_CTRL`
     (0x59) = 0x00, ghi file cấu hình của Bosch vào `INIT_DATA` (0x5E), `INIT_CTRL`
     = 0x01, rồi kiểm trạng thái khởi tạo theo datasheet;
   - chụp SCK tại TP5 (phía cáp): dội nhiều thì chỉnh R9–R11; ổn mới lên 2 MHz (A.2);
   - kiểm dấu trục bằng trọng lực (A.3; thêm 2026-10-29): đặt bo cổ tay đứng yên lần
     lượt với trục +X, +Y, +Z của bo hướng lên, ghi gia tốc ba trục; dấu phải khớp ánh
     xạ trục bo = (−X, +Y, −Z) của BMI270 (Packet Schema V0.2 mục 2).
   Driver BMI270 làm các việc này khi khởi động (từ 2026-10-25, chưa chạy trên chip):
   build `pio run -d firmware -e esp32s3_devkitc_imu_real`, log UART0 in
   `BMI270 start` và tốc độ SPI ([firmware/README.md](../../firmware/README.md) mục
   "Driver BMI270"). Lên 2 MHz bằng `-DBOARD_IMU_SPI_HZ=2000000`.
   Từ bước 4, driver MAX30101 làm các việc này khi khởi động (từ 2026-10-25, chưa
   chạy trên chip): build `pio run -d firmware -e esp32s3_devkitc_ppg_real`, log UART0
   in `REV_ID` và kết quả khởi động ([firmware/README.md](../../firmware/README.md)
   mục "Driver MAX30101"). Lùi 100 kHz bằng `-DBOARD_PPG_I2C_HZ=100000`.
6. Tốc độ PPG (A.6 mục 3): multi-LED ba khe (`SLOT1` xanh, `SLOT2` đỏ, `SLOT3` IR) ở 200 sps,
   `SMP_AVE = 1`. Kiểm `PPG_RDY` có báo mỗi mẫu ở chế độ ba khe không (xóa bằng đọc
   0x00; không có thì firmware chuyển sang đọc theo timer, Packet Schema V0.2 mục 7.6).
   Đọc lại `SPO2_SR` và đo tốc độ ra từng khe: phải bằng tốc độ cấu
   hình trong sai số dao động; còn một nửa hay bội số khác nghĩa là chip đã đổi tốc
   độ.
7. Không kiểm K5 (dây cáp và dây điện cực không kéo hay đè bo PPG, protocol mục
   5.4) ở bring-up, cũng không dùng tay giả. K5 kiểm trên thành viên nhóm ở lần đeo
   đầu tiên (G2), trước buổi pilot đầu tiên (chốt 2026-10-29).
8. Nguồn và tín hiệu khi cả hệ chạy (`custom_board_proposal.md` mục A.3: từ
   V1-draft5, 3V3 của breakout ECG và cụm tụ C3/C4/C6–C8 đi dây riêng từ U1.1, tách
   khỏi nhánh cáp U1.2 → J2 mang dòng xung LED PPG), với cáp dài nhất. Bản build ba
   chip thật (thêm 2026-10-29): capture `SAMP` có, bit 8 tắt, không xung kích thích,
   không cờ tạo lỗi; cực tính `SAMP` đo ở mục 7 bước 4 và độ rộng xung đang thử
   truyền lúc build (ví dụ dưới là cạnh lên và 411 µs; bỏ cờ nào còn là mặc định):

   ```powershell
   $env:PLATFORMIO_BUILD_FLAGS = "-DBOARD_SAMP_RISING_EDGE=1 -DBOARD_PPG_LED_PW_US=411"
   pio run -d firmware -e esp32s3_devkitc_all_real -t upload --upload-port COM5
   Remove-Item Env:PLATFORMIO_BUILD_FLAGS
   ```

   Đổi LED PPG lên mã cao nhất định dùng bằng `device_command.py set-ppg-led` trong
   lúc `record --commands` (mã ≤ `0x7F`). Đo:
   - 3V3 tại bo Waveshare, VCC breakout (J1.2–J1.3, bằng oscilloscope) và 1,8 V của
     breakout, 3V3 tại M1 khi LED PPG chạy xung cao nhất (và radio nếu có bật);
   - nhiễu trên ECG khi bật/tắt LED PPG;
   - SCK, MOSI, CS tại BMI270 và MISO tại MCU ở 1 rồi 2 MHz;
   - sườn lên I²C ≤ 300 ns ở cả hai phía bộ chuyển mức trên bo SparkFun;
   - sườn giả trên `PPG_SCL`, `T0_BTN`, `ECG_CS` khi `BMI_SCK` và `LED_STAT` đảo
     liên tục.
9. Chạy cả hệ 120 phút, bằng buổi đo dài nhất trong hồ sơ đạo đức (sửa 2026-11-07, trước là 75
   phút theo kế hoạch 28 tuần), như một buổi đo (chỉ một cáp USB-C, laptop chạy pin, LED PPG ở
   mã cao nhất định dùng, chưa gắn lên người), cùng bản build
   `esp32s3_devkitc_all_real` và cùng `PLATFORMIO_BUILD_FLAGS` như bước 8, ghi luồng
   packet bằng `record --commands` suốt buổi; mỗi 15 phút ghi dòng 5 V USB, 3V3 tại
   TP1–TP2 và nhiệt độ vỏ LDO 3,3 V của bo Waveshare (mã LDO đọc khi nhận hàng,
   [power_budget_v1.md](../../configs/hardware/power_budget_v1.md)) (nhiệt kế hồng ngoại hay cặp nhiệt),
   kèm nhiệt độ phòng. Đạt khi dòng và 3V3 ổn định và nhiệt độ LDO thôi tăng trước khi
   hết buổi, pin laptop còn đủ tới hết 120 phút, và `record` ghi xong đủ file đầu ra cùng
   manifest (ghi đỉnh RAM của tiến trình logger); tăng liên tục hay 3V3 sụt thì dừng và xét lại mã LED tối đa
   ([power_budget_v1.md](../../configs/hardware/power_budget_v1.md) mục 4; thêm
   2026-10-26).
10. Nhiễu đèn trên PPG (thêm 2026-10-29), không người, sau bước 6 (cần `fs_thực` của
    từng khe đo ở bước đó). Đèn điện lưới 50 Hz nhấp nháy ở 100 Hz và các hài. Với PPG
    lấy mẫu `fs_thực` ≈ 200 sps, hài 200 Hz gập về |`fs_thực` − 200| Hz, gần 0 Hz, có thể
    rơi vào dải PPG; khử ánh sáng môi trường (ALC) của MAX30101 có thể khử được hay
    không, chưa biết.
    - Bản build `esp32s3_devkitc_ppg_real` (hay `all_real`), cùng độ rộng xung và mã LED
      như bước 6; mã LED và độ rộng xung ghi vào báo cáo (`0xD2` của phiên).
    - Ba điều kiện, mỗi điều kiện ghi vài phút (đề xuất 3 phút) bằng `record`, bo cổ tay
      nằm yên, cửa sổ cảm biến quay lên, không có gì che hay chạm:
      (a) cảm biến trong hộp tối; (b) ngoài hộp, dưới đèn phòng bật; (c) ngoài hộp, đèn
      phòng tắt. Ghi loại đèn (huỳnh quang, LED, …) và khoảng cách tới đèn.
    - Phân tích offline, mỗi khe (`0xF1`–`0xF3`) mỗi điều kiện: tính phổ (ví dụ Welch,
      chỉ trên các chuỗi liên tục, không nối qua khoảng mất), tìm đỉnh quanh
      |`fs_thực` − 200| Hz với `fs_thực` của khe đó. Ghi tần số đỉnh, biên độ đỉnh so với
      nền (tỉ số với trung vị phổ ở dải lân cận, dB) và cùng đại lượng ở dải 0,5–8 Hz.
      Cách tính phổ và dải lân cận chốt trước khi xem kết quả.
    - Đạt khi không có đỉnh nào trong dải 0,5–8 Hz vượt rõ nền ở điều kiện (b) so với (a)
      và (c). Có thì ghi lại (tần số, biên độ, khe, loại đèn), chưa đặt ngưỡng số:
      ngưỡng chờ số đo. Kết quả này chưa thay được kiểm tra trên người.

## 9. Đo đồng bộ 10 phút

Theo [sync_10min_test_plan.md](sync_10min_test_plan.md), sau khi mục 7 và 8 đạt và đã
chốt độ rộng xung LED (luật ở
[interface_power_sampling_v0.md](../../configs/hardware/interface_power_sampling_v0.md)
mục 6). Bản build `esp32s3_devkitc_sync10`, với cực tính `SAMP` của mục 7 bước 4 và độ
rộng xung đã chốt truyền qua `PLATFORMIO_BUILD_FLAGS`.

## 10. Đo dòng rò trước khi dùng trên người

Đề xuất của nhóm 2026-10-29, chờ thầy duyệt. Phương pháp, giới hạn và biên bản theo
[session_safety_stopping_v0.1.md](../../docs/ethics/session_safety_stopping_v0.1.md)
mục 9 (số mục theo bản viết lại 2026-10-31).

- Dụng cụ: ưu tiên mượn máy phân tích an toàn điện y tế; không mượn được thì dùng
  mạch đo MD theo IEC 60601-1 và đồng hồ vạn năng.
- Đo trên cấu hình dùng thật: PCB V1 (bo đế, cáp, bo cổ tay) đã lắp đủ, bo Waveshare,
  một cáp USB-C, laptop chạy pin, rút sạc.
- Loại bộ phận ứng dụng dự kiến là BF (điện cực ECG dán da), chờ xác nhận.
- Thử nhiệt (đề xuất 2026-10-31, chờ thầy): chạy liên tục 120 phút với mã LED ở trần
  `0x7F`, ở nhiệt độ phòng đo; đo nhiệt độ bề mặt bo cổ tay ở mặt tiếp xúc da. Giới hạn trích
  từ IEC 60601-1 khi viết biên bản.
- Chưa có biên bản đạt thì không gắn điện cực lên người.

## 11. Ghi kết quả

Mỗi lần bring-up ghi một file `hardware/test_reports/<YYYY-MM-DD>_v1_bringup.md`:

- ngày, người làm, revision hai bo (theo title block KiCad, hiện cả hai là V1-draft5);
- ký hiệu module, kết quả `chip_id` và `espefuse summary` (các trường VDD_SPI),
  revision breakout MAX30001, kết quả đo thông mạch cáp ECG;
- commit firmware, env PlatformIO, giá trị nguyên văn của `PLATFORMIO_BUILD_FLAGS` (hay
  "không đặt") và ELF SHA-256, `SESSION_ID` của mỗi lần ghi;
- giá trị đo ở từng bước, ảnh oscilloscope; ghi riêng "giá trị thiết kế/datasheet"
  và "giá trị đo được";
- bước không đạt, cách xử lý.

Dữ liệu thô và ảnh dung lượng lớn lưu ngoài Git (`runs/`) theo chính sách dữ liệu;
báo cáo ghi đường dẫn và SHA-256.

## Ngoài phạm vi bring-up

Trước khi đo trên người, kể cả thành viên nhóm ở G2: phê duyệt đạo đức (hoặc thầy
xác nhận việc đo thành viên nhóm không cần phê duyệt) và biên bản đo dòng rò trên bo
V1 thật (mục 10). K3–K5 của protocol mục 5.4 kiểm trên thành viên nhóm ở G2, trước
buổi pilot đầu tiên.
