ndhuy1127/ppg-ecg-blood-pressure/hardware/test_reports/sync_10min_test_plan.md

# Kế hoạch đo đồng bộ ECG–PPG 10 phút (thử trên bàn với PCB V1, không người)

> Chưa thực hiện vì chưa có phần cứng. Chỉ tiêu đạt/không
> đạt chưa chốt; theo `configs/hardware/hardware_requirements_for_V0.md` §4.4,
> giới hạn jitter/drift chỉ đặt sau khi có số đo đầu tiên.

## 1. Mục tiêu

Trên thiết bị V1 (PCB V1-module) đã qua bring-up, đo trong 10 phút liên tục:

1. Tốc độ lấy mẫu **thực** của từng kênh so với tốc độ danh định.
2. Drift: tốc độ thực của mỗi kênh lệch bao nhiêu so với clock MCU, và hai kênh
   lệch nhau bao nhiêu theo thời gian.
3. Jitter của mốc đọc FIFO (`T_ANCHOR_US`).
4. Độ trễ hiệu dụng của từng kênh (gộp `d_pipe` và `δ` trong packet schema) và
   **lệch thời gian ECG–PPG** (offset) sau khi dựng lại thời điểm mẫu.
5. Tỷ lệ mất packet, mất mẫu bên trong AFE và lỗi CRC.

Kết quả dùng để hiệu chỉnh thời gian trước khi tính PAT. Phép đo này **không**
dùng PAT hay mốc sinh lý để suy ra lệch clock.

## 2. Điều kiện trước khi đo

- Bring-up đạt tới bước giao tiếp và thu được dữ liệu từ cả hai AFE
  ([v1_bringup_procedure.md](v1_bringup_procedure.md) mục 7–8).
- Firmware gửi packet có `FIRST_SAMPLE_INDEX`, `T_ANCHOR_US` và packet sự kiện
  `0xC1`. Phép đo `L_ECG,SAMP` cần firmware V0.2 có mốc `SAMP` (bit 8, Packet Schema
  V0.2 mục 7); lần đo với firmware V0.1 chỉ cho `L_ECG` của mốc đọc FIFO và ghi riêng.
- Cấu hình AFE (tốc độ, FMSTR, chế độ LED, lấy trung bình, bộ lọc) đã ghi vào
  metadata phiên. Mỗi cấu hình khác nhau là một lần đo riêng.
- **Độ rộng xung LED đã chốt** (thêm 2026-10-29) theo luật viết trước ở
  [interface_power_sampling_v0.md](../../configs/hardware/interface_power_sampling_v0.md)
  mục 6, từ số đo bring-up mục 8. Chưa chốt thì chưa đo: khoảng lệch giữa các khe PPG
  và `L_PPG` phụ thuộc độ rộng xung. `sync10` mặc định 411 µs; chọn 215 µs thì build
  với `-DBOARD_PPG_LED_PW_US=215` (mục 3). Kiểm `SPO2_CONFIG` trong `0xD2` của phiên
  khớp độ rộng xung đã chọn.
- **Cực tính `SAMP` đã kiểm** ở bring-up mục 7 bước 4, cùng việc xung `SAMP` đầu tiên
  ứng với mẫu đầu tiên của FIFO (mục 3).
- **Không gắn điện cực lên người.** Mọi đo đạc dùng tín hiệu nhân tạo.

## 3. Bố trí kích thích chung

Cần một sự kiện vật lý mà **cả hai kênh cùng thấy**, với thời điểm do chính MCU
ghi lại:

- GPIO6 của ESP32-S3, đưa ra header J3 (GPIO6, GND) trên bo đế (chốt 2026-10-24,
  `custom_board_proposal.md` A.2), phát xung vuông, chu kỳ 1 s, độ rộng khoảng
  50 ms.
  MCU gửi packet sự kiện mã `3` với `T_ANCHOR_US` tại cạnh lên.
- **Firmware (chốt 2026-10-25, chưa chạy trên chip):** bản build
  `pio run -d firmware -e esp32s3_devkitc_sync10` (ba chip thật, capture `SAMP` có
  bit 8 nhờ `BOARD_SAMP_VERIFIED=1`, xung bật bằng `BOARD_STIM=1`). Chỉ nạp bản này sau
  khi bring-up mục 7 đã xác nhận cạnh `SAMP` đầu tiên ứng với mẫu đầu tiên của FIFO;
  chưa xác nhận thì packet ECG mang bit 8 sai mốc (sửa 2026-10-25: bản trước thiếu cờ
  này nên không có bit 8, không đo được `L_ECG,SAMP`). Cạnh lên đầu tiên 2 s sau khi khởi động; các cạnh sau
  cách nhau 1 000 000 µs cộng độ lệch đều trong [0; 1 953) µs (`stim_plan.c`,
  xorshift32), lịch tính theo thời điểm đích nên độ trễ callback không cộng dồn;
  độ rộng 50 000 µs. `T_ANCHOR_US` của packet mã 3 là `esp_timer` đọc **ngay sau**
  khi đặt GPIO6 lên mức cao (sai số cỡ µs, gồm cả độ trễ ghi GPIO). Seed của dãy độ
  lệch là `SESSION_ID`, có trong mọi packet: mỗi lần khởi động một dãy mới, tái lập
  được. Số thứ tự sự kiện đếm chung với sự kiện t0 (Packet Schema V0.1 mục 10).
- **Cờ build của `sync10` (chốt 2026-10-29):** env này đặt sẵn `BOARD_SAMP_VERIFIED=1`
  và `BOARD_STIM=1`, nên chỉ dùng sau khi bring-up mục 7 bước 4 đã kiểm cực tính
  `SAMP`, và phải truyền đúng cạnh đo được. Mặc định của firmware là cạnh xuống
  (`BOARD_SAMP_RISING_EDGE=0`). Sai cạnh thì mốc bit 8 lệch một khoảng cố định, cỡ độ
  rộng xung `SAMP` (khoảng 488 µs); logger không bắt được lệch cố định này, và
  `L_ECG,SAMP` đo ở đây chỉ đúng với cạnh đã dùng. Độ rộng xung LED truyền cùng lúc.
  Giá trị đo được truyền lúc build bằng biến môi trường, không sửa `platformio.ini`
  ([firmware/README.md](../../firmware/README.md) mục "Bản build"):

  ```powershell
  $env:PLATFORMIO_BUILD_FLAGS = "-DBOARD_SAMP_RISING_EDGE=1 -DBOARD_PPG_LED_PW_US=411"
  pio run -d firmware -e esp32s3_devkitc_sync10 -t upload --upload-port COM5
  Remove-Item Env:PLATFORMIO_BUILD_FLAGS
  ```

  (ví dụ: cạnh lên, 411 µs.) Ghi nguyên văn biến môi trường, commit và ELF SHA-256
  (packet `0xD1`) vào báo cáo; cực tính `SAMP` không có trong luồng packet.
- **Kênh ECG:** đưa xung qua mạch chia áp vào đầu vào điện cực của breakout
  MAX30001, để biên độ ở mức vài mV (đúng dải ECG). Mạch chia áp là mức bắt buộc tối
  thiểu (chốt 2026-10-29, [bring-up](v1_bringup_procedure.md) mục 7 bước 5). ECG/patient
  simulator có QRS, nếu lab có, dùng cho bước tùy chọn kiểm phát hiện R-peak (bring-up
  mục 7 bước 6); chỉ thay mạch chia áp trong phép đo này khi simulator có đầu vào
  trigger nhận xung GPIO6. Không nối GPIO trực tiếp vào đầu vào ECG.
  **Nút tham chiếu (chốt 2026-10-25): nút "cơ thể" nối chân sleeve của jack điện
  cực** (RL → R3 220 kΩ → VCM), không phải GND của bo. Lý do: ở AVDD = 1,8 V đầu
  vào ECG chỉ làm việc trong VMID ± 550 mV, VMID = AVDD/2,15 ≈ 0,84 V, tức khoảng
  0,29–1,39 V (MAX30001 tr. 3, tr. 22); GND 0 V nằm ngoài dải này, còn VCM 0,65 V
  (tr. 8) nằm trong. Đấu nối: tip (RA) nối sleeve; GPIO6 → điện trở trên cỡ 10 MΩ →
  ring (LA) → điện trở dưới cỡ 3,3 kΩ → sleeve. Ước lượng (kiểm bằng
  oscilloscope trước khi chạy; mạch là GPIO6 → 10 MΩ → 3,3 kΩ → R3 220 kΩ → VCM
  0,65 V): khi GPIO6 ở 3,3 V, dòng khoảng (3,3 − 0,65) V / 10,22 MΩ ≈ 0,26 µA, cho
  vi sai khoảng +0,86 mV ở LA so với RA và đẩy mức chung lên khoảng 57 mV qua R3;
  khi GPIO6 ở 0 V, dòng khoảng −64 nA, vi sai khoảng −0,21 mV, mức chung lệch khoảng
  −14 mV. Biên độ xung vi sai vì vậy khoảng 1,07 mV, mọi mức vẫn trong dải trên. Ghi
  giá trị điện trở thực tế và số đo vào sơ đồ đấu nối.
- **Kênh PPG:** cùng xung đó điều khiển một LED ngoài (qua điện trở hạn dòng)
  đặt trên cửa sổ cảm biến MAX3010x, trong hộp tối. Ánh sáng tăng làm số đếm ADC
  tăng. Chọn dòng LED để không bão hòa ADC hay tràn khử ánh sáng môi trường
  (STATUS bit 6 phải bằng 0).
- **Chưa kiểm:** MAX3010x có khử ánh sáng môi trường (ambient light
  cancellation, ALC). LED ngoài sáng liên tục trong cả xung 50 ms có thể bị ALC
  coi là ánh sáng môi trường và trừ đi, khi đó số đếm ADC không tăng như giả định
  ở trên [chưa đối chiếu datasheet]. Bit 6 = 0 (`ALC_OVF` không bật) chỉ cho biết
  ALC chưa tràn, không chứng minh kích thích thấy được trong dữ liệu PPG. Phải
  thử trên bàn với PCB V1 (không người), sau bring-up mục 8, nhìn trực tiếp số đếm
  ADC tại cạnh xung, trước khi chạy đủ 10 phút (mục 8).
- Ghi lại sơ đồ đấu nối thực tế, giá trị điện trở, khoảng cách LED–cảm biến.

Nếu chưa dựng được kích thích chung, vẫn đo được mục 1–3 và 5 (chỉ dùng chỉ số
mẫu và `T_ANCHOR_US`), nhưng **chưa** đo được offset ECG–PPG (mục 4).

Trên KiCad V1-module (pin map chuẩn của V1), INT2B của MAX30001 đã nối vào GPIO47
(`configs/hardware/custom_board_proposal.md` mục A.6, A.7). Firmware bật xung `SAMP`
luôn và dùng làm mốc thời gian ECG (chốt 2026-10-24; xung ở tốc độ dữ liệu ECG, lúc
mẫu vào FIFO chứ không phải lúc lấy mẫu analog; MAX30001 tr. 42, tr. 44;
`Packet_Schema_V0.1.md` mục 5.2), nên bản cuối cũng phải nối INT2B. Trong phép đo
này, ghi thêm thời điểm các cạnh xung.
Chúng cho tốc độ ECG thực độc lập với mốc đọc FIFO và kiểm tra chéo được kết quả
hồi quy ở mục 5.

Độ trễ ECG dự kiến để đối chiếu với `L_ECG` đo được: MAX30001 tr. 26, Bảng 4 chỉ
cho độ trễ bộ lọc số (ví dụ 512 sps: 19,836 ms không LPF, 31,555 ms có LPF). Ghi
chú ứng dụng của ADI cho MAX30003 đo thêm 1,003 ms trễ lấy mẫu ADC, tức 20,839 /
32,558 ms tính từ lúc lấy mẫu analog tới cạnh xuống của xung `SAMP` (ngay sau khi
mẫu vào FIFO), độ lệch chuẩn khoảng 3–4 µs (`Packet_Schema_V0.1.md` mục 5.2).
`L_ECG` tính theo `T_ANCHOR_US` còn cộng thêm thời gian mẫu nằm trong FIFO trước khi
được đọc. Kết quả đo lệch xa các giá trị này là dấu hiệu sai cấu hình hoặc sai cách
gán thời điểm.

Từ V0.2, packet ECG có bit 8 mang mốc `SAMP` (Packet Schema V0.2 mục 7). Với các packet này,
đại lượng đo là `L_ECG,SAMP`: độ trễ từ lúc lấy mẫu analog tới cạnh `SAMP` đã chốt,
**không** gồm thời gian mẫu nằm trong FIFO. Tính và báo riêng `L_ECG,SAMP` và `L_ECG`
của mốc đọc FIFO; khi phân tích không trừ cả hai. Nếu ánh xạ xung ↔ mẫu lệch cố định
một mẫu, `L_ECG,SAMP` đo được lệch 1,953 ms so với giá trị dự kiến: phép đo này là
kiểm tra độc lập cho ánh xạ đó.

## 4. Quy trình

1. Khởi động MCU, ghi metadata phiên. Laptop chạy pin.
2. Thu 1 phút để ổn định, bỏ khỏi phân tích (ghi lại, không xóa).
3. Thu 10 phút liên tục với kích thích khoảng 1 Hz: khoảng 600 sự kiện. Mỗi xung
   cách xung trước 1 s cộng một độ lệch ngẫu nhiên đều trong [0; 1 953) µs (seed là
   `SESSION_ID`, ghi lại vào metadata; thời điểm thật của từng xung đã có trong packet
   sự kiện), để pha của
   xung phủ đều một chu kỳ mẫu ECG. Một chu kỳ cố định (ví dụ 1 000 049 µs) có thể
   khóa pha nếu tốc độ ECG thật lệch đúng khoảng −49 ppm. Khi phân tích, đo độ phủ pha
   so với cạnh `SAMP`; chỉ báo `L_ECG,SAMP` với độ phân giải dưới một mẫu khi độ phủ
   đạt, nếu không thì khởi động lại MCU (`SESSION_ID` mới là seed mới) và đo lại.
4. Lặp lại 3 lần cho mỗi cấu hình, khởi động lại MCU giữa các lần.
5. Lưu: file packet nhị phân thô, file `t_rx` của PC, metadata JSON, sơ đồ đấu nối,
   SHA-256 của từng file, commit firmware và commit script phân tích.

## 5. Phân tích

Ký hiệu cho mỗi kênh c: `k` là chỉ số mẫu tích lũy của mẫu cuối mỗi packet,
`A_us(k)` là `T_ANCHOR_US` tương ứng (µs); `fs_c` tính bằng Hz.

Mọi hồi quy và chỉ số dưới đây tính riêng cho từng phiên, từng chuỗi liên tục (ranh
giới bit 5) và, với ECG, từng nguồn mốc (bit 8 = 1: mốc `SAMP`; bit 8 = 0: mốc đọc
FIFO; Packet Schema V0.2 mục 7.5); bỏ anchor của packet bit 0/bit 7. Không gộp hai
nguồn mốc trong một hồi quy, và `L_ECG` luôn ghi kèm nguồn mốc.

**Ba khe PPG (chốt 2026-10-29).** Theo quy ước offset giữa các khe
([Packet_Schema_V0.1.md](../../configs/hardware/Packet_Schema_V0.1.md) mục 7): mốc
`t'` của khe j là mốc dựng theo V0.1 mục 5.3 cộng (j − 1) · Δ(PW), gốc là khe 1, Δ
suy từ `SPO2_CONFIG` trong `0xD2` của phiên.

- `L_PPG` đo trên trục thời gian **đã cộng** Δ: một giá trị `L_PPG` cho cấu hình, ước
  lượng từ cạnh kích thích thấy trên các khe sau khi cộng Δ.
- Phần dư theo từng khe (`L_PPG,j` riêng từng khe trừ `L_PPG`) chỉ để kiểm quy ước (ví
  dụ Δ sai hay một khe lệch), **không** trừ lần hai khi dựng thời gian mẫu.
- Ghi version của quy ước cùng kết quả; Δ danh định 1 107 µs (411 µs) hay 720 µs
  (215 µs), Δ dùng thật suy từ `0xD2`.

| Chỉ số | Cách tính |
| --- | --- |
| Tốc độ thực `fs_c` | Hồi quy tuyến tính `A_us(k) = a_us + b_us · k`, với `b_us = 10⁶ / fs_c` (µs/mẫu; ví dụ 200 Hz cho `b_us ≈ 5 000`). Suy ra `fs_c = 10⁶ / b_us`, báo cáo kèm khoảng tin cậy |
| Drift so với danh định | `(fs_c / fs_danh_định − 1) × 10⁶` ppm |
| Drift ECG so với PPG | Hiệu hai giá trị ppm; quy ra µs lệch tích lũy sau 10 phút |
| Jitter mốc đọc | Độ lệch chuẩn và phân vị 99 của phần dư hồi quy (µs) |
| Thời điểm mẫu tạm | `t'_us[i]` theo packet schema mục 5.3, dùng `fs_c` đã ước lượng nhưng **tạm đặt** `δ = 0`, `d_pipe = 0` |
| Độ trễ hiệu dụng `L_c` | Với mỗi sự kiện: thời điểm cạnh trong tín hiệu theo `t'` trừ `T_ANCHOR_US` của packet sự kiện; lấy trung vị. `L_c` gộp `d_pipe` và giá trị trung bình của `δ`, chính là lượng cần trừ khỏi `t'` |
| Jitter theo sự kiện | Độ lệch chuẩn của hiệu trên qua 600 sự kiện |
| Offset ECG–PPG | `L_ECG − L_PPG` cho từng nguồn mốc ECG (`L_ECG,SAMP` và `L_ECG` của mốc đọc FIFO báo riêng), kèm khoảng tin cậy |
| Ổn định theo thời gian | Vẽ hiệu trên theo thời gian; độ dốc khác 0 là drift chưa hiệu chỉnh |
| Mất dữ liệu | Số `SEQ` thiếu / tổng; số mẫu mất từ `FIRST_SAMPLE_INDEX`; số lần STATUS bit 0, 1, 5; số lỗi CRC |

**Dấu của offset so với mô phỏng.** `L_c` là lượng thời điểm cạnh trên trục `t'`
của kênh c đi sau `T_ANCHOR_US` của sự kiện, nên cùng một cạnh vật lý có nhãn
thời gian trên kênh PPG trừ nhãn trên kênh ECG bằng `L_PPG − L_ECG`. Mô phỏng
`synthetic-packet-v2` báo `offset_ppg_minus_ecg_us` = anchor PPG − anchor ECG
(`software/data_io/packet_simulation.py`, `replay_packets`; anchor là
`timestamp_us` của packet hợp lệ đầu tiên quy về sequence start, hai kênh cùng
epoch giả lập), tức cùng ý nghĩa "nhãn PPG trừ nhãn ECG". Vì vậy
`offset_ppg_minus_ecg_us` tương ứng `L_PPG − L_ECG = −(L_ECG − L_PPG)`: đổi dấu
offset ở bảng trên trước khi so với mô phỏng. Dương nghĩa là kênh PPG gán nhãn
muộn hơn kênh ECG.

Cách phát hiện cạnh (ngưỡng, nội suy giữa hai mẫu) phải chốt **trước** khi xem
kết quả và giữ nguyên cho mọi lần đo. Độ phân giải thời gian bị giới hạn bởi
chu kỳ lấy mẫu; ghi rõ trong báo cáo.

## 6. Báo cáo

Lưu tại `hardware/test_reports/` dưới dạng báo cáo có ngày, kèm: cấu hình, sơ đồ
đấu nối, đường dẫn và SHA-256 của dữ liệu thô (dữ liệu thô lưu ngoài Git theo
chính sách dữ liệu), bảng chỉ số ở mục 5 cho từng lần đo, các bất thường và giới
hạn. Ghi riêng "giá trị thiết kế/datasheet" và "giá trị đo được".

## 7. Giới hạn

- Kích thích nhân tạo không có hình thái sinh lý; kết quả chỉ nói về thời gian
  của chuỗi đo, không nói về chất lượng tín hiệu trên người.
- Độ trễ của LED ngoài và mạch chia áp được coi là không đáng kể so với chu kỳ
  lấy mẫu; nếu nghi ngờ, kiểm tra bằng oscilloscope.
- Độ trễ hiệu dụng phụ thuộc cấu hình: đổi tốc độ, bộ lọc hay lấy trung bình
  thì phải đo lại.

## 8. Việc còn mở

1. Kích thích PPG bằng LED ngoài có bị ALC của MAX3010x trừ đi không, và cách
   hiểu STATUS bit 6 (`ALC_OVF`) trong phép đo này (mục 3). Kiểm trước, khi thử
   trên bàn với PCB V1 (không người) sau bring-up mục 8.
2. MAX30101 ở multi-LED ba khe: datasheet không có bảng tổ hợp tốc độ × độ rộng
   xung cho chế độ này (`custom_board_proposal.md` A.6 mục 3), và chip tự đổi tốc
   độ khi tổ hợp không được phép. Trước khi đo, đọc lại thanh ghi `SPO2_SR`; khi
   đo, so tốc độ thực từng khe với tốc độ cấu hình chia `SMP_AVE` (bắt đầu với
   `SMP_AVE = 1`). Chênh lệch nằm trong sai số dao động nội là bình thường; chênh
   theo bội số (ví dụ còn một nửa) nghĩa là chip đã đổi tốc độ.
