ndhuy1127/ppg-ecg-blood-pressure/reports/weekly/week_06/experiment_tracking/multiseed_table.md

Status: **DETERMINISTIC** (seeds 42, 43, 44; val only)

| Model | Target | Metric | min | max | max − min | SD |
| --- | --- | --- | ---: | ---: | ---: | ---: |
| B0 | DBP | subject_balanced_mae | 10.4048 | 10.4048 | 0 | 0 |
| B0 | DBP | subject_balanced_bias | 2.1153 | 2.1153 | 0 | 0 |
| B0 | DBP | sample_sd | 12.7812 | 12.7812 | 0 | 0 |
| B0 | SBP | subject_balanced_mae | 15.1061 | 15.1061 | 0 | 0 |
| B0 | SBP | subject_balanced_bias | 4.2967 | 4.2967 | 0 | 0 |
| B0 | SBP | sample_sd | 18.7942 | 18.7942 | 0 | 0 |
| B3 | DBP | subject_balanced_mae | 10.1227 | 10.1227 | 0 | 0 |
| B3 | DBP | subject_balanced_bias | 1.4400 | 1.4400 | 0 | 0 |
| B3 | DBP | sample_sd | 12.4898 | 12.4898 | 0 | 0 |
| B3 | SBP | subject_balanced_mae | 14.5820 | 14.5820 | 0 | 0 |
| B3 | SBP | subject_balanced_bias | 3.9640 | 3.9640 | 0 | 0 |
| B3 | SBP | sample_sd | 18.3924 | 18.3924 | 0 | 0 |
