ndhuy1127/ppg-ecg-blood-pressure/reports/weekly/week_06/experiment_tracking/registry_runs.md

| Experiment | Run | Commit | Seeds | Panel | Model | n subj. | SBP MAE | SBP bias | DBP MAE | DBP bias |
| --- | --- | --- | --- | --- | --- | ---: | --- | --- | --- | --- |
| b3_pulsedb | 20261024T193656162418Z | 4be5a6d* | b3=42 | main | B0 | 40 | 15.11 [13.47; 16.88] | 4.30 [0.79; 7.67] | 10.40 [9.12; 11.80] | 2.12 [-0.92; 5.14] |
| b3_pulsedb | 20261024T193656162418Z | 4be5a6d* | b3=42 | main | B3 | 40 | 14.58 [12.89; 16.49] | 3.96 [0.33; 7.52] | 10.12 [8.94; 11.44] | 1.44 [-1.56; 4.33] |
| b2_pulsedb | 20261107T064556Z | a215f07 | xgboost=42 | full | B0 | 40 | 15.11 [13.47; 16.88] | 4.30 [0.79; 7.67] | 10.40 [9.12; 11.80] | 2.12 [-0.92; 5.14] |
| b2_pulsedb | 20261107T064556Z | a215f07 | xgboost=42 | full | B2a | 40 | 16.40 [14.26; 18.88] | 4.76 [0.36; 9.09] | 11.15 [9.61; 12.97] | 1.62 [-1.58; 4.98] |
| b2_pulsedb | 20261107T064556Z | a215f07 | xgboost=42 | full | B3 | 40 | 14.58 [12.89; 16.49] | 3.96 [0.33; 7.52] | 10.12 [8.94; 11.44] | 1.44 [-1.56; 4.33] |
| b2_pulsedb | 20261107T064556Z | a215f07 | xgboost=42 | hr_available | B0 | 40 | 15.10 [13.46; 16.87] | 4.29 [0.78; 7.66] | 10.40 [9.12; 11.79] | 2.11 [-0.93; 5.13] |
| b2_pulsedb | 20261107T064556Z | a215f07 | xgboost=42 | hr_available | B2a | 40 | 16.46 [14.35; 18.90] | 4.82 [0.41; 9.23] | 10.83 [9.26; 12.57] | 1.42 [-1.78; 4.78] |
| b2_pulsedb | 20261107T064556Z | a215f07 | xgboost=42 | hr_available | B2b | 40 | 16.51 [14.39; 18.73] | 4.54 [0.13; 8.77] | 10.82 [9.33; 12.67] | 1.53 [-1.63; 4.84] |
| b2_pulsedb | 20261107T064556Z | a215f07 | xgboost=42 | hr_available | B3 | 40 | 14.57 [12.87; 16.47] | 3.96 [0.33; 7.54] | 10.14 [8.97; 11.46] | 1.43 [-1.56; 4.33] |
| b3_multiseed | 20261107T062501Z/seed_42 | 1c708df | b3=42 | main | B0 | 40 | 15.11 [13.47; 16.88] | 4.30 [0.79; 7.67] | 10.40 [9.12; 11.80] | 2.12 [-0.92; 5.14] |
| b3_multiseed | 20261107T062501Z/seed_42 | 1c708df | b3=42 | main | B3 | 40 | 14.58 [12.89; 16.49] | 3.96 [0.33; 7.52] | 10.12 [8.94; 11.44] | 1.44 [-1.56; 4.33] |
| b3_multiseed | 20261107T062501Z/seed_43 | 1c708df | b3=43 | main | B0 | 40 | 15.11 [13.47; 16.88] | 4.30 [0.79; 7.67] | 10.40 [9.12; 11.80] | 2.12 [-0.92; 5.14] |
| b3_multiseed | 20261107T062501Z/seed_43 | 1c708df | b3=43 | main | B3 | 40 | 14.58 [12.89; 16.49] | 3.96 [0.33; 7.52] | 10.12 [8.94; 11.44] | 1.44 [-1.56; 4.33] |
| b3_multiseed | 20261107T062501Z/seed_44 | 1c708df | b3=44 | main | B0 | 40 | 15.11 [13.47; 16.88] | 4.30 [0.79; 7.67] | 10.40 [9.12; 11.80] | 2.12 [-0.92; 5.14] |
| b3_multiseed | 20261107T062501Z/seed_44 | 1c708df | b3=44 | main | B3 | 40 | 14.58 [12.89; 16.49] | 3.96 [0.33; 7.52] | 10.12 [8.94; 11.44] | 1.44 [-1.56; 4.33] |

Commit marked `*`: the workspace had uncommitted changes when the run started (code SHA-256 are in its report.json). Seeds: model seed per config section; the bootstrap seed and split are in runs.csv.

Summaries:

- `b3_multiseed/20261107T062501Z/report.json`: status DETERMINISTIC
