ndhuy1127/ppg-ecg-blood-pressure/hardware/kicad/v1_module/wrist/v1_wrist.kicad_pcb

## KiCad design hardware/kicad/v1_module/wrist/v1_wrist.kicad_pcb (2026-10-27)

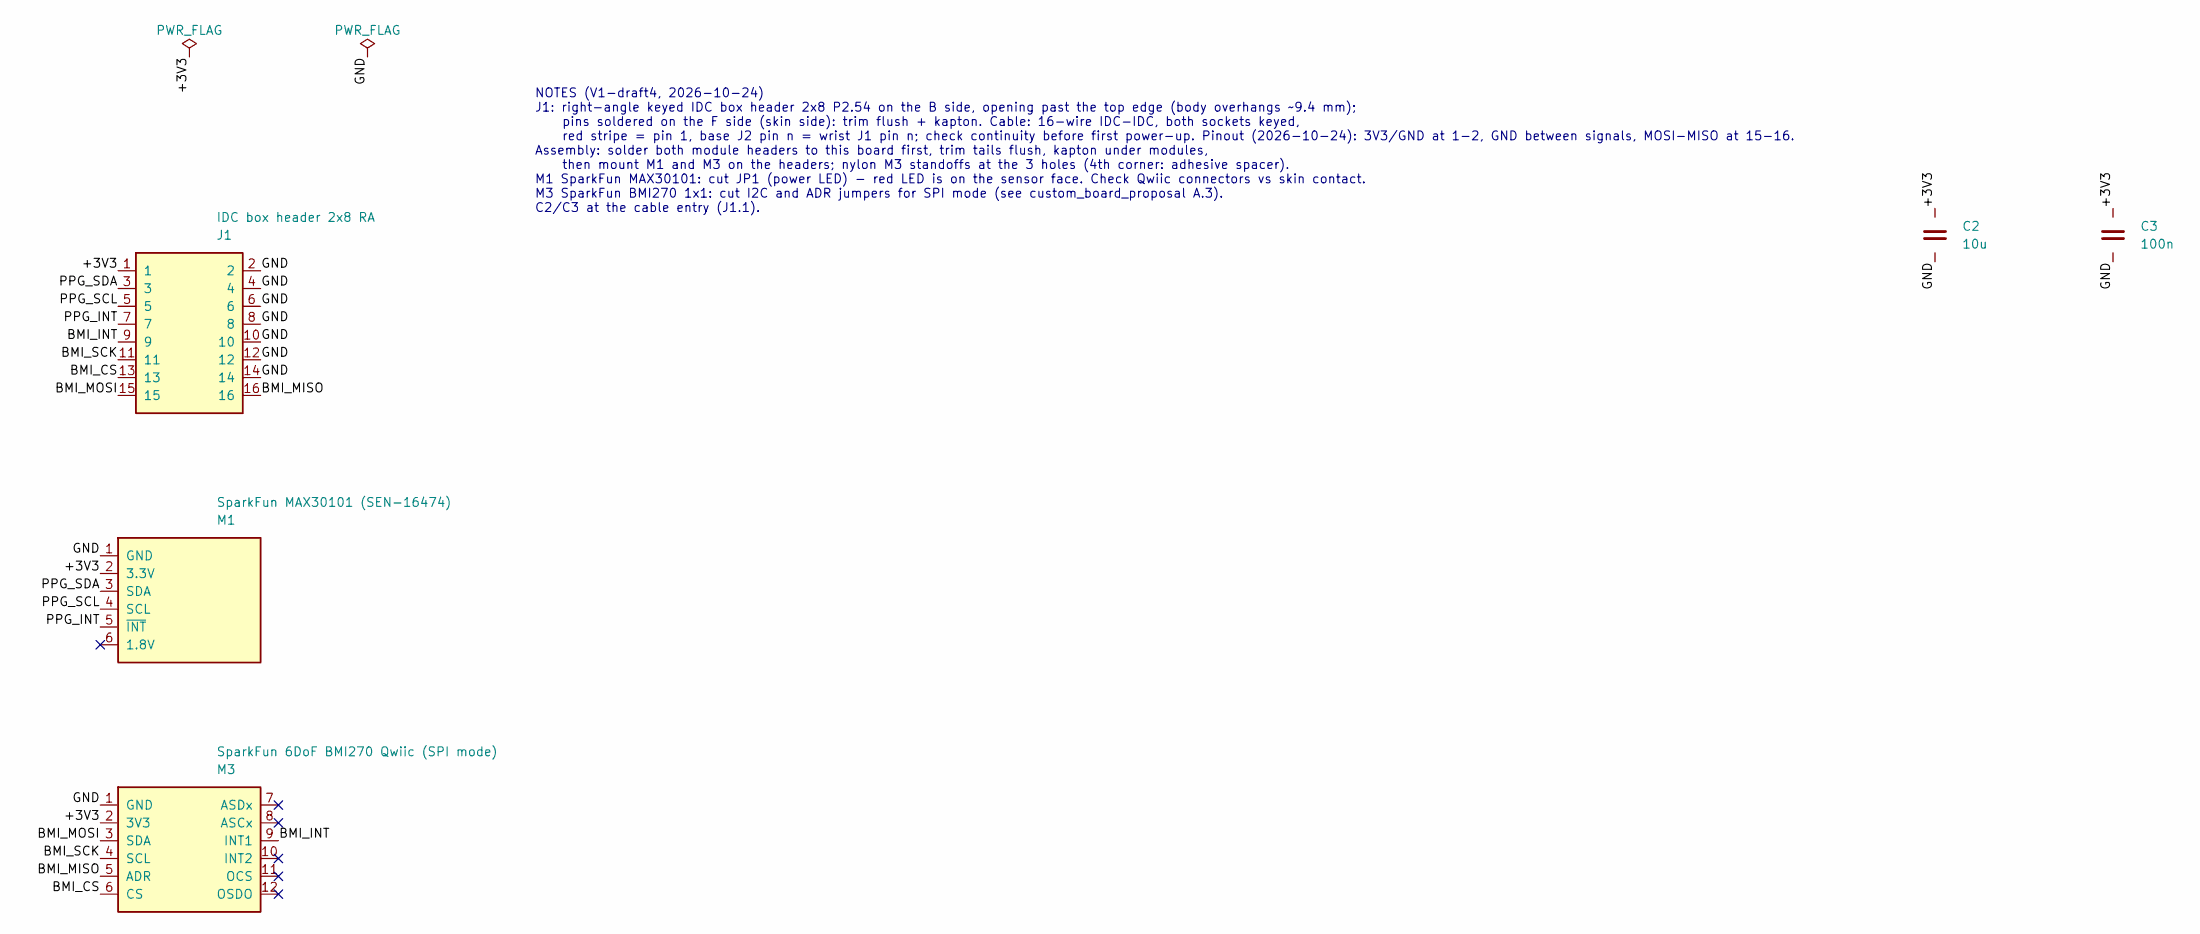
[picture p1: schematic v1_wrist.kicad_sch, V1 wrist sensor board]

Parts:
C2: 10u; C_0805_2012Metric
C3: 100n; C_0805_2012Metric
J1: IDC box header 2x8 RA; IDC-Header_2x08_P2.54mm_Horizontal
M1: SparkFun MAX30101 (SEN-16474); SparkFun_MAX30101_Qwiic_Socket
M3: SparkFun 6DoF BMI270 Qwiic (SPI mode); SparkFun_BMI270_Qwiic_Socket

Connections:
/+3V3: C2.1, C3.1, J1.1, M1.2 (3.3V), M3.2 (3V3)
/BMI_CS: J1.13, M3.6 (CS)
/BMI_INT: J1.9, M3.9 (INT1)
/BMI_MISO: J1.16, M3.5 (ADR)
/BMI_MOSI: J1.15, M3.3 (SDA)
/BMI_SCK: J1.11, M3.4 (SCL)
/GND: C2.2, C3.2, J1.2, J1.4, J1.6, J1.8, J1.10, J1.12, J1.14, M1.1 (GND), M3.1 (GND)
/PPG_INT: J1.7, M1.5 (INT)
/PPG_SCL: J1.5, M1.4 (SCL)
/PPG_SDA: J1.3, M1.3 (SDA)

Notes on the sheet:
NOTES (V1-draft4, 2026-10-24) J1: right-angle keyed IDC box header 2x8 P2.54 on the B side, opening past the top edge (body overhangs ~9.4 mm); pins soldered on the F side (skin side): trim flush + kapton. Cable: 16-wire IDC-IDC, both sockets keyed, red stripe = pin 1, base J2 pin n = wrist J1 pin 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

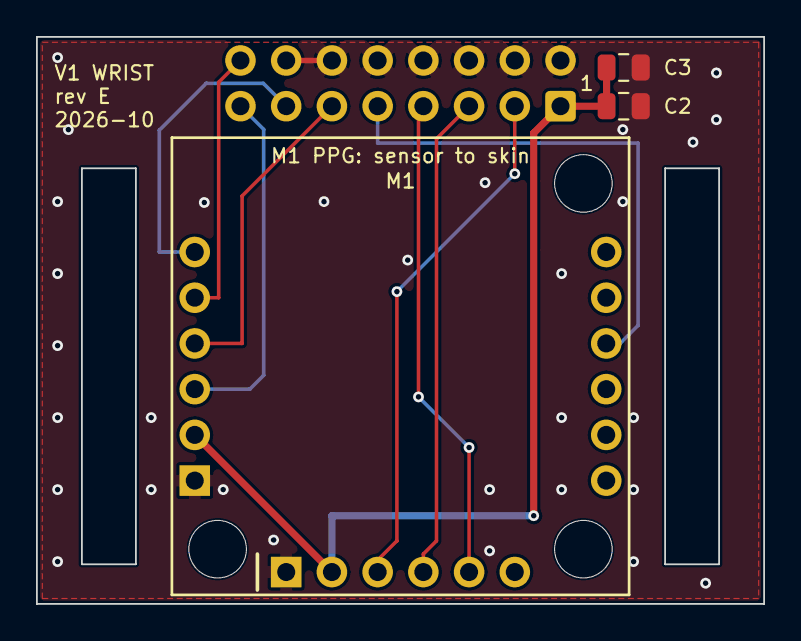
[picture p2: board v1_wrist.kicad_pcb from above]

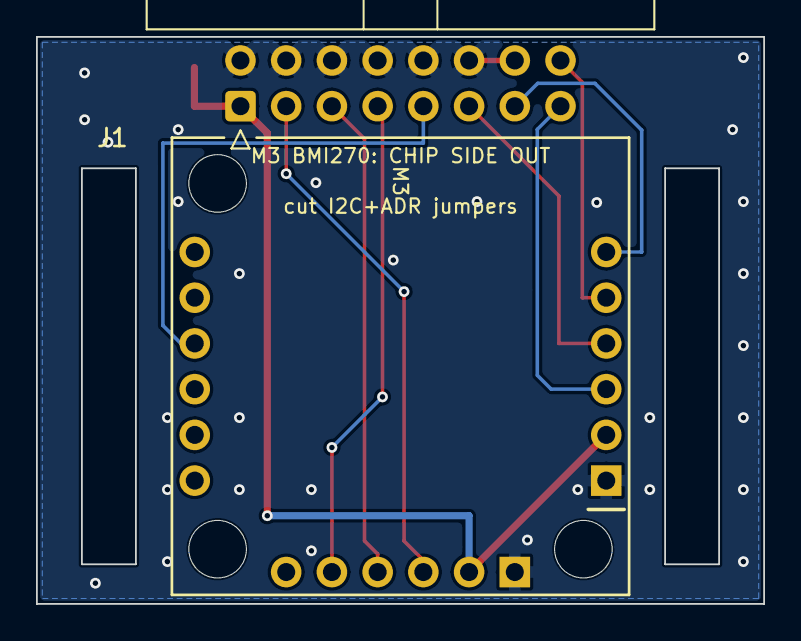
[picture p3: board v1_wrist.kicad_pcb from below]

Board: 2 copper layers, 40.4 x 31.5 mm, 5 parts (2 on the bottom side), 10 nets.
