ndhuy1127/ppg-ecg-blood-pressure/hardware/kicad/v1_module/base/v1_base.kicad_pcb

## KiCad design hardware/kicad/v1_module/base/v1_base.kicad_pcb (2026-10-27)

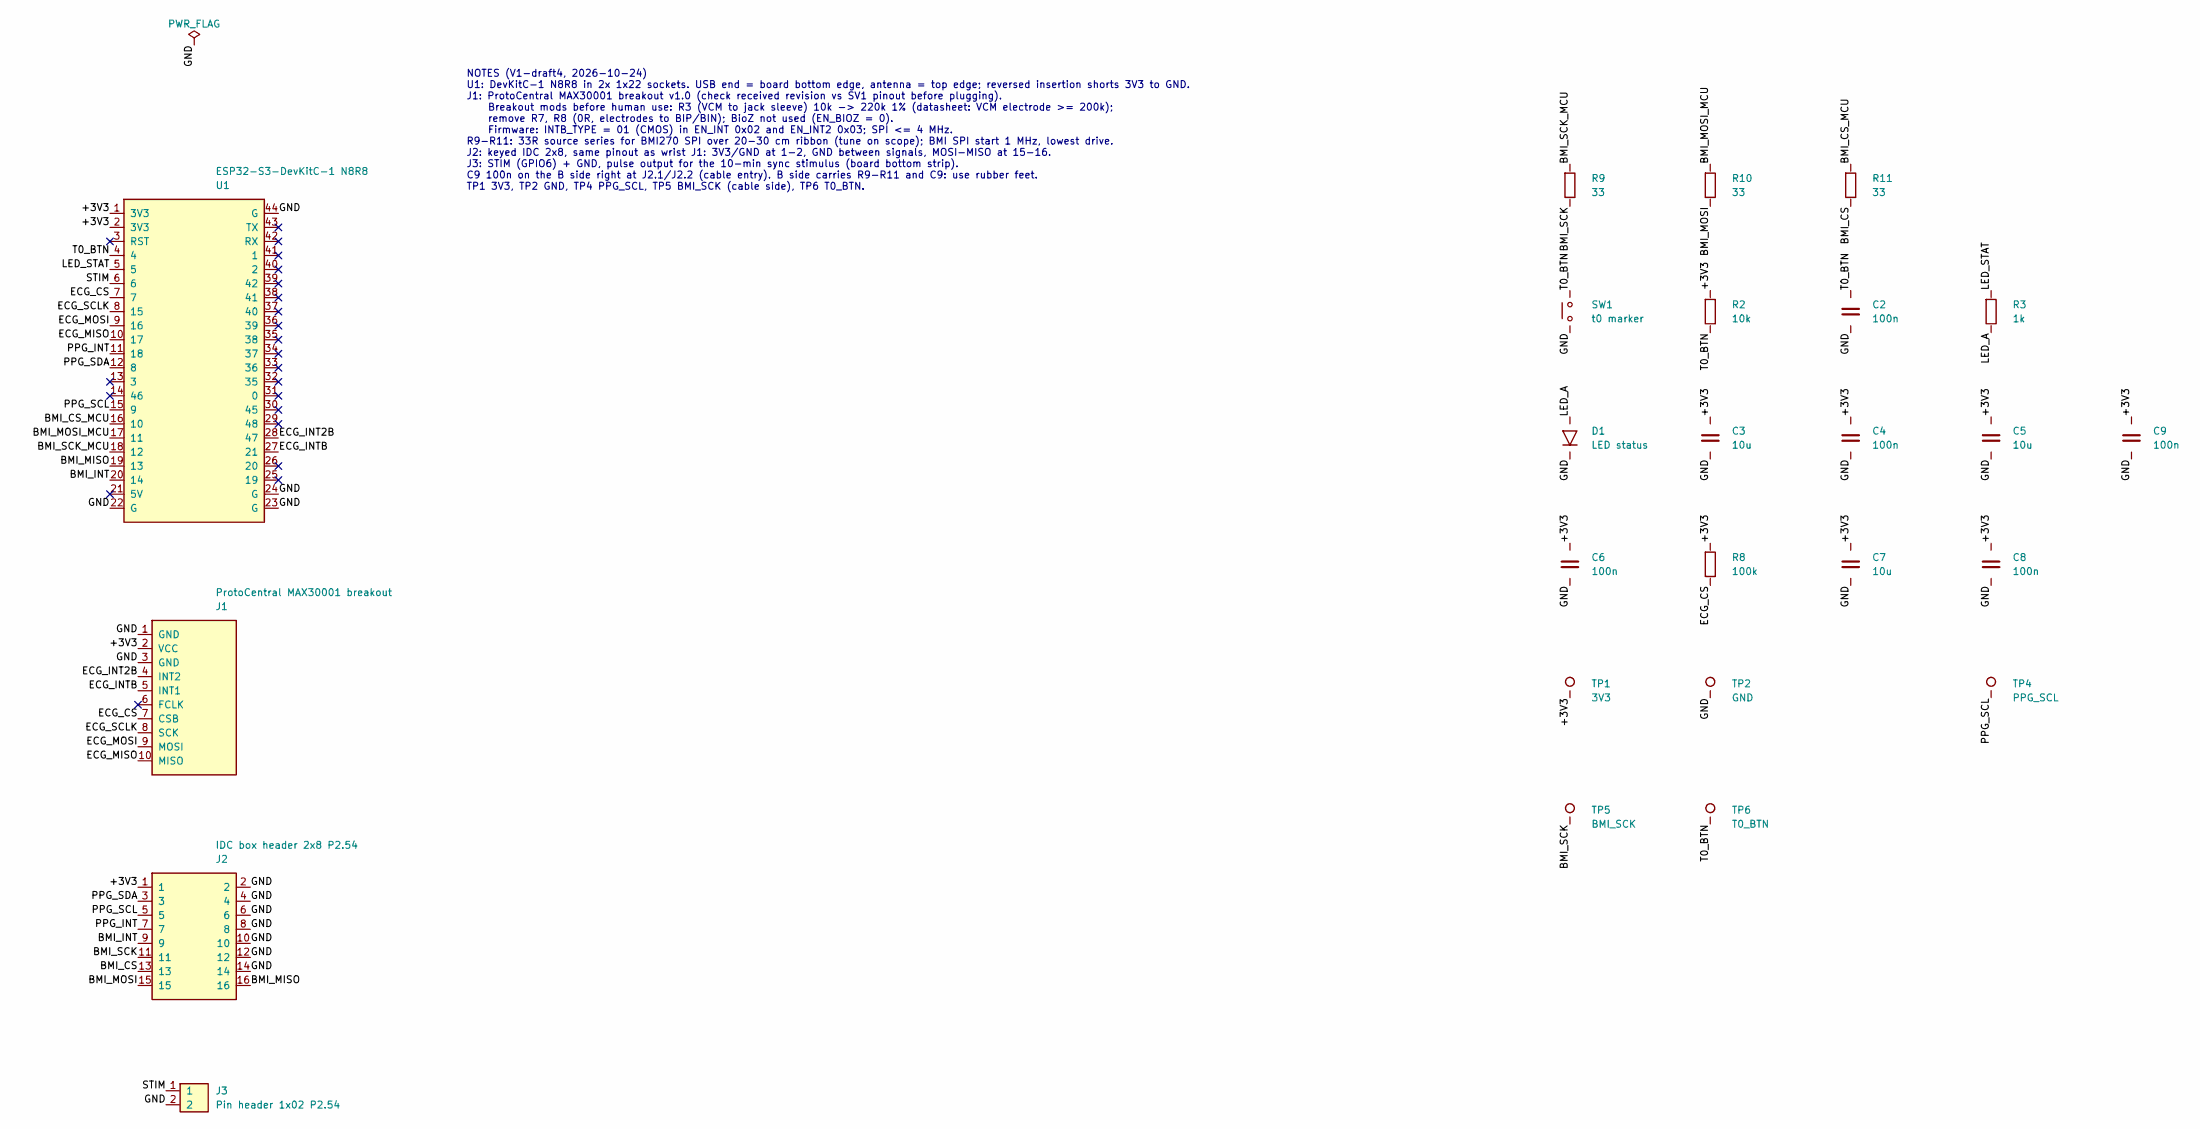
[picture p4: schematic v1_base.kicad_sch, V1 base board (Waveshare ESP32-S3 + MAX30001)]

Parts:
C2, C4, C6, C8, C9: 100n; C_0805_2012Metric
C3, C5, C7: 10u; C_0805_2012Metric
D1: LED status; LED_D3.0mm
J1: ProtoCentral MAX30001 breakout; ProtoCentral_MAX30001_BRK_Socket
J2: IDC box header 2x8 P2.54; IDC-Header_2x08_P2.54mm_Vertical
J3: Pin header 1x02 P2.54; PinHeader_1x02_P2.54mm_Vertical
R2: 10k; R_0805_2012Metric
R3: 1k; R_0805_2012Metric
R8: 100k; R_0805_2012Metric
R9, R10, R11: 33; R_0805_2012Metric
SW1: t0 marker; SW_PUSH_6mm
TP1: 3V3; TestPoint_Pad_D1.0mm
TP2: GND; TestPoint_Pad_D1.0mm
TP4: PPG_SCL; TestPoint_Pad_D1.0mm
TP5: BMI_SCK; TestPoint_Pad_D1.0mm
TP6: T0_BTN; TestPoint_Pad_D1.0mm
U1: ESP32-S3-DevKitC-1 N8R8; ESP32-S3-DevKitC-1_Socket

Connections:
/+3V3: C3.1, C4.1, C5.1, C6.1, C7.1, C8.1, C9.1, J1.2 (VCC), J2.1, R2.1, R8.1, TP1.1, U1.1 (3V3), U1.2 (3V3)
/BMI_CS: J2.13, R11.2
/BMI_CS_MCU: R11.1, U1.16 (10)
/BMI_INT: J2.9, U1.20 (14)
/BMI_MISO: J2.16, U1.19 (13)
/BMI_MOSI: J2.15, R10.2
/BMI_MOSI_MCU: R10.1, U1.17 (11)
/BMI_SCK: J2.11, R9.2, TP5.1
/BMI_SCK_MCU: R9.1, U1.18 (12)
/ECG_CS: J1.7 (CSB), R8.2, U1.7
/ECG_INT2B: J1.4 (INT2), U1.28 (47)
/ECG_INTB: J1.5 (INT1), U1.27 (21)
/ECG_MISO: J1.10 (MISO), U1.10 (17)
/ECG_MOSI: J1.9 (MOSI), U1.9 (16)
/ECG_SCLK: J1.8 (SCK), U1.8 (15)
/GND: C2.2, C3.2, C4.2, C5.2, C6.2, C7.2, C8.2, C9.2, D1.1 (K), J1.1 (GND), J1.3 (GND), J2.2, J2.4, J2.6, J2.8, J2.10, J2.12, J2.14, J3.2, SW1.2, TP2.1, U1.22 (G), U1.23 (G), U1.24 (G), U1.44 (G)
/LED_A: D1.2 (A), R3.2
/LED_STAT: R3.1, U1.5
/PPG_INT: J2.7, U1.11 (18)
/PPG_SCL: J2.5, TP4.1, U1.15 (9)
/PPG_SDA: J2.3, U1.12 (8)
/STIM: J3.1, U1.6
/T0_BTN: C2.1, R2.2, SW1.1, TP6.1, U1.4

Notes on the sheet:
NOTES (V1-draft4, 2026-10-24) U1: DevKitC-1 N8R8 in 2x 1x22 sockets. USB end = board bottom edge, antenna = top edge; reversed insertion shorts 3V3 to GND. J1: ProtoCentral MAX30001 breakout v1.0 (check received revision vs SV1 pinout before plugging). Breakout mods before human use: R3 (VCM to jac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

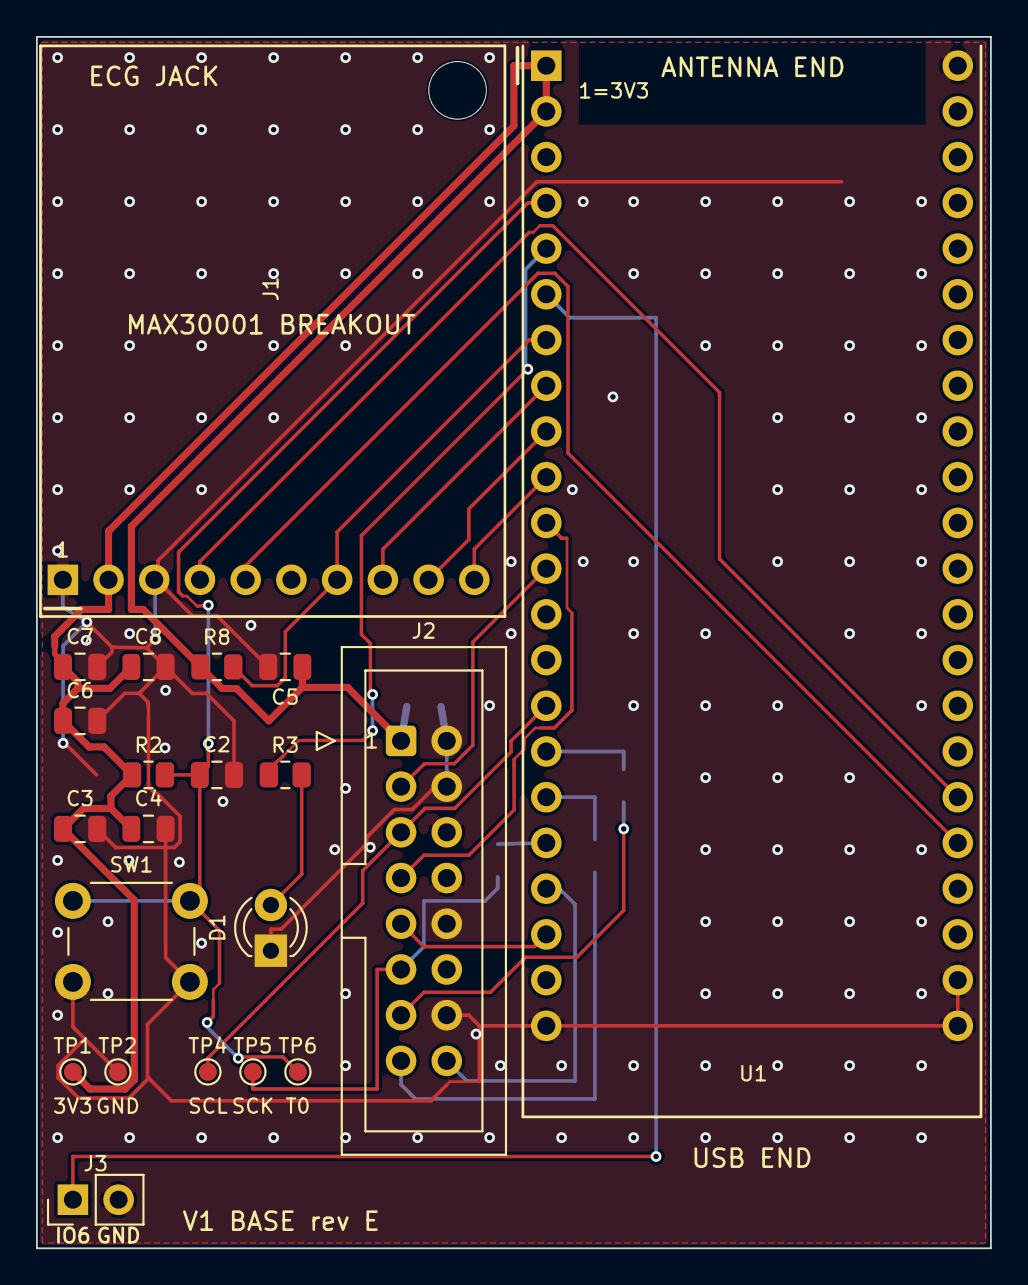
[picture p5: board v1_base.kicad_pcb from above]

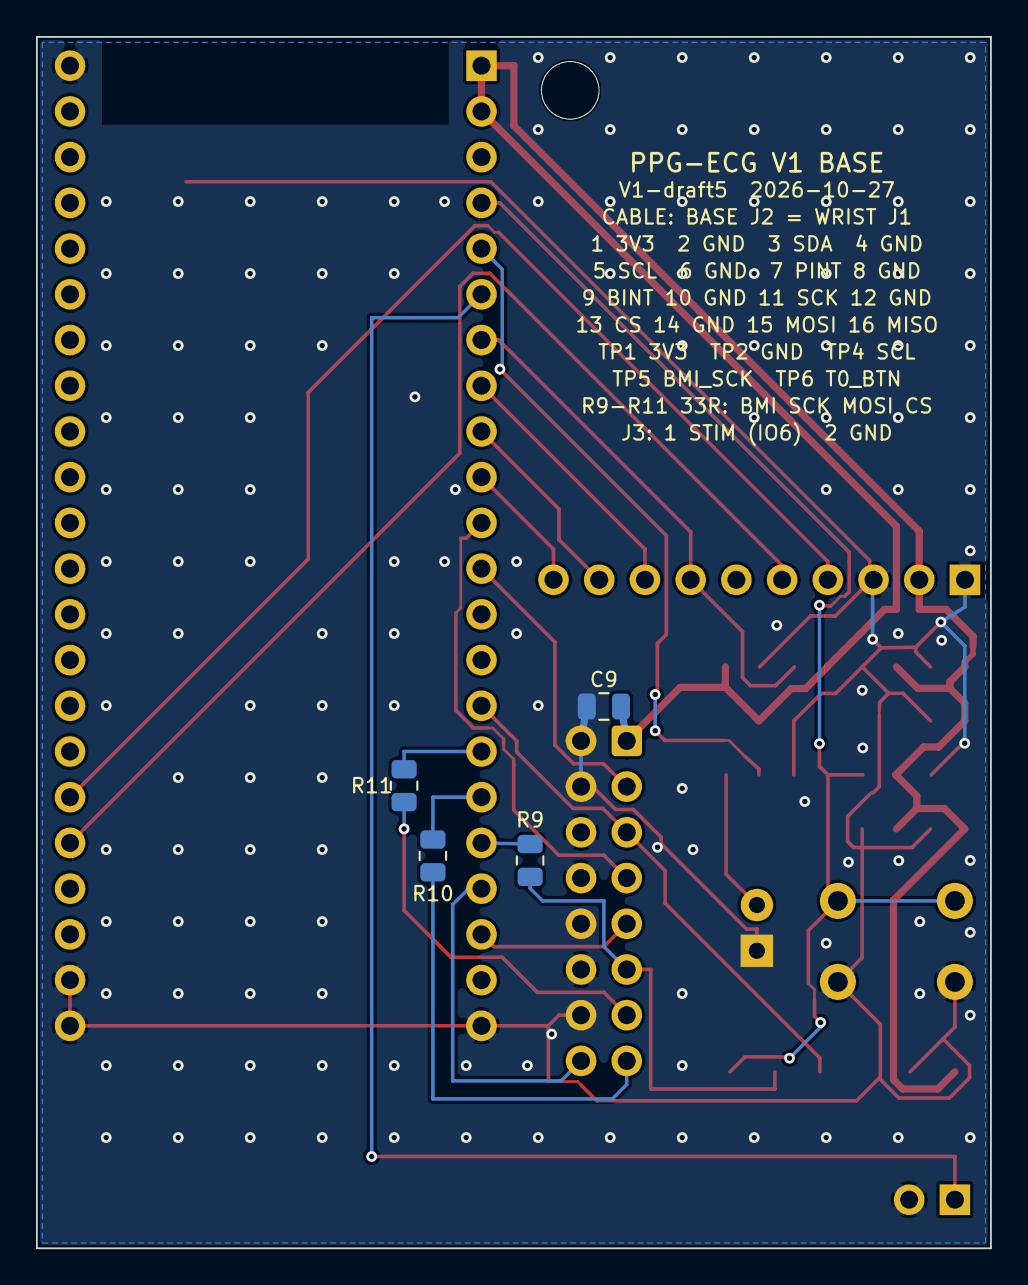
[picture p6: board v1_base.kicad_pcb from below]

Board: 2 copper layers, 53.0 x 67.3 mm, 25 parts (4 on the bottom side), 23 nets.
