ndhuy1127/ppg-ecg-blood-pressure/firmware/include/bmi270_config.h

/*
 * The BMI270 configuration file (microcode) from Bosch Sensortec
 * BMI270_SensorAPI, BSD-3-Clause; see drivers/bmi270_config.c.
 */
#pragma once

#include <stdint.h>

#include "bmi270.h"

extern const uint8_t bmi270_config_file[BMI270_CONFIG_SIZE];
