ndhuy1127/ppg-ecg-blood-pressure/(commit log)

2026-09-19 chore: chuẩn hóa CI và quy trình làm việc nhóm (#3)
    * ci: cap nhat workflow an toan va hien hanh
    Chay CI tren main/develop va pull request; bo sung chay thu cong, concurrency, timeout, pip check va Actions v7.
    * Revise workflow documentation with new guidelines
    Giai thich thuat ngu, quy trinh hang ngay, pull request, review, CI, merge, conflict va an toan du lieu cho thanh vien moi.
    * Create .gitattributes for line ending normalization
    Them .gitattributes de giam loi xuong dong khi lam viec giua Windows, macOS va Linux.
    * Update README with CI badge and workflow instructions
    Hien thi trang thai CI va dat lien ket huong dan GitHub o dau README de thanh vien moi de tim.
2026-09-21 docs: cap nhat trang thai kiem chung tuan 1
    Lam ro day la rapid review, sua lien ket cuc bo va ghi ro kiem tra Python 3.13 chi la ket qua local, CI Python 3.11 con cho PR.
2026-09-21 Sửa data sai (#5)
    * docs: hoan thien cong viec tuan 1 cua Huy
    * docs: sua so lieu va pham vi tong quan tuan 1
    Hieu chinh cac so lieu theo nguon goc, ha muc khang dinh tong quan va danh dau cac chi tiet Shen 2024 can audit toan van.
    * docs: dieu chinh gia thuyet va tieu chi thong ke
    Bo cac nguong MAE va ty le tu choi chua co can cu; chuyen sang effect size, CI theo nguoi va risk-coverage duoc khoa tren validation set.
    * docs: sua protocol ghep nhan va bo tri thiet bi
    Khoa bo tri tay, doi cua so vang thanh cua so ung vien, them phan tich do nhay theo do tre nhan cuff va sua cong thuc PAT.
    * docs: cap nhat trang thai kiem chung tuan 1
    Lam ro day la rapid review, sua lien ket cuc bo va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
2026-09-22 Sửa lỗi hiển thị
2026-09-22 docs: sửa render công thức trên GitHub
2026-09-22 Sửa lỗi kí tự (#6)
    Lam ro day la rapid review, sua lien ket cuc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
2026-09-22 docs: them BOM V0.1
2026-09-24 docs: Nhiem vu tuan 1 (#7)
    * docs: them BOM V0.1
    * docs: them file hardware_requirements_for_V0.md
    * docs: Them file hardware_diagram.svg
    * docs : Them file Hai_phuong_an_dien_cuc_ECG.docx
    * fix: Sua lai hardware diagram
    * fix: Sua lai file hardware_requirements_for_v0.md
    * fix: Sua lai file hardware_requirements_for_v0.md
    * fix: Sua lai file Phuong an hai dien cuc
2026-09-24 docs: đồng bộ literature matrix và tiêu chí tuổi protocol (#10)
    * docs: cap nhat trang thai kiem chung tuan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
2026-09-27 docs : Sua lai BOM V0.1 (#11)
2026-10-19 feat: tich hop B3, reader PulseDB va tai lieu phan cung V1 (#23)
    * fix: lam chat reader va validator PulseDB
    * feat: them B0/B3 XGBoost tren split PulseDB v2
    * docs: cap nhat provenance va quy uoc du lieu PulseDB
    * docs: them tai lieu phan cung va thiet ke KiCad V1
    * docs: bo dong trang thai va yeu cau review
2026-10-20 fix: lam chat pipeline tuan 4 va them ke hoach tuan 5 (#24)
    * feat: hash provenance khong phu thuoc CRLF
    * fix: khong tinh nhip sat bien la PAT khong ghep (features-sqi-v1)
    * fix: lam chat split, reader va dau vao dac trung
    * fix: runner B3 kiem tra day du ban giao split
    * chore: kiem tra moi truong theo pin, CI va gitignore
    * docs: cap nhat tai lieu phan cung theo thiet ke KiCad
    * docs: dong bo README, protocol va quy uoc voi code hien ta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
2026-10-26 feat: tuan 5 phan cung V1, firmware khung va chot schema packet V0.1 (#25)
    * docs: dong bo README, protocol va quy uoc v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
2026-10-27 feat: KiCad V1-draft5 theo bo Waveshare, doi chieu footprint va luu y lap rap
    - U1 theo bo Waveshare ESP32-S3-DEV-KIT-N8R8 63,3 x 25,4 mm; breakout ECG doi 0,5 mm; 3V3 hinh sao; silkscreen CHIP SIDE OUT
    - Danh sach mua: bo Waveshare da dat, khe khoa J1 co tay, nut 6x6, vit va spacer nylon M2
    - Bring-up: huong han header breakout, cuc LED, kiem J1 truoc khi han, do thong mach xuyen ca he truoc khi cap nguon
    - So sanh dien cuc ECG chuyen tu PDF sang Markdown
2026-10-29 feat: lenh MARK_EVENT, logger v3 co metadata nghien cuu va env all_real
    - MARK_EVENT (CMD_ID 0x03) phat su kien ma 2 CUFF_END va ma 4 tu PC; spec V0.2 muc 13, firmware, logger, device_command mark
    - PC chan ma LED > 0x7F, cho SET_PPG_LED 2,5 s va ghi late_ack
    - packet-logger-v3, metadata phien v1 (subject_id, session_id, ppg_led_lock, cuff_log); du lieu nguoi chi ghi vao data/raw/<subject>/<session>/
    - env esp32s3_devkitc_all_real, chan co build sai trong board header
    - quy uoc cong offset khe PPG (V0.1 muc 7), sua tai lieu theo bo Waveshare
2026-10-29 fix: chi dung train khi chon moc tay tuan 5
    - agreement tu choi val khi moc la MANUAL; gate tu choi dong khong thuoc train; export phai la split train
    - tai lieu tuan 5: che do ghep R-foot rieng cho PulseDB, B4_NOT_ALLOWED la ket luan cuoi, quy tac click nhip sat bien, giu do lap lai 100%
    - config week05_huy.json giu nguyen tung byte
2026-10-29 docs: chot thiet ke nghien cuu va ho so dao duc (protocol v0.3)
    - endpoint RQ1, truc thoi gian M2-M4, LOSO long, P2/R3 dung median, so phien va tran tuyen 25
    - quy trinh chinh LED, bam t0 truoc khi bam cuff, phan tich chinh khong loc SQI
    - ho so dao duc: rut lui, nguong BP, do dong ro, tieu chi chon/loai, luu tru, ma SUB
    - dang ky truoc cach cham test split va CalFree; rao chan RQ2; WEEK_06 cap nhat
2026-10-29 docs: dong bo tai lieu phan cung, PulseDB va trang thai tuan 6
    - power budget, interface, yeu cau phan cung, proposal, so do theo bo Waveshare; luat chon do rong xung viet truoc
    - DRC chay lai tren 9a10274; datasheets README; danh sach mua theo don da dat
    - bring-up: buoc K5 o G2, do nhieu den, do dong ro, do module khi nhan hang
    - tai lieu split/B0/provenance theo trang thai da chot; README, CHANGELOG, bao cao tuan 5
2026-10-30 docs: them de xuat sua protocol va ho so dao duc cho buoi gap thay Tuan 7
2026-10-30 docs: ra soat cuoi ho so dao duc, them de cuong nop hoi dong va bieu mau
2026-11-07 docs: sua loi tai lieu sau review tuan 6
    - an toan buoi do: tach ba nhanh cap cuu (khong ep tim khi con tho binh thuong), chuyen kham khi BP >= 180/110
    - quyen xoa sau moc khoa va tran tieu huy 05 nam thong nhat giua phieu thong tin, de cuong va DMP
    - nguoi dat chuan khong tinh phien led_readjusted; kich ban dung CI sau hieu chinh
    - N6: chi hai mo hinh dung PAT, mo hinh thu ba la tre giua hai song PPG (doi chieu PDF)
    - Koba 2004, luu y so doc tu hinh S4
    - bring-up chay ca he 120 phut; danh sach mua: Huy bao da dat du ngay 2026-11-07
2026-11-07 feat: B2 v1 dung nhan khau hoc cua tung doan
    - B2 v0 chay tren val ngay 2026-11-07 va dung o chot kiem nhan khau hoc truoc khi fit; khong co so nao
    - chan doan chi tren train: 4/320 nguoi co hai bo gia tri (tuoi <= 1 nam, can nang <= 2,1 kg)
    - v1: moi doan dung gia tri cua chinh no, report ghi demographics_variation; config v1 PENDING
    - run_b3_multiseed khong con loi in bang tren console cp1252
2026-11-07 docs: ke hoach tuan 7
    - B5, logger theo review, don hang va Gerber, chuan bi bring-up, SQI v1 va SAP v1, gap thay
